propann/L-AZ-2/README.md

<div align="center">

AZ-2 — groovebox, tracker et Game Boy musicale

# AZ-2 · Build a song. Play a world.

**🌐 Documentation : [Français](docs/i18n/README.fr.md) · [English](docs/i18n/README.en.md) · [Español](docs/i18n/README.es.md)**

**Une groovebox DIY à deux cerveaux : tracker 8 pistes, six moteurs audio et Game Boy / Game Boy Color intégrée.**






[Découvrir la machine](#la-machine) · [Manuel d'utilisation](docs/AZ2_MANUEL_UTILISATEUR.md) · [Démarrer](#démarrer) · [Architecture](#deux-firmwares-un-seul-instrument) · [Game Boy & LSDJ](#game-boy--lsdj) · [Feuille de route](#feuille-de-route) · [Documentation](#documentation)

</div>

> **AZ-2 est un projet de construction et de recherche, pas un produit fini.** Les fonctions listées comme intégrées existent dans le code ; leur validation sur le matériel réel dépend des essais documentés. Les captures d'écran et visuels de concept ne sont pas des preuves de fonctionnalité.

## La machine

| 🎛️ Créer | 🎮 Jouer | 🎚️ Transformer |
| :-- | :-- | :-- |
| Tracker 8 pistes, patterns, song, swing, effets par pas, mute/solo | Émulation GB/GBC sur écran tactile avec croix et boutons physiques | Mixage via Teensy et DAC I²S, capture WAV du son du jeu, sampleur one-shot |
| Dexed FM · ePiano · Braids · Karplus · Analog · Sampler | Navigateur de ROM sur carte SD, sauvegarde cartouche | Six moteurs audio au choix par piste |

**Intention produit :** composer au tracker, jouer à la Game Boy et faire dialoguer le son chiptune avec les synthétiseurs de la machine. La capture WAV est présente et le dernier enregistrement Game Boy peut désormais être chargé en PSRAM comme patch dynamique **SAMPLER / GB Capture** ; la gestion d'une vraie bibliothèque multi-captures reste à développer.

## Deux firmwares, un seul instrument

```text
      CROIX / A B C D / ENCODEURS
                    │
                    ▼
   ┌──────────────────────────────┐       UART 921600       ┌──────────────────────────────┐
   │ TEENSY 4.1 · MASTER AUDIO    │◄──────────────────────►│ ESP32-S3 · ÉCRAN / GB       │
   │ Tracker, synthés, mixage     │   commandes + audio GB │ Écran tactile 480×480, SD    │
   │ Sampleur, MIDI, DAC I²S      │                        │ ROM GB/GBC, interface       │
   └───────────────┬──────────────┘                        └──────────────────────────────┘
                   ▼
             PCM5102A → AUDIO OUT
```

**Règle fondamentale : les deux firmwares sont liés par `lib/AZ2_Protocol/AZ2_Protocol.h`.** Modifier une commande, un débit, une longueur de paquet ou un format audio exige de vérifier les deux extrémités dans le même changement. Ne flashez pas un seul firmware après une modification incompatible du protocole.

L'AZ-2 actuelle conserve deux cartes, sans multiplexeur ni rack multi-ESP. Les cartouches de moteurs et modules supplémentaires sont réservés au projet AZ-3.

## Démarrer

**Prérequis :** matériel décrit dans le [guide de câblage](docs/AZ2_CABLAGE_MASTER.md), carte ESP32-S3 écran VIEWE UEDX48480040E-WB, Teensy 4.1, DAC PCM5102A, cartes SD adaptées, [Python](https://www.python.org/) et [PlatformIO](https://platformio.org/install).

```bash
git clone https://github.com/propann/L-AZ-2.git
cd L-AZ-2
python -m pip install platformio==6.1.19

# Compiler impérativement les DEUX firmwares avant de flasher :
pio run -e master_teensy -e screen_esp

# Tests natifs du protocole partagé :
pio test -e native

# Téléverser seulement lorsque le matériel/câblage a été vérifié :
pio run -e master_teensy -t upload
pio run -e screen_esp -t upload
```

Le matériel Teensy et l'écran ESP32 disposent de configurations de compilation distinctes dans `platformio.ini`. `ui_esp` est un environnement de bring-up historique, **pas** le firmware de l'écran final. Les ROM commerciales, les banques de samples et les sauvegardes personnelles ne sont pas incluses dans ce dépôt.

**Avant le premier flash :** lire le [guide d'installation et de sécurité](docs/AZ2_DEMARRAGE.md). Préserver vos fichiers `.sav`, projets et patches SD ; éviter une mise à jour partielle des deux firmwares.

## Game Boy & LSDJ

| Fonction | État |
| :-- | :-- |
| Cœur Walnut-CGB, chargement ROM depuis SD, commandes physiques | Intégré ; compatibilité à qualifier ROM par ROM |
| Rendu sans frame-skip par défaut, dual-fetch, télémétrie FPS/temps/missed | Intégré ; cadence réelle à relever sur la machine |
| Audio V2 séquencé + CRC + L/R PCM8 stéréo | Intégré derrière un pilote désactivé ; sortie Teensy encore downmixée sur le bus mono actuel |
| Sauvegarde SRAM périodique, SAVE NOW sur D, `.sav/.bak` et RTC MBC3 séparé | Intégré ; qualification coupure/RTC sur matériel encore nécessaire |
| Audio GB vers Teensy | Intégré, actuellement **mono 8 bits / 14 kHz** |
| Audio haute fidélité, APU horodatée et sortie DAC réellement stéréo | **Non livré** ; le transport V2 stéréo est présent mais désactivé par défaut |
| Capture GB → patch SAMPLER / GB Capture | **Intégré** (un slot dynamique PSRAM) ; qualification matérielle et bibliothèque multi-captures restantes |
| Synchronisation musicale LSDJ ↔ tracker | **Non livré** |

Pour le chantier en cours : [roadmap Game Boy / LSDJ détaillée](docs/AZ2_GB_ROADMAP_IMPLEMENTATION.md). Pour les limites de compatibilité : [audit émulation](docs/AZ2_AUDIT_EMULATION_LSDJ_TETRIS_MARIO.md). Pour comprendre pourquoi Walnut-CGB a été retenu : [étude des cœurs](docs/AZ2_ETUDE_COEURS_EMULATION_GB.md).

## Feuille de route

1. **Fiabilité :** sauvegardes résistantes aux coupures, erreurs visibles, chargement sûr et tests sur carte réelle.
2. **Cadence :** mesures et certification par ROM (Tetris, Mario, LSDJ) et sans sacrifice des synthés.
3. **Audio LSDJ :** APU précise, stéréo, pont UART V2 et contrôle des underruns.
4. **Studio :** ergonomie Console/LSDJ, capture WAV → sampleur, synchronisation musicale.
5. **Publication :** photos du prototype réel, schéma reproductible, démonstrations et matrice de compatibilité.

Les cases d'implémentation et les tests d'acceptation figurent dans la [roadmap opérationnelle](docs/AZ2_GB_ROADMAP_IMPLEMENTATION.md). Ne pas confondre « présent dans le code », « compile » et « testé sur l'AZ-2 ».

## Documentation

| Commencer par… | Pour… |
| :-- | :-- |
| [Guide en français](docs/i18n/README.fr.md) · [English guide](docs/i18n/README.en.md) · [Guía en español](docs/i18n/README.es.md) | Découvrir le projet, compiler les deux firmwares, comprendre les fonctions livrées et leurs limites |
| [Manuel d'utilisation](docs/AZ2_MANUEL_UTILISATEUR.md) | Jouer avec la machine : pages, contrôles, sauvegarde, premier beat |
| [Premier démarrage](docs/AZ2_DEMARRAGE.md) | Préparer les deux cartes, les SD et les compilations |
| [Architecture double firmware](docs/AZ2_ARCHITECTURE_FIRMWARE_DOUBLE.md) | Comprendre les responsabilités de chaque cerveau |
| [Câblage maître](docs/AZ2_CABLAGE_MASTER.md) | Relier commandes, Teensy, écran et DAC |
| [État des lieux](docs/AZ2_ETAT_DES_LIEUX.md) | Séparer observations matérielles et code théorique |
| [Travail livré / journal trilingue](docs/i18n/README.fr.md#travail-réalisé-et-traçabilité--19-septembre-2026) | RTC MBC3, transport V2 stéréo, capture → sampleur et preuve CI |
| [Audit racks / transition CONSOLE + CAPTURE](docs/AZ2_AUDIT_RACKS_CONSOLE_CAPTURE.md) | Mesurer les gains possibles, prioriser jeu + WAV et transitionner par étapes vérifiées |
| [Roadmap Game Boy](docs/AZ2_GB_ROADMAP_IMPLEMENTATION.md) | Suivre les étapes de stabilisation et LSDJ |
| [Validation GB/LSDJ](docs/AZ2_GB_VALIDATION.md) | Tester cadence, sauvegardes, jeux et capture sur le prototype |
| [Roadmap générale](docs/AZ2_FEUILLE_DE_ROUTE.md) | Tracker, moteurs, interface et produit |
| [Licences et composants tiers](docs/AZ2_LICENCES.md) | Vérifier provenance et obligations avant redistribution |

## Contribuer

Voir [CONTRIBUTING.md](CONTRIBUTING.md). Un bug reproductible, une capture de logs, un test de ROM libre ou une amélioration de documentation sont utiles. Indiquez le SHA Git, l'environnement `master_teensy` / `screen_esp`, le matériel et les étapes de reproduction. Évitez d'ajouter au dépôt des ROM commerciales ou des fichiers de sauvegarde personnels.

Code principal sous **GPL-3.0** ; plusieurs composants intégrés possèdent leurs propres licences. Voir [LICENSE](LICENSE) et [inventaire des licences](docs/AZ2_LICENCES.md).

---

<div align="center"><sub>AZ-2 — Fabriquer un instrument, pas seulement assembler des composants.</sub></div>
