propann/L-AZ-2/docs/AZ2_FEUILLE_DE_ROUTE_MOTEUR.md

# AZ-2 - Feuille de route moteur audio / mixeur / architecture (2026-09-13)

Contexte: pas de carte SD ni de sample reel dans les machines pour
l'instant -- priorite mise sur les VOIX synthetiques (plusieurs moteurs
connus et legers) plutot que sur le sampleur, qui attendra du vrai
stockage. Rappel utile a garder en tete: **les 3 firmwares (ESP32, Teensy,
Pico) forment UNE seule application** repartie sur 3 cartes -- une
decision cote protocole ou architecture engage generalement les 3, meme
quand une carte n'est pas branchee au moment ou on code.

**[Note 2026-09-17]** Le Pico a ete abandonne le 2026-09-14 (matrice/
mux LED jamais fonctionnels) -- l'application est desormais sur 2
cartes, pas 3. Une carte SD DEDIEE existe maintenant sur le Teensy
(sampler, capture phase 1 faite le 2026-09-17) -- le contexte "pas de
SD ni de sample" ci-dessus ne s'applique plus. Les moteurs
synthetiques listes plus bas restent la base actuelle (5 moteurs,
inchanges depuis).

## Moteurs retenus (deja vendored, verifies dans le repo)

Tous dans `src_teensy/microdexed-touch/third-party/` :

| Moteur | Lib | Style | API de declenchement |
| --- | --- | --- | --- |
| Dexed (FM, DX7-like) | `Synth_Dexed` | Note tenue, tres flexible (algorithmes FM) | `keydown(note, vel)` / `keyup(note)` |
| MDA ePiano | `Synth_MDA_EPiano` | Note tenue, timbre electro-piano celebre (heritage VST mda-epiano) | `noteOn(note, vel)` / `noteOff(note)` |
| Braids (Mutable Instruments) | `Synth_Braids` | Oscillateur "macro" continu, pas de note tenue -- on le "frappe" (`Strike()` interne) a chaque nouvelle hauteur, tres celebre en modulaire/eurorack, leger CPU | `set_braids_pitch(pitch)` (frappe a chaque appel) + `set_braids_shape()`/`timbre()`/`color()` pour la forme d'onde |

Ces trois couvrent des styles tres differents (FM riche, piano electrique,
oscillateur synthese complexe/percussif) pour un minimum de code -- bon
rapport diversite sonore / effort.

## Architecture cible

```mermaid
flowchart LR
    T0[Piste 0: Dexed] --> MIX[Mixeur pistes]
    T1[Piste 1: Dexed] --> MIX
    T2[Piste 2: EPiano] --> MIX
    T3[Piste 3: Braids] --> MIX
    LIVE[Voix live: Dexed] --> FINAL[Mixeur final]
    MIX --> FINAL
    FINAL --> DAC[PCM5102A]
```

Decision v0 (simple, pas de switch dynamique de moteur pour l'instant) :
**un moteur fixe par piste**, pas un choix dynamique par l'utilisateur --
ca viendra dans une v1 une fois l'architecture de base solide et testee.

| Piste | Moteur | Role |
| --- | --- | --- |
| 0 | Dexed | FM riche, basses/leads |
| 1 | Dexed | FM riche, deuxieme voix |
| 2 | EPiano | Timbre electro-piano |
| 3 | Braids | Percussif/texture, oscillateur complexe |
| Live (pads/ecran) | Dexed | Jeu au clavier, independant des pistes |

Braids n'a pas de "note off" naturel (oscillateur continu) : on coupe son
canal du mixeur pour simuler un relachement -- character plus percussif/
abrupt, coherent avec son usage typique.

## Ce qui reste a batir (dans l'ordre)

1. **[FAIT]** Multi-moteur fixe par piste (tableau ci-dessus), mixeur a
   2 etages (pistes -> final), toujours pilotable par `PAD:`/`STEP:`/`PLAY`/
   `STOP` existants.
2. **[FAIT]** Grille de sequenceur a l'ecran ESP32 (tactile, 4 pistes x 16
   pas), curseur de lecture synchronise sur `CLOCK:`.
2bis. **[FAIT, 2026-09-14]** "Vrai" sequenceur temps reel, suite a la
   demande explicite ("on est pas assez precis ... il faut les divisions
   le tempo") :
   - Horloge du sequenceur sur `IntervalTimer` materiel (comme
     `PeriodicTimer` dans MicroDexed-touch) au lieu d'un `millis()` scrute
     dans `loop()` -- teste reellement a 180 BPM : 83,33ms attendus, 83,1-
     83,8ms mesures (jitter residuel du cote mesure serie/Python, pas du
     timer). Plus de "temps mort" du a ce que fait `loop()` par ailleurs.
   - Scan clavier du Pico separe en 2 passes (boutons d'abord, LED
     ensuite) -- un appui n'est plus jamais retarde par le rafraichissement
     LED d'une colonne precedente (voir `src_pico/main.cpp`).
   - Division du pas reglable (`DIV:`, table `az2::kDivisionOptions` dans
     AZ2_Protocol.h : 1/4, 1/8, 1/8T, 1/16 par defaut, 1/16T, 1/32) et
     tempo (`BPM:`) exposes sur la page SEQUENCEUR de l'ecran (boutons
     -/+ et bascule de division), plus reglables en aveugle via serie
     seulement.
2ter. **[FAIT, 2026-09-14]** Choix de moteur PAR piste + patchs reels,
   suite a la demande explicite ("les moteurs audio ne sont pas
   selectionnables ni reglables ... sans patch ca va pas, faut faire un
   truc propre") -- avance depuis l'etape 5 initialement prevue plus tard :
   - Chaque piste a ses instances de moteur (a l'origine
     Dexed/EPiano/Braids, **5 moteurs depuis le 2026-09-15**, voir plus
     bas) toujours creees, une seule branchee au mixeur a la fois via
     `AudioConnection::connect()`/`disconnect()` (API officielle de patch
     runtime de la lib Audio) -- un moteur non selectionne ne consomme
     AUCUN CPU (la lib ne fait tourner `update()` que sur les objets
     "actifs", voir commentaire dans `src_teensy/az2_audio/main.cpp`).
   - Patchs reels par moteur (pas juste un `loadInitVoice()` vide) :
     8 voix DX7 nommees extraites de la banque vendored Synth_Dexed
     (FM-Rhodes, Steinway, Korg CX3, Leadharp, FatSynth A, Jupiter 8,
     Mini-Moog, Moog Strings), 5 programmes mda ePiano (Default, Bright,
     Mellow, Autopan, Tremolo), 8 formes Braids (CSAW, Saw/Square, Triple
     Saw, Toy, Vosim, FM, Plucked, Saw Swarm).
   - **[FAIT, 2026-09-15]** 2 moteurs de plus, suite a "on voit si on
     peut ajouter des moteurs audio si oui lesquels" : **KARPLUS**
     (`AudioSynthKarplusStrong`, corde pincee physique, 1 seul patch --
     l'objet n'expose aucun parametre de forme) et **ANALOG**
     (`AudioSynthWaveform` + `AudioEffectEnvelope` chaines en
     permanence, patch = forme d'onde : Sinus/Dent de scie/Carre/
     Triangle). Les deux sont des objets STANDARD de la lib Audio
     Teensy, zero vendoring supplementaire. CPU mesure apres ajout :
     toujours ~8% de pic (voir "performance reelle" plus bas), tres
     large marge pour en ajouter encore si besoin.
   - Protocole `ENGINE:piste:moteur` / `PATCH:piste:patch`, table de noms
     partagee ESP32/Teensy/Pico dans AZ2_Protocol.h (`kEngineNames`,
     `k*PatchNames`, `enginePatchCount()`/`enginePatchName()`) -- l'index
     doit rester aligne avec les tableaux de donnees reelles cote Teensy.
   - Nouvelle page ecran "MOTEURS" (une ligne par piste, toucher la
     moitie gauche = cycle moteur, moitie droite = cycle patch).
   - `announceHello()` renvoie tout l'etat courant (bpm, division, moteur+
     patch par piste) a chaque connexion/reconnexion ESP32/Pico, pour que
     l'ecran ne reaffiche jamais des valeurs par defaut fausses.
3. Intro plus vivante (glitch, pixel-art anime) + esprit "logiciel vivant"
   sur les autres pages.
4. Mixeur "vrai" : niveau + pan par piste, exposes au protocole
   (`MIXER:track=N:vol=X` par exemple) et a une page ecran dediee.
5. Edition de note par pas (chaque pas du sequenceur a sa propre note, pas
   une seule note fixe par piste comme actuellement) -- necessaire pour
   de vraies melodies/basslines, pas juste des accords tenus.
6. Sampleur reel, une fois une carte SD presente sur le Teensy (voir
   AZ2_PORTAGE_MICRODEXED_TOUCH.md) -- PSRAM deja confirmee (16 Mo,
   lecture/ecriture OK, teste le 2026-09-13), donc le stockage temporaire
   de samples est pret techniquement des que des fichiers audio existent.
7. Mode JEUX -- **implemente le 2026-09-15** (voir
   [AZ2_EMULATION_JEUX.md](AZ2_EMULATION_JEUX.md) pour le detail : coeur
   vendore, callbacks/rendu/entrees ecrits, compile et flashe sans
   crash -- pas encore joue en reel faute de ROM legale sur une carte
   SD). Decision revue le 2026-09-14 (voir
   [AZ2_EMULATION_JEUX.md](AZ2_EMULATION_JEUX.md)) : Retro-Go (vendored
   dans `src_esp32/retro-go-master`) etudie et ECARTE pour la v0, car
   ESP-IDF natif + ecrans SPI seulement -- incompatible avec notre
   ecran RGB parallele sans double demarrage OTA + pilote ecran a
   ecrire. Cible precisee dans la foulee ("GB/GBA/GBC, ca suffira") :
   moteur retenu **Walnut-CGB** (GB + GBC, callbacks purs style
   Peanut-GB, licence MIT, deja demontre sur ESP32-S3) comme une PAGE de
   plus dans `az2_screen`, pas un double demarrage -- `lcd_draw_line()`
   branche directement sur notre Arduino_GFX. GBA ecarte du v0 (~20fps
   mesures sur ESP32-S3, pas fluide). ROM testable depuis la flash
   interne au debut (pas besoin de carte SD pour un premier essai), la
   carte SD reste utile ensuite pour une vraie ludotheque (etape
   suivante).
8. SD sur l'ESP32 (ecran) : ROMs de jeux (format a definir), utile pour
   le mode JEUX (etape 7) une fois la carte presente.
9. ~~Pico transforme en joystick/manette~~ -- **obsolete, Pico abandonne
   le 2026-09-15** (voir AZ2_CABLAGE_PICO.md). Remplace : la croix + 4
   boutons cables directement sur le Teensy (etape "control" ci-dessous)
   servent deja a la fois de navigation et de manette de jeu, voir
   [AZ2_TODO_PICO.md](AZ2_TODO_PICO.md) (page de cloture).
10. Croix + 4 boutons + 3 potentiometres cables directement sur le
    Teensy (`NAV:`/`BTN:`/`POT:`, voir AZ2_CABLAGE_MASTER.md) --
    remplace le Pico. Potards 1-3 deja branches sur le bus d'effets
    maitre (volume/reverb/delay), firmware pret, cablage physique en
    cours.

## Impact protocole (a suivre au fur et a mesure)

`DIV:`, `ENGINE:track:moteur` et `PATCH:track:patch` ajoutes le
2026-09-14 (voir etapes 2bis/2ter ci-dessus) -- `BPM:` desormais relaye
(avant : accepte mais jamais confirme a l'UI). Prevoir plus tard :
`MIXER:`, et des messages lies au mode jeux (a definir quand on y
arrivera).
