propann/L-AZ-2/docs/AZ2_ETAT_DES_LIEUX.md

# AZ-2 - Etat des lieux

**[2026-09-19 -- bibliotheque de samples rangee sur la SD du Teensy +
pads jouent l'instrument de la piste + kit de batterie de depart sur
les pads + sauvegarde des pads dans le projet -- teste sur le vrai
materiel]**

Grosse suite de demandes enchainees le meme soir, une fois la carte SD
du Teensy branchee sur l'ordinateur avec la carte SD de l'ESP32 :

- **Bibliotheque de samples rangee** : demande "on met des dossiers
  cool ... on garde les ensembles de percussion snare kick tout ca les
  basses les voix les synths on met de cote les boucles". Collection
  "Azothwave KO II" (2 archives Google Drive, 2,3 Go) deja parfaitement
  organisee EXACTEMENT selon la demande (BASS/CYMBALS/KICKS/LOOPS/PERC/
  SFX/SNARES/SYNTHS/VOIX) -- extraite et fusionnee dans `/samples` sur
  la SD du Teensy (14 819 fichiers, 2,5 Go). Le pack "OP-1" propose en
  parallele s'est revele etre autre chose (plus de la moitie de ses
  2857 fichiers = un environnement Python zippe par erreur, plus un
  dossier FIRMWARE = des firmwares du device OP-1, pas des samples) et
  organise par GENRE musical plutot que par instrument -- laisse de
  cote sur decision utilisateur explicite ("les son op1 on s'en occupe
  pas").
- **"joue l'instrument de la piste"** : les pads (page AUDIO) jouaient
  jusqu'ici TOUJOURS une voix Dexed fixe separee (`liveVoice`), meme
  ouverts depuis le bouton CLAVIER du tracker. Nouveau champ optionnel
  `track=` sur la commande `PAD:` -- quand present, le Teensy route
  vers `trackNoteOn()/trackNoteOff()` (le VRAI moteur/patch de la
  piste, meme chemin que le sequenceur) au lieu de `liveVoice`. Le
  bouton CLAVIER du tracker fixe desormais `padTargetTrack =
  selectedSeqTrack` avant d'ouvrir la page ; AUDIO ouverte depuis le
  menu general repart sur le comportement generique (`padTargetTrack =
  -1`, corrige au passage une petite fuite d'etat preexistante ou
  `padEditsStep` restait colle d'une visite CLAVIER precedente). Poser
  une note en mode "pose sur le pas" (padEditsStep) fait maintenant
  AUSSI entendre le son en direct (avant : totalement silencieux, on
  n'entendait jamais ce qu'on venait de programmer).
- **Kit de batterie configure sur les pads** : nouveau sampleur DEDIE
  aux 16 pads, INDEPENDANT des 6 moteurs normaux -- 16x
  `AudioPlaySampler` + 16 buffers PSRAM plafonnes a 2s/48kHz (~3 Mo,
  verifie sur les 16 Mo de PSRAM reellement detectes, `PSRAM?` sur le
  vrai materiel). Mixage a etages (4 groupes de 4 pads -> 1 bus pads ->
  combine avec liveVoice -> mixFinal canal 2, qui etait deja plein a
  4/4) -- meme principe que les groupes de pistes. Nouvelle commande
  `PADSAMPLE:<pad 0-15>:<chemin>`, priorite absolue sur un pad
  (ignore track=/liveVoice si un echantillon y est charge -- un hit de
  kit ne se transpose pas). 8 sons choisis dans la bibliotheque
  fraichement rangee (kick/snare/hat ferme/hat ouvert/clap/rim/
  cowbell/ride), charges automatiquement au boot du Teensy.
- **2 bugs reels trouves et corriges en testant** :
  1. Parseur WAV a en-tete fixe (44 octets, ecrit pour les captures GB
     "propres") -- la bibliotheque Azothwave, exportee via ffmpeg/
     libav, insere un chunk LIST/INFO entre "fmt " et "data" : tous
     les fichiers etaient rejetes en `WAV_UNSUPPORTED` alors que
     parfaitement valides. Corrige en parcourant les chunks RIFF un
     par un (fmt/data dans n'importe quel ordre, chunks inconnus
     sautes) au lieu de supposer un en-tete fixe -- partage desormais
     entre la capture GB et les samples de pad (`readWavPcm16Mono()`).
  2. `loadDefaultDrumKit()` (le kit de depart) place AVANT
     `setupSampleSd()` dans `setup()` -- la carte SD du Teensy n'etait
     pas encore initialisee, chaque `SD.exists()` echouait
     silencieusement, aucun pad ne chargeait rien au boot. Deplace
     apres `setupSampleSd()`.
  3. (evite avant de flasher, pas un bug materiel) : `setSample()`
     appele sans le sampleRate REEL du fichier (24kHz pour toute la
     bibliotheque Azothwave, pas les 44.1kHz par defaut) -- aurait
     fait jouer chaque hit ~1.84x trop vite/trop aigu.
- **"pouvoir aussi les sauvegarder dans le projet global"** : nouvel
  etat ESP32 `padSamplePath[16]`, tenu a jour par l'echo
  `PADSAMPLE:<pad>:READY:path=...` (capture aussi bien une assignation
  manuelle que le kit de depart charge au boot du Teensy) --
  `saveProject()`/`loadProject()` ecrivent/relisent une ligne
  `PADSAMPLE:<pad>:<chemin>` par pad assigne. Verifie le mecanisme
  bout en bout (Teensy -> echo -> ESP32) via serie direct ; le
  declenchement tactile SAUVER/CHARGER lui-meme (page PROJET, pas de
  chemin croix equivalent) reste a confirmer au doigt.

Compile propre (`screen_esp`, `master_teensy`, `native`), 14 tests
natifs au vert. Valide sur le vrai materiel : kit de depart charge au
boot (8x `PADSAMPLE:...READY`), CPU/memoire stables en jouant les 8
pads d'affilee (5.9%->6.6%, pic 8.6%, blocs memoire inchanges).

**[2026-09-19 -- nouveau manuel d'utilisation (docs/AZ2_MANUEL_UTILISATEUR.md)]**

Demande : "il faut travailler sur la doc plus complete on a pas grand
chose". Etat des lieux avant d'ecrire quoi que ce soit : plus de 30
fichiers dans `docs/`, mais TOUS orientes ingenierie (audits, cablage,
roadmap, licences) ou journal brut de session (`AZ2_ETAT_DES_LIEUX.md`,
100+ Ko) -- AUCUN document explique comment UTILISER la machine une
fois construite. Meme `AZ2_DEMARRAGE.md` ("Premier demarrage") est en
realite une procedure de flash/dev (git clone, pio, checklist de
securite), pas un guide utilisateur.

Nouveau `docs/AZ2_MANUEL_UTILISATEUR.md` -- guide "comment jouer avec
la machine", langage musicien plutot qu'informatique (coherent avec
"c'est plus musicien" plus haut ce soir) : conventions de controle
generales (C=retour, tap=selectionne, A+croix=edite), les 3 encodeurs
(0=volume fixe, 1/2=contextuels avec leur code couleur), chaque page
en detail (SEQUENCEUR/MOTEURS/PATCH/MIXER/SONG/AUDIO/JEUX/annexes),
tableau des 6 moteurs et leurs patchs, sauvegarde patch-vs-projet, et
un parcours pas-a-pas "premier beat". Ajoute au README (lien en tete
de la doc-table ET dans la barre de navigation du haut) -- premiere
chose qu'un utilisateur (pas un contributeur) devrait lire.

**[2026-09-19 -- fusion avec le travail GB (autre session IA) + boutons
MUTE/SOLO tactiles sur MIXER + audit navigation "retour" (rien trouve
de casse)]**

- **Fusion `origin/main`** : une autre session IA travaillait en
  parallele sur l'emulation Game Boy (confirme par l'utilisateur : "il
  y a gpt qui bosse sur la partie emulation") -- 56 commits pousses
  directement sur `main` pendant que ce chantier tournait, touchant
  entre autres `lib/AZ2_Protocol/AZ2_Protocol.h` (+174 lignes, nouveau
  protocole audio GB V2) ET les 2 memes `main.cpp` (Teensy/ESP32) que
  ce chantier modifiait activement. Fusionne sur la branche de
  fonctionnalite (`git merge origin/main`, pas de conflit textuel) puis
  RE-VERIFIE integralement avant de faire confiance au resultat :
  compile propre sur les 3 environnements, 14 tests natifs au vert (9
  d'avant + 5 nouveaux tests GB audio V2), et re-teste sur le vrai
  materiel (MIXER, mute/solo, encodeurs) apres reflashage des 2
  cartes -- rien de casse par la fusion.
- **"il faut que les 2 controles soit[ent] boutons tactil[es]"**
  (mute/solo de la page MIXER, jusqu'ici seulement B/D physiques) :
  2 boutons tactiles ajoutes sous les barres. Logique factorisee dans
  `toggleMixerMuteSolo(bool mute)`, appelee aussi bien par B/D que par
  ces 2 nouveaux boutons -- plus de duplication entre les 2 chemins.
- **"verifie toute les navigations qu'on saute pas des fenetres dans
  les retours"** : audit complet du systeme `navPrevious`/`goTo()`.
  `currentScreen` n'est JAMAIS assigne ailleurs que dans `goTo()` (un
  seul point de mutation, verifie par recherche exhaustive) --
  `navPrevious` est donc toujours mis a jour avant tout changement
  d'ecran, aucun chemin ne peut le contourner. Verifie aussi qu'aucun
  gestionnaire n'appelle `goTo()` deux fois de suite dans le meme
  evenement (ce qui aurait enregistre un ecran "intermediaire" jamais
  vraiment vu comme `navPrevious`, faisant sauter une etape au retour)
  -- tous les appels a `goTo()` vivent dans des branches if/else-if
  mutuellement exclusives. **Rien trouve de casse** : le seul bug de
  cette famille cette soiree etait le mute MIXER sur le bouton A (deja
  trouve+corrige, voir l'entree precedente) -- categorie differente
  (un gestionnaire qui reagit a tort a l'evenement qui vient de faire
  `goTo()` VERS son propre ecran), pas un saut de fenetre au retour.

Compile propre (`screen_esp`, `master_teensy`, `native`), 14 tests
natifs au vert. Valide sur le vrai materiel via SIMNAV:/SIMBTN: apres
la fusion.

**[2026-09-19 -- page MIXER (nouvelle) + encodeurs 1/2 CONTEXTUELS +
pistes affichees 1-8 + bouton SAUVER dans le tracker -- teste sur le
vrai materiel]**

Suite de plusieurs retours enchaines le meme soir :

- **"le mixeur doit gerer le volume de toutes les voix"** : nouvelle
  page MIXER (`Screen::Mixer`, ajoutee au menu categorie Musique) -- 8
  barres verticales façon table de mixage, une par piste, hauteur
  proportionnelle a `trackVolume[]`. GAUCHE/DROITE choisit la piste,
  HAUT/BAS regle DIRECTEMENT son volume (pas besoin de maintenir A --
  metaphore fader). B = mute, D = solo (indicateur M/S sous la barre
  selectionnee). Reutilise entierement l'etat deja partage
  (`trackVolume[]`/`trackMuted[]`/`trackSoloed[]`), aucun nouveau
  protocole cote Teensy.
- **"on va [aux encodeurs 1/2] attribuer une couleur et les inclure a
  chaque fois dans l'application ... on les utilise pas assez"** :
  jusqu'ici l'encodeur 1 pilotait TOUJOURS le reverb wet global et
  l'encodeur 2 le delay wet global, cote Teensy, sans aucune
  conscience de l'ecran affiche. Bascule : l'encodeur 0 (VOLUME) reste
  CABLE DIRECT (role fixe, "le volume il bouge pas"), les encodeurs
  1/2 n'appliquent plus rien eux-memes cote Teensy -- ils envoient
  juste leur `POT:` brut (0-127, position ABSOLUE accumulee, pas un
  delta), et c'est desormais l'ESP32 qui decide quoi en faire selon
  `currentScreen` (et l'etat local de la page, ex. `selectedPatchRow`)
  puis renvoie la commande correspondante (VOL:/FILT:/FX:/...).
  Indicateur visuel ajoute (`drawEncoderHint()`) : 2 couleurs FIXES
  (orange = encodeur 1, cyan = encodeur 2) affichees en haut a droite
  de l'en-tete avec un libelle qui change selon la page/le parametre
  au focus -- "--" grise quand l'encodeur n'a rien a faire sur l'ecran
  courant. Cable pour l'instant sur 2 pages : MIXER (encodeur 1 =
  piste, encodeur 2 = volume) et PATCH (encodeur 1 = valeur GAUCHE de
  la ligne visuelle selectionnee, encodeur 2 = valeur DROITE -- acces
  direct aux 2 reglages d'une meme ligne sans avoir a les
  selectionner un par un a la croix). Pas de "soft takeover" en v1
  (reaffecter un encodeur a un nouveau parametre peut faire "sauter"
  sa valeur au premier mouvement) -- simplicite assumee, comme pour
  les effets par piste plus haut.
- **Bug reel trouve+corrige en testant** : le mute de la page MIXER
  etait d'abord sur le bouton A -- exactement le bouton "confirmer" du
  menu qui vient de faire `goTo(Screen::Mixer)` DANS LE MEME appui
  (`currentScreen` change avant que le bloc mute/solo ne s'execute,
  plus bas dans la meme fonction) : entrer sur la page mettait
  aussitot la piste 0 en mute par accident. Deplace sur B (libre sur
  cette page). A noter pour la suite : cette classe de bug (un
  gestionnaire ecran-specifique qui reagit a tort a l'evenement qui
  vient de faire `goTo()` VERS cet ecran) peut exister ailleurs, pas
  audite systematiquement.
- **"les pistes c'est mieux de les numeroter de 1 a 8 ... plus
  musicien, la c'est trop informatique"** : tous les affichages de
  numero de piste (page PATCH/MOTEURS/SEQUENCEUR/MIXER, indication
  AUDIO "pose sur piste X") montrent desormais piste+1 -- UNIQUEMENT a
  l'affichage, le protocole/les tableaux internes restent 0-7 comme
  avant (aucun risque de casser un fichier projet/patch existant).
- **"dans le tracker il manque le bouton sauvegarder"** : 6e bouton du
  panneau lateral du tracker, "SAUVER" -- sauvegarde tout le morceau
  (`saveProject()`, meme fonction que la page PROJET) dans
  l'emplacement PROJET actuellement choisi, sans quitter le tracker.
  Pas teste (tactile uniquement, pas simulable comme la croix/les
  boutons -- meme fonction eprouvee que le bouton SAVE de la page
  PROJET, donc faible risque).
- **Nouvelle commande de test `SIMPOT:<0-2>:<0-127>`** (Teensy, meme
  esprit que SIMNAV:/SIMBTN:) -- injecte un `POT:` directement sur
  Serial1, seul moyen d'automatiser un test d'encodeur (aucun
  encodeur physique pilotable depuis un script).

Compile propre (`screen_esp`, `master_teensy`, `native`), 9 tests
natifs au vert. Valide sur le vrai materiel via SIMNAV:/SIMBTN:/
SIMPOT: : navigation MIXER, mute/solo (bug A/B trouve et corrige en
testant), encodeur 1 -> `POT:1:100` -> piste choisie, encodeur 2 ->
`POT:2:50` -> `VOL:6:50` envoye correctement pour la piste choisie
par l'encodeur 1 juste avant.

**[2026-09-19 -- effets DEDIES par piste (bitcrusher + delay courte) --
reverb/delay COMPLETEMENT independantes par piste abandonne (teste : ne
rentre pas en RAM), 12/16 pistes abandonne aussi (garde 8) -- teste sur
le vrai materiel, pire cas y compris]**

Demande initiale : "si sampleur actif et qu'on peut avoir une chaine
d'effet independante sur chaque piste" + "si on est bien cote puissance
de calcul on peut monter a 12 ou 16 piste". Verifie AVANT de coder quoi
que ce soit (methode de ce soir : mesurer, pas supposer) :

- **12/16 pistes + reverb/delay COMPLETEMENT dediees par piste : ne
  rentre PAS en memoire.** Teste directement sur le materiel : 12x
  `AudioEffectFreeverb` seul (chacun ~25 Ko de buffers fixes en RAM1/
  DTCM) depasse deja la RAM1 disponible (~81 Ko libres) des le link.
  12x `AudioEffectDelay` seul passe de justesse (81 Ko -> 14 Ko libres,
  bien trop juste pour etre fiable). Utilisateur, une fois ces chiffres
  presentes : "on garde 8 piste mais on blinde d'effet[s] propre[s]
  plus simple[s] ... c'etait juste une idee" -- 12/16 pistes abandonne,
  reste a 8 (`kTrackCount`/`kSeqTrackCount` inchanges).
- **2 effets simples et VRAIMENT dedies par piste a la place** (pas un
  bus partage) : bitcrusher (reduction de bits, cout memoire quasi nul)
  et delay courte a une seule repetition (pas de feedback, "plus
  simple"). Chaine : `trackFilter -> trackCrush -> {sec, trackDelay} ->
  trackFx (mixeur sec/mouille par piste) -> mixeur de groupe` (remplace
  l'ancienne connexion directe filtre -> groupe). Nouvelles commandes
  Teensy `CRUSH:<piste>:<bits 1-16>` et `DELAY:<piste>:<ms 0-500>:
  <mix 0-127>`. Reverb reste UNIQUEMENT sur le bus maitre partage
  (inchangee, trop chere en RAM pour etre dediee).
- **Bug reel trouve et corrige pendant les tests** : `AudioMemory(200)`
  (le pool de blocs partage par TOUS les `AudioEffectDelay`,
  proportionnellement au temps de delay configure) etait bien trop
  juste des l'ajout du delay par piste -- UNE SEULE piste a 300ms
  faisait deja grimper le pool a 197/200. Augmente a
  `AudioMemory(700)` (nouvelle constante nommee `kAudioMemoryBlocks`,
  ~175 Ko en RAM2 sur les ~454 Ko libres, large marge conservee) --
  re-teste au PIRE cas possible (8 pistes, delay 500ms + mix 127 +
  bitcrusher 4 bits SUR TOUTES, toutes en train de jouer en meme
  temps) : 694/700 blocs, CPU 8.9% (pic 10.4%) -- tient, marge fine
  mais reelle. Au passage : le tracer d'onde (SCOPE:) pointait sur
  `trackFilter[]` (avant les nouveaux effets) -- deplace sur `trackFx[]`
  pour montrer ce qui est reellement entendu. Petit bug cosmetique
  corrige aussi : `MEM?` affichait un `/200` fige au lieu de la vraie
  taille du pool (nouvelle constante `kAudioMemoryBlocks` utilisee aux
  deux endroits).
- **Pas encore fait** : aucune interface ecran pour CRUSH:/DELAY: (page
  PATCH) -- pour l'instant reglable seulement en serie direct, comme
  DXR/EXP/BXP l'etaient avant leur propre chantier UI.

Compile propre (`master_teensy`, `native`), 9 tests natifs au vert.

**[2026-09-19 -- page PATCH : A+GAUCHE/DROITE edite la valeur, en plus
de A+HAUT/BAS -- teste sur le vrai materiel]**

Demande immediate suite au chantier de navigation ci-dessous : "on
devrait pouvoir changer les valeurs avec droite gauche ... en
maintenant A et en pressant droite gauche pour changer les valeurs du
patch". La logique d'edition (VOLUME/SLOT/ligne fixe-ou-DXP/ligne
EXTRA) est sortie du gestionnaire de croix vers une fonction dediee
`patchApplyDelta(track, delta)`, appelee desormais aussi bien par A+
HAUT/BAS (HAUT=+1) que par A+GAUCHE/DROITE (DROITE=+1) -- simple choix
de confort, les 2 sens de croix marchent pour editer. La ligne SLOT
garde son cas particulier (A+GAUCHE/DROITE = SAVE/LOAD, verifie avant
le cas general). GAUCHE/DROITE SEUL (sans A) continue de juste
selectionner, inchange.

**Valide sur le vrai materiel** (SIMNAV:/SIMBTN:) : A+DROITE sur
CUTOFF envoie `FILT:0:127:0`, A+GAUCHE juste apres envoie
`FILT:0:126:0` (bien decremente) ; DROITE seul (sans A) juste apres ne
declenche aucune commande (selection seule, comme prevu).

**[2026-09-19 -- page PATCH : 2 reglages par ligne + navigation
repensee (GAUCHE/DROITE choisit le reglage, PISTE sur sa propre
ligne) -- teste sur le vrai materiel]**

Suite immediate du chantier "barre TEENSY retiree + bouton B" plus
haut (meme soiree) -- 2 retours utilisateur enchaines :

- **"mettre 2 reglage par ligne pour gagner de la place"** : tous les
  parametres "simples" de la page (CUTOFF/RESONANCE/ALGO-ou-ATTACK/
  FEEDBACK-ou-DECAY/SUSTAIN/RELEASE, les lignes EXTRA par moteur DXR/
  EXP/BXP, et desormais VOLUME aussi) partagent leur ligne 2 par 2
  (colonne gauche/droite) au lieu d'une ligne pleine largeur chacun.
  Seule la ligne SLOT (3 sous-boutons SLOT/SAVE/LOAD, deja dense)
  reste seule sur sa ligne. Plus de boutons tactiles +/- (pas la place
  en demi-largeur) -- l'edition passe entierement a la croix (A
  maintenu + HAUT/BAS, deja le reflexe utilise partout ailleurs ce
  soir), le tactile ne fait plus que SELECTIONNER une case.
- **Interrompu en cours de route par** : "la droite gauche change les
  piste il faut que ce change les reglage selectionner dans la fenetre
  des patch" -- GAUCHE/DROITE servait encore a changer de piste,
  incompatible avec "choisir entre les 2 reglages d'une ligne". Meme
  refonte que la page MOTEURS plus tot dans la soiree
  (`engOnTrackRow`) : nouvel etat `patchOnTrackRow`, ligne PISTE
  desormais separee (contour blanc quand elle a le focus croix) --
  GAUCHE/DROITE n'y change la piste QUE sur cette ligne, atteinte en
  montant (HAUT) depuis la toute premiere ligne de la grille. Dans la
  grille : GAUCHE/DROITE parcourt l'ordre logique des parametres
  (`patchStepLogical()`, saute les lignes DEXED 4-5 desactivees comme
  avant), HAUT/BAS monte/descend d'une ligne VISUELLE en gardant la
  colonne quand elle existe (`patchStepVisual()`). Ligne SLOT : A
  maintenu + GAUCHE/DROITE reste SAVE/LOAD, seule ligne ou GAUCHE/
  DROITE garde un role hors navigation.
- **Bug latent trouve en reprenant ce chantier (pas encore flashe,
  trouve a la lecture)** : les 3 `hitTest*()` tactiles de la ligne SLOT
  (numero/SAVE/LOAD) utilisaient encore une position Y figee au moment
  de la compilation, calculee pour l'ancienne mise en page (1 ligne =
  1 reglage). Avec l'appariement 2-par-ligne, la ligne SLOT ne tombe
  plus forcement a la meme position ecran (ex. KARPLUS/ANALOG, 0 ligne
  extra : 4 lignes visuelles plus haut qu'avant) -- le tactile visait
  donc a cote sans jamais planter, juste "ca ne fait rien". Corrige en
  recalculant la position via `patchRowVisible()` a chaque appel,
  comme `drawPatchSlotRow()` le fait deja.

**Valide sur le vrai materiel** (SIMNAV:/SIMBTN:, meme methode que
tout le reste de la soiree) : GAUCHE/DROITE dans la grille ne change
plus de piste (aucun `SCOPE:` envoye) ; HAUT depuis la 1ere ligne
bascule sur la ligne PISTE (aucune commande parasite) ; GAUCHE/DROITE
sur la ligne PISTE change bien la piste (`SCOPE:7` observe) et
reinitialise la selection ; A+HAUT/BAS edite bien la bonne ligne
(`FILT:`/`ENV:` observes selon la ligne selectionnee, valeurs
coherentes avec les pas RIGHT/LEFT effectues avant) ; ligne SLOT
atteinte en pur DOWN (jamais depassee), A+DROITE sauvegarde
(`PATCH_SAVED:/patches/0.txt`), A+GAUCHE recharge et reapplique tout
(`ENGINE:`/`PATCH:`/`FILT:`/`ENV:`/`DXP:` + `PATCH_LOADED:`).
Compile propre (`screen_esp`, `master_teensy`, `native`), 9 tests
natifs toujours au vert.

**[2026-09-19 -- page MOTEURS : A ouvre PATCH + surbrillance plus
visible ; page PATCH : barre TEENSY retiree + bouton B pour entendre
les reglages en direct -- teste sur le vrai materiel]**

3 retours utilisateur enchaines :

- **Page MOTEURS, A ouvre la page PATCH** : "si on en selectionne un
  [patch] il faut que quand on presse A ca envoie aux reglages du
  patch". Ajoute (uniquement quand le focus croix est sur la liste
  PATCH, pas MOTEUR ni la ligne PISTE) -- meme action que toucher le
  bandeau mini-reglages.
- **Surbrillance plus visible** : le contour blanc de la ligne au
  focus passe de 1px a 3px (3 rectangles imbriques, GFX Library n'a
  pas de parametre d'epaisseur de trait). Ajoute en plus un cadre
  epais (3px) autour de TOUTE la liste (moteur OU patch) qui a le
  focus croix, dessine par-dessus les lignes -- vue d'ensemble
  immediate de "quel cote" en plus du detail "quelle ligne".
- **Page PATCH** : 3 choses --
  1. Barre TEENSY (vert, en bas) retiree de cette page aussi (meme
     raisonnement que la page SEQUENCEUR plus haut ce soir) : "elle
     nous empeche de voir les dernieres lignes".
  2. Bouton B joue/coupe une note de test (MIDI 60 fixe) DIRECTEMENT
     sur la piste affichee, hors sequenceur : "il faut utiliser le
     bouton B pour jouer une note qu'on entende les modifications" --
     nouvelle commande Teensy `TEST:<piste>:<note>:<0|1>`, appelle
     directement trackNoteOn()/trackNoteOff() (memes fonctions que le
     sequenceur), fonctionne que PLAY tourne ou non. Relachement B
     jamais filtre par ecran (meme garde-fou que FILL: sur D) pour ne
     pas laisser une note bloquee "on" si on change de page en gardant
     B enfonce.
  3. Le rectangle du tracer d'onde etait vide -- pas un bug distinct,
     juste qu'il n'y avait aucun moyen de declencher une note pour le
     voir bouger avant le bouton B ci-dessus (le systeme SCOPE:
     lui-meme, fixe hier soir, n'a pas ete retouche).

**Valide sur le vrai materiel** : `TEST:0:60:1` puis `TEST:0:60:0`
confirmes envoyes correctement au relachement de B (via SIMNAV:/
SIMBTN:), note entendue par l'utilisateur pendant les 2s de maintien
("c'est top"). Retour mineur note : un leger "saut d'ecran" pendant le
test -- pas bloquant, a surveiller mais pas encore diagnostique (peut-
etre le redessin du reste de la page suite au retrait de la barre
TEENSY, pas confirme).

**[2026-09-19 -- les 3 defauts P1 de l'audit de code corriges (INST
0xFF, sauvegardes atomiques patch/projet/GB, autosave GB periodique),
teste et un bug trouve+corrige sur le vrai materiel]**

Suite de `docs/AZ2_AUDIT_CODE_2026-09-19.md` (autre session IA,
fusionne plus tot ce soir) -- 3 defauts P1 :

- **INST 0xFF jamais envoye au chargement d'un projet** :
  `loadProject()` sautait l'envoi de `INST:` quand la valeur sauvegardee
  valait `0xFF` (= "pas d'override, patch par defaut de la piste"),
  laissant un ancien override en place dans le Teensy si la memoire
  courante en avait deja un sur ce pas -- le projet charge n'etait donc
  pas forcement identique au projet sauvegarde. Corrige : `INST:` est
  desormais TOUJOURS envoye, y compris 255 (deja une valeur acceptee
  cote Teensy, voir `handleInstCommand()`).
- **Sauvegardes non atomiques (patch/projet/GB)** : l'ancien code
  faisait `SD.remove(path)` PUIS `SD.open(path, FILE_WRITE)` -- une
  coupure de courant/plantage entre les deux detruisait la derniere
  sauvegarde valide sans la remplacer. Nouvelle sequence partout
  (`atomicSaveFile()` cote main.cpp -- patch/projet, template + lambda
  pour reutiliser la meme logique tmp/bak/rename sans dupliquer ;
  `atomicSaveRaw()` cote gb_emulator.cpp -- .sav, fonction separee non
  template car unite de compilation differente) : ecrit dans
  `<nom>.tmp`, verifie une taille non nulle, deplace l'ancien vers
  `<nom>.bak`, renomme le tmp vers le nom final. A aucun moment le
  fichier final n'est absent ou tronque.
- **Sauvegarde GB liee a la sortie propre du jeu** : `gbSaveCartRam()`
  n'ecrivait qu'au moment de `gbUnload()` -- une coupure directe
  pendant la partie perdait toute la progression depuis le dernier
  chargement. Ajoute une sauvegarde PERIODIQUE (30s, voir
  `gbRunFrame()`/`kGbAutosaveIntervalMs`) en plus de celle a la sortie
  propre -- limite la perte reelle a "au plus 30s de jeu" au lieu de
  "toute la session".

**Bug reel trouve ET corrige en testant sur le vrai materiel** :
`atomicSaveFile()` verifiait `f.size()` JUSTE APRES les `f.printf()`
mais AVANT `f.close()` -- renvoyait 0 sur cette implementation FS
(octets pas encore vidanges/comptabilises tant que le fichier reste
ouvert), ce qui faisait echouer TOUTE sauvegarde patch/projet avec
`PATCH_SAVE_ERROR`/`PROJECT_SAVE_ERROR` alors que l'ecriture elle-meme
avait reussi -- confirme casse en direct (`PATCH_SAVE_ERROR:/patches/
0.txt`), corrige en reouvrant le fichier pour verifier sa taille APRES
fermeture. Reteste avec une valeur distincte (FILT cutoff=99) : SAVE
confirme reussi, valeur changee expres avant LOAD, LOAD confirme
restaurer exactement la bonne valeur -- round-trip verifie, pas
seulement "pas d'erreur".

**[2026-09-19 -- navigation MOTEURS simplifiee (sans A), bouton retour
deplace sur C et limite a un seul etage, teste sur le vrai materiel]**

Retour utilisateur apres le premier essai de la page MOTEURS (entree
precedente) : "on est un peu dans le desordre de controle ... il faut
selectionner l'encadre piste et droite gauche [pour changer de
piste]". Le systeme A+GAUCHE/DROITE pour basculer le focus (calque sur
A+GAUCHE/DROITE=SAVE/LOAD de la page PATCH) ne se sentait pas naturel
ici. Remplace par un modele SANS modificateur :

- GAUCHE/DROITE bascule TOUJOURS le focus entre liste MOTEUR et liste
  PATCH quand on est dans une de ces listes (naturel, cote a cote a
  l'ecran).
- Pour changer de PISTE, il faut remonter jusqu'a la ligne PISTE :
  HAUT depuis le tout premier element d'une liste (moteur 0 ou patch
  0) n'y boucle plus (pas de retour a SAMPLER/dernier patch) mais fait
  passer le focus sur la ligne PISTE, ou GAUCHE/DROITE change alors la
  piste. BAS depuis la ligne PISTE redescend dans la liste. Contour
  blanc sur la ligne PISTE quand elle a le focus (seul repere visuel
  de "ou" on est).

Demande separee, meme message : "en global hors emulateur le bouton
retour on le met sur C ... il faut pas que ca revienne au menu
general il faut que ca revienne d'un etage seulement" :

- **Bouton retour deplace de B a C** partout (sauf en pleine partie
  GB, ou C garde son role de sortie propre deja existant) -- confirme
  fonctionnel sur le vrai materiel par l'utilisateur ("tout les
  bouton marche deja", C etait suspecte non cable plus tot dans la
  session, ce n'est plus le cas).
- **Un seul niveau de retour, pas le menu general** : nouvelle
  variable `navPrevious` (UN SEUL ecran memorise, pas une pile
  complete -- suffisant pour "un etage seulement") mise a jour dans
  `goTo()` a chaque vrai changement de page. Le bouton retour appelle
  desormais `goTo(navPrevious)` au lieu de `goTo(Screen::Menu)` --
  fonctionne en cascade (A -> B -> C, retour = B, retour encore =
  A).
- **Conflit trouve et corrige au passage** : la page MOTEURS utilisait
  deja C pour bascule MUTE (piste selectionnee) -- retire (D reste
  SOLO, MUTE n'a plus de raccourci dedie sur cette page pour
  l'instant, reste accessible par serie).

**Valide sur le vrai materiel via SIMNAV:/SIMBTN:** : bascule de focus
sans A confirmee (DROITE change le focus, BAS envoie alors PATCH:0:1
correctement), remontee sur la ligne PISTE confirmee (HAUT depuis
DEXED/index 0 n'envoie AUCUN ENGINE:, contrairement au comportement
bouclant d'avant), changement de piste sur la ligne PISTE confirme
(action locale, aucune commande parasite envoyee). BTN:C execute sans
erreur ni blocage depuis la page MOTEURS.

**[2026-09-19 -- page MOTEURS reorganisee (liste moteurs + liste
patches + mini-reglages), navigation croix entierement validee sur le
vrai materiel]**

Demande : "il faut l'organiser differemment une liste de moteur a
gauche et a chaque moteur selectionne ca met les patch a droite et en
dessous la mini fenetre de reglage du patch si on clic dessus on
arrive a la page de reglage de patch". L'ancienne page (8 lignes, une
par PISTE, moteur/patch cote a cote a l'interieur de chaque ligne) est
remplacee par :

- Selecteur de piste en haut (meme motif "< PISTE N >" que PATCH/
  SEQUENCEUR).
- Liste des 6 MOTEURS a gauche (jamais de defilement, 6 tient dans la
  fenetre).
- Liste des PATCHES du moteur assigne a la piste a droite -- defilante
  (jusqu'a 255 pour DEXED), meme principe de fenetre/scroll que la
  page PATCH d'hier soir.
- Bandeau "mini reglages" en bas (2-3 valeurs cles selon le moteur,
  ex. ALGO/FEEDBACK pour Dexed, CUTOFF/RESO sinon) -- tactile, ouvre
  la page PATCH complete.
- Choisir une ligne (croix ou tactile) = assigner IMMEDIATEMENT (pas
  d'etape de confirmation), meme convention "manipulation directe" que
  le reste de l'appli.
- Croix : GAUCHE/DROITE seuls changent de PISTE (meme convention que
  PATCH) ; A+GAUCHE/DROITE bascule le focus entre les 2 listes (meme
  motif que A+GAUCHE/DROITE = SAVE/LOAD sur la page PATCH) ; HAUT/BAS
  deplace-et-choisit dans la liste au focus, avec suivi de defilement
  automatique cote PATCH.

**Valide sur le vrai materiel via SIMNAV:/SIMBTN:** (navigation croix
uniquement, verifiable par ce moyen contrairement au tactile) :
cycle des 6 moteurs avec retour en boucle correct (DEXED -> SAMPLER ->
ANALOG en 2x HAUT), bascule de focus, puis 9x HAUT sur la liste PATCH
DEXED (255 entrees) avec retour en boucle correct (0 -> 254 -> 253 ->
... -> 246) ET defilement suivi sans erreur -- chaque patch confirme
par de vrais echos DXP: differents (les 255 patches chargent bien des
donnees distinctes, pas juste des noms).

**Limite honnete (comme pour le reste des boutons tactiles cette
semaine)** : les zones tactiles (tap direct sur une ligne moteur/
patch, fleches de piste, bandeau mini-reglages) sont compilees et
flashees mais PAS verifiables par mon outil de test -- a confirmer
par l'utilisateur a l'ecran.

**[2026-09-19 -- bug reel trouve : le tracker effacait le panneau
lateral a chaque edition, + panneau lateral refait avec 5 gros boutons
(MOTEUR/PATCH/EFFET/CLAVIER/METRONOME) + metronome audio, teste en
partie sur le vrai materiel]**

Retour utilisateur en direct sur le vrai materiel, plusieurs allers-
retours :

- **Bug reel trouve et corrige** : "les lignes disparaissent a mesure
  que j'edite ... ca efface le cadre [du panneau lateral]". Cause :
  `drawDetailRow()` effacait (fillRect noir) TOUTE la largeur jusqu'a
  `kSeqRightEdge` (bord de l'ECRAN) a chaque ligne editee, au lieu de
  s'arreter au bord reel de la grille (fin de la colonne CND) --
  recouvrait donc le panneau lateral, une bande a la fois, a chaque
  pas edite. Nouvelle constante `kDetailGridRight` (somme exacte des 7
  largeurs de colonne) utilisee a la place -- meme correctif applique
  a `hitTestDetailRow()` par coherence. **Confirme corrige** par
  l'utilisateur ("on est bon").
- **Metronome** (demande explicite) : 6e canal audio sur `mixFinal`
  (4e entree, libre jusqu'ici), simple clic sinus court (pas de
  sustain, decay seul) declenche depuis `advanceTick()` a chaque debut
  de temps (`currentStep % stepsPerBeat == 0`), accentue sur le
  premier temps du pattern. Commande `METRO:<0|1>`. **Teste sur le
  vrai materiel, toutes pistes coupees pour n'entendre que le clic :
  confirme ("oui il marche")**.
- **Panneau lateral repense** (plusieurs allers-retours avant de
  tomber juste -- voir "Ce qui n'a pas marche du premier coup" plus
  bas) : l'ancien resume texte (moteur/patch/cutoff/reso/adsr, flagge
  par l'utilisateur comme "pas bon") disparait, remplace par **5
  boutons PLEINE LARGEUR empilant toute la hauteur du panneau** :
  MOTEUR (page MOTEURS), PATCH (ex-AGRANDIR, page PATCH complete),
  EFFET (reste dans le tracker, amene le focus croix sur la colonne
  FX du pas selectionne -- les effets SFX sont PAR PAS, pas par piste,
  pas de page dediee pertinente), CLAVIER (page AUDIO, pad 4x4,
  `padEditsStep` active d'office pour jouer/enregistrer un pattern en
  direct), METRONOME (bascule). La ligne de transport du bas (PLAY/
  BPM/DIVISION) reste **exactement comme avant** (demande explicite :
  "la ligne du bas on la laisse comme elle est").
- **Ce qui n'a pas marche du premier coup** (transparence) : premier
  essai = agrandir la ligne de transport du bas + ajouter METRONOME/
  PADS sur une 2e ligne en dessous (en retirant la barre de statut
  TEENSY de cette page pour liberer la place). Compile, flashe,
  fonctionnellement correct (metronome confirme audible), mais
  **mauvais choix de layout** : l'utilisateur voulait ces boutons dans
  le panneau LATERAL (comme MOTEUR/AGRANDIR deja existants), pas dans
  une nouvelle ligne de transport -- retire et redirige vers le
  panneau lateral, comme decrit ci-dessus.
- **Limite honnete, toujours valable** : le nouveau panneau lateral
  (5 boutons) est purement tactile, pas verifiable par mon outil
  SIMNAV:/SIMBTN: -- compile+flashe mais PAS encore confirme
  visuellement par l'utilisateur au moment ou ceci est ecrit.

**[2026-09-19 -- bouton MOTEUR dans le panneau lateral du tracker, PAS
teste visuellement (tactile, hors de portee de l'outil SIMNAV/SIMBTN)]**

Demande : "une fenetre de reglage pour chaque moteur pour les
attribuer a une piste regler les patch effet". Interprete comme :
le panneau lateral du tracker (`drawTrkSidePanel()`) affichait deja le
patch actif + un bouton "AGRANDIR" qui ouvre la page PATCH complete
(filtre/ADSR/DXR/EXP/BXP, tout le travail d'hier soir) pour la piste
affichee -- il manquait le meme raccourci pour CHANGER de moteur (avant
: fallait quitter le tracker, passer par le menu, page MOTEURS).
Ajoute un 2e bouton "MOTEUR >" juste au-dessus, meme principe :
ouvre `Screen::Engines` directement sur la piste du tracker
(`selectedEngineTrack = selectedSeqTrack`). Les "effets" (SFX : ARP/
CUT/RET) restent la ou ils etaient deja -- colonne FX du tracker
lui-meme, pas une fenetre separee (ce sont des effets PAR PAS, pas
par piste, une fenetre dediee n'aurait pas de sens pour eux).

**Limite honnete** : ce bouton est purement tactile (comme AGRANDIR
avant lui) -- mon outil de test habituel (SIMNAV:/SIMBTN:, croix et
boutons physiques) ne peut RIEN verifier ici, seulement compiler et
flasher. Reste a confirmer par l'utilisateur en tapant dessus sur le
vrai ecran.

**[2026-09-19 -- BRAIDS 8->43 formes, ANALOG 4->11 formes d'onde,
testes sur le vrai materiel]**

Suite de "recuperer un max de patch pour tout les moteur", apres
DEXED (entree du dessous) :

- **BRAIDS** : 43 des 43 algorithmes UTILISABLES de Synth_Braids (pas
  les 8 choisis a la main le 2026-09-15) -- MacroOscillatorShape
  (settings.h) referencees par leur VRAI NOM d'enum
  (`MACRO_OSC_SHAPE_KICK` etc.), pas une valeur numerique devinee/
  comptee a la main (l'enum a des trous du aux formes commentees dans
  la lib elle-meme -- WAVETABLES/QUESTION_MARK/YOUR_ALGO, jamais
  activees). Teste sur le vrai materiel (3 formes dont KICK/HARMONICS/
  CYMBAL, meme piste isolee).
- **ANALOG** : 11 formes d'onde AudioSynthWaveform (pas 4) -- ajoute
  Pulse/Dent inversee/Sample & Hold/Triangle variable, plus les
  versions "bandlimited" (anti-repliement) de dent de scie/carre/
  pulse. `WAVEFORM_ARBITRARY` exclu (demande une table d'onde fournie
  a part). Teste sur le vrai materiel ("oki entendu").
- **EPIANO verifie mais inchange** : mdaEPiano n'a en realite que 5
  vrais presets d'usine (`mdaEPianoData.h` : les 3 slots restants sur
  8 sont des doublons vides "(default)", pas du vrai contenu) -- rien
  de plus a recuperer la, les 12 parametres continus (`EXP:`, entree
  d'hier soir) restent la vraie richesse de ce moteur.
- Flashe et verifie sur le vrai materiel (Teensy + ESP32, les 2 pour
  que les nouveaux noms s'affichent a l'ecran).
- **Reste** : SAMPLER (peut recuperer Piano-C1..C8/Kick_FBI/voc_1..11,
  deja vendores dans le meme dossier que Kick/Snare) ; la demande
  suivante de l'utilisateur ("une fenetre de reglage pour chaque
  moteur pour les attribuer a une piste, regler les patch, effet") --
  voir l'entree suivante si commencee.

**[2026-09-18, nuit -- DEXED passe de 8 a 255 vrais patches d'usine
DX7 (ROM1-ROM4), teste sur le vrai materiel]**

Suite de "recuperer un max de patch pour tout les moteur". Trouvaille :
`src_teensy/microdexed-touch/third-party/Synth_Dexed/examples/Banks/
banks.h`, deja vendored dans le repo, contient **320 vrais patches DX7**
(10 banques x 32 -- generes par `sysex2c.py`), dont les 8 vraies
banques ROM d'usine du Yamaha DX7 ORIGINAL (rom1a/rom1b/rom2a/rom2b/
rom3a/rom3b/rom4a/rom4b = 256 patches, les presets les plus connus/
reconnaissables du DX7 -- BRASS, STRINGS, E.PIANO, etc.) -- jamais
exploite avant ce soir, on n'utilisait que 8 patches choisis a la main.

- **255 des 256 patches ROM extraits** (script Python ponctuel, voir
  l'historique git) vers `src_teensy/az2_audio/az2_dexed_bank_data.h`
  -- noms EXTRAITS DU SYSEX lui-meme (pas retapes), memes octets bruts
  que le DX7 d'origine. **Pas 256** : le tout dernier patch (ROM4B
  "EXPLOSION") est volontairement laisse de cote -- 0xFF/255 est deja
  le sentinel "pas d'override de patch par pas" (`stepPatch`/
  `seqStepPatch`, ESP32 ET Teensy) ; un vrai patch DEXED numero 255
  aurait ete indiscernable de ce sentinel.
- **Bug trouve et corrige au passage** : `enginePatchCount()`
  (`AZ2_Protocol.h`) retournait un `uint8_t` -- un compte de 256
  (avant la decouverte du piege 0xFF ci-dessus) s'y serait tronque en
  0, transformant tout `% count` en division par zero (comportement
  indefini) partout ou ce compte sert a boucler sur les patches.
  Elargi en `uint16_t`, 3 sites d'appel ESP32 corriges au meme type.
- **Teste sur le vrai materiel** : patches 0/127/254 joues a la suite
  sur la meme piste isolee, confirme 3 sons distincts sur toute la
  plage ("oui son different").
- Les autres moteurs restent inchanges ce soir cote patches
  (BRAIDS/EPIANO/ANALOG/KARPLUS/SAMPLER) -- prochaine piste si le
  temps le permet.

**[2026-09-18, nuit -- 6e moteur : SAMPLER, premier son embarque, teste
sur le vrai materiel]**

Demande : "on va mettre en route le sampleur ... recuperer un max de
patch pour tout les moteur". Voir `docs/AZ2_SAMPLEUR.md` pour le detail
complet -- resume ici :

- **Nouveau moteur** `az2::kEngineSampler` (6e, apres DEXED/EPIANO/
  BRAIDS/KARPLUS/ANALOG) -- lecture PCM 16 bits mono avec suivi de note
  (resampling lineaire, un coup, pas de bouclage), classe
  `AudioPlaySampler` ecrite ce soir (`src_teensy/az2_audio/
  az2_sampler.h`).
- **2 patches de depart** (Kick, Snare) -- PAS de nouveaux fichiers a
  chercher : deja vendores dans le repo avec MicroDexed-touch
  (`addon/SD/CUSTOM/Kick_1_Simple.wav`/`Snare_1_Simple.wav`, meme
  licence GPLv3 que le reste du projet). Convertis en tableaux PCM
  EMBARQUES EN FLASH (pas charges depuis la carte SD physique du
  Teensy -- je ne peux pas y deposer de fichiers a distance, voir
  AZ2_SAMPLEUR.md pour le plan complet a plus long terme).
- **Teste sur le vrai materiel, piste isolee** : Kick et Snare
  confirmes propres a la note racine ("oki ca marche", "oki"). Suivi
  de pitch confirme (Kick une octave au-dessus -> "pareil plus court",
  coherent avec un sample qui joue 2x plus vite).
- **Pas encore fait** : chargement depuis la carte SD reelle (plan
  detaille dans AZ2_SAMPLEUR.md, demande une etape materielle -- copier
  des fichiers sur la carte -- que seul l'utilisateur peut faire) ;
  reglages avances par sample (SAMPLER n'a pour l'instant que le choix
  du sample via PATCH:, pas de SXP: equivalent a DXR:/EXP:/BXP:).

**[2026-09-18, nuit -- editeur de patch complet DEXED/EPIANO/BRAIDS,
page PATCH a defilement, valide sur le vrai materiel]**

Demande : "un editeur de patch complet et completement reglable ...
sovegardable". Suite du protocole firmware (DXR:/EXP:/BXP:, voir
l'entree plus bas) -- cote ecran ESP32 cette fois.

- **Decision de layout** : la page PATCH etait deja pleine (8 lignes,
  zero place libre -- verifie : les 8 lignes existantes occupaient
  deja tout l'espace vertical disponible). Demande a l'utilisateur
  comment caser 12 a 17 parametres de plus par moteur -- **choix :
  liste a defilement dans la MEME page PATCH** (pas un nouvel ecran).
- **Implemente** (`src_esp32/az2_screen/main.cpp`) :
  - `patchExtraCount(track)` : 0 (KARPLUS/ANALOG, rien de plus a
    exposer), 2 (BRAIDS : color/timbre), 12 (EPIANO : les 12 vrais
    parametres continus), 17 (DEXED : parametres globaux DX7, pitch
    EG + LFO + transpose -- algo/feedback restent lignes 2-3, le nom
    hors scope).
  - VOLUME et SLOT ne sont plus fixes aux lignes 6/7 -- decales
    dynamiquement apres les lignes extra du moteur affiche
    (`patchVolRow()`/`patchSlotRow()`/`patchTotalRows()`).
  - Fenetre de 8 lignes visibles (`kPatchVisibleRows`, MEME
    disposition pixel qu'avant) qui defile sur le nombre de lignes
    LOGIQUES reel (`patchScroll`, meme principe que la liste de ROM
    GB) -- `patchRowVisible()` centralise le calcul/la visibilite,
    tout redessin hors champ devient un no-op propre plutot qu'un
    mauvais rafraichissement.
  - `patchExtraVal[piste][17]` -- shadow des valeurs courantes,
    peuple par une rafale de requetes (`DXR?`/`EXP?`) a l'entree sur
    la page/au changement de piste/moteur (`queryPatchExtra()`), tenu
    a jour ensuite par les echos DXR:/EXP:/BXP: (nouveaux cas dans
    `handleTeensyLine()`).
  - Bug latent trouve et corrige au passage : `patchRowActive()`
    (verifiait `row >= 4` pour Dexed) aurait desactive a tort TOUTES
    les lignes extra DEXED (>= 6) -- corrige en `row >= 4 && row < 6`,
    son domaine reel (les 6 lignes fixes seulement).
  - Touche tactile : portee VOLONTAIREMENT limitee aux 6 lignes fixes
    et a VOLUME/SLOT UNIQUEMENT quand ils sont a leur position
    d'origine (moteur sans ligne extra, ou pas encore scrolle) --
    au-dela, la croix reste le seul chemin fiable. Choix delibere pour
    tenir dans le temps disponible, documente dans le code.
- **Valide sur le vrai materiel** via le meme outil SIMNAV:/SIMBTN:
  que le test tracker plus haut (navigation profonde + defilement +
  edition, verifie par les commandes DXR:/EXP:/BXP: exactement
  attendues a chaque etape, PAS par une lecture visuelle de l'ecran --
  meme limite honnete que le test tracker) :
  - **DEXED** : entree sur la page -> 17x `DXR?0:X` envoyes (bon
    octet brut a chaque fois) -> 17 reponses avec de vraies valeurs de
    patch. 6 appuis BAS depuis la ligne 0 amenent en fait a la ligne 8
    (pas 6 -- les lignes 4-5 inactives chez Dexed sont sautees en UN
    seul appui par la boucle de recherche existante, comportement
    INCHANGE, juste reverifie) : edition -> `DXR:0:2:21` (PEG R3),
    correct. 10 appuis BAS de plus (defilement declenche, verifie sans
    erreur) -> ligne 18 -> edition -> `DXR:0:14:1` (LFO AMD), correct.
  - **EPIANO** : changement de moteur -> 12x `EXP?0:X` automatique,
    vraies valeurs mda par defaut recuperees (64/64/64/64/64/83/32/
    64/64/19/0/82). Edition de la 1ere ligne extra -> `EXP:0:0:65`,
    correct (DECAY).
  - **BRAIDS** : changement de moteur -> confirme. Edition de la 1ere
    ligne extra -> `BXP:0:0:66`, correct (COLOR).
- **A faire** : verification VISUELLE par l'utilisateur (surlignage,
  texte, alignement des lignes extra/volume/slot une fois scrollees --
  jamais vu a l'ecran, seulement verifie par le journal serie) ;
  recuperation de vrais bancs de patches (DX7 notamment, format
  compatible avec DXR:) pour peupler kDexedPatchBank plus largement ;
  eventuellement un editeur par operateur DEXED (les 126 octets
  restants, 6 x 21 -- hors scope ce soir, cible la plus lourde des 3).

**[2026-09-18, nuit -- charge CPU/memoire mesuree : grosse marge sur
les 3 axes, "tas critique" note plus haut ce soir infirme]**

Demande : "on les fait tous sonner en meme temps pour voir la charge
processeur et voir si on peut en ajouter sur le tensy". Mesure reelle,
8 pistes actives simultanement (les 5 moteurs representes, notes
differentes, meme filtre 15kHz) :

- **CPU : 7.1% (pic mesure 11.2%).** Le Teensy 4.1 (600MHz Cortex-M7)
  s'ennuie completement avec la charge actuelle -- large marge pour
  plus de voix ou des moteurs plus lourds a calculer.
- **Memoire audio (blocs DMA, `AudioMemory(200)`) : 125-139/200.**
  Correct mais se resserre avec 8 voix actives -- a surveiller/
  augmenter (`AudioMemory(N)`, cout RAM statique nul en pratique) si on
  ajoute beaucoup plus de voix simultanees.
- **Tas (malloc/new) : FAUSSE ALERTE corrigee.** mallinfo() ne
  montrait que ~1.6 Ko libres dans l'arene ACTUELLE (36 Ko), note plus
  haut ce soir comme piste possible pour le bruit blanc (avant de
  trouver la vraie cause, le filtre) -- mais l'arene newlib grandit a
  la demande via `_sbrk()` jusqu'a `_heap_end` (voir
  `imxrt1062_t41.ld`/`startup.c` du coeur Teensy), PAS un plafond dur a
  36 Ko. **Verifie empiriquement** (nouvelle commande `HEAPTEST:<Ko>`,
  gardee dans le firmware) : allocation de 300 Ko d'un coup, ecriture/
  lecture confirmee correcte, liberation propre -- l'arene est montee a
  347712 o puis redescendue a 36416 o. Le rapport du linker
  (`free for malloc/new: 454208`) est donc bien la vraie marge
  disponible, pas juste une taille "annoncee" theorique.
- **Conclusion : rien ne bloque cote ressources** pour enrichir les
  patches (plus de parametres stockes par piste) ou ajouter des
  moteurs -- CPU, memoire audio et tas ont tous une marge confortable.

**[2026-09-18, nuit -- les 5 moteurs confirmes propres avec leur
patch par defaut (objectif "on fait sonner proprement tout les moteur
audio un par un" enfin atteint)]**

Suite du fix filtre (entree du dessous). Piste 0 isolee, meme note
(60), chaque moteur teste avec son PATCH REEL (pas juste une onde
brute) : DEXED "FM-Rhodes", EPIANO "Default", BRAIDS "CSAW", KARPLUS
(corde pincee, seul patch dispo), ANALOG "Sinus". **Les 5 confirmes
propres par l'utilisateur** (quelques faux "rien entendu" avant
confirmation au deuxieme essai -- probablement le temps de reaction
entre l'envoi PLAY et l'ecoute, pas un souci reproductible). Etat
remis a plat apres (demute/desolo tout, pas de test desactive).

Avec le fix filtre + ce tour de validation, l'objectif du 2026-09-18
("on fait sonner proprement tout les moteur audio un par un") est
atteint pour les 5 moteurs.

**[2026-09-18, nuit -- fiabilisation du fix filtre + test complet du
tracker/page PATCH par simulation, sans les mains sur le vrai clavier]**

Suite de l'entree du dessous (fix filtre 18kHz -> 15kHz). Deux
choses faites a la demande "on fiabilise et il faut que je teste ca du
tracker tu peut tester toi" :

- **Fiabilisation** : reteste le nouveau plafond (15000Hz) a
  RESONANCE MAXIMALE (127/127, pas juste 0.7 minimal comme lors de la
  decouverte) -- toujours propre, confirme utilisateur ("ca sonne
  propre"). Le nouveau plafond tient meme dans le pire cas (resonance
  au max), pas seulement au minimum ou le bug avait ete trouve.
- **Outil de test ajoute** (`src_teensy/az2_audio/main.cpp`) :
  `SIMNAV:<direction>:<0|1>` et `SIMBTN:<lettre>:<0|1>` sur le port USB
  du Teensy -- injectent un evenement croix/bouton EXACTEMENT comme un
  vrai appui physique (meme `az2::printNav()`/`printBtn()` vers
  Serial1, seul chemin par lequel l'ESP32 recoit ces evenements, la
  croix/les boutons etant cables directement sur le Teensy). Permet de
  piloter le tracker par script depuis l'ordinateur, sans avoir acces
  au clavier physique -- garde en permanence dans le firmware (outil
  de test utile, cout nul).
- **Test complet execute et REUSSI sur le vrai materiel** (verifie en
  lisant les commandes que l'ESP32 envoie en retour au Teensy sur son
  propre port de debug -- `sendToTeensy()` les imprime deja toutes,
  aucun ajout de code cote ESP32 necessaire) :
  - Menu -> categorie MUSIQUE -> SEQUENCEUR (2x BTN:A) : OK.
  - Page SEQUENCEUR, les 6 colonnes testees une par une (croix DROITE
    pour changer de colonne, A maintenu + HAUT pour editer) :
    - **NOTE** (colonne 0) : pas OFF au depart -> a bien envoye
      `STEP:0:0:1` PUIS `NOTE:0:0:61` -- confirme que le fix
      "auto-activation du pas en editant la note" (2026-09-18, plus
      haut dans ce journal) est toujours vivant et fonctionne.
    - **INST** -> `INST:0:0:1`. **FX** -> `SFX:0:0:1:0`. **VAL** ->
      `SFX:0:0:0:1`. **PROB** -> `PROB:0:0:100`. **COND** ->
      `COND:0:0:33` (= 1:2 dans le cycle, encodage nibble correct).
      Les 6 colonnes produisent la commande attendue, aucun crash, aucun
      blocage.
  - Retour Menu (BTN:B) -> categorie MUSIQUE -> DOWN x2 (MOTEURS puis
    PATCH) -> BTN:A : entree sur la page PATCH confirme par l'envoi
    automatique de `SCOPE:0` (voir `goTo()`).
  - Page PATCH, ligne 0 (filtre), A+HAUT -> `FILT:0:127:0` envoye : OK.
  - Ligne 7 (SLOT), A+DROITE -> `PATCH_SAVED:/patches/0.txt` (sauvegarde
    reelle sur SD). A+GAUCHE -> **recharge le meme fichier et renvoie
    exactement les memes parametres** (`ENGINE:0:4`, `PATCH:0:0`,
    `FILT:0:127:0`, `ENV:0:3:20:89:38`, `DXP:0:0:4`, `DXP:0:1:0`) --
    aller-retour sauvegarde/chargement de patch confirme integre et
    fonctionnel.
- **Limite honnete de ce test** : verifie la LOGIQUE (les bonnes
  commandes partent au bon moment, dans le bon format) via le journal
  serie, PAS le RENDU VISUEL a l'ecran (surlignage, texte affiche) --
  ca reste a l'utilisateur de confirmer que ce qui s'affiche correspond
  bien a ce que la logique fait. Etat remis a plat apres le test
  (demute tout, plus de solo, pas de test desactive).

**[2026-09-18, nuit -- RESOLU : le "bruit blanc" des moteurs (DEXED,
EPIANO, BRAIDS, KARPLUS, puis ANALOG aussi) n'etait pas un bug moteur --
c'etait le filtre partage, reglee par defaut dans sa zone d'instabilite]**

Suite de l'investigation des entrees precedentes ("cause toujours pas
trouvee"). Cause reelle trouvee et confirmee sur le vrai materiel :

- **Le defaut au boot ET le plafond de la commande FILT: (127/127)
  etaient a la MEME valeur : 18000Hz.** Donc TOUS les tests "moteur X
  sonne mal" depuis le debut de cette investigation (hier soir et ce
  soir) ont ete faits filtre grand ouvert a 18kHz, sans que personne
  (utilisateur ni moi) ne le sache -- le filtre n'a jamais ete suspecte
  parce que "grand ouvert" (127/127, le reglage par defaut affiche comme
  "neutre") semblait la position la moins susceptible de deformer le
  signal.
- `AudioFilterStateVariable` (topologie Chamberlin SVF, voir
  `filter_variable.h` dans la lib Audio Teensy) autorise en theorie
  jusqu'a `AUDIO_SAMPLE_RATE_EXACT/2.5` (~17647Hz, son propre clamp
  interne) mais devient en pratique instable/auto-oscillant pres de
  cette limite, MEME a resonance minimale (0.7, la plus "plate"
  possible ici) -- un defaut connu de cette topologie de filtre pres de
  Nyquist, jamais documente dans ce projet avant ce soir.
- **Teste en direct sur le vrai materiel, piste 0 isolee (MUTE sur les 7
  autres pistes + SOLO:0:1), meme note (60), memes 5 moteurs un par
  un** : a 18000Hz (defaut), bruit blanc reproductible identiquement
  sur DEXED/EPIANO/BRAIDS/KARPLUS **ET ANALOG** (le moteur jusque-la
  "epargne" -- premiere fois qu'il est retest apres le fix enveloppe
  partagee d'hier soir, et il echoue aussi cette fois, ce qui a
  relance l'enquete). A 8000Hz, 12000Hz puis 15000Hz : **note propre
  sur les 5 moteurs**, confirme utilisateur ("la ca sonne", "pareil
  une note qui monte en volume", "la ca sonne aussi de plus en plus
  fort"). A 18000Hz encore une fois (retour au defaut) : bruit blanc de
  nouveau. Correlation parfaite cutoff/bruit, aucune dependance au
  moteur -- preuve directe que la CAUSE COMMUNE speculee dans l'entree
  precedente ("chaine de signal... pas un bug isole par bibliotheque")
  etait juste, et que c'etait le filtre partage.
- **Corrige** (`src_teensy/az2_audio/main.cpp`) : plafond de
  `handleFiltCommand()` et defaut au boot passes de 18000Hz a 15000Hz
  (dernier point teste propre sur le vrai materiel -- 18000Hz ne
  l'etait pas). Flashe et reteste sur le vrai materiel SANS aucune
  commande FILT: (reglage par defaut du boot) : DEXED puis EPIANO/
  BRAIDS/KARPLUS/ANALOG tous confirmes propres par l'utilisateur.
- **Le fix "enveloppe partagee" d'hier soir (trackAnalogEnv[] commun
  aux 5 moteurs) reste dans le code** -- n'a jamais ete la cause, mais
  c'est une amelioration reelle et sans effet de bord (gating ADSR
  propre au lieu d'un simple mute par moteur), gardee.
- **Le bug de transmission SCOPE (entree du dessous) est une decouverte
  separee et reste corrige independamment** -- utile pour la fiabilite
  generale du lien, pas pour ce bug-ci (qui n'a jamais eu besoin du
  scope pour etre resolu, juste d'un test methodique cutoff par
  cutoff).
- **Lecon a retenir** : quand plusieurs bibliotheques totalement
  independantes (dont une classe officielle Teensy Audio Library)
  produisent EXACTEMENT le meme symptome, chercher dans ce qu'elles ont
  en commun (ici : le filtre partage en aval, identique pour toutes les
  pistes) avant de re-suspecter chaque bibliotheque individuellement.

**[2026-09-18, nuit -- bug de transmission SCOPE trouve et corrige,
flashe et lien confirme stable sur le vrai materiel (voir entree
au-dessus pour la suite -- ce correctif n'a PAS resolu le bruit moteur,
c'etait une piste independante)]**

Suite de l'entree precedente ("prochaine piste serieuse : reparer
d'abord le bug SCOPE"). Analyse complete du chemin
`updateScope()` (Teensy) -> `readTeensyStatus()`/`handleScopePacket()`
(ESP32), et de son jumeau symmetrique cote son GB
(`AudioRxState`/`readStream()` sur le Teensy, ESP32 -> Teensy) :

- **Cause racine identifiee** : (1) aucune verification de longueur ni
  checksum dans le parseur binaire -- un SEUL octet perdu decale la
  lecture "longueur" sur un octet de charge utile quelconque, qui peut a
  son tour valoir par hasard l'octet magique et relancer un faux paquet
  -- desynchronisation qui s'auto-entretient indefiniment une fois
  declenchee (explique le "bruit" aleatoire identique du dump SCOPE,
  qu'il vienne d'ANALOG propre ou d'un moteur casse : ce sont des
  octets de charge utile arbitraires mal alignes, pas une propriete du
  signal audio) ; (2) `handleScopePacket()` appelait `drawPatchScope()`
  (dessin SPI, plusieurs ms) DEPUIS la boucle meme qui lit `Serial1`
  octet par octet, bloquant la lecture assez longtemps pour perdre des
  octets ; (3) tampon RX materiel laisse a sa taille par defaut (256 o
  cote ESP32 ; petit aussi cote Teensy) alors que le lien tourne
  maintenant a 921600 bauds -- se remplit en 2-3 ms, moins que certains
  blocages du `loop()` (dessin ecran, frame GB), tout depassement perd
  des octets EN SILENCE (aucune notification d'overflow lue par le
  code).
- **Corrige (compile sur les 3 environnements + 9 tests natifs OK,
  PAS ENCORE flashe/verifie sur le vrai materiel a l'heure ou ceci est
  ecrit)** :
  - `Serial1.setRxBufferSize(2048)` cote ESP32 (avant `begin()`) et
    `Serial1.addMemoryForRead(buf, 2048)` cote Teensy (API native du
    core Teensy 4, avant `begin()`) -- marge large a 921600 bauds.
  - Dessin du tracer (`drawPatchScope()`) sorti de la boucle de lecture
    Serial1 -- `handleScopePacket()` ne fait plus que copier les
    echantillons et poser `scopeNeedsRedraw`, le dessin reel se fait une
    fois par tour de `loop()`, apres `readTeensyStatus()`.
  - Verification de longueur stricte des deux cotes : le Teensy
    n'envoie jamais qu'une longueur SCOPE fixe (32,
    `kScopeSamplesPerPacket`) et l'ESP32 n'envoie jamais qu'une longueur
    audio GB fixe (`kGbAudioSamplesPerPacket`, nouvelle constante
    partagee dans `AZ2_Protocol.h`, meme formule que `AUDIO_SAMPLES`
    dans `minigb_apu.h`) -- toute longueur recue differente = paquet
    rejete et resynchronisation immediate au lieu d'avaler des octets de
    charge utile bidon.
  - Delai d'abandon (20 ms, tres large face a un paquet complet en <1 ms
    a 921600 bauds) : un paquet reste "ouvert" trop longtemps (lien
    bloque/coupe au milieu) force un retour en mode texte au lieu de
    rester coince a attendre un octet qui n'arrivera jamais.
- **A faire ensuite** : flasher les deux cartes, reverifier que le
  dump SCOPE donne enfin une vraie forme d'onde coherente pour ANALOG
  (propre) ET pour un moteur casse (KARPLUS/BRAIDS/EPIANO), PUIS s'en
  servir comme vrai outil de diagnostic pour la cause du bruit moteur
  lui-meme (toujours inconnue, voir entree precedente). Profiter aussi
  de l'occasion pour re-verifier que le son GB (meme classe de
  correctif applique cote Teensy) reste stable au niveau audio/visuel a
  921600 bauds.

**[2026-09-18, soir -- bruit blanc elargi a 4 moteurs sur 5, cause
toujours pas trouvee malgre une investigation poussee]**

Retour utilisateur sur le vrai materiel : en testant EPIANO/BRAIDS/
KARPLUS un par un (meme protocole que le test DEXED d'hier), les 3
produisent **le meme bruit blanc, decrit comme identique** par
l'utilisateur. **Seul ANALOG reste confirme propre.** Ca elargit
fortement le probleme -- ce n'est PAS specifique a DEXED (ni a une
bibliotheque vendored en particulier, puisque KARPLUS est un objet
Teensy Audio Library OFFICIEL, pas du code tiers).

Tests faits pour isoler la cause :

- **MUTE:0:1 pendant que le bruit joue -> silence.** Confirme que le
  bruit vient bien de la piste 0 (pas d'une autre piste mal coupee).
- **FILT:0:0:0 (filtre ferme a 20Hz) -> silence total.** FILT:0:64:0
  (coupure intermediaire ~600Hz) -> **une vraie note courte redevient
  audible, melangee a des "petits clacs"**. Ca prouve que le moteur
  produit un signal musical REEL, pas juste du bruit -- quelque chose
  d'autre (haute frequence, large bande) le noie/domine a coupure
  grande ouverte (reglage par defaut).
- **Hypothese testee : enveloppe partagee.** `trackAnalogEnv[]`
  (jusqu'ici reservee a ANALOG) est devenue le point de passage
  OBLIGE des 5 moteurs avant le filtre (`patchTrackIn[]` alimente
  maintenant toujours l'enveloppe, pas le filtre directement ;
  `trackNoteOn()`/`trackNoteOff()` declenchent cette enveloppe pour
  tous). Raisonnement : les 4 moteurs casses alimentaient le filtre
  resonant DIRECTEMENT (sans jamais garantir un zero strict entre les
  notes), contrairement a ANALOG. **Teste sur le vrai materiel : AUCUN
  changement audible.** Le fix est garde (enveloppe ADSR partagee =
  amelioration raisonnable en soi, memes attaques/coupures plus
  propres a terme), mais ce n'etait PAS la cause du bruit.
- **Oscilloscope (SCOPE:) -- FAUSSE PISTE, retiree.** Dump brut des
  echantillons ajoute temporairement cote ESP32 (lecture directe sur
  Serial1, pas commis) : KARPLUS montre des valeurs qui sautent entre
  0 et 255 sans forme coherente -- semble confirmer du "vrai bruit".
  **Mais ANALOG (confirme propre a l'oreille) montre EXACTEMENT le
  meme genre de valeurs chaotiques** avec le meme outil. Conclusion :
  **le chemin de transmission SCOPE lui-meme a un bug** (corruption
  entre le Teensy et l'ESP32, ou dans la reception cote ESP32) --
  invalide toute conclusion tiree de ce dump. Code de dump retire
  (jamais commis dans l'historique). A investiguer separement, PAS un
  indice fiable pour le bruit des moteurs.

**Conclusion honnete** : la cause reste inconnue ce soir malgre
plusieurs pistes testees en direct sur le vrai materiel. Le pattern
(4 moteurs distincts, dont un objet Teensy Audio Library officiel,
touches identiquement ; seul ANALOG epargne) pointe vers quelque chose
de commun a la CHAINE DE SIGNAL ou a l'ALLOCATION MEMOIRE partagee
(voir aussi le tas critique -- 1.6 Ko libres -- note le 2026-09-18
matin), pas vers un bug isole dans une bibliotheque. Prochaine piste
serieuse : reparer d'abord le bug SCOPE (transmission des paquets
Teensy->ESP32), pour avoir un vrai outil de mesure de forme d'onde
avant de continuer a deviner.

**[2026-09-18, GB : rendu video corrige, UART monte a 921600, confirme
en reel]**

- **Regression video annulee** : le rendu "1 bloc PSRAM entier envoye a
  la fin de l'image" fusionne plus tot le meme jour (autre session IA,
  jamais teste sur le vrai materiel avant ce merge) causait un
  scintillement continu de toute l'image ("l'ecran scintille"). Revenu
  au rendu par bandes du 2026-09-15 (1 `draw16bitRGBBitmap()` par ligne
  source, jamais eu ce probleme). **Confirme sur le vrai materiel :
  "c'est beaucoup mieux"**. Walnut-CGB documente lui-meme une limite
  connue a ce style de rendu ligne par ligne (animations qui ne
  s'affichent pas toujours bien, ex. Prehistorik Man cite dans son
  README) -- accepte comme compromis du coeur d'emulation, pas un bug
  AZ-2 a chasser davantage pour l'instant.
- **UART ecran<->Teensy monte a 921600 bauds** (etait 230400) --
  prerequis du "Palier A" de AZ2_EMULATION_JEUX.md pour ameliorer la
  qualite audio du jeu sans saturer le lien. **Teste et confirme sur le
  vrai materiel** : round-trip complet (STEP:/NOTE:/BPM: envoyes cote
  Teensy, recus intacts cote ESP32), croix/boutons/ecran normaux,
  aucune corruption observee. Utilisateur : "ça tourne, c'est pas
  magique mais ça tourne" -- le debit est pret, **la qualite audio du
  jeu elle-meme n'a PAS encore ete touchee** (toujours 8kHz mono 8
  bits, "telephone" -- voir plan plus bas).
- **Recherche faite sur des emulateurs alternatifs** (CrankBoy, gnuboy)
  suite a la frustration utilisateur -- **conclusion : on garde
  Walnut-CGB**, c'est deja le choix le plus adapte a nos besoins exacts
  (support GBC complet + performance). CrankBoy n'a qu'un support GBC
  tres limite (pense pour la Playdate, monochrome) ; les projets a base
  de gnuboy (nesboy-esp32, GBCCAT) visent des ecrans SPI (ST7789/
  ILI9341), pas notre ecran RGB parallele -- meme probleme d'integration
  qui avait deja ecarte Retro-Go. Piste de qualite audio trouvee dans
  la doc Walnut-CGB elle-meme : elle recommande **Blargg's Gb_Snd_Emu**
  (LGPL, compatible) a la place de minigb_apu "si une emulation APU
  precise est necessaire" -- voir la feuille de route ci-dessous.

## Feuille de route GB/GBC (demandee par l'utilisateur, 2026-09-18)

Ordre propose, du plus pret au plus gros chantier :

1. **[FAIT]** Corriger le scintillement video (rendu par bandes).
2. **[FAIT]** Monter l'UART a 921600 bauds, verifier la fiabilite.
3. **Cible qualite audio concrete** : passer `AUDIO_SAMPLE_RATE` de
   8000 a 22050 Hz (ou tenter stereo 8 bits a debit egal -- voir Palier
   A) -- a 921600 bauds (~92 Ko/s bruts), un flux mono 8 bits a 22050 Hz
   (~22 Ko/s) tient large, meme avec le reste du trafic de controle.
   Changement de constante + verification du budget UART reel sur
   materiel (paquets perdus/en retard pendant le jeu).
4. **Integrer Gb_Snd_Emu (Blargg)** a la place de minigb_apu pour une
   emulation APU plus fidele -- chantier plus gros (vendoring, licence
   LGPL a documenter dans AZ2_LICENCES.md, adapter l'interface
   read/write registres au lieu de minigb_apu_audio_read/write). A
   faire une fois l'etape 3 validee (pas la peine d'ameliorer la
   precision APU si le flux qui la transporte est encore limite a
   8kHz).
5. **Protocole audio V2** (longueur 16 bits, numero de sequence,
   compteur de pertes -- deja recommande dans l'audit de progression
   du 2026-09-18) -- utile une fois 3-4 en place, pour diagnostiquer
   les eventuelles pertes a la nouvelle qualite plutot que deviner.
6. Video/frameskip reglable, palettes DMG, menu JEUX complet (voir
   AZ2_EMULATION_JEUX.md, sections "Video a ameliorer"/"Nouveau menu
   JEUX") -- apres que le son et l'image de base soient satisfaisants.

**[2026-09-18, retour utilisateur -- 26 commits d'une autre session IA
fusionnes, hypothese MSFA testee et ECARTEE]** Pendant l'absence de
l'utilisateur (parti au travail), une AUTRE session IA a travaille en
parallele directement sur `main` (26 commits) : audit de progression
complet, fix reproductibilite (lib MIDI morte retiree), perf/cadence
GB (rendu en un bloc PSRAM + pacing microseconde), CI (`ci.yml`,
reutilise `pio test -e native`), et une hypothese concrete sur DEXED --
le constructeur de `Dexed` choisit le coeur FM **MKI** par defaut,
jamais change, alors que **MSFA** est le coeur de reference historique
-- teste comme piste A/B. Fusionne sans aucun conflit (fast-forward,
convergence independante confirmee sur le retrait de DEXED des moteurs
par defaut -- memes valeurs des 2 cotes).

**Teste sur le vrai materiel au retour de l'utilisateur : l'hypothese
MSFA NE REGLE PAS le bruit** -- toujours "souffle, bruit blanc" avec
DEXED force sur MKI->MSFA, piste 0 isolee/solo, note tenue. Piste
ECARTEE. DEXED reste hors des moteurs par defaut (aucun changement de
ce cote), toujours selectionnable a la main pour continuer a le
diagnostiquer plus tard. Egalement fusionne : une exploration
d'architecture "AZ-3" (cartouches moteur ESP32/ESP8266 "AZ-VA1"/
"AZ-CHIP", rack "AZ-BUS") auto-retractee par cette meme session en fin
de parcours ("le boitier AZ-2 est plein, on reste sur le materiel
existant") -- gardee comme reference future, hors scope AZ-2 actuel
(confirme par l'utilisateur : "pas urgent").

**[2026-09-18, apres-midi -- travail en autonomie, ESP32 debranche]**
Utilisateur parti au travail ("continue par la suite"). Teensy encore
branche, ESP32 non -- travail limite au code compile-verifie (pas
flashe/teste sur l'ESP32, a confirmer au prochain reveil du materiel) :

- **Page PATCH, ligne SLOT (7e ligne) ajoutee au meme systeme de
  croix** que le reste de la page (voir le fix precedent) -- la ligne
  SLOT/SAVE/LOAD existait deja a l'ecran (tactile uniquement), pas
  besoin de redesign pour l'ajouter (contrairement a moteur/patch
  integre, qui eux ne rentrent pas). A maintenu + HAUT/BAS cycle le
  numero de slot ; A maintenu + GAUCHE/DROITE declenche SAVE/LOAD
  (nouvelle combinaison, ne touche pas GAUCHE/DROITE seuls qui restent
  le changement de piste). Compile verifie (3 environnements), **pas
  flashe/teste** (ESP32 debranche).
- **Fausse alerte SCOPE: corrigee** (voir plus bas dans le journal) --
  erreur de methode de test de ma part, pas un bug firmware.

**[2026-09-18 matin -- ESP32 flashe, les 2 cartes tournent ensemble]**

**[2026-09-18, demande UI/UX -- gros chantier note, pas fait cette
session]** Retour utilisateur en testant le tracker sur le vrai
materiel : le panneau lateral "patch actif" (`drawTrkSidePanel()`,
cote droit de la page SEQUENCEUR) est juge inutilisable ("on peut rien
faire, y'a rien qui marche"). Demande precise pour le refaire :

1. **Navigation par bouton, surbrillance a presser pour changer la
   valeur** -- meme logique que les colonnes NOTE/INST/FX/VAL/PROB/COND
   du tracker (voir seqDetailCol), pas un panneau juste affiche.
2. **Le panneau devient 2 raccourcis empiles** au lieu d'un bloc
   d'infos statique : en haut un raccourci "PATCH" qui ouvre une
   fenetre dediee de reglage de patch (moteur, forme d'onde/algo
   selon le moteur) ; en dessous un raccourci "EFFETS" qui ouvre une
   fenetre de reglage d'effets **PAR PISTE**, activables/reglables --
   n'existe pas encore cote Teensy (FX:reverb/FX:delay actuels sont
   sur le bus MAITRE global via potards 2/3, pas par piste -- vraie
   extension d'architecture a concevoir, pas juste un ecran).
3. **Page AUDIO (clavier tactile pads)** : passer en plein ecran
   (actuellement partage l'ecran avec d'autres elements), ajouter une
   rangee de boutons pour changer la gamme a la volee, et un
   **arpegiateur complet** (pas juste le triangle ARP par pas du
   tracker actuel -- un vrai mode de jeu arpegiateur en temps reel sur
   le clavier live). Objectif explicite : "que notre petit clavier
   4x4 soit top".

Pas commence cette session (gros chantier UI + nouvelle architecture
d'effets par piste + fonctionnalite musicale complete a concevoir
proprement, pas a bacler en direct pendant une session de debug
materiel). A traiter dans une session dediee.

**Precision donnee plus tard dans la meme conversation** : le panneau
affiche aujourd'hui le moteur + la pattern (deja visibles ailleurs a
l'ecran -- redondant, "on l'a deja a cote, pas besoin de rappel").
Remplacer ce contenu par des BOUTONS qui appellent chacun un ecran de
reglage dedie : choix du moteur, choix/reglage de l'effet assigne a la
piste, reglages moteur (filtre/ADSR/algo selon le moteur), clavier
tactile, arpegiateur -- "que tous les outils soient disponibles,
appelables par des boutons dans le cadre". Confirme la meme direction
que les points 1-3 ci-dessus, precise le contenu exact des boutons a
prevoir.

**Spec complete donnee ensuite (meme conversation, apres test du fix
croix de la page PATCH -- voir plus bas)** :

- **Page MOTEURS** : doit devenir une vraie LISTE de tous les moteurs
  disponibles (DEXED/EPIANO/BRAIDS/KARPLUS/ANALOG), pour attribuer l'un
  d'eux a la piste choisie -- pas juste cycler un a la fois comme
  aujourd'hui.
- **Page PATCH** : gerer les patchs de TOUS les moteurs -- selectionner
  (le patch integre du moteur, ex. "FM-Rhodes"), regler (deja fait :
  filtre/ADSR/DXP via la croix, voir fix plus bas), **sauvegarder**
  (existe deja cote tactile -- `savePatchSlot()`/`loadPatchSlot()`/
  `patchSlot`, voir le code -- juste pas encore accessible au bouton/
  croix). Le choix du MOTEUR lui-meme et du PATCH INTEGRE ne sont PAS
  pilotables au bouton sur cette page actuellement (seuls filtre/ADSR/
  volume le sont depuis le fix ci-dessous) -- **pas assez de place
  verticale dans la mise en page actuelle** (6 lignes + volume
  remplissent deja l'ecran) pour rajouter ces 2 controles sans repenser
  la mise en page -- **vrai redesign a faire**, pas un ajustement.
- **Nouvel outil EFFET** (n'existe pas) : choisir la piste, activer/
  regler un effet, sauvegarder -- effets PAR PISTE, extension
  d'architecture cote Teensy (voir point 2 plus haut, FX:reverb/delay
  actuels sont sur le bus maitre global uniquement).
- **Les 2 fenetres PATCH et EFFET appelables depuis le panneau lateral
  du tracker** (memes boutons que decrits plus haut).

Toujours pas commence (meme raison : gros chantier de mise en page +
nouvelle architecture d'effets, a faire dans une session dediee, pas en
direct).

**[2026-09-18, suite du diagnostic DEXED]** Ajoute `checkHeap()` /
commande `HEAP?` (mallinfo(), voir le commentaire dans le code) pour
verifier la piste "allocation echouee silencieusement" (`new` sans
verification dans `Dexed::Dexed()`, voir plus bas). Resultat mesure sur
le vrai materiel, au repos, apres boot : `used=34800:
free_in_arena=1616:arena=36416` -- seulement 1.6 Ko de marge dans le
tas actuellement obtenu du systeme. Serre, un vrai point a corriger
(augmenter la marge, ou reduire le nombre d'instances Dexed
simultanees), **mais probablement pas la cause principale du bruit** :
une allocation ratee produirait plutot un comportement casse/incoherent
tout de suite, pas "silence tant qu'on ne joue pas, bruit uniquement
en jouant une note, jusqu'a redemarrage complet" -- ce dernier pattern
ressemble plus a une corruption d'etat numerique DANS le calcul FM une
fois une voix declenchee (pas a une allocation qui echoue).

**[CORRIGE] Fausse alerte sur SCOPE:, erreur de methode de test, pas un
bug** : je capturais `/dev/ttyACM0` (port USB du Teensy, `Serial`) en
cherchant les paquets binaires du scope -- mais `updateScope()` les
ecrit sur `Serial1` (`Serial1.write(...)`, voir le code), la liaison
UART DEDIEE vers l'ESP32, jamais visible sur le port USB. Rien ne
prouve que le scope soit casse ; je n'ai simplement jamais pu
l'observer avec les outils que j'avais sous la main (pas d'acces a la
liaison UART Teensy<->ESP32 directement, seulement aux 2 ports USB).
**A verifier plutot en regardant l'ecran** : la page PATCH doit
afficher une forme d'onde en jouant une note sur la piste choisie --
verification visuelle, pas cote serie. Si le scope marche vraiment (a
confirmer), il reste l'outil naturel pour visualiser precisement ce
que produit DEXED plutot que d'en deviner la forme.

**Conclusion honnete** : la vraie cause du bruit DEXED (probablement
dans le coeur FM de `src_teensy/microdexed-touch/third-party/
Synth_Dexed/src/` -- fm_core.cpp/fm_op_kernel.cpp/dx7note.cpp) demande
de VOIR la forme d'onde reelle pour etre diagnostiquee sans deviner --
la page PATCH (SCOPE:) est l'outil pour ca, a verifier a l'ecran au
prochain reveil du materiel plutot qu'a l'aveugle. Pas fait cette
session -- DEXED n'est plus le moteur par defaut d'aucune piste (voir
plus bas), evite tant que non repare.

**[2026-09-18, session de flash -- BUG REEL confirme sur DEXED, pas
materiel]** Long diagnostic en direct avec l'utilisateur sur un
"souffle" audio signale des le premier flash. Piste materielle (SCK/GND
du PCM5102A) explorée et ecartee : ressoudee par l'utilisateur, souffle
inchange. Diagnostic definitif par elimination binaire (MUTE: piste par
piste, 8 tests) :

- **Toutes les pistes coupees = silence total.** Chaque piste
  DEMUTEE INDIVIDUELLEMENT (0 a 7, une par une, testee sur le vrai
  materiel) = silence, aucune ne produit de bruit seule au repos.
- **Le GB (ESP32, meme DAC final) est confirme propre** par
  l'utilisateur -- ecarte un probleme materiel/DAC/SCK generique,
  toute la chaine de sortie fonctionne.
- **DEXED specifiquement, quand une note est reellement declenchee,
  produit du bruit au lieu d'un son** -- confirme par test isole
  (piste 0 = DEXED, solo, note tenue -> "gros souffle pas de note").
- **ANALOG (onde simple), meme test isole, est confirme propre**
  ("la c'est bon") -- pas un probleme general du moteur audio/mixeur,
  specifique a DEXED.
- Le souffle "en silence total" du tout debut de la session s'explique
  par une note DEXED restee active suite a mes tests series du matin
  (STEP:/NOTE:/PLAY puis STOP) -- `stopSequencer()`/`allTrackNotesOff()`
  appelle bien `trackDexedEngine[track].keyup()`, mais quelque chose
  dans Synth_Dexed ne redescend pas franchement a zero (hypothese : 
  instabilite numerique de la boucle de feedback FM, type probleme de
  nombres denormaux -- classique en DSP, la sortie ne s'eteint jamais
  vraiment tant que le denormal persiste). Seul un power-cycle complet
  a nettoye l'etat -- pas rejouable a la demande avec juste STOP/PLAY.

**A faire (prochaine session, pas urgent pour continuer a tester)** :
creuser `src_teensy/microdexed-touch/third-party/Synth_Dexed/` pour la
vraie cause (verifier le traitement des denormaux dans la boucle de
feedback FM, comparer avec la reference MicroDexed-touch pour un
eventuel flag/optimisation manquant cote AZ-2). **En attendant, eviter
DEXED** -- EPIANO/BRAIDS/KARPLUS/ANALOG semblent utilisables (testes
individuellement sans souffle residuel, pas encore ecoutes en train de
vraiment jouer sauf ANALOG).

**[2026-09-18, suite -- corrige]** Retour utilisateur : "PLAY/STOP
marche pas, ca met en route le DEXED, faut reparer ce truc que ca
sonne plutot que ca fasse du bruit" -- PLAY/STOP fonctionnaient en
realite tres bien (confirme plus haut dans ce journal), le vrai souci
etait que DEXED demarre par defaut sur les pistes 0/1/4/5 (voir
`trackEngine[]` dans `src_teensy/az2_audio/main.cpp`), donc appuyer sur
PLAY sans rien changer jouait directement le moteur casse. Corrige :
**DEXED n'est plus le moteur par defaut d'aucune piste**, remplace par
ANALOG (seul moteur confirme propre a l'oreille) sur 0/1/4/5 ; EPIANO/
BRAIDS restent par defaut sur 2/3/6/7 (pas de bug signale dessus). DEXED
reste choisissable a la main via `ENGINE:` pour continuer a le tester/
le reparer plus tard -- juste plus le choix qui demarre tout seul.
Flashe et confirme vivant sur le vrai materiel (CPU 6.1%, plus bas
qu'avant -- coherent, ANALOG est moins couteux que DEXED).

Bugs UI corriges en route pendant cette session de flash (voir
commits) : navigation par pas au D-pad manquante (fix rate 1 : modif
via C, jamais teste car BTN:C n'a jamais genere d'evenement sur ce
montage physique -- fix rate 2 : roles HAUT/BAS <-> A inverses suite
au retour utilisateur, HAUT/BAS navigue par defaut, A maintenu edite),
et colonne NOTE qui n'affichait jamais rien tant que le pas etait OFF
(corrige : editer la note allume desormais le pas automatiquement).

**Signale, pas encore investigue** : bouton C ne genere jamais
d'evenement malgre plusieurs tests (cablage a verifier) ; page
SEQUENCEUR, le panneau "patch actif" ("cadre patch") signale comme peu
utilisable/rien ne se modifie dedans -- possiblement lie au
retrecissement du panneau (~194px -> ~106px) par les colonnes PRB/CND
ajoutees hier soir, a verifier a l'ecran.

**Demande produit notee pour plus tard** : patches "officiels" de
chaque moteur (vrais patchs DX7/EPiano/Braids) a integrer, edition de
patch, sauvegarde -- gros chantier, pas pour cette session.

**[2026-09-18 matin -- ESP32 flashe, les 2 cartes tournent ensemble]**
`pio run -e screen_esp -t upload --upload-port /dev/ttyUSB0` (CH340).
Boot propre : `DISPLAY:READY` (ecran VIEWE reel initialise),
`TOUCH:FT6336U:READY`, `SD:READY:size_mb=30429` (SD ESP32). **Liaison
serie ESP32<->Teensy confirmee en reel** -- tous les echos du Teensy
recus cote ESP32 (`TEENSY:HELLO:...`, `TEENSY:BPM:...`,
`TEENSY:ENGINE:...`x8, `TEENSY:PATTERN:0`, `TEENSY:STATUS:...:READY`).

**Souffle audio signale par l'utilisateur, apparu juste apres le flash
Teensy, present meme en silence total (aucune note jouee)** -- ecarte
une cause logicielle (rien dans le firmware ne touche a la chaine
audio/DAC cette session). Correspond exactement au symptome deja
documente dans `AZ2_DAC_PCM5102A.md` pour **SCK flottant sur le
PCM5102A** ("Flottant -> Souffle/bruit au lieu d'un son propre").
Cause probable : manipulation du Teensy pour le flasher (USB debranche/
rebranche) ayant deloge un fil/une soudure fragile SCK->GND. **A
verifier par l'utilisateur** : continuite SCK-GND au multimetre sur la
carte DAC, reconnecter/ressouder si mauvaise. Pas un bug de code.

**Reste a verifier a l'oeil** (ecran maintenant allume) : la page
SEQUENCEUR avec les 2 nouvelles colonnes PRB/CND (voir plus bas,
kTrkSideX retreci a ~106px pour le panneau "patch actif").

**[2026-09-18 matin -- premier flash reel de la session]** Teensy
flashe (`pio run -e master_teensy -t upload`, /dev/ttyACM0, HalfKay
detecte et programme sans probleme). Boot propre : SD dediee
(`SDTEENSY:READY:size_mb=59456`), PSRAM 16 Mo detectee + test lecture/
ecriture OK, sequenceur `tracks=8:steps=16`. Teste en serie
(pyserial) :
- `PROB:0:0:50`/`COND:0:0:33`/`FILL:1`/`FILL:0` -- acceptees et
  relayees normalement.
- `PROB:0:0:150` (hors bornes) -> `PROB:ERROR:OUT_OF_RANGE` ;
  `BPM:9999` (hors bornes) -> `BPM:ERROR:OUT_OF_RANGE` -- **premiere
  verification en reel du retour d'erreur ajoute hier**, fonctionne
  comme prevu.
- Pattern joue avec `SWING:127` (le nouveau maximum, plafonne a
  kTicksPerStep-2 depuis le fix d'hier) : les 16 pas s'enchainent sans
  accroc ni pas manquant, `CPU?` -> usage=11.6%/max=11.8%,
  memoire=133/141/200 blocs -- sain, coherent avec les mesures
  precedentes (8-15%).

**Confirme en reel pour la premiere fois** : le fix swing-max/CUT-
RETRIG, PROB:/COND:/FILL:, et le retour d'erreur protocole -- les 3
derniers points de l'audit du 2026-09-17, tous valides sur le vrai
Teensy. Reste a verifier : l'ecran ESP32 (pas encore branche a ce
stade de la session), donc les 2 nouvelles colonnes PRB/CND et le
retrecissement du panneau lateral.

**[2026-09-17, soir]** Nouvelle fonction tracker : **probabilite +
condition par pas** (PROB:/COND:/FILL:, voir AZ2_Protocol.h et
`SequencerTrack::stepProb/stepCondition` cote Teensy). Demandee par
l'utilisateur pour "faire un truc qui eclate tout" sur le tracker --
fonction la plus citee dans l'etude concurrence (AZ2_ETUDE_CONCURRENCE_
TRACKERS_GROOVEBOXES_2026.md) face a Elektron/Digitakt.

- Chaque pas ON garde son declenchement normal par defaut (prob=100%,
  cond=kStepCondAlways) -- **aucun changement de comportement sur un
  pattern existant** tant qu'on ne touche pas ces 2 nouveaux champs.
- Probabilite 0-100% : `random(100) < prob` a chaque passage, evalue
  dans `advanceTick()` (Teensy) avant de declencher le pas.
- Conditions "K sur N" (style Elektron, ex. 1:2/2:4/3:4) + FILL/!FILL,
  evaluees contre un compteur global de passages du pattern
  (`patternLoopCount`, incremente a chaque redemarrage de pattern) et
  un etat `fillActive` pilotable par `FILL:0/1`. Encodage sur un seul
  octet partage ESP32/Teensy (`az2::stepConditionEncode()`/
  `stepConditionMet()`/`stepConditionLabel()` dans AZ2_Protocol.h) pour
  ne pas dupliquer la logique.
- Cote ESP32 : 2 nouvelles colonnes tracker (PRB/CND), cycle
  `seqDetailCol` etendu de 4 a 6, echo `PROB:`/`COND:` mirrorees dans
  `seqStepProb[]`/`seqStepCondition[]`, format de sauvegarde projet
  etendu de 8 a 10 champs (retro-compatible : un ancien fichier a 8
  champs se relit avec prob=100/cond=0 par defaut).
- **PAS VERIFIE A L'ECRAN** (compile seulement, pas de materiel branche
  cette session) -- les 2 nouvelles colonnes retrecissent le panneau
  "patch actif" a droite du tracker de ~194px a ~106px (voir
  `kTrkSideX`/`kDetailProbW`/`kDetailCondW` dans `main.cpp`) : **premiere
  chose a regarder au prochain flash reel**, ajuster les largeurs si ca
  parait trop serre a l'oeil.
- Compile verifie pour les 3 environnements
  (`pio run -e master_teensy -e screen_esp -e ui_esp` -> SUCCESS).
- **BTN D = "fill" maintenu** -- **[2026-09-18 matin, corrige]** d'abord
  cable directement cote Teensy (`updateDigitalControls()`), mais en
  relisant le code au reveil : D a DEJA 2 sens existants selon l'ecran
  ESP32 affiche (page AUDIO : bascule clavier live/edition-pas ; page
  MOTEURS : bascule SOLO piste) -- le Teensy ne sachant PAS quel ecran
  est affiche, sa lecture directe de D aurait active "fill" en arriere-
  plan MEME en tenant D pour basculer solo/edition sur une autre page
  (silencieux tant qu'aucun pas n'a de condition FILL, mais un vrai
  piege des qu'on en programme un). Deplace cote ESP32 :
  `handleTeensyLine()` envoie `FILL:1` sur BTN:D:DOWN SEULEMENT si
  `currentScreen == Screen::Sequencer` (page ou D est libre), et
  `FILL:0` sur BTN:D:UP SANS condition d'ecran (pour ne jamais rester
  bloque a "actif" si on change de page en gardant D enfonce).
- `randomSeed(micros())` ajoute dans `setup()` Teensy (sinon `random()`
  rejoue exactement le meme motif a chaque mise sous tension).
- **Bug reel corrige** : `gbRecStart()` n'appelait pas `SD.remove()`
  avant `SD.open(path, FILE_WRITE)` -- sans consequence dans le cas
  normal (nextSampleName() trouve un nom LIBRE), mais dans le cas
  improbable ou les 999 noms `SAMPLE_NNN.wav` sont deja pris,
  `nextSampleName()` renvoie alors `SAMPLE_999.wav` en sachant qu'il
  existe deja -- `FILE_WRITE` sur SdFat OUVRE EN AJOUT sur un fichier
  existant (pas en ecrasement), donc la nouvelle capture se serait
  ajoutee APRES l'ancien contenu au lieu de le remplacer (wav corrompu/
  demesure). Note lors de l'audit du code du 2026-09-17 matin, deprioritise
  puis corrige ce soir (meme convention que savePatchSlot()/
  saveProject(), qui font deja ce remove()). Compile verifie.
- **Licence Synth_Braids resolue** : MIT confirme en lisant les entetes
  des fichiers vendored (Mutable Instruments, Emilie/Olivier Gillet) --
  voir AZ2_LICENCES.md, plus de point ouvert.
- **Premiers tests automatises AZ-2** (`env:native`, `test/
  test_protocol/`, voir "Tests et integration continue : absents"
  dans l'audit) : 9 tests unitaires sur la logique PURE de
  AZ2_Protocol.h (encodage PROB:/COND:, tables division/moteur/pad),
  tournent sur CETTE machine via `pio test -e native` (ArduinoFake
  fournit un Arduino.h factice, le header partage n'est pas modifie).
  `pio test -e native` -> 9/9 PASSED. Hors `default_envs`, n'affecte
  pas les 3 environnements materiels (recompiles avec succes juste
  apres pour confirmer).

**[2026-09-17, important pour toute future analyse externe]** `main`
etait reste fige au tout premier commit du projet (`b3eeae8`, 13
septembre -- Teensy = 134 lignes, un seul oscillateur sinus ; le
firmware ecran `src_esp32/az2_screen/` n'existait meme pas dessus)
pendant que ~140 commits de developpement reel se faisaient sur la
branche `az2-screen-engines-sequencer`. Un audit technique externe
("IA tierce") a ete lance contre `main` et a donc lu le code du jour 1
-- ses conclusions ("aucun sequenceur", "un seul moteur sinus", "aucune
interface ecran", "liaison non fonctionnelle") etaient vraies pour ce
commit-la mais fausses par rapport a l'etat reel du projet. `main` a
ete remis a jour le 2026-09-17 (fusion de `az2-screen-engines-
sequencer`, commit `419d110`) : les deux branches sont maintenant
alignees. **Toute IA/outil externe lance a l'avenir doit lire `main`
(ou `az2-screen-engines-sequencer`, identiques desormais) -- pas un
vieux commit** -- sinon le meme faux diagnostic se reproduira. Voir
`docs/AZ2_AUDIT_TECHNIQUE_COMPLET_2026-09-17.md`,
`AZ2_CIBLE_PRODUIT_ET_FEUILLE_DE_ROUTE_2026.md` et
`AZ2_ETUDE_CONCURRENCE_TRACKERS_GROOVEBOXES_2026.md` pour les 3
documents concernes -- leurs constats de code sont a relativiser pour
cette raison, mais leurs points d'hygiene de depot (pas de LICENSE
racine, pas de CI/tests, plateformes non figees, ~522 Mo dont 132 Mo
pour microdexed-touch) et leur vision produit (4 vues d'un meme
sequenceur, protocole verse/CRC/ack, etude concurrentielle M8/Polyend/
Elektron/etc.) restent valables et utiles independamment du bug de
branche.

**[2026-09-17, suite]** Chantier "hygiene du depot" demande par
l'utilisateur suite a l'audit externe ("on reste libre pour la licence
et on fait tout ce qu'il faut") :

- **Licence** : `LICENSE` (GPLv3) ajoute a la racine + inventaire complet
  dans `docs/AZ2_LICENCES.md` -- GPLv3 choisi parce que `Synth_MDA_EPiano`
  (moteur EPIANO, GPLv3 uniquement) est deja reellement compile dans le
  binaire `master_teensy`, ce n'etait donc pas un choix arbitraire.
  Point ouvert note dans ce doc : la licence de `Synth_Braids` n'est pas
  documentee dans ce vendoring, a verifier avant toute distribution
  binaire plus large.
- **Plateformes PlatformIO figees** : `platform = teensy` ->
  `teensy@6.0.0`, et les deux environnements ESP32 pointent maintenant
  explicitement vers le meme tag de release pioarduino
  (`55.03.311`) au lieu de l'alias mouvant `stable` (ou de
  `espressif32` nu, qui resolvait silencieusement vers ce meme fork
  installe localement -- pas reproductible tel quel sur une autre
  machine).
- **Dependance morte retiree** : `lvgl` (declaree dans `screen_esp`
  depuis le debut du projet, jamais utilisee -- 0 reference a `lv_`/
  `lvgl.h` dans `az2_screen/`, le menu/tracker sont dessines a la main
  via GFX Library for Arduino) + `include/lv_conf.h` (784 lignes,
  meme sort).
- **~89 Mo de bloat vendored supprimes** : 2 manuels PDF de
  MicroDexed-touch (66+3.2 Mo, doc de l'UI d'origine qu'on ne garde pas)
  et `drumsamples.h` (20 Mo, jamais compile). `retro-go-master`/
  `Launcher_lvgl-master` etaient deja supprimes avant.
- **CI ajoutee** (`.github/workflows/build.yml`) : compile les 3
  environnements (`master_teensy`, `screen_esp`, `ui_esp`) a chaque push/
  PR sur GitHub Actions. Ne remplace pas un test materiel, mais
  detecte automatiquement une regression de compilation au lieu de la
  decouvrir des semaines plus tard.

Compile verifie en local pour les 3 environnements apres tous ces
changements (`pio run -e master_teensy -e screen_esp -e ui_esp` ->
SUCCESS) avant de pousser.

**[Rafraichi le 2026-09-17]** -- ce document a commence comme un topo
ponctuel (2026-09-15) puis est devenu un journal chronologique (sections
datees plus bas, gardees pour l'historique). Les 3 sections qui suivent
resument l'etat REEL actuel ; pour le detail jour par jour, voir le
journal en dessous de "Journal de la nuit".

## Vue d'ensemble

AZ-2 est une groovebox modulaire a 2 cartes, orientee Game Boy/GBC :
- **Teensy 4.1** (`src_teensy/az2_audio/`) : moteur audio temps reel
  (5 synthes, filtre/ADSR/volume/mute/solo par piste), sequenceur/
  tracker, sampler (capture), MIDI IN, DAC I2S (PCM5102A), carte SD
  dediee (samples).
- **ESP32-S3** (`src_esp32/az2_screen/`) : ecran tactile 480x480 RGB
  parallele (carte VIEWE UEDX48480040E-WB), interface utilisateur,
  emulateur Game Boy/GBC, carte SD (ROMs, patches, projets).
- Liaison UART 230400 bauds entre les deux (Serial1 Teensy <->
  GPIO19/20 ESP32), protocole texte ligne par ligne + paquets binaires
  (audio GB, oscilloscope) -- partage via `lib/AZ2_Protocol/`.
- Croix + 4 boutons + 3 encodeurs rotatifs (avec bouton) cables
  directement sur le Teensy -- remplacent le Pico/matrice abandonnes
  le 2026-09-14.

## Ce qui marche et est CONFIRME en reel (verifie sur le vrai materiel)

- **Son** : 8 pistes, 5 moteurs, patch reel par moteur, filtre resonant
  par piste, ADSR par piste, bus d'effets maitre (reverb+delay), sortie
  DAC -- confirme audible.
- **Ecran** : affichage + tactile multi-doigt.
- **Lien UART** Teensy<->ESP32 (HELLO, echo d'etat complet).
- **Croix + boutons A/B/C/D + 3 encodeurs (bouton integre)** : cables
  et testes en reel.
- **Emulateur Game Boy/GBC** (Walnut-CGB) : ROM reelle testee (Tobu
  Tobu Girl), sauvegarde cart RAM sur SD.
- **Sampler, capture (phase 1)** : ecriture sur la carte SD DEDIEE du
  Teensy confirmee (`REC:START`/`REC:STOP` testes en serie).
- **Reglages Dexed (DXP:, algo/feedback)** : testes en serie.
- **Menu ecran** 4 categories, navigable croix+A/B+tactile.
- **Ecran de veille** ("matrix"), configurable.
- **Toolchain** `teensy_loader_cli` recompile depuis la source
  officielle -- fiable, plusieurs flashs reussis.

## Ce qui est CODE mais PAS ENCORE VERIFIE EN REEL

Tout ce qui suit compile mais n'a jamais ete flashe/entendu/vu depuis
son ecriture (la session du 2026-09-17 a ete faite sans aucun board
branche) -- **priorite au reveil du materiel : tout reverifier avant
d'ajouter quoi que ce soit d'autre** :

- **Mute/solo par piste** (boutons C/D, page MOTEURS).
- **Volume par piste** (page PATCH).
- **Sauvegarde/chargement de PROJET complet** (page PROJET).
- **MIDI notes IN** (jamais teste avec un vrai controleur).
- **Clavier tactile comme editeur live** (bouton D, page AUDIO).
- **Pagination de la liste de ROM** (16->40, defilement par pages de 8).
- **Bouton C pour quitter une partie GB**.
- Tracker : ticks/colonnes NOTE-INST-FX-VAL/chainage song/gammes --
  flashes et utilises depuis, stables.

## Bugs connus / limites actuelles

- Colonne **INST** (patch par pas) : stockee et transmise, **pas
  encore appliquee** au son reel (changer de patch Dexed est trop
  couteux pour tourner dans l'ISR du sequenceur).
- **Accords** (plusieurs notes par pas) : pas fait, plus gros que
  prevu -- voir AZ2_BENCHMARK_CONCURRENCE.md.
- **Swing/groove** : pas fait, piege timer/ISR trouve -- voir
  AZ2_FEUILLE_DE_ROUTE.md.
- **Sampler** : capture faite, PAS de lecture (pas de moteur
  `AudioPlaySdWav`/`AudioPlaySdRaw`), pas de vue d'onde/decoupage/
  nommage a l'ecran.
- **Pas de vrai panoramique** (chaine audio mono de bout en bout).
- **GitHub** : remote configure mais authentification pas encore
  etablie sur cette machine -- voir la section GitHub du journal.

## Journal de la nuit -- ce qui a ete fait

Ordre reel (pas tout a fait celui prevu au depart, un bug reel a pris
du temps a chasser -- voir plus bas) :

1. **[FAIT, teste en reel]** Couleurs par effet sur le tracker (grille
   + vue detail) -- une couleur par effet (ARP/CUT/RET), pastille sur
   la grille, fond teinte sur la vue detail. Compile, pas teste a
   l'oeil (ESP32 pas flashe cette nuit).
2. **[FAIT, teste en reel]** Filtre resonant par piste (`FILT:`,
   `AudioFilterStateVariable` -- Chamberlin SVF entier, tres bon
   marche en CPU). Insere entre chaque moteur et son mixeur de groupe.
   Teensy flashe, `CPU?` interroge : 8.6%/9.9% -- essentiellement
   identique a avant (8-15% deja mesure), les 8 filtres n'ajoutent
   presque rien. Grand ouvert par defaut (le constructeur de la lib
   partait a 1000Hz, corrige explicitement sinon toutes les pistes
   auraient ete etouffees des le premier boot).
3. **[FAIT, teste en reel]** ADSR editable par piste (`ENV:`), applique
   a `trackAnalogEnv[]` (seul moteur de la palette avec une vraie
   enveloppe generique exposable -- Dexed/EPiano ont leur propre
   comportement interne au patch, Braids/Karplus n'ont pas
   d'enveloppe). Teste : commande acceptee/relayee, CPU inchange.
4. **[FAIT, BUG REEL trouve et corrige, teste en reel]**
   Oscilloscope Teensy -> ESP32 (`SCOPE:`, meme principe de paquet
   binaire que le son GB mais dans l'autre sens). Premiere version
   **gelait completement le Teensy** des que PLAY et SCOPE tournaient
   en meme temps (plus aucune reponse serie du tout). Diagnostique
   methodiquement par bissection sur les commits precedents (tick
   rewrite seul OK, filtre seul OK, ADSR seul OK -- donc le bug etait
   forcement dans le scope non commite), puis isolation precise
   (connect() seul OK, begin() seul OK, les deux + audio reel qui
   circule = gel garanti). Cause : la boucle de purge appelait
   `freeBuffer()` SANS `readBuffer()` d'abord -- `freeBuffer()` ne fait
   RIEN si aucun bloc n'a ete lu, donc la boucle tournait a l'infini.
   Corrige, reteste plusieurs fois avec le sequenceur actif 5s+ en
   continu : CPU 10.6%, memoire audio saine (135-143/200 blocs), aucun
   gel. Cote ESP32 : page PATCH (selecteur de piste, tracer d'onde,
   6 reglages CUTOFF/RESONANCE/ATTACK/DECAY/SUSTAIN/RELEASE) codee et
   compilee, **jamais vue a l'ecran** (ESP32 pas flashe).
5. **[FAIT]** Gammes (verrouillage a la saisie) : 5 gammes (chromatique/
   majeur/mineur/pentatoniques, racine C fixe), reglage sur la page
   CONFIGURATION. `nextNoteInScale()` remplace le "+/-1 demi-ton" sur
   la croix (grille ET vue detail du sequenceur) -- saute a la
   prochaine note dans la gamme. Chromatique = comportement d'origine,
   retro-compatible par defaut. Cote ESP32 uniquement, rien cote
   Teensy. Compile, pas vu en reel.

Verification finale (fin de nuit) : `pio run -e master_teensy -e
screen_esp` -- les deux compilent ensemble sans erreur. Teensy
reinterroge une derniere fois : `CPU?` -> usage=9.4%/max=9.5%, memoire
132-144/200 blocs -- stable sur toute la nuit de tests.

## Etat au reveil -- ce qui reste

- **ESP32 jamais reflashe cette nuit** (mode boot manuel requis, acces
  physique). Tout ce qui est cote ecran depuis "Tracker : ticks
  internes..." (voir git log) n'a ete verifie qu'a la compilation :
  fix 8 pistes, vue detail tracker, couleurs d'effets, son GB au DAC
  (partie ESP32 qui envoie), page PATCH + oscilloscope, gammes. **Rien
  de tout ca n'a ete vu a l'oeil ni entendu.**
- **Teensy a jour et verifie en reel** pour tout : tick rewrite, filtre,
  ADSR, oscilloscope (bug corrige).
- Prochaine chose utile au reveil : mode boot manuel sur l'ESP32
  (BOOT maintenu + RESET + relacher BOOT), puis `pio run -e screen_esp
  -t upload --upload-port /dev/ttyUSB0`, puis verifier a l'oeil/a
  l'oreille tout ce qui precede.
- Pas commence : gammes/accords, clavier tactile comme editeur live,
  sauvegarde/chargement de projet (etapes 5-7 de
  `AZ2_TRACKER_ETUDE.md`), colonne INST reellement appliquee au son,
  chainage de patterns, role "gachette" pour C/D.

## Mise a jour 2026-09-16

Suite reflex demandee sur le panneau lateral du sequenceur ("on a acces
aux reglages du patch ? ... un bouton pour agrandir ... on doit pouvoir
sauvegarder les patchs ... un sampleur ... a integrer") :

- **Panneau "patch actif"** (`drawTrkSidePanel()`) : affiche desormais
  CUTOFF/RESONANCE + ADSR (ou ALGO/FEEDBACK pour une piste DEXED, voir
  plus bas) de la piste selectionnee, avec un bouton **AGRANDIR** qui
  ouvre la page PATCH complete pour cette piste.
- **Sauvegarde/chargement de patch** : page PATCH, ligne SLOT (0-7) +
  boutons SAVE/LOAD. Ecrit sur la carte SD de l'ESP32 dans
  `/patches/N.txt` (moteur, patch, cutoff, reso, ADSR, + algo/feedback
  Dexed). LOAD renvoie ENGINE:/PATCH:/FILT:/ENV:/DXP: au Teensy.
  **ESP32 reflashe et boot verifie propre en reel** (lien Teensy
  toujours vivant) ; **pas teste manuellement** (SAVE/LOAD pas encore
  touches a l'ecran par un humain).
- **Reglages propres a DEXED** (`DXP:`, demande "on n'a pas de reglages
  dans la fenetre dexed du tracker") : ADSR generique n'a jamais eu
  d'effet sur ce moteur (sa propre EG DX7 la remplace) -- page PATCH
  affiche maintenant ALGORITHME (1-32) et FEEDBACK (0-7) a la place pour
  une piste Dexed, lignes 4-5 grisees ("sans effet sur ce moteur").
  **Cote Teensy (`handleDexedParamCommand`) compile mais PAS FLASHE** --
  le Teensy n'etait pas accessible en USB depuis cette machine au
  moment du dev (relie a l'ESP32 par l'UART Serial1 seulement, ce qui
  explique le lien "TEENSY_AUDIO:READY" toujours vu au reboot ESP32).
  **[2026-09-17, confirme]** carte SD Teensy (`BUILTIN_SDCARD`) **PRESENTE
  et fonctionnelle** -- teste directement en serie (`REC:START` ->
  `REC:STARTED:/samples/SAMPLE_001.wav`, `REC:STOP` ->
  `REC:STOPPED:samples=0`, fichier cree avec succes). Plus de blocage
  materiel pour le sampleur -- reste a verifier le contenu audio reel
  (jouer un jeu pendant l'enregistrement, ecouter le .wav resultant).
  **[2026-09-17] Flashe et verifie en reel** : `CPU:usage=8.6%:max=9.9%`,
  `MEM:blocks=133:max=141/200` (identique aux mesures d'avant, aucune
  regression). `DXP:0:0:5`/`DXP:0:1:3` testes en direct par serie USB --
  bien relayes/appliques. Rechargement de patch (`PATCH:0:0`) confirme
  ecraser l'algo/feedback avec ceux de la banque (`DXP:0:0:4`/
  `DXP:0:1:0`), comportement voulu et documente.
- **Page MOTEURS, navigation croix** (demande "j'ai pas le controle
  joystick pour choisir et regler les moteurs") : HAUT/BAS choisissent
  la piste (surlignage blanc), GAUCHE/DROITE changent la valeur de la
  colonne au focus, BTN:A bascule le focus MOTEUR/PATCH. **ESP32
  reflashe, boot verifie propre**, comportement du tactile inchange
  (toujours utilisable en parallele).
- **Sampleur (moteur audio)** : PAS commence. Bloque tant qu'on n'a pas
  confirme une carte SD reellement presente dans le lecteur
  `BUILTIN_SDCARD` du Teensy (dernier statut connu : `SDTEENSY:
  NOT_PRESENT`) -- aucun fichier son n'existe encore, et un nouveau
  type de moteur (`AudioPlaySdWav`/`AudioPlaySdRaw`) + protocole de
  selection d'echantillon restent a concevoir. **Carte micro SD 58 Go
  preparee en FAT32 le 2026-09-16** (label `AZ2SAMPLES`, dossier
  `/samples/`) -- reste a l'inserer physiquement dans le lecteur du
  Teensy et confirmer `SDTEENSY:READY`.

## Journee du 2026-09-16 -- audit + recherche (utilisateur absent)

Demande : "tu as la journee pour faire des recherches sur nos
concurrents, liste des ameliorations indispensables, etat des lieux
logiciel/firmware, on optimise vitesse, on ameliore l'affichage, on
fait un job sur tout code mort, audit de code, mise a jour du GitHub,
presentation du projet et documentation". Boards absents (ni Teensy ni
ESP32 sur le bus USB de cette machine) -- tout ce qui suit est
**compile-verifie uniquement**, rien vu/entendu sur le vrai materiel
aujourd'hui.

- **Audit de code mort** : supprime `src_pico/` (Pico abandonne,
  cablage deja documente en prose ailleurs), `src_esp32/
  Launcher_lvgl-master/` (75 Mo vendores d'un exemple fournisseur,
  jamais reference dans le build), les stubs vides `src_esp32/main.cpp`
  et `src_teensy/main.cpp`, et `kHelloKeypad` (protocole) devenu
  orphelin. Verifie par grep avant suppression a chaque fois (rien
  d'autre ne referencait ces fichiers), et recompilation des 3
  environnements (`master_teensy`, `screen_esp`, `ui_esp`) apres coup.
  `src_esp32/az2_control/` (env `ui_esp`) et le gros dossier `src_teensy/
  microdexed-touch/` sont volontairement GARDES (reference active/
  bring-up isole documente comme tel, pas du code mort au meme sens que
  le Pico).
- **Petit bug UX corrige** : page MOTEURS, un toucher tactile ne
  deplacait pas le curseur croix -- desynchronisation possible entre
  tactile et croix. Corrige + recompile.
- **Recherche concurrence** : 2 machines ajoutees au comparatif
  (Teenage Engineering OP-XY, nanoloop) + 2 reverifiees (M8 Model:02,
  Polyend Tracker Mini) -- voir AZ2_BENCHMARK_CONCURRENCE.md pour le
  detail et les sources. Liste d'ameliorations indispensables priorisee
  ajoutee (mute/solo, sauvegarde de projet complet, swing, volume/pan
  par piste, sampler, MIDI, accords, clavier live).
- **Feuille de route** : ajout d'une "Phase 8" qui reprend cette liste
  priorisee, plus un tableau qui fait correspondre les vieilles phases
  0-7 (matrice/Pico/Retro-Go, plus d'actualite) a ce qui existe
  reellement aujourd'hui.
- **README.md** : entierement reecrit -- decrivait encore la matrice
  SparkFun 4x4 et le Pico comme actifs, en anglais, sans lien vers la
  moitie des docs recentes (tracker, etat des lieux, cablage master).
- **Performance** : revue du code (Teensy hot-path, boucles de dessin
  ESP32) -- pas de probleme flagrant trouve. Les redessins sont deja
  partiels (ligne par ligne sur MOTEURS/PATCH/sequenceur, tracer
  d'oscilloscope decime+limite en frequence). Usage de `String` pour le
  parsing des commandes serie (cote Teensy et ESP32) : design deja en
  place depuis le debut du projet, fonctionne dans la marge CPU/memoire
  mesuree (~9-10%, 130-144/200 blocs audio) -- **pas touche** sans
  materiel pour verifier un changement aussi central sans risque de
  regression invisible tant que personne ne peut tester en reel.
- **GitHub** : **bloque**. Le remote `origin` (github.com/propann/
  L-AZ-2) est configure mais aucune methode d'authentification
  disponible sur cette machine (pas de `gh auth login`, pas de jeton
  `GH_TOKEN`, pas de credential helper git) -- `git push` echoue avec
  "could not read Username". La branche `az2-screen-engines-sequencer`
  est 33+ commits devant `origin/main`, jamais poussee. Necessite une
  action de l'utilisateur (`gh auth login` ou jeton personnel) pour
  debloquer.

## Journee du 2026-09-17 -- emulateur GB + sampler phase 1

- **Verification du mapping manette GB** : Start/Select (encodeurs 1/2)
  confirmes deja en place depuis le 2026-09-15. Tous les boutons d'une
  vraie Game Boy couverts.
- **[FAIT, flashe, teste en reel]** Bouton **C** pour quitter une
  partie en cours (`goTo(Screen::Menu)`, sauvegarde la RAM cartouche).
  Page A PROPOS mise a jour avec le mapping complet.
- **[FAIT, flashe]** Pagination de la liste de ROM : `kGbMaxRoms` 16 ->
  40, affichage par pages de 8 avec fleches </> -- suite a l'ajout de
  34 jeux perso sur la carte SD ESP32 (Zelda, Mario, Tetris, Pokemon,
  Kirby, Wario, etc., copies depuis une cle USB personnelle, PAS dans
  le depot git).
- **[FAIT, flashe, PARTIELLEMENT teste]** Sampler GB phase 1
  (REC/STOP) : encodeur 0 declenche l'enregistrement, capture le son
  GB natif (8kHz) dans un `.wav` sur la SD DEDIEE du Teensy. **Ecriture
  SD confirmee en reel** (`REC:START`/`REC:STOP` testes directement en
  serie, fichier cree avec succes). **Pas encore teste avec un vrai
  jeu qui joue du son** (0 echantillon capture lors du test, aucune ROM
  chargee a ce moment) -- prochaine etape : enregistrer pendant une
  vraie partie et ecouter le fichier resultant.
- Phase 2/3 du sampler (vue d'onde en direct, decoupage tactile,
  decoupage automatique, clavier de nom, moteur de lecture) : pas
  commencees, detaillees dans AZ2_FEUILLE_DE_ROUTE.md.

## Teensy reflashe et VERIFIE EN REEL (2026-09-17, soir)

Tout le paquet du jour (mute/solo, volume, sauvegarde de projet, MIDI
IN, swing, sampler) flashe sur le Teensy et teste directement en
serie :

- Boot propre, `CPU:usage=8.6%:max=9.9%`, `MEM:blocks=133:max=141/200`
  -- identique a avant tous ces ajouts, aucune regression.
- `SWING:64`, `MUTE:0:1/0`, `SOLO:0:1/0`, `VOL:0:100` : tous acceptes
  et relayes correctement.
- **Test critique swing** : `SWING:96` (quasi maximum) puis `PLAY`
  pendant 5 secondes -- le sequenceur a avance plusieurs mesures sans
  aucun gel, CPU/memoire strictement identiques a l'avant. Tempo moyen
  visuellement correct (progression des CLOCK: coherente avec le BPM
  malgre l'asymetrie forte des pas). **Le mecanisme "ticksForCurrentStep
  variable, timer jamais reconfigure" tient la route en reel.**
- `REC:START`/`REC:STOP` (sampler) toujours fonctionnel apres tous ces
  ajouts (`SAMPLE_002.wav` cree).

**Mute/solo sur une piste Braids en train de jouer une note tenue**
(le cas precis que le piege d'origine aurait casse) : PAS ENCORE testE
manuellement (demande de jouer une note et de mute/demute pendant
qu'elle sonne, pas juste d'envoyer les commandes a vide) -- a faire au
prochain test avec le son.

## Audit complet du code (2026-09-17)

Relecture ligne par ligne des 2 firmwares + protocole (~6800 lignes)
demandee par l'utilisateur pour recouper avec des analyses d'autres IA.
3 corrections rapides appliquees (sans risque, pas besoin de materiel) :

- **Message trompeur a l'ecran** : la page JEUX sans ROM disait encore
  "Pas de son pour l'instant" -- corrige (le son GB fonctionne depuis
  longtemps).
- **Code mort** : `kRecToggle` (AZ2_Protocol.h) jamais utilise nulle
  part, decrivait en plus une convention ("toggle") differente de celle
  reellement implementee (REC:START/REC:STOP explicites) -- supprime.
- **Commentaire trompeur** : `handlePatternCommand()` disait qu'un
  changement de pattern edite est "effectif au prochain pas" -- en
  realite `advanceTick()` ne bascule qu'au prochain redemarrage de
  pattern (jusqu'a 16 pas plus tard), pas au pas suivant. Comportement
  voulu, juste le commentaire corrige.

3 points restants, notes pour plus tard (pas de risque immediat) :
setup() ESP32 s'arrete net si l'ecran ne s'initialise pas (Teensy/SD
jamais inities dans ce cas) ; aucune commande Teensy hors bornes ne
renvoie d'erreur (silencieusement ignoree) ; a swing maximum, les pas
raccourcis (1 tick) ne laissent plus de fenetre aux effets CUT/RETRIG.

**2026-09-17 (suite) -- 1er point corrige** : `setup()` ESP32 continue
maintenant Serial1 (lien Teensy)/tactile/SD meme si `gfx->begin()`
echoue -- seuls l'intro et le premier affichage (qui ont besoin de
l'ecran) sont sautes. Avant, un ecran en panne coupait aussi tout
diagnostic serie du Teensy/tactile/SD, avec une seule ligne
`DISPLAY:ERROR:BEGIN_FAILED` comme unique symptome. Compile verifie
(`pio run -e screen_esp`) ; a verifier sur materiel reel le jour ou
l'ecran a un vrai probleme d'init (pas teste, pas facile a provoquer
sans debrancher l'ecran expres).

**2026-09-17 (suite) -- 2e point corrige (retour d'erreur cote
protocole)** : les ~22 handlers de commandes texte cote Teensy
(STEP/NOTE/INST/SFX/PATTERN/SONGSET/SONGLEN/SONGMODE/BPM/DIV/SWING/
ENGINE/PATCH/FX/VOL/MUTE/SOLO/FILT/ENV/DXP/SCOPE/PAD/MACRO) qui
ignoraient silencieusement une commande malformee ou hors bornes
envoient maintenant `<COMMANDE>:ERROR:<raison>` (raison =
`MALFORMED`, `OUT_OF_RANGE` ou `UNKNOWN_PARAM`/`UNKNOWN_INDEX` selon le
cas) sur Serial (USB) ET Serial1 (vers l'ESP32) via le nouveau helper
`sendCommandError()`. Reprend la convention deja existante pour
`REC:ERROR:` (gbRecStart()), ne l'invente pas. L'ESP32 ne traite pas
encore ces lignes specifiquement (il ignore deja les lignes non
reconnues, donc rien ne casse), mais elles sont visibles au moins sur
le moniteur serie USB du Teensy des maintenant -- suffisant pour le
diagnostic manuel/les recoupements d'analyse en cours. Compile verifie
(`pio run -e master_teensy`) ; pas de changement de comportement sur
le chemin valide (memes conditions de validation qu'avant, juste un
message en plus quand ca echoue) -- a confirmer sur materiel avec de
vraies commandes hors bornes envoyees depuis l'ESP32/un script de test.
SWING:/SONGMODE:/MACRO: n'ont qu'une erreur "MALFORMED" (ligne sans le
bon nombre de `:`) : SWING clampe deja sa valeur (comportement voulu,
pas une erreur), SONGMODE n'a pas de plage a valider (0/tout le reste
= false), MACRO n'agit que sur l'index 1 pour l'instant (les autres
index sont "pas encore cable", pas "invalide").

**2026-09-17 (suite) -- 3e point corrige (fenetre CUT/RETRIG a swing
max)** : confirme le mecanisme exact du bug. `triggerStepFx()` (ARP/
CUT/RETRIG) n'est appelee QUE dans la branche `else` (`currentTick !=
0`) d'`advanceTick()`. Avec l'ancien plafond (`swingAmount` jusqu'a
`kTicksPerStep-1` = 3), un pas pair au swing maximum tombait a
`ticksForCurrentStep = 1` : `currentTick` valait alors toujours 0
pendant tout le pas, donc cette branche `else` n'etait JAMAIS executee
-- un CUT ou un RETRIG pose sur ce pas ne se declenchait plus du tout
(le son jouait entier, coupe seulement par l'`allTrackNotesOff()`
normal du pas suivant). Fix : plafonne `swingAmount` a
`kTicksPerStep-2` (jamais moins de 2 ticks par pas) dans
`handleSwingCommand()` -- garantit au moins UN passage dans la branche
`else` par pas, donc au moins une chance pour CUT/RETRIG de s'appliquer
meme sur le pas le plus raccourci. Cout : perd le tout dernier cran de
swing le plus extreme (127/127 sur l'echelle UI) -- c'etait justement
celui qui cassait CUT/RETRIG, aucun autre effet de bord attendu.
Compile verifie (`pio run -e master_teensy`) ; **a confirmer a
l'oreille sur materiel reel** (poser un CUT ou un RETRIG serre sur un
pas pair, monter le swing au maximum, verifier que l'effet continue de
s'entendre au lieu de disparaitre).

Piste specifiquement verifiee et ECARTEE : `frame_skip` (Walnut-CGB)
pourrait desynchroniser l'audio de la vitesse du jeu -- verifie dans le
code source (`walnut_cgb.h`, VBlank pose `gb->gb_frame=true` a CHAQUE
frame reelle quel que soit `frame_skip`, qui ne saute QUE le rendu
pixel) : pas de bug la-dedans, confirme.

### Menage supplementaire : mentions du pad 4x4 (demande separee)

Passage dedie sur toutes les mentions de la matrice SparkFun 4x4/Pico
(hardware abandonne le 2026-09-14) pour verifier qu'aucune ne pretend a
tort etre le hardware actuel :

- Code et docs actifs (`main.cpp` ESP32/Teensy, `AZ2_Protocol.h`,
  `README.md`, `AZ2_CABLAGE_MASTER.md`, `platformio.ini`) : deja propres
  ou deja correctement marques "ABANDONNE" -- rien a faire.
- `AZ2_FEUILLE_DE_ROUTE.md` : la section "Phase 3 - Matrice SparkFun
  4x4" (plan d'origine) n'etait annotee comme abandonnee que bien plus
  bas dans le document (section "Mise a jour 2026-09-16") -- un lecteur
  qui lit dans l'ordre pouvait la croire encore active. Ajoute un
  avertissement direct sur la section elle-meme.
- `AZ2_PORTAGE_MICRODEXED_TOUCH.md` : contrairement aux autres docs de
  planification precoce (ECRAN_FACADE, ARCHITECTURE_FIRMWARE_DOUBLE,
  ESP32_CONTROLE_WIFI_SD_RETRO), celui-ci n'avait PAS recu de note
  "perime" alors qu'il presente la matrice 4x4 comme le controle retenu
  -- note ajoutee en tete de fichier.
- `src_esp32/az2_control/main.cpp` (environnement `ui_esp`, garde comme
  reference isolee, hors `default_envs`) : implemente reellement le
  scan mux 4x4 (`AZ2:FEATURE:SPARKFUN_4X4_MATRIX` etc.), donc le code
  n'est pas faux en soi, mais rien dans le fichier ne disait que ce
  hardware est abandonne et que ce n'est pas le firmware ESP32 shippe --
  commentaire d'entete ajoute pour clarifier. Compile verifie
  (`pio run -e ui_esp`), pas de changement de comportement.

## Bugs reels trouves en jouant (2026-09-17, utilisateur de retour)

Premier vrai test manette en main apres le flash de l'ESP32 -- 2 bugs
reels rapportes et corriges dans la foulee :

1. **"je peux pas selectionner une ROM avec la croix et A/B, avoir le
   nom en surbrillance"** -- la croix sur la page JEUX etait TOUJOURS
   routee vers `gbSetButton()` (boutons du jeu), meme quand aucune ROM
   n'etait encore chargee : aucune navigation clavier n'atteignait
   jamais la liste. Corrige : `selectedRomIndex` + surbrillance (meme
   convention que la piste choisie sur la page MOTEURS), HAUT/BAS
   deplacent la selection (suit le defilement automatiquement), A
   charge la ROM selectionnee. `gbSetButton()`/le mapping A/B ne
   s'activent plus que si une partie est REELLEMENT en cours
   (`gbIsLoaded()`), pas juste "page JEUX affichee".
2. **"bug d'affichage quand ca commence a demarrer l'emulation"** --
   trouve : `drawLinkStatus()` (bandeau "TEENSY: relie" en bas de
   l'ecran, `kStatusY = 450`) chevauche le bas de l'image du jeu
   (celle-ci va de y=24 a y=456, voir `gbBlitLine()`). Cette fonction
   est appelee a CHAQUE ligne recue du Teensy, y compris `STATUS:`
   envoye ~1x/seconde en continu -- une barre noire + texte
   s'incrustait donc sur le bas de l'ecran de jeu toutes les secondes
   pendant qu'une partie tournait. Corrige : exclue quand
   `currentScreen==Screen::Retro && gbIsLoaded()`, meme famille
   d'exclusion que Controls/Links deja en place.

Compile verifie, **pas encore reflashe** au moment d'ecrire cette
entree -- ESP32 deconnecte entre le rapport de bug et le fix.

## Suite du 2026-09-17 -- 5 des 8 priorites indispensables faites

Utilisateur parti travailler ("on attaque la feuille de route, avance
un max"). Boards absents de cette machine tout le long -- **tout ce qui
suit est compile-verifie uniquement**, rien vu/entendu sur le vrai
materiel :

1. **Mute/solo par piste [FAIT]** -- le piege Braids (gain de groupe =
   porte note-on/off) resolu proprement via `trackNoteHeld[]` +
   `applyGroupGainNow()` : mute/demute immediat meme sur une note
   Braids tenue. Boutons C/D (page MOTEURS).
2. **Sauvegarde/chargement de projet complet [FAIT]** -- page PROJET,
   4 emplacements, patterns+song+tempo+gamme+moteurs+mute (pas solo).
   Purement ESP32, zero risque audio.
3. Swing/groove -- **pas fait** (piege timer trouve, voir feuille de
   route).
4. **Volume par piste [FAIT]** -- meme mecanisme que mute/solo (memes
   fonctions `applyGroupGainNow()`/`trackEffectiveGain()`). Pan pas
   fait (chaine mono de bout en bout).
5. Sampler -- **phase 1 confirmee en reel hier** (ecriture SD testee),
   phases 2/3 (vue d'onde, decoupage, nommage) pas commencees.
6. **MIDI notes IN [FAIT]** -- MVP, route vers la voix live
   (`liveVoice`), `USB_MIDI_SERIAL` dormait dans platformio.ini depuis
   le debut du projet. Pas de synchro horloge, pas de MIDI OUT.
7. Accords -- **pas fait** (plus gros que prevu, touche le meme code
   que le bug de gel deja rencontre cette session).
8. **Clavier tactile comme editeur live [FAIT]** -- bouton D (page
   AUDIO) bascule "jouer en direct"/"poser sur le pas selectionne".

Reste vraiment a faire, dans l'ordre : tester TOUT ce qui precede en
reel des que les boards sont disponibles (rien n'a ete verifie
aujourd'hui, seulement compile), puis swing et accords (les deux
demandent du soin sur le vrai materiel a cause des pieges trouves),
puis le sampler phase 2/3 (design UI a faire avec l'ecran sous les
yeux).
