propann/L-AZ-2/src_teensy/microdexed-touch/stl/microdexed-BOTTOM-FDM.png

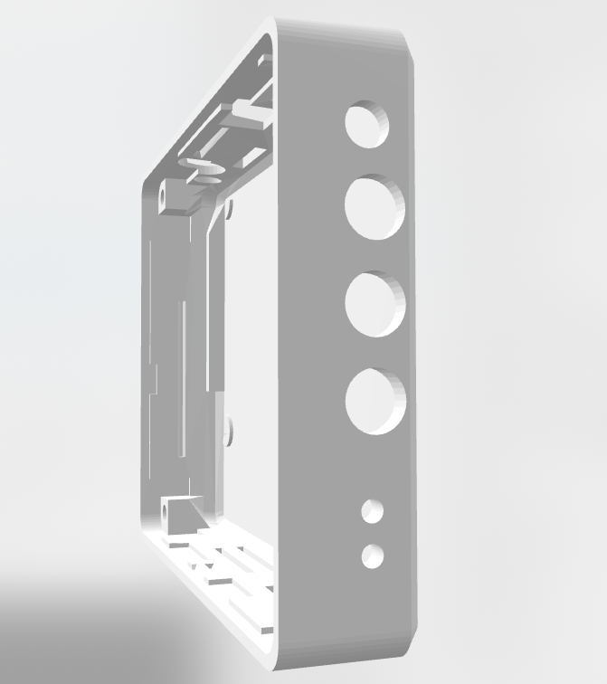
src_teensy/microdexed-touch/stl/microdexed-BOTTOM-FDM.png
