propann/L-AZ-2/src_teensy/microdexed-touch/stl/microdexed-FDM-encoder_cap.stl

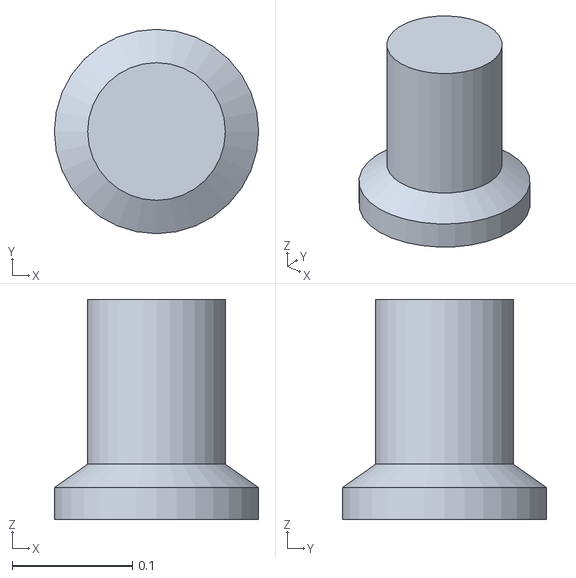
[picture p5: CAD file, 2026-01-12]
src_teensy/microdexed-touch/stl/microdexed-FDM-encoder_cap.stl
0.17 x 0.17 x 0.183
