propann/L-AZ-2/src_teensy/microdexed-touch/stl/UserModifications/LID_MOD.stl

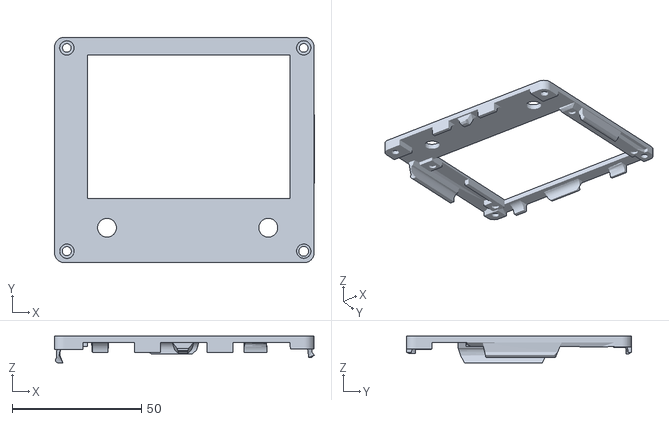
[picture p6: CAD file, 2026-01-12]
src_teensy/microdexed-touch/stl/UserModifications/LID_MOD.stl
100.7 x 87.3 x 10.4
