propann/L-AZ-2/src_teensy/microdexed-touch/stl/microdexed-short-encoder_cap.stl

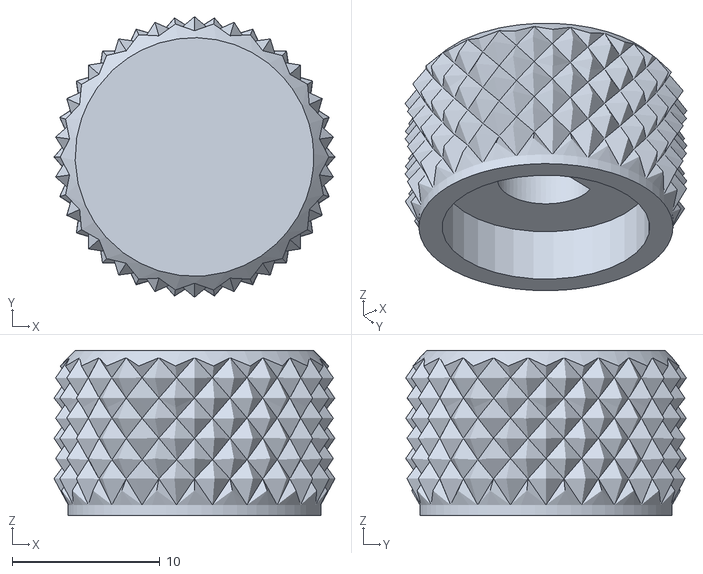
[picture p7: CAD file, 2026-01-12]
src_teensy/microdexed-touch/stl/microdexed-short-encoder_cap.stl
19.0 x 19.0 x 11.2
