propann/L-AZ-2/src_teensy/microdexed-touch/stl/UserModifications/push_switch_cap.stl

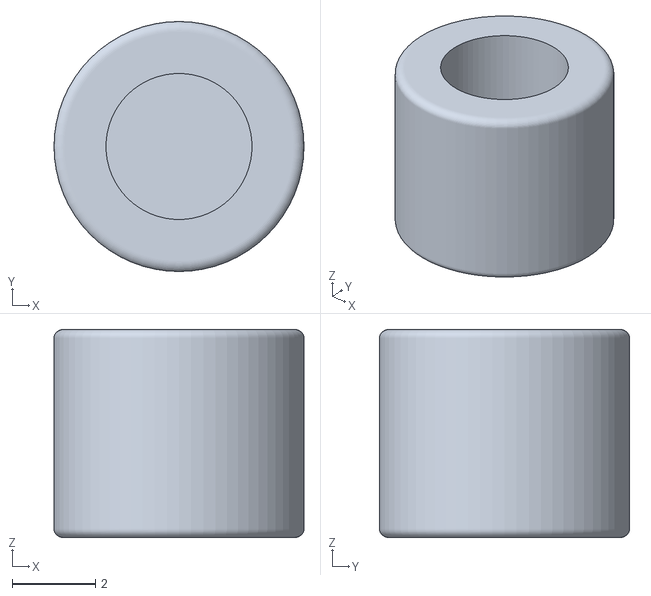
[picture p8: CAD file, 2026-01-12]
src_teensy/microdexed-touch/stl/UserModifications/push_switch_cap.stl
6.00 x 6.00 x 5.00
