propann/L-AZ-2/src_teensy/microdexed-touch/stl/microdexed-LID-28-FDM-NoLogo.stl

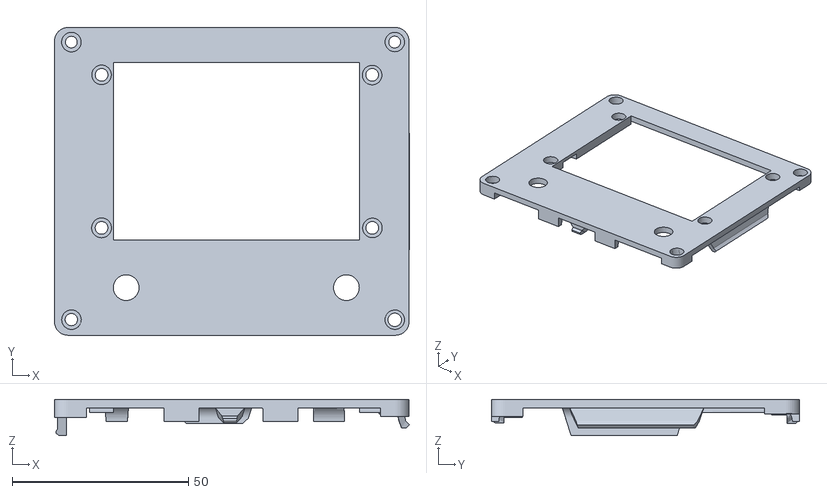
[picture p9: CAD file, 2026-01-12]
src_teensy/microdexed-touch/stl/microdexed-LID-28-FDM-NoLogo.stl
100.7 x 87.3 x 10.4
