propann/L-AZ-2/src_teensy/microdexed-touch/stl/sla-bottom.stl

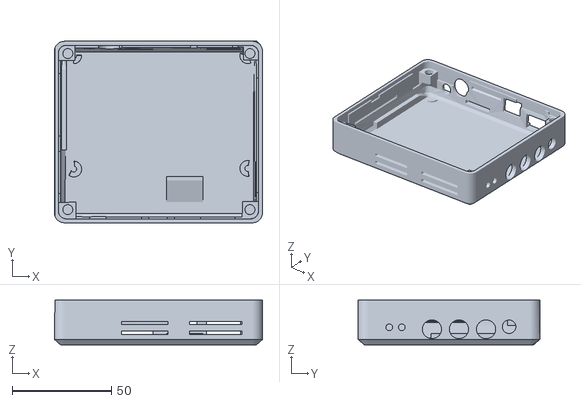
[picture p10: CAD file, 2026-01-12]
src_teensy/microdexed-touch/stl/sla-bottom.stl
104.9 x 91.6 x 22.5
