propann/L-AZ-2/src_teensy/microdexed-touch/stl/microdexed-short-encoder_cap-plain.stl

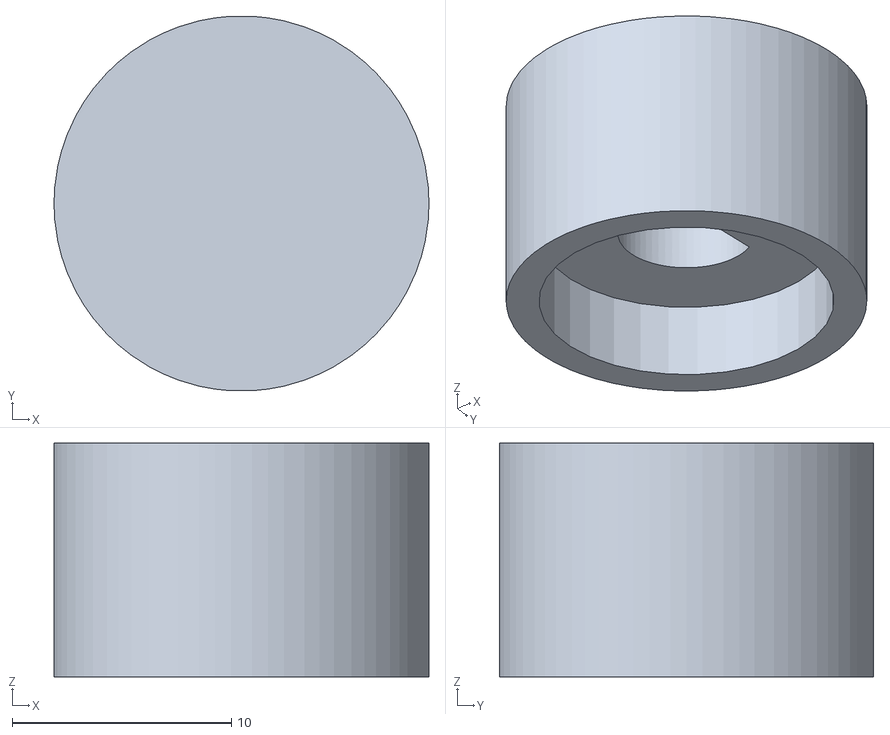
[picture p11: CAD file, 2026-01-12]
src_teensy/microdexed-touch/stl/microdexed-short-encoder_cap-plain.stl
17.1 x 17.1 x 10.7
