propann/L-AZ-2/(list of files, cad)

Other CAD files:
src_teensy/microdexed-touch/stl/microdexed-LID-32-FDM-WithLogo.stl
src_teensy/microdexed-touch/stl/microdexed-LID-28-FDM-WithLogo.stl
src_teensy/microdexed-touch/stl/microdexed-BOTTOM-FDM.stl
src_teensy/microdexed-touch/stl/microdexed-LID-32-FDM-NoLogo.stl
