propann/L-AZ-2/src_teensy/microdexed-touch/MicroDexed-touch/config.h

#pragma once
#include <Arduino.h>
#include "midinotes.h"
#include "teensy_board_detection.h"
#include <vector>
#define DBG_LOG(s)
#include "version.h"
#if defined APC
#define APC_NUM_PADS 64
#endif
#define MIDI_DEVICE_DIN Serial1
#define MIDI_DEVICE_USB 1
#define MIDI_DEVICE_USB_HOST
#define I2S_AUDIO_ONLY // for PCM5102 or other I2S DACs
#define DEFAULT_MIDI_CHANNEL MIDI_CHANNEL_OMNI
#define SYSEXBANK_DEFAULT 0
#define SYSEXSOUND_DEFAULT 0
#define SERIAL_SPEED 230400
#define SHOW_CPU_LOAD_MSEC 5000
#if !defined(COMPILE_FOR_PROGMEM) && !defined(COMPILE_FOR_SDCARD) && !defined(COMPILE_FOR_PSRAM)
#define COMPILE_FOR_PROGMEM // legacy (outdated)
#endif
#ifndef CAPACITIVE_TOUCH_DISPLAY // TFT with Capacitive Touchscreen (default)
#define GENERIC_DISPLAY // generic/noname ILI941 TFT + XPT2046 Touchscreen (outdated)
#endif
#define NUM_DEXED 2
#define DEFAULT_DEXED_MIDI_CHANNEL_INST0 1
#define DEFAULT_DEXED_MIDI_CHANNEL_INST1 2
#define DEFAULT_DEXED_MIDI_CHANNEL_INST2 3
#define DEFAULT_DEXED_MIDI_CHANNEL_INST3 4
#ifdef GRANULAR
#define DEFAULT_GRANULAR_MIDI_CHANNEL 11
#endif
#define NUM_DRUMS 8 // set 0 to disable Drums
#define DEFAULT_DRUM_MIDI_CHANNEL 10
#define NUM_CUSTOM_MIDI_MAPPINGS 18 // Number of Custom Key, CC and Button Mappings
#define NUM_CUSTOM_SAMPLES 20
#define NUM_STATIC_PITCHED_SAMPLES 6
#define NUM_DRUMSET_CONFIG 71 + NUM_CUSTOM_SAMPLES
#define NUM_SEQ_PATTERN 32
#define NUM_SEQ_TRACKS 8
#define SONG_LENGTH 64
#define NUM_CHAINS 32
#define NUM_EPIANO_VOICES 16
#define DEFAULT_EP_MIDI_CHANNEL 5
#define NUM_MICROSYNTH 2
#define DEFAULT_MICROSYNTH_MIDI_CHANNEL_INST0 6
#define DEFAULT_MICROSYNTH_MIDI_CHANNEL_INST1 7
#define NUM_BRAIDS 8
#define DEFAULT_BRAIDS_MIDI_CHANNEL 8
#define NUM_MULTISAMPLES 2
#define NUM_MULTISAMPLE_ZONES 8
#define DEFAULT_MSP_MIDI_CHANNEL_INST0 11
#define DEFAULT_MSP_MIDI_CHANNEL_INST1 12
#define VIRT_KEYB_YPOS 166
#define MOD_DELAY_SAMPLE_BUFFER int32_t(TIME_MS2SAMPLES(15.0)) // 15.0 ms delay buffer.
#define MOD_WAVEFORM WAVEFORM_TRIANGLE                         // WAVEFORM_SINE WAVEFORM_TRIANGLE WAVEFORM_SAWTOOTH WAVEFORM_SAWTOOTH_REVERSE
#define MOD_FILTER_OUTPUT MOD_BUTTERWORTH_FILTER_OUTPUT        // MOD_LINKWITZ_RILEY_FILTER_OUTPUT MOD_BUTTERWORTH_FILTER_OUTPUT MOD_NO_FILTER_OUTPUT
#define MOD_FILTER_CUTOFF_HZ 2000
#define byte __uint8_t // workarounds "error: reference to 'byte' is ambiguous"
#define DELAY_MAX_TIME 500  // 0.5s
#define SAMPLE_RATE 44100
#define AUDIO_MEM SAMPLE_RATE *NUM_DEXED *DELAY_MAX_TIME / 128000 + 36 + 14
#define COLOR_BACKGROUND 0x0000
#define COLOR_SYSTEXT 0xFFFF
#define DX_DARKCYAN 0x030D
#define COLOR_INSTR 0x7BBD
#define COLOR_CHORDS 0xE2FA
#define COLOR_ARP 0xFC80
#define COLOR_DRUMS 0xFE4F
#define COLOR_PITCHSMP 0x159A
#define RED 0xD000
#define PINK 0xF81F
#define YELLOW 0xFFEB
#define GREEN 0x07E0
#define MIDDLEGREEN 0x1500
#define DARKGREEN 0x0AE0
#define GREY1 0xC638
#define GREY2 0x52AA
#define GREY3 0x2104
#define GREY4 0x10A2
const char back_text[5] = { 'B', 'A', 'C', 'K' };
const char back_clear[5] = { ' ', ' ', ' ', ' ' };
#define TFT_WIDTH 240
#define TFT_HEIGHT 320
#define DISPLAY_WIDTH 320
#define DISPLAY_HEIGHT 240
#define display_cols 20
#ifdef TOUCH_UI
#define display_rows 16
#else
#define display_rows 6
#endif
#define CHAR_width 12
#define CHAR_height 17
#define CHAR_width_small 6
#define CHAR_height_small 8
#define button_size_x 7
#define button_size_y 4
#define TFT_DC 37
#define TFT_CS 41
#define TFT_RST 24
#define TFT_SCK 27
#if defined GENERIC_DISPLAY
#define TFT_MISO 39
#endif
#define TFT_MOSI 26
#define TFT_TOUCH_IRQ 33
#if defined GENERIC_DISPLAY
#define TFT_TOUCH_CS 38
#endif
#define VOICE_SELECTION_MS 60000
#define BACK_FROM_VOLUME_MS 2000
#define MESSAGE_WAIT_TIME 1000
#define MIDI_DECAY_TIMER 50
#if (defined RGB_ENCODERS && defined MCP_23008) || (defined RGB_ENCODERS && defined MCP_23017)
#define RGB_LED_L_RED 0                            // MCP GPA0  = LED_ENC_L RED
#define RGB_LED_L_GREEN 1                          // MCP GPA1  = LED_ENC_L GREEN
#define RGB_LED_L_BLUE 2                           // MCP GPA2  = LED_ENC_L BLUE
#define RGB_LED_R_RED 3                            // MCP GPA3  = LED_ENC_R RED
#define RGB_LED_R_GREEN 4                          // MCP GPA4  = LED_ENC_R GREEN
#define RGB_LED_R_BLUE 5                           // MCP GPA5  = LED_ENC_R BLUE
#endif
#if (defined BUTTON_LEDS && defined MCP_23008) || (defined BUTTON_LEDS && defined MCP_23017)
#define LED_UP 8                                   // MCP GPB0  = LED Button UP
#define LED_DOWN 9                                 // MCP GPB1  = LED Button DOWN
#define LED_LEFT 10                                // MCP GPB2  = LED Button LEFT
#define LED_RIGHT 11                                // MCP GPB3  = LED Button RIGHT
#define LED_SEL 12                                  // MCP GPB4   = LED Button SEL
#define LED_START 13                                // MCP GPB5  = LED Button START
#define LED_BUT_A 14                                // MCP GPB6  = LED Button A
#define LED_BUT_B 15                                // MCP GPB7  = LED Button B
#endif
#define NUM_ENCODER 2
#define ENC_L_PIN_A 32
#define ENC_L_PIN_B 31
#define BUT_L_PIN 30
#define ENC_R_PIN_A 28
#define ENC_R_PIN_B 29
#define BUT_R_PIN 25
#define BUT_DEBOUNCE_MS 20
#define LONG_BUTTON_PRESS 500
#define AUTOSTORE_MS 5000
#define DEXED_POOLS 100
#define DEXED_CONFIG_PATH "DEXED"
#define FAV_CONFIG_PATH "FAVCFG"
#define MAX_BANKS 100
#define MAX_VOICES 32     // voices per bank
#define BANK_NAME_LEN 12  // 10 (plus '\0')  //changed to 12 for save single voice to .syx bank filename issue
#define VOICE_NAME_LEN 12 // 11 (plus '\0')
#define FILENAME_LEN BANK_NAME_LEN + VOICE_NAME_LEN
#define CONFIG_FILENAME_LEN 50
#define FILENAME_MAX_LEN 17
#define FULLPATH_MAX_LEN 64
#define PERFORMANCE_CONFIG_PATH "PERFORMANCE"
#define SEQUENCER_CONFIG_NAME "sequencer"
#define DRUMS_CONFIG_NAME "drums"
#define DRUMS_MAPPING_NAME "drmmap"
#define PATTERN_CONFIG_NAME "patterns"
#define VELOCITY_CONFIG_NAME "velocity"
#define CHAIN_CONFIG_NAME "chain"
#define TRANSPOSE_CONFIG_NAME "transp"
#define SONG_CONFIG_NAME "song"
#define FX_CONFIG_NAME "fx"
#define VOICE_CONFIG_NAME "voice"
#define SYS_CONFIG_NAME "sys"
#define CONFIG_NOISEMAKER "nm_config"
#define EPIANO_CONFIG_NAME "epiano"
#define MICROSYNTH_CONFIG_NAME "msynth"
#define MULTISAMPLE_PRESETS_CONFIG_NAME "msp_presets"
#define BRAIDS_CONFIG_NAME "braids"
#define MULTIBAND_CONFIG_NAME "mb_comp"
#define SIDECHAIN_CONFIG_NAME "sc"
#define LIVESEQUENCER_CONFIG_NAME "liveseq"
#define SAMPLES_CONFIG_NAME "samples"
#define SLICES_CONFIG_NAME "slices"
#define ENVELOPES_CONFIG_NAME "envelope"
#define MAX_PERF_MOD 50
#define MAX_FILES 150
#define PCM5102_MUTE_PIN 34 // hardware pin for PCM5102 XSMT soft mute function
#define AUDIO_DEVICE_USB
#ifdef MUSIKANDMORE
#define MCP_INTA 8
#define ANALOG_VOLUME_IN 15
#define CV_CLOCK_IN 22
#define CV_CLOCK_OUT 39
#define TRS_PEDAL_IN 23
#define GATE_OUT 14
#endif
#if defined(MUSIKANDMORE) || defined(SECOND_SD)
#define GEN3_CS_SDCARD_EXTERNAL 35
#endif
#define CONTROL_RATE_MS 50
#define MICROSYNTH_CONTROL_RATE_MS 30
#define BRAIDS_CONTROL_RATE_MS 30
#define SAVE_SYS_MS 5000
#define VOL_MAX_FLOAT 0.98
#define MAX_NOTES 64
#define MIDI_DECAY_LEVEL_TIME 500
#define TIME_MS2SAMPLES(x) floor(uint32_t(x) * AUDIO_SAMPLE_RATE / 1000) * sizeof(int16_t)
#define XSTR(x) STR(x)
#define STR(x) #x
#define MOD_NO_FILTER_OUTPUT 0
#define MOD_BUTTERWORTH_FILTER_OUTPUT 1
#define MOD_LINKWITZ_RILEY_FILTER_OUTPUT 2
#if defined(TEENSY_DAC_SYMMETRIC)
#define MONO_MIN 1
#define MONO_MAX 1
#define MONO_DEFAULT 1
#else
#define MONO_MIN 0
#define MONO_MAX 3
#define MONO_DEFAULT 0
#endif
#define MIDI_CONTROLLER_MODE_MAX 2
#define VOLUME_MIN 0
#define VOLUME_MAX 100
#define VOLUME_DEFAULT 80
#define PANORAMA_MIN 0
#define PANORAMA_MAX 40
#define PANORAMA_DEFAULT 20
#define MIDI_CHANNEL_MIN MIDI_CHANNEL_OMNI
#define MIDI_CHANNEL_MAX 16
#define MIDI_CHANNEL_DEFAULT MIDI_CHANNEL_OMNI
#define INSTANCE_LOWEST_NOTE_MIN 21
#define INSTANCE_LOWEST_NOTE_MAX 108
#define INSTANCE_LOWEST_NOTE_DEFAULT 21
#define INSTANCE_HIGHEST_NOTE_MIN 21
#define INSTANCE_HIGHEST_NOTE_MAX 108
#define INSTANCE_HIGHEST_NOTE_DEFAULT 108
#define CHORUS_FREQUENCY_MIN 0
#define CHORUS_FREQUENCY_MAX 100
#define CHORUS_FREQUENCY_DEFAULT 0
#define CHORUS_WAVEFORM_MIN 0
#define CHORUS_WAVEFORM_MAX 1
#define CHORUS_WAVEFORM_DEFAULT 0
#define CHORUS_DEPTH_MIN 0
#define CHORUS_DEPTH_MAX 100
#define CHORUS_DEPTH_DEFAULT 0
#define CHORUS_LEVEL_MIN 0
#define CHORUS_LEVEL_MAX 100
#define CHORUS_LEVEL_DEFAULT 0
#define DELAY_TIME_MIN 0
#define DELAY_TIME_MAX DELAY_MAX_TIME / 10
#define DELAY_TIME_DEFAULT 0
#define DELAY_FEEDBACK_MIN 0
#define DELAY_FEEDBACK_MAX 100
#define DELAY_FEEDBACK_DEFAULT 0
#define DELAY_LEVEL_MIN 0
#define DELAY_LEVEL_MAX 100
#define DELAY_LEVEL_DEFAULT 0
#define DELAY_LEVEL_GLOBAL_DEFAULT 100
#define DELAY_SYNC_MIN 0
#define DELAY_SYNC_MAX 9
#define DELAY_SYNC_DEFAULT 0
#define REVERB_ROOMSIZE_MIN 0
#define REVERB_ROOMSIZE_MAX 100
#define REVERB_ROOMSIZE_DEFAULT 0
#define REVERB_DAMPING_MIN 0
#define REVERB_DAMPING_MAX 100
#define REVERB_DAMPING_DEFAULT 0
#define REVERB_LOWPASS_MIN 0
#define REVERB_LOWPASS_MAX 100
#define REVERB_LOWPASS_DEFAULT 0
#define REVERB_LODAMP_MIN 0
#define REVERB_LODAMP_MAX 100
#define REVERB_LODAMP_DEFAULT 0
#define REVERB_HIDAMP_MIN 0
#define REVERB_HIDAMP_MAX 100
#define REVERB_HIDAMP_DEFAULT 0
#define REVERB_DIFFUSION_MIN 0
#define REVERB_DIFFUSION_MAX 100
#define REVERB_DIFFUSION_DEFAULT 0
#define REVERB_LEVEL_MIN 0
#define REVERB_LEVEL_MAX 100
#define REVERB_LEVEL_DEFAULT 0
#define REVERB_SEND_MIN 0
#define REVERB_SEND_MAX 100
#define REVERB_SEND_DEFAULT 0
#define FILTER_CUTOFF_MIN 0
#define FILTER_CUTOFF_MAX 100
#define FILTER_CUTOFF_DEFAULT 0
#define FILTER_RESONANCE_MIN 0
#define FILTER_RESONANCE_MAX 100
#define FILTER_RESONANCE_DEFAULT 0
#define TRANSPOSE_MIN 0
#define TRANSPOSE_MAX 48
#define TRANSPOSE_DEFAULT 12
#define TUNE_MIN 1
#define TUNE_MAX 199
#define TUNE_DEFAULT 100
#define SOUND_INTENSITY_MIN 0
#define SOUND_INTENSITY_MAX 100
#define SOUND_INTENSITY_DEFAULT 100
#define POLYPHONY_MIN 0
#define POLYPHONY_MAX MAX_NOTES / NUM_DEXED
#define POLYPHONY_DEFAULT MAX_NOTES / NUM_DEXED
#define MONOPOLY_MIN 0
#define MONOPOLY_MAX 1
#define MONOPOLY_DEFAULT 0
#define NOTE_REFRESH_MIN 0
#define NOTE_REFRESH_MAX 1
#define NOTE_REFRESH_DEFAULT 0
#define PB_RANGE_MIN 0
#define PB_RANGE_MAX 12
#define PB_RANGE_DEFAULT 1
#define PB_STEP_MIN 0
#define PB_STEP_MAX 12
#define PB_STEP_DEFAULT 0
#define MW_RANGE_MIN 0
#define MW_RANGE_MAX 99
#define MW_RANGE_DEFAULT 50
#define MW_ASSIGN_MIN 0
#define MW_ASSIGN_MAX 7
#define MW_ASSIGN_DEFAULT 0 // Bitmapped: 0: Pitch, 1: Amp, 2: Bias
#define MW_MODE_MIN 0
#define MW_MODE_MAX MIDI_CONTROLLER_MODE_MAX
#define MW_MODE_DEFAULT 0
#define FC_RANGE_MIN 0
#define FC_RANGE_MAX 99
#define FC_RANGE_DEFAULT 50
#define FC_ASSIGN_MIN 0
#define FC_ASSIGN_MAX 7
#define FC_ASSIGN_DEFAULT 0 // Bitmapped: 0: Pitch, 1: Amp, 2: Bias
#define FC_MODE_MIN 0
#define FC_MODE_MAX MIDI_CONTROLLER_MODE_MAX
#define FC_MODE_DEFAULT 0
#define BC_RANGE_MIN 0
#define BC_RANGE_MAX 99
#define BC_RANGE_DEFAULT 50
#define BC_ASSIGN_MIN 0
#define BC_ASSIGN_MAX 7
#define BC_ASSIGN_DEFAULT 0 // Bitmapped: 0: Pitch, 1: Amp, 2: Bias
#define BC_MODE_MIN 0
#define BC_MODE_MAX MIDI_CONTROLLER_MODE_MAX
#define BC_MODE_DEFAULT 0
#define AT_RANGE_MIN 0
#define AT_RANGE_MAX 99
#define AT_RANGE_DEFAULT 50
#define AT_ASSIGN_MIN 0
#define AT_ASSIGN_MAX 7
#define AT_ASSIGN_DEFAULT 0 // Bitmapped: 0: Pitch, 1: Amp, 2: Bias
#define AT_MODE_MIN 0
#define AT_MODE_MAX MIDI_CONTROLLER_MODE_MAX
#define AT_MODE_DEFAULT 0
#define OP_ENABLED_MIN 0
#define OP_ENABLED_MAX 0x3f
#define OP_ENABLED_DEFAULT OP_ENABLED_MAX
#define PORTAMENTO_MODE_MIN 0
#define PORTAMENTO_MODE_MAX 1
#define PORTAMENTO_MODE_DEFAULT 0 // 0: Retain, 1: Follow
#define PORTAMENTO_GLISSANDO_MIN 0
#define PORTAMENTO_GLISSANDO_MAX 1
#define PORTAMENTO_GLISSANDO_DEFAULT 0
#define PORTAMENTO_TIME_MIN 0
#define PORTAMENTO_TIME_MAX 99
#define PORTAMENTO_TIME_DEFAULT 0
#define INSTANCES_MIN 1
#define INSTANCES_MAX NUM_DEXED
#define INSTANCES_DEFAULT 1
#define INSTANCE_NOTE_START_MIN MIDI_AIS0
#define INSTANCE_NOTE_START_MAX MIDI_B7
#define INSTANCE_NOTE_START_DEFAULT INSTANCE_NOTE_START_MIN
#define INSTANCE_NOTE_END_MIN MIDI_AIS0
#define INSTANCE_NOTE_END_MAX MIDI_B7
#define INSTANCE_NOTE_END_DEFAULT INSTANCE_NOTE_END_MAX
#define SOFT_MIDI_THRU_MIN 0
#define SOFT_MIDI_THRU_MAX 1
#define SOFT_MIDI_THRU_DEFAULT 1
#define VELOCITY_LEVEL_MIN 50
#define VELOCITY_LEVEL_MAX 127
#define VELOCITY_LEVEL_DEFAULT 100
#define PERFORMANCE_NUM_MIN 0
#define PERFORMANCE_NUM_MAX 99
#define PERFORMANCE_NUM_DEFAULT 0
#define DISPLAY_ROTATION_MIN 0
#define DISPLAY_ROTATION_MAX 3
#define DISPLAY_ROTATION_DEFAULT 3
#define DISPLAY_ROTATION_INVERTED 1
#define TOUCH_ROTATION_MIN 0
#define TOUCH_ROTATION_MAX 3
#define TOUCH_ROTATION_DEFAULT 2
#define TOUCH_ROTATION_INVERTED 3
#define SCREEN_SAVER_START_MIN 1
#define SCREEN_SAVER_START_MAX 59
#define SCREEN_SAVER_START_DEFAULT 4
#define SCREEN_SAVER_MODE_DEFAULT 0 //random mode
#define SCREEN_SAVER_MODE_MIN 0
#define SCREEN_SAVER_MODE_MAX 9
#define GAMEPAD_SPEED_MIN 60
#define GAMEPAD_SPEED_MAX 300
#define GAMEPAD_SPEED_DEFAULT 180
#define EP_CHORUS_FREQUENCY_MIN 0
#define EP_CHORUS_FREQUENCY_MAX 100
#define EP_CHORUS_FREQUENCY_DEFAULT 40
#define EP_CHORUS_WAVEFORM_MIN 0
#define EP_CHORUS_WAVEFORM_MAX 1
#define EP_CHORUS_WAVEFORM_DEFAULT 0
#define EP_CHORUS_DEPTH_MIN 0
#define EP_CHORUS_DEPTH_MAX 100
#define EP_CHORUS_DEPTH_DEFAULT 30
#define EP_CHORUS_LEVEL_MIN 0
#define EP_CHORUS_LEVEL_MAX 100
#define EP_CHORUS_LEVEL_DEFAULT 0
#define EP_DECAY_MIN 0
#define EP_DECAY_MAX 100
#define EP_DECAY_DEFAULT 50
#define EP_RELEASE_MIN 0
#define EP_RELEASE_MAX 100
#define EP_RELEASE_DEFAULT 50
#define EP_HARDNESS_MIN 0
#define EP_HARDNESS_MAX 100
#define EP_HARDNESS_DEFAULT 50
#define EP_TREBLE_MIN 0
#define EP_TREBLE_MAX 100
#define EP_TREBLE_DEFAULT 50
#define EP_PAN_TREMOLO_MIN 0
#define EP_PAN_TREMOLO_MAX 100
#define EP_PAN_TREMOLO_DEFAULT 20
#define EP_PAN_LFO_MIN 0
#define EP_PAN_LFO_MAX 100
#define EP_PAN_LFO_DEFAULT 65
#define EP_VELOCITY_SENSE_MIN 0
#define EP_VELOCITY_SENSE_MAX 100
#define EP_VELOCITY_SENSE_DEFAULT 25
#define EP_STEREO_MIN 0
#define EP_STEREO_MAX 100
#define EP_STEREO_DEFAULT 50
#define EP_POLYPHONY_MIN 0
#define EP_POLYPHONY_MAX NUM_EPIANO_VOICES
#define EP_POLYPHONY_DEFAULT NUM_EPIANO_VOICES
#define EP_TUNE_MIN 1
#define EP_TUNE_MAX 199
#define EP_TUNE_DEFAULT 100
#define EP_DETUNE_MIN 0
#define EP_DETUNE_MAX 100
#define EP_DETUNE_DEFAULT 15
#define EP_OVERDRIVE_MIN 0
#define EP_OVERDRIVE_MAX 100
#define EP_OVERDRIVE_DEFAULT 0
#define EP_LOWEST_NOTE_MIN 21
#define EP_LOWEST_NOTE_MAX 108
#define EP_LOWEST_NOTE_DEFAULT EP_LOWEST_NOTE_MIN
#define EP_HIGHEST_NOTE_MIN 21
#define EP_HIGHEST_NOTE_MAX 108
#define EP_HIGHEST_NOTE_DEFAULT EP_HIGHEST_NOTE_MAX
#define EP_TRANSPOSE_MIN 0
#define EP_TRANSPOSE_MAX 48
#define EP_TRANSPOSE_DEFAULT 24
#define EP_MONOPOLY_MIN 0
#define EP_MONOPOLY_MAX 1
#define EP_MONOPOLY_DEFAULT 0
#define EP_MIDI_CHANNEL_MIN MIDI_CHANNEL_OMNI
#define EP_MIDI_CHANNEL_MAX 16
#define EP_MIDI_CHANNEL_DEFAULT DEFAULT_EP_MIDI_CHANNEL
#define MIDI_CHANNEL_OFF 17
#define BRAIDS_FLANGE_DELAY_LENGTH (6 * AUDIO_BLOCK_SAMPLES)
#define FAVORITES_NUM_MIN 0
#define FAVORITES_NUM_MAX 100
#define FAVORITES_NUM_DEFAULT 0
#define STARTUP_NUM_MIN 0
#define STARTUP_NUM_MAX 255
#define STARTUP_NUM_DEFAULT 0
#define JSON_BUFFER_SIZE 19000
#ifdef MIDI_ACTIVITY_LIGHTS
extern uint8_t LED_MIDI_IN;
extern uint8_t LED_MIDI_OUT;
#endif
typedef struct dexed_s
{
  uint8_t pool;
  uint8_t bank;
  uint8_t voice;
  uint8_t lowest_note;
  uint8_t highest_note;
  uint8_t transpose;
  uint8_t tune;
  uint8_t sound_intensity;
  uint8_t pan;
  uint8_t polyphony;
  uint8_t velocity_level;
  uint8_t monopoly;
  uint8_t note_refresh;
  uint8_t pb_range;
  uint8_t pb_step;
  uint8_t mw_range;
  uint8_t mw_assign;
  uint8_t mw_mode;
  uint8_t fc_range;
  uint8_t fc_assign;
  uint8_t fc_mode;
  uint8_t bc_range;
  uint8_t bc_assign;
  uint8_t bc_mode;
  uint8_t at_range;
  uint8_t at_assign;
  uint8_t at_mode;
  uint8_t portamento_mode;
  uint8_t portamento_glissando;
  uint8_t portamento_time;
  uint8_t op_enabled;
  uint8_t midi_channel;
  uint8_t sidechain_send;
} dexed_t;
typedef struct fx_s
{
  uint8_t filter_cutoff[NUM_DEXED];
  uint8_t filter_resonance[NUM_DEXED];
  uint8_t chorus_frequency[NUM_DEXED];
  uint8_t chorus_waveform[NUM_DEXED];
  uint8_t chorus_depth[NUM_DEXED];
  uint8_t chorus_level[NUM_DEXED];
  uint8_t delay_multiplier[NUM_DEXED];
  uint16_t delay_time[NUM_DEXED];
  uint8_t delay_feedback[NUM_DEXED];
  uint8_t delay_level1[NUM_DEXED];
  uint8_t delay_level2[NUM_DEXED];
  uint8_t delay_level_global[NUM_DEXED];
  uint8_t delay_sync[NUM_DEXED];
  uint8_t delay_pan[NUM_DEXED];
  uint8_t reverb_send[NUM_DEXED];
  uint8_t delay_to_reverb[NUM_DEXED];
  uint8_t delay_filter_mode[NUM_DEXED];
  uint16_t delay_filter_freq[NUM_DEXED];
  uint8_t delay1_to_delay2;
  uint8_t delay2_to_delay1;
  uint8_t reverb_roomsize;
  uint8_t reverb_damping;
  uint8_t reverb_lowpass;
  uint8_t reverb_lodamp;
  uint8_t reverb_hidamp;
  uint8_t reverb_diffusion;
  uint8_t reverb_level;
  uint8_t ep_chorus_frequency;
  uint8_t ep_chorus_waveform;
  uint8_t ep_chorus_depth;
  uint8_t ep_chorus_level;
  uint8_t ep_reverb_send;
  uint8_t ep_delay_send_1;
  uint8_t ep_delay_send_2;
  uint8_t reverb_sidechain_send;
  uint8_t delay1_sidechain_send;
  uint8_t delay2_sidechain_send;
  #if defined BITCRUSH
  uint8_t bitcrush_drive;            // 0-255 maps to 0.0-1.0
  uint8_t bitcrush_output_gain;      // 0-255 maps to 0.0-2.0
  uint8_t bitcrush_dexed1_input;     // 0-255 maps to 0.0-1.0 - DEXED 1 input level
  uint8_t bitcrush_dexed2_input;     // 0-255 maps to 0.0-1.0 - DEXED 2 input level
  uint8_t bitcrush_dexed3_input;     // 0-255 maps to 0.0-1.0 - DEXED 3 input level
  uint8_t bitcrush_dexed4_input;     // 0-255 maps to 0.0-1.0 - DEXED 4 input level
  uint8_t bitcrush_samples_input_r;
  uint8_t bitcrush_samples_input_l;
  uint8_t bitcrush_delay1_send;      // 0-255 maps to 0.0-1.0 - Send to delay 1
  uint8_t bitcrush_delay2_send;      // 0-255 maps to 0.0-1.0 - Send to delay 2
  uint8_t bitcrush_reverb_send;      // 0-255 maps to 0.0-1.0 - Send to reverb
#endif
} fx_t;
typedef struct epiano_s
{
  uint8_t decay;
  uint8_t release;
  uint8_t hardness;
  uint8_t treble;
  uint8_t pan_tremolo;
  uint8_t pan_lfo;
  uint8_t velocity_sense;
  uint8_t stereo;
  uint8_t polyphony;
  uint8_t tune;
  uint8_t detune;
  uint8_t overdrive;
  uint8_t lowest_note;
  uint8_t highest_note;
  uint8_t transpose;
  uint8_t sound_intensity;
  uint8_t pan;
  uint8_t midi_channel;
  uint8_t sidechain_send;
} epiano_t;
typedef struct microsynth_s
{
  int coarse;
  int detune;
  int lfo_intensity;
  int lfo_delay;
  uint8_t lfo_mode;
  uint8_t lfo_speed;
  boolean lfo_direction;
  int lfo_value;
  int lfo_fade;
  bool trigger_noise_with_osc;
  uint8_t pan;
  uint8_t wave;
  uint8_t midi_channel;
  uint8_t sound_intensity;
  uint8_t env_attack;
  uint8_t env_decay;
  uint8_t env_sustain;
  uint8_t env_release;
  uint8_t filter_osc_mode;
  uint16_t osc_freq_current;
  uint16_t filter_osc_freq_from;
  uint16_t filter_osc_freq_to;
  uint16_t filter_osc_freq_current;
  uint16_t filter_osc_freq_last_displayed = 99;
  uint16_t filter_osc_speed;
  uint8_t filter_osc_resonance;
  uint8_t noise_vol;
  uint8_t noise_decay;
  uint8_t filter_noise_mode;
  uint16_t filter_noise_freq_from;
  uint16_t filter_noise_freq_to;
  uint16_t filter_noise_freq_current;
  uint16_t filter_noise_speed;
  uint8_t filter_noise_resonance;
  uint16_t pwm_from;
  uint16_t pwm_to;
  uint8_t pwm_speed;
  uint16_t pwm_current;
  uint16_t pwm_last_displayed;
  uint8_t rev_send;
  uint8_t chorus_send;
  uint8_t delay_send[NUM_MICROSYNTH];
  uint8_t vel_mod_filter_osc = 0;
  uint8_t vel_mod_filter_noise = 0;
  uint8_t sidechain_send;
} microsynth_t;
typedef struct braids_s
{
  uint8_t sound_intensity;
  uint8_t algo;
  uint8_t color;
  uint8_t timbre;
  int coarse;
  uint8_t env_attack;
  uint8_t env_decay;
  uint8_t env_sustain;
  uint8_t env_release;
  uint8_t filter_mode;
  uint16_t filter_freq_from;
  uint16_t filter_freq_to;
  uint8_t filter_resonance;
  uint16_t filter_speed;
  uint16_t filter_lfo_intensity;
  uint8_t filter_lfo_speed;
  uint8_t rev_send;
  uint8_t flanger;
  uint8_t flanger_spread;
  uint8_t delay_send_1;
  uint8_t delay_send_2;
  uint8_t midi_channel;
  uint8_t pan;
  uint8_t note_buffer[NUM_BRAIDS];
  uint8_t sidechain_send;
  char name[FILENAME_MAX_LEN];
  char temp_name[FILENAME_MAX_LEN];
} braids_t;
#define BRAIDS_NAME_LEN 15 //For the preset system
typedef struct multisample_s
{
  char name[FILENAME_MAX_LEN];
  uint8_t sound_intensity;
  uint8_t midi_channel;
} multisample_t;
typedef struct multisample_zone_s
{
  char filename[FULLPATH_MAX_LEN];
  uint8_t entry_number;
  uint8_t rootnote; // sample root note
  uint8_t low;      // lowest note in range
  uint8_t high;     // highest note in range
  uint8_t playmode;    // Trigger/Hold Mode, seq play length (4 steps)
  uint8_t vol;      // volume
  uint8_t pan;      // panorama
  uint8_t rev;      // reverb send
  uint8_t tune;     // tune/pitch offset
  uint8_t loop_type;
  uint32_t loop_start;
  uint32_t loop_end;
  uint8_t psram_entry_number;
} multisample_zone_t;
typedef struct sys_s
{
  uint8_t vol;
  uint8_t mono;
  uint8_t dexed_engine_type;
  uint8_t soft_midi_thru;
  uint8_t performance_number;
  uint8_t favorites;
  uint8_t load_at_startup_performance;
  uint8_t load_at_startup_page;
  uint8_t display_rotation;
  uint8_t touch_rotation;
  uint8_t screen_saver_start; // minutes
  uint8_t screen_saver_mode; // 0 = random, modes 1...4 , 99 = off
  uint16_t gamepad_speed;     // milliseconds
  bool reverse_encoder_pins;
  bool boot_anim_skip;
  bool invert_colors;
  uint8_t brightness;
  bool skip_midi_channel_warning;
  bool send_sysex_on_voice_change;
  bool send_midi_cc;
  bool swap_midi_leds;
  uint8_t rgb_enc_color_def = 4;
  uint8_t rgb_enc_color_sel = 1;
  bool vol_control;
  bool sus_pedal;
  bool ext_clock;
  uint8_t cv_midi_channel;
  uint8_t dac_cv_2;
  uint8_t dac_cv_4;
  uint8_t dac_cv_transpose;
} sys_t;
typedef struct storage_file_s
{
  String name;
  uint32_t size;
  bool isDirectory;
} storage_file_t;
typedef struct sdcard_s
{
  char type[5];
  std::vector<storage_file_t> files;
  uint32_t used;
  uint32_t capacity;
} sdcard_t;
typedef struct configuration_s
{
  sys_t sys;
  dexed_t dexed[NUM_DEXED];
  epiano_t epiano;
  fx_t fx;
} config_t;
typedef struct custom_midi_map_s
{
  uint8_t type;    // 0 = empty, 1 = Key/Pad, 2 = CC / Values, 3 = Button push on/off
  uint8_t channel; // Midi Channel
  uint8_t in;      // Midi Input Key/Pad / Value
  uint8_t out;     // Destination Key / Value
} custom_midi_map_t;
enum virtual_keyboard_instruments
{
  VK_LIVESEQUENCER = 0,
  VK_DEXED0,
  VK_DEXED1,
  VK_DEXED2,
  VK_DEXED3,
  VK_MICROSYNTH0,
  VK_MICROSYNTH1,
  VK_EPIANO,
  VK_DRUMS,
  VK_BRAIDS,
  VK_GRANULAR,
  VK_PS_1,
  VK_PS_2,
  VK_PS_3,
  VK_CV1,
};
enum master_mixer_ports
{
  MASTER_MIX_CH_DEXED1,
  MASTER_MIX_CH_DEXED2,
  MASTER_MIX_CH_DEXED3,
  MASTER_MIX_CH_DEXED4,
  MASTER_MIX_CH_REVERB,
  MASTER_MIX_CH_DRUMS,
  MASTER_MIX_CH_EPIANO,
  MASTER_MIX_CH_MICROSYNTH,
  MASTER_MIX_CH_BRAIDS,
  MASTER_MIX_CH_WAV_PREVIEW_PSRAM,
  MASTER_MIX_CH_DELAY1,
  MASTER_MIX_CH_DELAY2,
  MASTER_MIX_CH_SIDECHAIN,
#ifdef GRANULAR
  MASTER_MIX_CH_GRANULAR,
#endif
#ifdef BITCRUSH
  MASTER_MIX_CH_BITCRUSH,
#endif
  MASTER_MIX_CH_MAX,
};
enum reverb_mixer_ports
{
  REVERB_MIX_CH_DEXED1,
  REVERB_MIX_CH_DEXED2,
  REVERB_MIX_CH_DEXED3,
  REVERB_MIX_CH_DEXED4,
  REVERB_MIX_CH_DRUMS,
  REVERB_MIX_CH_EPIANO,
  REVERB_MIX_CH_MICROSYNTH,
  REVERB_MIX_CH_BRAIDS,
  REVERB_MIX_CH_AUX_DELAY1,
  REVERB_MIX_CH_AUX_DELAY2,
#ifdef GRANULAR
  REVERB_MIX_CH_GRANULAR,
#endif
#ifdef BITCRUSH
  REVERB_MIX_CH_BITCRUSH,
#endif
  REVERB_MIX_CH_MAX,
};
enum fm_modes
{
  FM_BROWSE_FILES,
  FM_DELETE_FILE_OR_FOLDER,
  FM_COPY_PRESETS,
  FM_PLAY_SAMPLE,
  FM_COPY_TO_PSRAM,
  FM_DELETE_FROM_PSRAM,
  FM_COPY_TO_INTERNAL,
  FM_COPY_TO_EXTERNAL
};
enum fav_search_direction
{
  LEFT,
  RIGHT
};
#define _MAPFLOAT
inline float mapfloat(float val, float in_min, float in_max, float out_min, float out_max)
{
  return (val - in_min) * (out_max - out_min) / (in_max - in_min) + out_min;
}
enum APC_MODE
{
  APC_OFF,
  APC_PATTERN_EDITOR,
  APC_SONG,
  APC_MUTE_MATRIX,
  APC_MIXER
};
#if defined DEBUG && DEBUG == 2
#define LOG SerialUSB1 // dual serial : SerialUSB1 to separate logs
#else
#define LOG Serial
#endif
enum TurnDir {
  TURN_UP = -1,
  TURN_DN = 1
};
struct EncoderEvents {
  bool down;
  bool up;
  bool turned;
  TurnDir dir;
  uint16_t speed;
  bool pressed;
  bool longPressed;
};
enum perf_load_opt
{
  perf_dexed,
  perf_msynth,
  perf_epiano,
  perf_braids,
  perf_samples,
  perf_effects,
  perf_seq,
  perf_liveseq
};
typedef struct {
  bool active;
  const char* type;
  uint8_t root;      // 0–11
  uint8_t third;
  uint8_t fifth;
  uint8_t seventh;   // pitch class
  bool hasSeventh;
  uint8_t inversion; // 0=root, 1=first, etc.
} ChordInfo;
#define MAX_CHORD_NOTES 4
#define CHORD_CAPTURE_WINDOW 290  // milliseconds to wait for chord notes
typedef struct {
  char name[8];         // Chord name (e.g. "Cm7")
  char notenames[12];         // Chord name (e.g. "Cm7")
  uint8_t notes[4];      // MIDI note numbers (0 means unused)
} SuggestedChord;
