propann/L-AZ-2/src_esp32/az2_screen/main.cpp

// AZ-2 - Ecran + intro + menu de test NAVIGABLE. Carte reelle identifiee
// via l'etiquette sur le flex de l'ecran (2026-09-13): VIEWE
// UEDX48480040E-WB-V1.3, driver GC9503V (pas le generique
// "ESP32-4848S040C_I/ST7701" suppose au depart). Voir le depot officiel :
// https://github.com/VIEWESMART/UEDX48480040ESP32-4inch-Touch-Display
//
// Ce firmware:
// 1. Intro animee "pixel art" (nom de la machine, palette synthwave).
// 2. Menu de test avec de vraies pages (tap = on rentre dedans, "< " en
//    haut a gauche = retour) :
//    - CONTROLES : visualise en direct la croix + 4 boutons + 3 potards
//      cables directement sur le Teensy (NAV:/BTN:/POT:, remplace le
//      Pico/mux LED abandonnes le 2026-09-15, voir AZ2_CABLAGE_MASTER.md).
//      Pas de tap ici, page de VERIFICATION seulement.
//    - AUDIO : grille de 16 pads tactiles qui envoient PAD:NN:DOWN/UP
//      directement au Teensy depuis l'ecran -- pour faire jouer le Teensy
//      sans attendre que le Pico soit cable.
//    - LIENS SERIE : dernieres lignes recues du Teensy (journal).
//    - A PROPOS : infos statiques (roles, liens).
//
// 3. Lien UART vers le Teensy (GPIO19/20, les 2 seules broches vraiment
//    libres sur cette carte -- voir AZ2_CABLAGE_MASTER.md section 2).
//
// 4. Tactile : FT6336U (compatible FT5x06), PAS un GT911 -- verifie sur le
//    depot officiel VIEWE. Registre standard (I2C 0x38, TD_STATUS a 0x02).
//    SDA=40, SCL=41. Rotation ecran = 180 donc (x,y) brut -> (479-x,479-y).

#include <Arduino.h>
#include <Arduino_GFX_Library.h>
#include <AZ2_Protocol.h>
#include <Wire.h>
#include <math.h>
#include <SPI.h>
#include <SD.h>
#include <Preferences.h>
#include "gb_emulator.h"

namespace {

constexpr int kPinBacklight = 38;
constexpr int16_t kScreenSize = 480;

constexpr int kTeensyTxPin = 19;
constexpr int kTeensyRxPin = 20;

constexpr int kTouchSdaPin = 40;
constexpr int kTouchSclPin = 41;
constexpr uint8_t kTouchI2cAddr = 0x38;

// Carte SD (ROMs de jeux, voir AZ2_EMULATION_JEUX.md) -- broches
// verifiees sur le depot officiel VIEWE (meme source que l'ecran).
// ATTENTION : SD-CS (IO47) est le MEME GPIO que le bus SPI 3 fils de
// commande de l'ecran (SPI-SDA) -- pas un vrai conflit dans la pratique
// car l'ecran n'utilise ce bus QUE pendant gfx->begin() (init du
// GC9503V), jamais apres (le rendu passe ensuite par le panneau RGB
// parallele). Init SD faite APRES gfx->begin() dans setup(), jamais en
// meme temps qu'une commande ecran.
constexpr int kSdCsPin = 47;
constexpr int kSdClkPin = 45;
constexpr int kSdMisoPin = 46;
constexpr int kSdMosiPin = 42;

Arduino_DataBus *bus = new Arduino_SWSPI(
    GFX_NOT_DEFINED /* DC (inutilise, 3-wire) */, 39 /* CS */, 48 /* SCK */,
    47 /* SDA */, GFX_NOT_DEFINED /* MISO */);

Arduino_ESP32RGBPanel *rgbPanel = new Arduino_ESP32RGBPanel(
    18 /* DE */, 17 /* VSYNC */, 16 /* HSYNC */, 21 /* PCLK */,
    4 /* R0 */, 3 /* R1 */, 2 /* R2 */, 1 /* R3 */, 0 /* R4 */,
    10 /* G0 */, 9 /* G1 */, 8 /* G2 */, 7 /* G3 */, 6 /* G4 */, 5 /* G5 */,
    15 /* B0 */, 14 /* B1 */, 13 /* B2 */, 12 /* B3 */, 11 /* B4 */,
    1 /* hsync_polarity */, 10 /* hsync_front_porch */, 8 /* hsync_pulse_width */, 50 /* hsync_back_porch */,
    1 /* vsync_polarity */, 10 /* vsync_front_porch */, 8 /* vsync_pulse_width */, 20 /* vsync_back_porch */,
    0 /* pclk_active_neg */, 12000000 /* prefer_speed */, false /* useBigEndian */,
    0 /* de_idle_high */, 0 /* pclk_idle_high */, 0 /* bounce_buffer_size_px */);

Arduino_RGB_Display *gfx = new Arduino_RGB_Display(
    kScreenSize, kScreenSize, rgbPanel, 2 /* rotation: ecran tete-en-bas */,
    true, bus, GFX_NOT_DEFINED, gc9503v_type1_init_operations, sizeof(gc9503v_type1_init_operations));

const uint16_t kPalette[] = {
    RGB565(255, 60, 172), RGB565(70, 220, 255), RGB565(255, 170, 50),
    RGB565(170, 90, 255), RGB565(255, 225, 80),
};
constexpr uint8_t kPaletteCount = sizeof(kPalette) / sizeof(kPalette[0]);
constexpr uint16_t kDim = RGB565(140, 140, 150);

// Assombrit une couleur RGB565 (garde la teinte, baisse la luminosite) --
// sert aux bandes verticales de mesure du sequenceur, voir seqBandColor().
uint16_t dimColor(uint16_t c, uint8_t shift) {
  const uint16_t r = static_cast<uint16_t>(((c >> 11) & 0x1F) >> shift);
  const uint16_t g = static_cast<uint16_t>(((c >> 5) & 0x3F) >> shift);
  const uint16_t b = static_cast<uint16_t>((c & 0x1F) >> shift);
  return static_cast<uint16_t>((r << 11) | (g << 5) | b);
}
constexpr uint16_t kFaint = RGB565(90, 90, 110);

// ---------------------------------------------------------------------
// Tactile FT6336U
// ---------------------------------------------------------------------
// Diagnostic limite a 1 message/seconde pour ne pas noyer le port serie.
void reportTouchI2cError(const char *what) {
  static uint32_t lastReportMs = 0;
  const uint32_t now = millis();
  if (now - lastReportMs < 1000) {
    return;
  }
  lastReportMs = now;
  Serial.print("TOUCH:I2C_ERROR:");
  Serial.println(what);
}

struct TouchPoint {
  bool active = false;
  int16_t x = 0;
  int16_t y = 0;
};

// Lit jusqu'a 2 points de contact simultanes (registres FT5x06 standard,
// famille FT6336U incluse) : 0x02 = nombre de points, point 1 a partir de
// 0x03, point 2 a partir de 0x09 (meme mise en page, 6 octets d'ecart).
// Une seule transaction I2C pour les deux, plus rapide qu'un point a la
// fois. Coordonnees deja converties dans le repere ecran (rotation 180).
uint8_t readTouches(TouchPoint points[2]) {
  points[0].active = false;
  points[1].active = false;

  Wire.beginTransmission(kTouchI2cAddr);
  Wire.write(0x02);
  const uint8_t txResult = Wire.endTransmission(false);
  if (txResult != 0) {
    reportTouchI2cError(txResult == 2 ? "NAK_ADDR" : txResult == 3 ? "NAK_DATA" : "OTHER");
    return 0;
  }

  constexpr uint8_t kReadLen = 11;  // registres 0x02 a 0x0C inclus
  if (Wire.requestFrom(kTouchI2cAddr, kReadLen) != kReadLen) {
    reportTouchI2cError("SHORT_READ");
    return 0;
  }

  uint8_t buf[kReadLen];
  for (uint8_t i = 0; i < kReadLen; ++i) {
    buf[i] = Wire.read();
  }

  const uint8_t touchCount = buf[0] & 0x0F;

  // Le FT6336U ne rapporte jamais plus de 2 points (registre TD_STATUS,
  // 0-2 valides) -- un bus I2C bruite peut renvoyer des octets a 0xFF
  // (flottant/erreur silencieuse, pas forcement signalee par endTransmission
  // ni requestFrom) qui, une fois masques par & 0x0F, ressemblent a un
  // touchCount valide (ex: 0xFF -> 15). Observe reellement le 2026-09-14 :
  // rafale de faux "TOUCH:DOWN" avec x/y a -3616 (= (kScreenSize-1) - 4095,
  // 4095 = 0x0FFF = les 2 registres de coordonnee a 0xFF). On rejette donc
  // tout touchCount hors 0-2 ET toute coordonnee hors ecran.
  if (touchCount > 2) {
    reportTouchI2cError("BAD_COUNT");
    return 0;
  }

  if (touchCount >= 1) {
    const int16_t rawX = static_cast<int16_t>(((buf[1] & 0x0F) << 8) | buf[2]);
    const int16_t rawY = static_cast<int16_t>(((buf[3] & 0x0F) << 8) | buf[4]);
    const int16_t x = static_cast<int16_t>((kScreenSize - 1) - rawX);
    const int16_t y = static_cast<int16_t>((kScreenSize - 1) - rawY);
    if (x >= 0 && x < kScreenSize && y >= 0 && y < kScreenSize) {
      points[0].active = true;
      points[0].x = x;
      points[0].y = y;
    } else {
      reportTouchI2cError("BAD_COORD");
    }
  }

  if (touchCount >= 2) {
    const int16_t rawX = static_cast<int16_t>(((buf[7] & 0x0F) << 8) | buf[8]);
    const int16_t rawY = static_cast<int16_t>(((buf[9] & 0x0F) << 8) | buf[10]);
    const int16_t x = static_cast<int16_t>((kScreenSize - 1) - rawX);
    const int16_t y = static_cast<int16_t>((kScreenSize - 1) - rawY);
    if (x >= 0 && x < kScreenSize && y >= 0 && y < kScreenSize) {
      points[1].active = true;
      points[1].x = x;
      points[1].y = y;
    } else {
      reportTouchI2cError("BAD_COORD");
    }
  }

  return touchCount;
}

bool inBox(int16_t x, int16_t y, int16_t bx, int16_t by, int16_t bw, int16_t bh) {
  return x >= bx && x < bx + bw && y >= by && y < by + bh;
}

// ---------------------------------------------------------------------
// Etat partage entre les pages / le lien Teensy
// ---------------------------------------------------------------------
enum class Screen : uint8_t { Menu, Controls, Audio, Sequencer, Engines, Retro, Config, Links, About, Patch, Song, Project, Mixer };
Screen currentScreen = Screen::Menu;
// "Retour" (2026-09-19, "il faut pas que ca revienne aux menu general
// il faut que ca revienne d'un etage seulement") -- UN SEUL niveau
// memorise (pas une pile complete), mis a jour a chaque goTo() reel
// (voir plus bas) : suffit pour "revenir d'ou on vient" partout, sans
// la complexite d'une vraie pile d'historique.
Screen navPrevious = Screen::Menu;

bool teensyLinked = false;

constexpr uint8_t kLogLines = 8;
String logBuf[kLogLines];
uint8_t logCount = 0;

void pushLog(const String &line) {
  for (uint8_t i = kLogLines - 1; i > 0; --i) {
    logBuf[i] = logBuf[i - 1];
  }
  logBuf[0] = line;
  if (logCount < kLogLines) {
    ++logCount;
  }
}

void sendToTeensy(const String &message) {
  Serial.println(message);
  Serial1.println(message);
}

// ---------------------------------------------------------------------
// Chrome commun : en-tete avec fleche retour + titre, bas d'ecran = etat
// du lien Teensy.
// ---------------------------------------------------------------------
constexpr int16_t kMargin = 24;
constexpr int16_t kStatusY = kScreenSize - 30;

// Exclue de la page SEQUENCEUR depuis le 2026-09-19 ("on peut enlever
// la ligne du bas tensy en vert gagner de la place pour des bouton de
// transport plus gros") -- cette page a deja tres peu de marge
// verticale (grille 16 pas + panneau lateral + barre transport, voir
// kTrkControlsY), et cette ligne n'apporte rien d'utile pendant
// l'edition d'un morceau (le lien Teensy est deja implicitement
// confirme par le simple fait que jouer/editer fonctionne). Exclue
// aussi de la page PATCH le meme jour ("on a le tensy en vert en bas
// qui nous empeche de voir les dernieres lignes") -- meme raisonnement,
// la page defile deja (voir patchScroll) et a besoin de tout l'espace
// vertical disponible.
bool drawLinkStatusExcluded() {
  return currentScreen == Screen::Sequencer || currentScreen == Screen::Patch;
}

void drawLinkStatus() {
  if (drawLinkStatusExcluded()) {
    return;
  }
  gfx->fillRect(kMargin, kStatusY, kScreenSize - 2 * kMargin, 22, RGB565_BLACK);
  gfx->setTextSize(1);
  gfx->setTextColor(teensyLinked ? RGB565(90, 220, 120) : kDim);
  gfx->setCursor(kMargin, kStatusY + 4);
  gfx->print(teensyLinked ? "TEENSY: relie" : "TEENSY: en attente...");
}

void drawSubHeader(const char *title, uint16_t accent) {
  gfx->fillScreen(RGB565_BLACK);
  gfx->setTextColor(accent);
  gfx->setTextSize(2);
  gfx->setCursor(kMargin, 28);
  gfx->print("< ");
  gfx->print(title);
  gfx->drawFastHLine(kMargin, 60, kScreenSize - 2 * kMargin, kFaint);
  drawLinkStatus();
}

bool hitBack(int16_t x, int16_t y) {
  return inBox(x, y, 0, 0, 90, 50);
}

// Indication visuelle de ce que controlent les 2 encodeurs
// "reglables" (index 1 et 2 -- l'encodeur 0/VOLUME garde un role FIXE,
// voir le commentaire d'updateEncoders() cote Teensy) sur l'ecran
// actuellement affiche -- demande 2026-09-19 ("on va leur attribuer
// une couleur et les inclure a chaque fois dans l'application ... on
// les utilise pas assez"). Couleur FIXE par encodeur (les 2 memes
// couleurs partout ou ce petit indicateur apparait) : l'utilisateur
// apprend "orange = encodeur 1, cyan = encodeur 2" une seule fois,
// seul le LIBELLE change selon la page/le parametre au focus.
// `label == nullptr` -> "--" en gris : cet encodeur n'a pas de role
// sur cet ecran (position stable, pas d'element qui disparait).
constexpr uint16_t kEnc1Color = RGB565(255, 140, 20);  // orange
constexpr uint16_t kEnc2Color = RGB565(60, 220, 255);  // cyan
void drawEncoderHint(uint8_t slot, const char *label) {
  const uint16_t color = (slot == 0) ? kEnc1Color : kEnc2Color;
  constexpr int16_t sw = 9;
  constexpr int16_t y = 14;
  const int16_t x = static_cast<int16_t>(kScreenSize - kMargin - (slot == 0 ? 168 : 78));
  gfx->fillRect(x, y, sw, sw, RGB565_BLACK);  // efface le libelle precedent (largeur variable)
  gfx->fillRect(static_cast<int16_t>(x - 2), static_cast<int16_t>(y - 2),
                static_cast<int16_t>((slot == 0 ? 168 : 78) - 4), static_cast<int16_t>(sw + 4), RGB565_BLACK);
  gfx->fillRect(x, y, sw, sw, color);
  gfx->setTextSize(1);
  gfx->setTextColor(label ? RGB565_WHITE : kFaint);
  gfx->setCursor(static_cast<int16_t>(x + sw + 4), static_cast<int16_t>(y + 1));
  gfx->print(label ? label : "--");
}
void drawEncoderHints(const char *label1, const char *label2) {
  drawEncoderHint(0, label1);
  drawEncoderHint(1, label2);
}

// ---------------------------------------------------------------------
// Page Menu -- reorganisee en 4 cadres (MUSIQUE/JEUX/CONFIG/DOC) le
// 2026-09-15 ("on est trop charge, on fait 4 cadre reglage avec tout ce
// qui est config musique jeux doc") : la liste plate de 8 entrees
// devenait dense a l'ecran et a la croix. Deux niveaux : une grille de
// 4 cartes (categories), puis la sous-liste habituelle (meme style que
// l'ancien menu plat) une fois une categorie choisie.
// ---------------------------------------------------------------------
enum class MenuCat : uint8_t { Musique, Jeux, Config, Doc };
constexpr uint8_t kMenuCatCount = 4;

struct CategoryInfo {
  const char *label;
  const char *hint;
};

constexpr CategoryInfo kCategories[kMenuCatCount] = {
    {"MUSIQUE", "sequenceur, moteurs, audio"},
    {"JEUX", "emulateur Game Boy / GBC"},
    {"CONFIG", "reglages, croix/boutons"},
    {"DOC", "journal serie, a propos"},
};

struct MenuItem {
  const char *label;
  const char *hint;
  Screen target;
  MenuCat category;
};

constexpr MenuItem kMenuItems[] = {
    {"SEQUENCEUR", "programmer les 16 pas", Screen::Sequencer, MenuCat::Musique},
    {"MOTEURS", "moteur + patch par piste", Screen::Engines, MenuCat::Musique},
    {"PATCH", "filtre + ADSR + forme d'onde", Screen::Patch, MenuCat::Musique},
    {"MIXER", "volume de toutes les pistes", Screen::Mixer, MenuCat::Musique},
    {"SONG", "chainer les patterns", Screen::Song, MenuCat::Musique},
    {"PROJET", "sauvegarder / charger tout le morceau", Screen::Project, MenuCat::Musique},
    {"AUDIO", "jouer le Teensy depuis l'ecran", Screen::Audio, MenuCat::Musique},
    {"JEUX", "Game Boy / GBC (ROM sur carte SD)", Screen::Retro, MenuCat::Jeux},
    {"CONFIGURATION", "ecran de veille, reglages", Screen::Config, MenuCat::Config},
    {"CONTROLES", "croix + boutons + potards (Teensy)", Screen::Controls, MenuCat::Config},
    {"LIENS SERIE", "journal ESP32 / Teensy", Screen::Links, MenuCat::Doc},
    {"A PROPOS", "version, roles, build", Screen::About, MenuCat::Doc},
};
constexpr uint8_t kMenuItemCount = sizeof(kMenuItems) / sizeof(kMenuItems[0]);

// Remplit out[] (capacite >= kMenuItemCount) avec les index (dans
// kMenuItems) des entrees de la categorie cat, renvoie le compte.
uint8_t categoryItems(MenuCat cat, uint8_t *out) {
  uint8_t count = 0;
  for (uint8_t i = 0; i < kMenuItemCount; ++i) {
    if (kMenuItems[i].category == cat) {
      out[count++] = i;
    }
  }
  return count;
}

// -1 = grille des 4 categories (accueil du menu), 0-3 = sous-liste de
// la categorie choisie. Remis a -1 a chaque entree sur Screen::Menu
// depuis un autre ecran (voir goTo()) -- toujours revenir a l'accueil.
int8_t menuCategory = -1;
// Ligne/carte survolee par la croix (voir NAV: dans handleTeensyLine())
// -- demande 2026-09-15 ("il faut que ca serve dans les menus") : la
// croix + le bouton A pilotent le menu, pas seulement le tactile.
int8_t menuSelected = 0;

constexpr int16_t kMenuLeft = 48;
constexpr int16_t kMenuTop = 130;
// 34 (au lieu de 39) depuis l'ajout de CONFIGURATION -- une sous-liste
// (3 entrees max par categorie) doit tenir avant la barre d'etat.
constexpr int16_t kMenuRowH = 34;
constexpr int16_t kMenuWidth = kScreenSize - 2 * kMenuLeft;

// Grille 2x2 des 4 cartes de categorie.
constexpr int16_t kCatTop = 110;
constexpr int16_t kCatGap = 16;
constexpr int16_t kCatW = (kScreenSize - 2 * kMargin - kCatGap) / 2;
constexpr int16_t kCatH = (kStatusY - kCatTop - kCatGap - 24) / 2;

void catRect(uint8_t index, int16_t &x, int16_t &y) {
  x = static_cast<int16_t>(kMargin + (index % 2) * (kCatW + kCatGap));
  y = static_cast<int16_t>(kCatTop + (index / 2) * (kCatH + kCatGap));
}

void drawCategoryCard(uint8_t index) {
  int16_t x, y;
  catRect(index, x, y);
  const uint16_t accent = kPalette[index % kPaletteCount];
  const bool selected = (index == menuSelected);
  gfx->fillRect(x, y, kCatW, kCatH, selected ? accent : RGB565_BLACK);
  gfx->drawRect(x, y, kCatW, kCatH, accent);
  gfx->setTextSize(3);
  gfx->setTextColor(selected ? RGB565_BLACK : RGB565_WHITE);
  gfx->setCursor(static_cast<int16_t>(x + 14), static_cast<int16_t>(y + kCatH / 2 - 24));
  gfx->print(kCategories[index].label);
  gfx->setTextSize(1);
  gfx->setTextColor(selected ? RGB565_BLACK : kDim);
  gfx->setCursor(static_cast<int16_t>(x + 14), static_cast<int16_t>(y + kCatH / 2 + 6));
  gfx->print(kCategories[index].hint);
}

void drawMenuSubRow(uint8_t rowIndex, uint8_t itemIndex) {
  const int16_t y = static_cast<int16_t>(kMenuTop + rowIndex * kMenuRowH);
  const uint16_t accent = kPalette[itemIndex % kPaletteCount];
  const bool selected = (rowIndex == menuSelected);
  gfx->fillRect(kMenuLeft, y, kMenuWidth, kMenuRowH - 6, selected ? accent : RGB565_BLACK);
  gfx->drawRect(kMenuLeft, y, kMenuWidth, kMenuRowH - 6, accent);
  gfx->setTextColor(selected ? RGB565_BLACK : RGB565_WHITE);
  gfx->setTextSize(2);
  gfx->setCursor(static_cast<int16_t>(kMenuLeft + 14), static_cast<int16_t>(y + 2));
  gfx->print(kMenuItems[itemIndex].label);
  gfx->setTextSize(1);
  gfx->setTextColor(selected ? RGB565_BLACK : kDim);
  gfx->setCursor(static_cast<int16_t>(kMenuLeft + 14), static_cast<int16_t>(y + 20));
  gfx->print(kMenuItems[itemIndex].hint);
}

void drawMenu() {
  if (menuCategory < 0) {
    gfx->fillScreen(RGB565_BLACK);
    gfx->setTextColor(RGB565_WHITE);
    gfx->setTextSize(3);
    gfx->setCursor(kMargin, 48);
    gfx->print("AZ-2");
    gfx->setTextSize(1);
    gfx->setTextColor(kDim);
    gfx->setCursor(static_cast<int16_t>(kMargin + 90), 60);
    gfx->print("CHOISIS UNE SECTION");
    gfx->drawFastHLine(kMargin, 96, kScreenSize - 2 * kMargin, kFaint);
    for (uint8_t i = 0; i < kMenuCatCount; ++i) {
      drawCategoryCard(i);
    }
    drawLinkStatus();
  } else {
    drawSubHeader(kCategories[menuCategory].label, kPalette[menuCategory % kPaletteCount]);
    uint8_t items[kMenuItemCount];
    const uint8_t count = categoryItems(static_cast<MenuCat>(menuCategory), items);
    for (uint8_t i = 0; i < count; ++i) {
      drawMenuSubRow(i, items[i]);
    }
  }
}

int8_t hitTestCategoryCard(int16_t x, int16_t y) {
  for (uint8_t i = 0; i < kMenuCatCount; ++i) {
    int16_t cx, cy;
    catRect(i, cx, cy);
    if (x >= cx && x < cx + kCatW && y >= cy && y < cy + kCatH) {
      return static_cast<int8_t>(i);
    }
  }
  return -1;
}

int8_t hitTestMenuSubRow(int16_t x, int16_t y, uint8_t count) {
  if (x < kMenuLeft || x > kMenuLeft + kMenuWidth) {
    return -1;
  }
  for (uint8_t i = 0; i < count; ++i) {
    const int16_t rowTop = kMenuTop + i * kMenuRowH;
    if (y >= rowTop && y < rowTop + (kMenuRowH - 6)) {
      return static_cast<int8_t>(i);
    }
  }
  return -1;
}

// kGridLeft/kGridTop/kGridCell/kGridGap/padCellRect() : grille 4x4
// partagee avec la page AUDIO plus bas (touche = jouer le Teensy) --
// gardee ici meme si la page PADS & LEDS d'origine (qui les a introduits)
// a ete remplacee par CONTROLES ci-dessous.
constexpr int16_t kGridLeft = 60;
constexpr int16_t kGridTop = 90;
constexpr int16_t kGridCell = 80;
constexpr int16_t kGridGap = 10;

void padCellRect(uint8_t pad, int16_t &x, int16_t &y) {
  const uint8_t row = pad / 4;
  const uint8_t col = pad % 4;
  x = static_cast<int16_t>(kGridLeft + col * (kGridCell + kGridGap));
  y = static_cast<int16_t>(kGridTop + row * (kGridCell + kGridGap));
}

// ---------------------------------------------------------------------
// Page CONTROLES -- visualisation seule de la croix + 4 boutons + 3
// potards cables DIRECTEMENT sur le Teensy (NAV:/BTN:/POT:, voir
// AZ2_Protocol.h) -- remplace PADS & LEDS le 2026-09-15, suite a
// l'abandon du Pico/mux LED (voir AZ2_CABLAGE_MASTER.md). Permet de
// verifier chaque switch/potard un par un pendant le cablage.
// ---------------------------------------------------------------------
bool navState[4] = {};  // 0=HAUT 1=BAS 2=GAUCHE 3=DROITE
bool btnState[4] = {};  // 0=A 1=B 2=C 3=D
uint8_t potValue[3] = {};
// Bouton poussoir integre a chaque encodeur rotatif (ENC:0-2, voir
// AZ2_Protocol.h) -- ajoute le 2026-09-15, absent du premier cablage
// (potards simples n'avaient pas de bouton).
bool encSwState[3] = {};

constexpr int16_t kNavBox = 56;
constexpr int16_t kNavGap = 4;
constexpr int16_t kNavCenterX = 130;
constexpr int16_t kNavCenterY = 220;

void navRect(uint8_t dir, int16_t &x, int16_t &y) {
  switch (dir) {
    case 0: x = kNavCenterX - kNavBox / 2; y = kNavCenterY - kNavBox - kNavGap; break;
    case 1: x = kNavCenterX - kNavBox / 2; y = kNavCenterY + kNavGap; break;
    case 2: x = kNavCenterX - kNavBox - kNavGap; y = kNavCenterY - kNavBox / 2; break;
    default: x = kNavCenterX + kNavGap; y = kNavCenterY - kNavBox / 2; break;
  }
}

void drawNavBox(uint8_t dir) {
  int16_t x, y;
  navRect(dir, x, y);
  static const char *const kLabels[4] = {"H", "B", "G", "D"};
  gfx->fillRect(x, y, kNavBox, kNavBox, navState[dir] ? kPalette[dir % kPaletteCount] : RGB565_BLACK);
  gfx->drawRect(x, y, kNavBox, kNavBox, kFaint);
  gfx->setTextSize(3);
  gfx->setTextColor(navState[dir] ? RGB565_BLACK : kDim);
  gfx->setCursor(static_cast<int16_t>(x + kNavBox / 2 - 9), static_cast<int16_t>(y + kNavBox / 2 - 12));
  gfx->print(kLabels[dir]);
}

constexpr int16_t kBtnBox = 60;
constexpr int16_t kBtnGap = 12;
constexpr int16_t kBtnLeft = 300;
constexpr int16_t kBtnTop = 160;

void btnRect(uint8_t index, int16_t &x, int16_t &y) {
  x = static_cast<int16_t>(kBtnLeft + (index % 2) * (kBtnBox + kBtnGap));
  y = static_cast<int16_t>(kBtnTop + (index / 2) * (kBtnBox + kBtnGap));
}

void drawBtnBox(uint8_t index) {
  int16_t x, y;
  btnRect(index, x, y);
  static const char kLabels[4] = {'A', 'B', 'C', 'D'};
  gfx->fillRect(x, y, kBtnBox, kBtnBox, btnState[index] ? kPalette[(index + 1) % kPaletteCount] : RGB565_BLACK);
  gfx->drawRect(x, y, kBtnBox, kBtnBox, kFaint);
  gfx->setTextSize(3);
  gfx->setTextColor(btnState[index] ? RGB565_BLACK : kDim);
  gfx->setCursor(static_cast<int16_t>(x + kBtnBox / 2 - 9), static_cast<int16_t>(y + kBtnBox / 2 - 12));
  gfx->print(kLabels[index]);
}

constexpr int16_t kPotBarX = kMargin;
constexpr int16_t kPotBarW = kScreenSize - 2 * kMargin;
constexpr int16_t kPotBarH = 26;
constexpr int16_t kPotBarTop = 340;
constexpr int16_t kPotBarGap = 30;

// Bouton poussoir integre a l'encodeur (ENC:0-2, voir AZ2_Protocol.h) --
// pas de fonction musicale assignee, le temoin visuel EST le slider
// entier qui s'allume au complet pendant l'appui (demande 2026-09-15,
// "il faut que ca allume le slider complet"), plutot qu'un petit
// indicateur separe difficile a voir. encSwState[index] est lu
// directement par drawPotBar() ci-dessous ; appeler drawPotBar() suffit
// pour rafraichir l'affichage du clic, pas de fonction dediee.
void drawPotBar(uint8_t index) {
  const int16_t y = static_cast<int16_t>(kPotBarTop + index * (kPotBarH + kPotBarGap));
  static const char *const kLabels[3] = {"POT 1 - VOLUME", "POT 2 - REVERB", "POT 3 - DELAY"};

  gfx->setTextSize(1);
  gfx->setTextColor(RGB565_WHITE);
  gfx->setCursor(kPotBarX, static_cast<int16_t>(y - 14));
  gfx->print(kLabels[index]);
  char buf[8];
  snprintf(buf, sizeof(buf), "%d", potValue[index]);
  gfx->setCursor(static_cast<int16_t>(kPotBarX + kPotBarW - 28), static_cast<int16_t>(y - 14));
  gfx->print(buf);

  gfx->fillRect(kPotBarX, y, kPotBarW, kPotBarH, RGB565_BLACK);
  gfx->drawRect(kPotBarX, y, kPotBarW, kPotBarH, kFaint);
  // Bouton presse : slider allume a 100% quelle que soit la position
  // reelle du potard (temoin visuel du clic). Sinon, remplissage
  // proportionnel normal a la valeur.
  const int16_t fillW = encSwState[index]
                             ? static_cast<int16_t>(kPotBarW - 4)
                             : static_cast<int16_t>(static_cast<float>(potValue[index]) / 127.0f * (kPotBarW - 4));
  if (fillW > 0) {
    gfx->fillRect(static_cast<int16_t>(kPotBarX + 2), static_cast<int16_t>(y + 2), fillW,
                  static_cast<int16_t>(kPotBarH - 4), kPalette[index % kPaletteCount]);
  }
}

// Temoin de potard superpose EN HAUT de l'ecran, visible sur N'IMPORTE
// QUELLE page (2026-09-18, retour utilisateur : "quand on bouge le
// volume on a pas de jauge qui apparait, il faut que ca apparaisse en
// haut ou bas qu'on sache ou on en est") -- drawPotBar() existant reste
// EXCLUSIF a la page CONTROLES (position fixe dans sa mise en page),
// celui-ci est un second affichage indépendant, une simple bande fine
// tout en haut (y=0..10, avant le contenu de n'importe quelle page).
// S'auto-efface apres kPotToastTimeoutMs en relancant un rendu complet
// de la page courante (voir loop()) -- plus simple/robuste que de
// retenir ce qu'il y avait dessous pour le redessiner a la main.
constexpr int16_t kPotToastY = 0;
constexpr int16_t kPotToastH = 10;
constexpr uint32_t kPotToastTimeoutMs = 1500;
bool potToastActive = false;
uint32_t potToastLastMs = 0;

void drawPotToast(uint8_t index) {
  gfx->fillRect(0, kPotToastY, kScreenSize, kPotToastH, RGB565_BLACK);
  const int16_t fillW = static_cast<int16_t>(static_cast<float>(potValue[index]) / 127.0f * kScreenSize);
  if (fillW > 0) {
    gfx->fillRect(0, kPotToastY, fillW, kPotToastH, kPalette[index % kPaletteCount]);
  }
  potToastActive = true;
  potToastLastMs = millis();
}

void drawControlsPage() {
  drawSubHeader("CONTROLES", kPalette[0]);
  for (uint8_t i = 0; i < 4; ++i) {
    drawNavBox(i);
  }
  for (uint8_t i = 0; i < 4; ++i) {
    drawBtnBox(i);
  }
  for (uint8_t i = 0; i < 3; ++i) {
    drawPotBar(i);
  }
}

// ---------------------------------------------------------------------
// Page AUDIO -- grille tactile, envoie PAD:NN:DOWN/UP au Teensy
// 2 doigts geres en parallele (un pad tenu par slot tactile) -> accords.
// ---------------------------------------------------------------------
int8_t heldAudioPad[2] = {-1, -1};

void drawAudioCell(uint8_t pad, bool pressed) {
  int16_t x, y;
  padCellRect(pad, x, y);
  gfx->fillRect(x, y, kGridCell, kGridCell, pressed ? kPalette[pad % kPaletteCount] : RGB565_BLACK);
  gfx->drawRect(x, y, kGridCell, kGridCell, kPalette[pad % kPaletteCount]);
  gfx->setTextSize(1);
  gfx->setTextColor(pressed ? RGB565_BLACK : RGB565_WHITE);
  gfx->setCursor(static_cast<int16_t>(x + 6), static_cast<int16_t>(y + kGridCell - 16));
  if (pad < 10) gfx->print('0');
  gfx->print(pad);
}

// Clavier tactile comme editeur live (demande 2026-09-15, etape 6 de
// AZ2_TRACKER_ETUDE.md) : "taper un pad pendant qu'un pas de
// sequenceur est selectionne doit pouvoir poser cette note sur le pas
// au lieu de/en plus de croix haut/bas". selectedSeqTrack/
// selectedSeqStep valent TOUJOURS quelque chose depuis la refonte du
// tracker (plus jamais -1, voir leur declaration) -- impossible de
// deviner "un pas est selectionne" a partir de leur seule valeur.
// D'ou un bouton D dedie (libre, la GB n'utilise que A/B/C -- voir
// drawGbRecIndicator()/le commentaire de C) pour bascule explicite,
// pour ne jamais ecraser une composition par accident en jouant
// simplement sur les pads.
bool padEditsStep = false;
// -1 = generique (voix live Dexed fixe, comportement d'origine) ; sinon
// = piste dont les pads jouent le VRAI moteur/patch (2026-09-19, "on
// ajoute un bouton dans la fenetre du tracker pour ... joue
// l'instrument de la piste") -- distinct de padEditsStep : celui-ci
// decide si les presses sont EN PLUS ecrites sur le pas selectionne,
// celui-la decide quelle SOURCE SONORE joue. Les 2 sont orthogonaux.
// Mis a jour par le bouton CLAVIER du tracker (voir hitTestTrkSideBtn(3))
// et remis a -1 en entrant sur AUDIO depuis le menu general (voir les 2
// sites goTo(kMenuItems[...].target)).
int8_t padTargetTrack = -1;
// Chemin SD (carte du Teensy) actuellement assigne a chaque pad, ""
// = aucun (2026-09-19, "il faut pouvoir aussi les sauvegarder dans le
// projet global") -- mis a jour par l'echo PADSAMPLE:<pad>:READY:
// path=... cote Teensy (voir handleTeensyLine()), pas ecrit
// directement ici : reste ainsi TOUJOURS synchronise avec ce qui est
// reellement charge, que l'assignation vienne d'ici, du kit de depart
// au boot du Teensy, ou d'un chargement de projet.
char padSamplePath[az2::kPadCount][48] = {};
extern int8_t selectedSeqTrack;  // definie plus bas, avec le reste de l'etat du sequenceur
extern int8_t selectedSeqStep;

void drawAudioPage() {
  char title[56];
  if (padTargetTrack >= 0) {
    if (padEditsStep) {
      snprintf(title, sizeof(title), "AUDIO - piste %d, pose sur pas %d (D)", padTargetTrack + 1, selectedSeqStep);
    } else {
      snprintf(title, sizeof(title), "AUDIO - piste %d (D=poser sur pas)", padTargetTrack + 1);
    }
  } else if (padEditsStep) {
    // piste +1 (2026-09-19, "plus musicien") -- affichage seulement.
    snprintf(title, sizeof(title), "AUDIO - pose sur piste %d pas %d (D)", selectedSeqTrack + 1, selectedSeqStep);
  } else {
    snprintf(title, sizeof(title), "AUDIO - touche pour jouer (D=poser sur pas)");
  }
  drawSubHeader(title, kPalette[2]);
  for (uint8_t pad = 0; pad < az2::kPadCount; ++pad) {
    drawAudioCell(pad, false);
  }
  heldAudioPad[0] = -1;
  heldAudioPad[1] = -1;
}

int8_t hitTestAudioPad(int16_t x, int16_t y) {
  for (uint8_t pad = 0; pad < az2::kPadCount; ++pad) {
    int16_t px, py;
    padCellRect(pad, px, py);
    if (inBox(x, y, px, py, kGridCell, kGridCell)) {
      return static_cast<int8_t>(pad);
    }
  }
  return -1;
}

// ---------------------------------------------------------------------
// Page SEQUENCEUR -- grille tactile 4 pistes x 16 pas, envoie STEP: au
// Teensy ; curseur de lecture synchronise sur les CLOCK: recus ; bouton
// PLAY/STOP qui reflete l'etat reel (STATUS:TEENSY_AUDIO:).
// 8 pistes / 16 pas : doit rester aligne avec kTrackCount/kStepCount
// cote Teensy (src_teensy/az2_audio/main.cpp).
constexpr uint8_t kSeqTrackCount = 8;
constexpr uint8_t kSeqStepCount = 16;
// Bord droit commun a la vue tracker (colonnes NOTE/INST/FX/VAL/PROB/COND, voir
// plus bas) -- meme marge que le reste de l'appli (kMargin), plus de
// grille a aligner dessus depuis le retrait de l'ancienne vue ON/OFF
// (2026-09-16, voir plus bas).
constexpr int16_t kSeqRightEdge = kScreenSize - kMargin;

// 8 patterns (voir PATTERN:/SONGSET:/SONGLEN:/SONGMODE: dans
// AZ2_Protocol.h et patterns[] cote Teensy) -- demande 2026-09-16 ("il
// faut un tracker complet ... plus qu'assembler des patterns"). L'ESP32
// garde SES PROPRES copies des 8 grilles (pas de "dump" complet envoye
// par le Teensy au changement de pattern, trop volumineux -- 8x8x16
// pas) : seedees identiquement a seedDefaultNotes() cote Teensy au
// boot, puis tenues a jour par les memes echos NOTE:/STEP:/INST:/SFX:
// qu'avant, mais indexes par currentPattern (le pattern actuellement
// EDITE des deux cotes, voir PATTERN: plus bas).
constexpr uint8_t kPatternCount = 8;
uint8_t currentPattern = 0;

bool seqStepOn[kPatternCount][kSeqTrackCount][kSeqStepCount] = {};
// Note par pas (voir NOTE: dans AZ2_Protocol.h -- porte de MicroDexed-touch,
// demande le 2026-09-15 "prend le sequenceur du dexed touch"). Meme
// defauts que seedDefaultNotes() cote Teensy tant que le NOTE: echo n'est
// pas arrive.
uint8_t seqStepNote[kPatternCount][kSeqTrackCount][kSeqStepCount];
// Colonnes INST/FX/VAL du tracker (voir AZ2_TRACKER_ETUDE.md, INST:/SFX:
// dans AZ2_Protocol.h et handleInstCommand()/handleStepFxCommand() cote
// Teensy) -- 0xFF = patch par defaut de la piste, 0 = pas d'effet.
uint8_t seqStepPatch[kPatternCount][kSeqTrackCount][kSeqStepCount];
uint8_t seqStepFx[kPatternCount][kSeqTrackCount][kSeqStepCount] = {};
uint8_t seqStepFxVal[kPatternCount][kSeqTrackCount][kSeqStepCount] = {};
// Probabilite/condition par pas (2026-09-17, voir PROB:/COND: dans
// AZ2_Protocol.h et SequencerTrack::stepProb/stepCondition cote Teensy).
// seqStepProb DOIT etre seede a 100 (pas 0) au boot, sinon l'ecran
// afficherait "0%" avant le premier echo PROB: -- voir le bloc de seed
// plus bas (meme endroit que seqStepPatch=0xFF).
uint8_t seqStepProb[kPatternCount][kSeqTrackCount][kSeqStepCount];
uint8_t seqStepCondition[kPatternCount][kSeqTrackCount][kSeqStepCount] = {};

// Song : liste ordonnee de patterns a enchainer (voir songPatterns[]
// cote Teensy). Meme longueur max (kSongLength=16).
constexpr uint8_t kSongLength = 16;
uint8_t songPatterns[kSongLength] = {};
uint8_t songLen = 0;
bool songMode = false;
// Une couleur par effet (voir kPalette) -- reperage visuel rapide sur
// la grille ET la vue detail, demande le 2026-09-15 ("on met de la
// couleur, des effets"). kDim pour "aucun effet" (index 0). Doit rester
// alignee avec StepFx cote Teensy (None/Arp/Cut/Retrig).
const uint16_t kStepFxColors[] = {kDim, kPalette[1], kPalette[2], kPalette[3]};
uint8_t seqCurrentStep = 0;
bool seqPlaying = false;
float seqBpm = 120.0f;
uint8_t seqStepsPerBeat = 4;
bool metronomeOn = false;  // 2026-09-19, voir METRO: cote Teensy

// Piste/pas selectionnes dans la vue tracker (voir plus bas) -- la
// croix du Teensy (NAV:UP/DOWN) change la valeur de la colonne
// seqDetailCol du pas selectionne. Demarre a (0,0), pas (-1,-1) : la
// vue tracker est desormais TOUJOURS active (voir seqDetailMode), donc
// il faut toujours une piste/un pas valides des le boot.
int8_t selectedSeqTrack = 0;
int8_t selectedSeqStep = 0;

// Vue tracker (colonnes NOTE/INST/FX/VAL/PROB/COND d'UNE piste, comme l'ecran
// phrase de LSDJ/M8 -- voir AZ2_TRACKER_ETUDE.md) -- devenue la SEULE
// vue de la page SEQUENCEUR le 2026-09-16 (retour utilisateur : "on a
// pas de tracker a la M8 LSDJ", la grille ON/OFF + double-tap pour
// voir le detail ne correspondait pas a l'experience tracker attendue).
// La variable reste (toujours true) pour ne pas casser tout le code de
// navigation/edition deja ecrit autour, mais rien ne la remet plus a
// false -- plus de grille a laquelle "revenir".
bool seqDetailMode = true;
// 0=NOTE 1=INST 2=FX 3=VAL 4=PROB 5=COND (les 2 derniers ajoutes le
// 2026-09-17) -- voir detailColX()/drawDetailRow() pour l'affichage et
// le switch(seqDetailCol) dans le gestionnaire de croix pour l'edition.
int8_t seqDetailCol = 0;

// ---------------------------------------------------------------------
// Vue tracker (colonnes NOTE/INST/FX/VAL/PROB/COND d'une piste, voir
// docs/AZ2_TRACKER_ETUDE.md) -- devenue la vue PRINCIPALE ET UNIQUE de
// la page SEQUENCEUR le 2026-09-16 (retour utilisateur : "on a pas de
// tracker a la M8 LSDJ" -- chez ces references, l'ecran affiche
// TOUJOURS la colonne d'une piste, pas une grille ON/OFF qu'il faut
// toucher deux fois pour voir le detail). L'ancienne grille 8 pistes
// (drawSeqGrid()/drawSeqCell()/drawSeqTransport()/drawSeqTempo()/
// drawSeqDivision()) est supprimee -- code mort une fois cette vue
// devenue la seule (recuperable dans l'historique git si jamais utile).
constexpr int16_t kTrkTrackRowY = 66;
constexpr int16_t kTrkTrackRowH = 22;
constexpr int16_t kDetailTop = kTrkTrackRowY + kTrkTrackRowH + 18;  // +18 = place pour l'en-tete de colonnes
constexpr int16_t kDetailRowH = 16;
constexpr int16_t kDetailRowGap = 2;
constexpr int16_t kDetailLeft = kMargin;
constexpr int16_t kDetailStepW = 26;
constexpr int16_t kDetailNoteW = 60;
constexpr int16_t kDetailInstW = 50;
constexpr int16_t kDetailFxW = 50;
constexpr int16_t kDetailValW = 44;
// PRB/CND ajoutees le 2026-09-17 (voir PROB:/COND:) -- largeurs choisies
// etroites expres ("100%"/"1:2"/"FILL" tiennent a la taille de texte 1)
// pour rester dans les ~202px encore libres a droite de VAL avant le
// panneau lateral (voir kTrkSideX plus bas, qui retrecit d'autant).
// PAS VERIFIE A L'ECRAN (compile seulement, pas de materiel branche
// cette session) -- premiere chose a regarder au prochain flash reel.
constexpr int16_t kDetailProbW = 42;
constexpr int16_t kDetailCondW = 46;
// Bord DROIT reel de la grille (fin de la colonne CND), PAS
// kSeqRightEdge (bord de l'ECRAN, bien plus loin -- voir plus bas,
// kTrkSideX/kTrkSideW l'utilisent a raison pour placer le panneau
// LATERAL apres la grille). Bug trouve le 2026-09-19 ("les lignes
// disparaissent a mesure que j'edite ... ca efface le cadre [du
// panneau lateral]") : drawDetailRow() effacait (fillRect noir) toute
// la largeur jusqu'a kSeqRightEdge a chaque ligne editee -- ca
// recouvrait donc systematiquement la bande du panneau lateral a la
// meme hauteur Y que la ligne editee, un peu plus a chaque pas edite.
constexpr int16_t kDetailGridRight = kDetailLeft + kDetailStepW + kDetailNoteW + kDetailInstW + kDetailFxW +
                                      kDetailValW + kDetailProbW + kDetailCondW;

const char *const kNoteNames[12] = {"C-", "C#", "D-", "D#", "E-", "F-", "F#", "G-", "G#", "A-", "A#", "B-"};
const char *const kStepFxNames[] = {"---", "ARP", "CUT", "RET"};
constexpr uint8_t kStepFxCount = sizeof(kStepFxNames) / sizeof(kStepFxNames[0]);

void formatNoteName(uint8_t note, char *out, size_t outSize) {
  const int octave = static_cast<int>(note) / 12 - 1;  // MIDI 60 = C4, convention M8/LSDJ
  snprintf(out, outSize, "%s%d", kNoteNames[note % 12], octave);
}

int16_t detailColX(uint8_t col) {
  // 0=STEP (pas de colonne editable, juste le numero), 1=NOTE, 2=INST,
  // 3=FX, 4=VAL, 5=PROB, 6=COND (2 dernieres ajoutees le 2026-09-17) --
  // decalage de 1 par rapport a seqDetailCol (qui ne compte que les
  // colonnes editables, 0-5).
  switch (col) {
    case 0: return kDetailLeft;
    case 1: return static_cast<int16_t>(kDetailLeft + kDetailStepW);
    case 2: return static_cast<int16_t>(kDetailLeft + kDetailStepW + kDetailNoteW);
    case 3: return static_cast<int16_t>(kDetailLeft + kDetailStepW + kDetailNoteW + kDetailInstW);
    case 4: return static_cast<int16_t>(kDetailLeft + kDetailStepW + kDetailNoteW + kDetailInstW + kDetailFxW);
    case 5:
      return static_cast<int16_t>(kDetailLeft + kDetailStepW + kDetailNoteW + kDetailInstW + kDetailFxW +
                                   kDetailValW);
    default:
      return static_cast<int16_t>(kDetailLeft + kDetailStepW + kDetailNoteW + kDetailInstW + kDetailFxW +
                                   kDetailValW + kDetailProbW);
  }
}

void drawDetailHeader() {
  gfx->setTextSize(1);
  gfx->setTextColor(kDim);
  const int16_t y = static_cast<int16_t>(kDetailTop - 14);
  gfx->setCursor(static_cast<int16_t>(detailColX(0) + 2), y);
  gfx->print("PAS");
  gfx->setCursor(static_cast<int16_t>(detailColX(1) + 2), y);
  gfx->print("NOTE");
  gfx->setCursor(static_cast<int16_t>(detailColX(2) + 2), y);
  gfx->print("INST");
  gfx->setCursor(static_cast<int16_t>(detailColX(3) + 2), y);
  gfx->print("FX");
  gfx->setCursor(static_cast<int16_t>(detailColX(4) + 2), y);
  gfx->print("VAL");
  gfx->setCursor(static_cast<int16_t>(detailColX(5) + 2), y);
  gfx->print("PRB");
  gfx->setCursor(static_cast<int16_t>(detailColX(6) + 2), y);
  gfx->print("CND");
}

void drawDetailRow(uint8_t step) {
  const uint8_t track = static_cast<uint8_t>(selectedSeqTrack);
  const int16_t y = static_cast<int16_t>(kDetailTop + step * (kDetailRowH + kDetailRowGap));
  const bool on = seqStepOn[currentPattern][track][step];
  const bool rowSelected = (step == selectedSeqStep);
  const bool playhead = (step == seqCurrentStep);
  const uint16_t accent = kPalette[track % kPaletteCount];

  // kDetailGridRight (bord de la grille), PAS kSeqRightEdge (bord de
  // l'ECRAN, recouvrait le panneau lateral -- voir son commentaire).
  gfx->fillRect(kDetailLeft, y, kDetailGridRight - kDetailLeft, kDetailRowH,
                playhead ? dimColor(accent, 4) : RGB565_BLACK);

  char buf[8];
  gfx->setTextSize(1);

  // PAS
  gfx->setTextColor(kDim);
  snprintf(buf, sizeof(buf), "%02d", step);
  gfx->setCursor(static_cast<int16_t>(detailColX(0) + 2), static_cast<int16_t>(y + 6));
  gfx->print(buf);

  // NOTE (colonne editable 0)
  const bool noteSel = rowSelected && seqDetailCol == 0;
  if (noteSel) {
    gfx->fillRect(detailColX(1), y, kDetailNoteW, kDetailRowH, accent);
  }
  gfx->setTextColor(noteSel ? RGB565_BLACK : (on ? RGB565_WHITE : kFaint));
  if (on) {
    formatNoteName(seqStepNote[currentPattern][track][step], buf, sizeof(buf));
  } else {
    snprintf(buf, sizeof(buf), "---");
  }
  gfx->setCursor(static_cast<int16_t>(detailColX(1) + 2), static_cast<int16_t>(y + 6));
  gfx->print(buf);

  // INST (colonne editable 1) -- 0xFF = defaut piste, affiche "--"
  const bool instSel = rowSelected && seqDetailCol == 1;
  if (instSel) {
    gfx->fillRect(detailColX(2), y, kDetailInstW, kDetailRowH, accent);
  }
  gfx->setTextColor(instSel ? RGB565_BLACK : (on ? RGB565_WHITE : kFaint));
  const uint8_t patch = seqStepPatch[currentPattern][track][step];
  if (patch == 0xFF) {
    snprintf(buf, sizeof(buf), "--");
  } else {
    snprintf(buf, sizeof(buf), "%02d", patch);
  }
  gfx->setCursor(static_cast<int16_t>(detailColX(2) + 2), static_cast<int16_t>(y + 6));
  gfx->print(buf);

  // FX (colonne editable 2) -- une couleur par effet (kStepFxColors),
  // demande 2026-09-15 ("on met de la couleur, des effets").
  const uint8_t fxId = seqStepFx[currentPattern][track][step];
  const bool fxSel = rowSelected && seqDetailCol == 2;
  if (fxSel) {
    gfx->fillRect(detailColX(3), y, kDetailFxW, kDetailRowH, accent);
  } else if (on && fxId != 0) {
    // Fond legerement teinte de la couleur de l'effet, meme quand la
    // ligne n'est pas selectionnee -- repere visuel au premier coup
    // d'oeil, pas besoin d'ouvrir chaque pas pour voir ce qui a un FX.
    gfx->fillRect(detailColX(3), y, kDetailFxW, kDetailRowH, dimColor(kStepFxColors[fxId], 4));
  }
  gfx->setTextColor(fxSel ? RGB565_BLACK : (on ? kStepFxColors[fxId] : kFaint));
  gfx->setCursor(static_cast<int16_t>(detailColX(3) + 2), static_cast<int16_t>(y + 6));
  gfx->print(kStepFxNames[fxId]);

  // VAL (colonne editable 3) -- vide si pas d'effet actif
  const bool valSel = rowSelected && seqDetailCol == 3;
  if (valSel) {
    gfx->fillRect(detailColX(4), y, kDetailValW, kDetailRowH, accent);
  }
  gfx->setTextColor(valSel ? RGB565_BLACK : (on ? kStepFxColors[fxId] : kFaint));
  if (fxId == 0) {
    snprintf(buf, sizeof(buf), "--");
  } else {
    snprintf(buf, sizeof(buf), "%02X", seqStepFxVal[currentPattern][track][step]);
  }
  gfx->setCursor(static_cast<int16_t>(detailColX(4) + 2), static_cast<int16_t>(y + 6));
  gfx->print(buf);

  // PROB (colonne editable 4, 2026-09-17) -- masquee ("--") a 100%
  // (comportement d'origine, pas de bruit visuel sur un pattern qui
  // n'utilise pas la fonction).
  const uint8_t prob = seqStepProb[currentPattern][track][step];
  const bool probSel = rowSelected && seqDetailCol == 4;
  if (probSel) {
    gfx->fillRect(detailColX(5), y, kDetailProbW, kDetailRowH, accent);
  }
  gfx->setTextColor(probSel ? RGB565_BLACK : (on ? RGB565_WHITE : kFaint));
  if (prob >= 100) {
    snprintf(buf, sizeof(buf), "--");
  } else {
    snprintf(buf, sizeof(buf), "%d", prob);
  }
  gfx->setCursor(static_cast<int16_t>(detailColX(5) + 2), static_cast<int16_t>(y + 6));
  gfx->print(buf);

  // COND (colonne editable 5, 2026-09-17) -- meme principe visuel que
  // FX/VAL, label lisible via az2::stepConditionLabel() (partage avec le
  // Teensy pour ne pas dupliquer l'encodage).
  const uint8_t cond = seqStepCondition[currentPattern][track][step];
  const bool condSel = rowSelected && seqDetailCol == 5;
  if (condSel) {
    gfx->fillRect(detailColX(6), y, kDetailCondW, kDetailRowH, accent);
  }
  gfx->setTextColor(condSel ? RGB565_BLACK : (on ? RGB565_WHITE : kFaint));
  az2::stepConditionLabel(cond, buf, sizeof(buf));
  gfx->setCursor(static_cast<int16_t>(detailColX(6) + 2), static_cast<int16_t>(y + 6));
  gfx->print(buf);
}

// Selecteur de piste ("< PISTE N >", meme motif que la page PATCH) --
// desormais AU-DESSUS des colonnes NOTE/INST/FX/VAL/PROB/COND, toujours visible
// (plus besoin de toucher deux fois un pas pour changer de piste).
void drawTrkTrackRow() {
  gfx->fillRect(kMargin, kTrkTrackRowY, kScreenSize - 2 * kMargin, kTrkTrackRowH, RGB565_BLACK);
  gfx->setTextSize(2);
  gfx->setTextColor(kPalette[selectedSeqTrack % kPaletteCount]);
  char buf[16];
  snprintf(buf, sizeof(buf), "< PISTE %d >", selectedSeqTrack + 1);  // +1 : affichage "plus musicien"
  gfx->setCursor(static_cast<int16_t>(kScreenSize / 2 - 55), kTrkTrackRowY);
  gfx->print(buf);
}

bool hitTestTrkTrackPrev(int16_t x, int16_t y) {
  return inBox(x, y, kMargin, kTrkTrackRowY, kScreenSize / 2 - kMargin, kTrkTrackRowH);
}
bool hitTestTrkTrackNext(int16_t x, int16_t y) {
  return inBox(x, y, kScreenSize / 2, kTrkTrackRowY, kScreenSize / 2 - kMargin, kTrkTrackRowH);
}

// Transport + tempo + division, compactes sur UNE ligne (plus de place
// pour ca en 3 lignes empilees une fois les 16 pas affiches en
// permanence -- voir kDetailTop/kDetailRowH). PLAY/STOP a gauche, BPM
// au milieu (moitie gauche = -5, moitie droite = +5), DIVISION a
// droite (toucher = cran suivant).
constexpr int16_t kTrkControlsY = kDetailTop + kSeqStepCount * (kDetailRowH + kDetailRowGap) + 6;
// Retour a la taille/disposition d'origine (2026-09-19, retour
// utilisateur explicite : "la ligne du bas on la laisse comme elle
// est") -- METRONOME (et les autres boutons) vont dans le panneau
// LATERAL (voir drawTrkSidePanel()), pas ici.
constexpr int16_t kTrkControlsH = 34;
constexpr int16_t kTrkControlsW = kScreenSize - 2 * kMargin;
constexpr int16_t kTrkPlayW = kTrkControlsW / 3;
constexpr int16_t kTrkBpmX = kMargin + kTrkPlayW;
constexpr int16_t kTrkBpmW = kTrkControlsW / 3;
constexpr int16_t kTrkDivX = kTrkBpmX + kTrkBpmW;
constexpr int16_t kTrkDivW = kTrkControlsW - kTrkPlayW - kTrkBpmW;

void drawTrkControls() {
  gfx->fillRect(kMargin, kTrkControlsY, kTrkControlsW, kTrkControlsH, RGB565_BLACK);
  gfx->drawRect(kMargin, kTrkControlsY, kTrkPlayW, kTrkControlsH, kFaint);
  gfx->drawRect(kTrkBpmX, kTrkControlsY, kTrkBpmW, kTrkControlsH, kFaint);
  gfx->drawRect(kTrkDivX, kTrkControlsY, kTrkDivW, kTrkControlsH, kFaint);

  gfx->setTextSize(2);
  gfx->setTextColor(seqPlaying ? kPalette[1] : RGB565_WHITE);
  gfx->setCursor(static_cast<int16_t>(kMargin + 8), static_cast<int16_t>(kTrkControlsY + 8));
  gfx->print(seqPlaying ? "STOP" : "PLAY");

  gfx->setTextSize(1);
  gfx->setTextColor(kDim);
  gfx->setCursor(static_cast<int16_t>(kTrkBpmX + 4), static_cast<int16_t>(kTrkControlsY + 2));
  gfx->print("BPM -/+");
  gfx->setTextSize(2);
  gfx->setTextColor(RGB565_WHITE);
  char buf[8];
  snprintf(buf, sizeof(buf), "%d", static_cast<int>(seqBpm + 0.5f));
  gfx->setCursor(static_cast<int16_t>(kTrkBpmX + 4), static_cast<int16_t>(kTrkControlsY + 14));
  gfx->print(buf);

  gfx->setTextSize(1);
  gfx->setTextColor(kDim);
  gfx->setCursor(static_cast<int16_t>(kTrkDivX + 4), static_cast<int16_t>(kTrkControlsY + 2));
  gfx->print("DIVISION");
  gfx->setTextSize(2);
  gfx->setTextColor(RGB565_WHITE);
  gfx->setCursor(static_cast<int16_t>(kTrkDivX + 4), static_cast<int16_t>(kTrkControlsY + 14));
  gfx->print(az2::divisionLabel(seqStepsPerBeat));
}

bool hitTestTrkPlay(int16_t x, int16_t y) {
  return inBox(x, y, kMargin, kTrkControlsY, kTrkPlayW, kTrkControlsH);
}
// -1 = aucun, 0 = moitie gauche (-5 BPM), 1 = moitie droite (+5 BPM).
int8_t hitTestTrkBpm(int16_t x, int16_t y) {
  if (y < kTrkControlsY || y >= kTrkControlsY + kTrkControlsH) {
    return -1;
  }
  if (x >= kTrkBpmX && x < kTrkBpmX + kTrkBpmW / 2) {
    return 0;
  }
  if (x >= kTrkBpmX + kTrkBpmW / 2 && x < kTrkBpmX + kTrkBpmW) {
    return 1;
  }
  return -1;
}
bool hitTestTrkDiv(int16_t x, int16_t y) {
  return inBox(x, y, kTrkDivX, kTrkControlsY, kTrkDivW, kTrkControlsH);
}

// Panneau "patch actif" -- demande 2026-09-16 ("on a de la place, on
// affiche le patch actif et ses reglages du cote droit ... on met le
// patch en cours dans la piste selectionnee") : les colonnes NOTE/
// INST/FX/VAL ne remplissent pas toute la largeur (kSeqRightEdge), il
// reste ~194px a droite -- moteur + patch de la piste EDITEE
// (selectedSeqTrack), memes tableaux que la page MOTEURS (declares
// plus bas dans ce fichier, voir la declaration anticipee ci-dessous).
extern uint8_t trackEngine[kSeqTrackCount];
extern uint8_t trackPatch[kSeqTrackCount];
extern uint8_t trackCutoff[kSeqTrackCount];
extern uint8_t trackReso[kSeqTrackCount];
extern uint8_t trackAttack[kSeqTrackCount];
extern uint8_t trackDecay[kSeqTrackCount];
extern uint8_t trackSustain[kSeqTrackCount];
extern uint8_t trackRelease[kSeqTrackCount];
extern uint8_t trackAlgo[kSeqTrackCount];
extern uint8_t trackFeedback[kSeqTrackCount];

constexpr int16_t kTrkSideGap = 8;
// PRB/CND (2026-09-17) retrecissent ce panneau de ~88px (kDetailProbW +
// kDetailCondW) -- PAS VERIFIE A L'ECRAN si ce qui reste (~106px) est
// encore assez large pour le contenu de drawTrkSidePanel(), a l'oeil au
// prochain flash reel.
constexpr int16_t kTrkSideX = kDetailLeft + kDetailStepW + kDetailNoteW + kDetailInstW + kDetailFxW + kDetailValW +
                               kDetailProbW + kDetailCondW + kTrkSideGap;
constexpr int16_t kTrkSideW = kSeqRightEdge - kTrkSideX;

constexpr int16_t kTrkSideH = kSeqStepCount * (kDetailRowH + kDetailRowGap);

// Panneau lateral repense le 2026-09-19 (retour utilisateur sur
// materiel reel : "le cadre du patch est toujours pas bon" + "des
// bouton plus gros un bouton pour le clavier un pour les effet un
// pour le moteur et patch") -- l'ancien resume texte (moteur/patch/
// cutoff/reso/adsr) disparait completement, remplace par 5 boutons
// PLEINE LARGEUR empiles qui couvrent toute la hauteur du panneau :
// MOTEUR, PATCH, EFFET, CLAVIER, METRONOME. Chacun ouvre directement
// la page correspondante pour la piste du tracker actuellement
// affichee (sauf METRONOME, une simple bascule, et EFFET qui reste
// dans le tracker mais amene le focus croix sur la colonne FX).
constexpr uint8_t kTrkSideBtnCount = 6;
constexpr int16_t kTrkSideBtnGap = 4;
constexpr int16_t kTrkSideBtnH = (kTrkSideH - (kTrkSideBtnCount - 1) * kTrkSideBtnGap) / kTrkSideBtnCount;

int16_t trkSideBtnY(uint8_t idx) {
  return static_cast<int16_t>(kDetailTop + idx * (kTrkSideBtnH + kTrkSideBtnGap));
}

void drawTrkSideBtn(uint8_t idx, uint16_t color, bool filled, const char *label) {
  const int16_t y = trkSideBtnY(idx);
  if (filled) {
    gfx->fillRect(static_cast<int16_t>(kTrkSideX + 1), y, static_cast<int16_t>(kTrkSideW - 2), kTrkSideBtnH, color);
    gfx->setTextColor(RGB565_BLACK);
  } else {
    gfx->fillRect(static_cast<int16_t>(kTrkSideX + 1), y, static_cast<int16_t>(kTrkSideW - 2), kTrkSideBtnH,
                   RGB565_BLACK);
    gfx->drawRect(static_cast<int16_t>(kTrkSideX + 1), y, static_cast<int16_t>(kTrkSideW - 2), kTrkSideBtnH, color);
    gfx->setTextColor(color);
  }
  gfx->setTextSize(2);
  gfx->setCursor(static_cast<int16_t>(kTrkSideX + 10), static_cast<int16_t>(y + kTrkSideBtnH / 2 - 8));
  gfx->print(label);
}

bool hitTestTrkSideBtn(uint8_t idx, int16_t x, int16_t y) {
  return inBox(x, y, kTrkSideX, trkSideBtnY(idx), kTrkSideW, kTrkSideBtnH);
}

void drawTrkSidePanel() {
  const uint16_t accent = kPalette[selectedSeqTrack % kPaletteCount];

  gfx->fillRect(kTrkSideX, kDetailTop, kTrkSideW, kTrkSideH, RGB565_BLACK);
  gfx->drawRect(kTrkSideX, kDetailTop, kTrkSideW, kTrkSideH, accent);

  drawTrkSideBtn(0, accent, false, "MOTEUR");
  drawTrkSideBtn(1, accent, true, "PATCH");
  drawTrkSideBtn(2, kPalette[2], false, "EFFET");
  drawTrkSideBtn(3, kPalette[5], false, "CLAVIER");
  drawTrkSideBtn(4, metronomeOn ? kPalette[3] : kFaint, metronomeOn, "METRO");
  // 2026-09-19, "dans le tracker il manque le bouton sauvegarder" --
  // sauvegarde tout le morceau (voir saveProject()) dans l'emplacement
  // PROJET actuellement choisi (projectSlot, meme emplacement que la
  // page PROJET -- pas un 2e systeme de slots), sans quitter le
  // tracker. Rempli en vert un court instant apres l'appui (voir le
  // hitTest correspondant plus bas) -- seul retour visuel disponible,
  // la sauvegarde elle-meme reste quasi instantanee.
  drawTrkSideBtn(5, RGB565(60, 200, 90), false, "SAUVER");
}

void drawSeqDetailPage() {
  char title[16];
  snprintf(title, sizeof(title), "PATTERN %d", currentPattern);
  drawSubHeader(title, kPalette[0]);
  drawTrkTrackRow();
  drawDetailHeader();
  for (uint8_t s = 0; s < kSeqStepCount; ++s) {
    drawDetailRow(s);
  }
  drawTrkSidePanel();
  drawTrkControls();
}

// Zone tactile sur le titre de l'en-tete (juste apres la fleche retour,
// voir hitBack()) -- toucher cycle le pattern EDITE (voir currentPattern,
// PATTERN: dans AZ2_Protocol.h).
bool hitTestPatternHeader(int16_t x, int16_t y) {
  return inBox(x, y, 90, 0, 200, 50);
}

void drawSequencerPage();  // definie plus bas -- seul appelant de switchToPattern()

void switchToPattern(uint8_t p) {
  currentPattern = static_cast<uint8_t>(p % kPatternCount);
  char msg[12];
  snprintf(msg, sizeof(msg), "PATTERN:%d", currentPattern);
  sendToTeensy(msg);
  drawSequencerPage();
}

int8_t hitTestDetailRow(int16_t x, int16_t y) {
  // kDetailGridRight (bord de la grille), pas kSeqRightEdge (bord de
  // l'ecran) -- inoffensif en pratique (un toucher dans le panneau
  // lateral finissait par ne matcher aucune colonne de toute facon),
  // corrige par coherence avec le fix de drawDetailRow() ci-dessus.
  if (x < kDetailLeft || x > kDetailGridRight) {
    return -1;
  }
  for (uint8_t s = 0; s < kSeqStepCount; ++s) {
    const int16_t rowY = static_cast<int16_t>(kDetailTop + s * (kDetailRowH + kDetailRowGap));
    if (y >= rowY && y < rowY + kDetailRowH) {
      return static_cast<int8_t>(s);
    }
  }
  return -1;
}

// Page SEQUENCEUR = toujours la vue tracker (voir drawSeqDetailPage()
// et le commentaire sur seqDetailMode plus haut) -- plus de grille
// ON/OFF separee.
void drawSequencerPage() {
  drawSeqDetailPage();
}

// ---------------------------------------------------------------------
// Page MOTEURS -- moteur + patch par piste, demandee le 2026-09-14 ("les
// moteurs audio ne sont pas selectionnables ni reglables ... faut faire
// un truc propre"). Une ligne par piste : toucher la moitie gauche
// change de moteur (ENGINE:), la moitie droite change de patch (PATCH:)
// -- le Teensy applique et renvoie confirmation, voir handleTeensyLine().
// ---------------------------------------------------------------------
// Meme motif que seedDefaultNotes() cote Teensy (Dexed/Dexed/EPiano/
// Braids repete sur les pistes 4-7) -- juste le defaut affiche avant
// que announceHello() ne confirme l'etat reel a la connexion.
// Doit rester identique aux valeurs de boot du Teensy. DEXED est encore
// selectionnable, mais pas active par defaut tant que son souffle sur le
// materiel reel n'est pas resolu.
uint8_t trackEngine[kSeqTrackCount] = {az2::kEngineAnalog, az2::kEngineAnalog, az2::kEngineEPiano, az2::kEngineBraids,
                                      az2::kEngineAnalog, az2::kEngineAnalog, az2::kEngineEPiano, az2::kEngineBraids};
uint8_t trackPatch[kSeqTrackCount] = {0, 0, 0, 0, 0, 0, 0, 0};
// Mute/solo (MUTE:/SOLO:, priorite #1 de la liste indispensable) --
// bascules cote Teensy dans trackMuted[]/trackSoloed[]/trackEffectiveGain(),
// voir le piege Braids documente dans AZ2_FEUILLE_DE_ROUTE.md.
bool trackMuted[kSeqTrackCount] = {};
bool trackSoloed[kSeqTrackCount] = {};

// Page MOTEURS repensee le 2026-09-19 (retour utilisateur sur materiel
// reel : "il faut l'organiser differemment une liste de moteur a
// gauche et a chaque moteur selectionne ca met les patch a droite et
// en dessous la mini fenetre de reglage du patch si on clic dessus on
// arrive a la page de reglage de patch"). Piste choisie en haut (meme
// motif "< PISTE N >" que PATCH/SEQUENCEUR), puis 2 colonnes : la
// liste des 6 MOTEURS a gauche, la liste des patches du moteur
// ASSIGNE a cette piste a droite (defile si plus de kEngListVisibleRows
// -- jusqu'a 255 pour DEXED), puis un bandeau "mini reglages" en bas,
// tactile, qui ouvre la page PATCH complete.
//
// Choisir une ligne (croix ou tactile) = assigner IMMEDIATEMENT (pas
// d'etape de confirmation separee -- meme convention "manipulation
// directe" que le reste de l'appli) : la liste MOTEUR n'a donc pas
// besoin d'un curseur distinct de trackEngine[piste], ni la liste
// PATCH d'un curseur distinct de trackPatch[piste] -- juste
// engPatchScroll pour savoir quelle partie de la liste (potentiellement
// longue) est actuellement visible.
int8_t selectedEngineTrack = 0;
// false = focus croix sur la liste MOTEUR (gauche), true = liste PATCH
// (droite) -- GAUCHE/DROITE bascule (spatial, plus intuitif qu'avant
// avec de vraies colonnes cote a cote), HAUT/BAS deplace/choisit dans
// la colonne au focus.
bool engineColPatch = false;
uint16_t engPatchScroll = 0;
// true = focus croix sur la ligne PISTE en haut (GAUCHE/DROITE change
// alors la piste), false = focus dans une des 2 listes (voir
// engineColPatch pour laquelle) -- voir le gestionnaire NAV: pour le
// detail complet (2026-09-19, 2e passe suite au retour "on est un peu
// dans le desordre de controle").
bool engOnTrackRow = false;

constexpr int16_t kEngTrackRowY = 66;
constexpr int16_t kEngTrackRowH = 22;
constexpr int16_t kEngListTop = kEngTrackRowY + kEngTrackRowH + 10;
constexpr int16_t kEngListLeftW = (kScreenSize - 2 * kMargin) * 4 / 10;
constexpr int16_t kEngGap = 6;
constexpr int16_t kEngListRightX = kMargin + kEngListLeftW + kEngGap;
constexpr int16_t kEngListRightW = kScreenSize - 2 * kMargin - kEngListLeftW - kEngGap;
constexpr int16_t kEngListRowH = 42;
// 6 -- tombe pile sur le nombre de moteurs (liste gauche jamais
// scrollee), la liste PATCH (droite) partage la meme fenetre/hauteur
// et defile au-dela (voir engPatchScroll), meme principe que
// patchScroll sur la page PATCH.
constexpr uint8_t kEngListVisibleRows = az2::kEngineCount;
constexpr int16_t kEngListH = kEngListVisibleRows * kEngListRowH;
constexpr int16_t kEngMiniY = kEngListTop + kEngListH + 10;
constexpr int16_t kEngMiniH = 66;

void drawEngTrackRow() {
  const int16_t w = static_cast<int16_t>(kScreenSize - 2 * kMargin);
  gfx->fillRect(kMargin, kEngTrackRowY, w, kEngTrackRowH, RGB565_BLACK);
  // Contour blanc quand le focus croix est sur cette ligne (2026-09-19,
  // voir engOnTrackRow) -- seul indice visuel de "ou" on est avant de
  // bouger, important puisque GAUCHE/DROITE change de sens selon le
  // focus (piste ici, moteur/patch sinon).
  if (engOnTrackRow) {
    gfx->drawRect(kMargin, kEngTrackRowY, w, kEngTrackRowH, RGB565_WHITE);
  }
  gfx->setTextSize(2);
  gfx->setTextColor(kPalette[selectedEngineTrack % kPaletteCount]);
  char buf[16];
  snprintf(buf, sizeof(buf), "< PISTE %d >", selectedEngineTrack + 1);  // +1 : affichage "plus musicien"
  gfx->setCursor(static_cast<int16_t>(kScreenSize / 2 - 55), kEngTrackRowY);
  gfx->print(buf);
}
bool hitTestEngTrackPrev(int16_t x, int16_t y) {
  return inBox(x, y, kMargin, kEngTrackRowY, static_cast<int16_t>(kScreenSize / 2 - kMargin), kEngTrackRowH);
}
bool hitTestEngTrackNext(int16_t x, int16_t y) {
  return inBox(x, y, static_cast<int16_t>(kScreenSize / 2), kEngTrackRowY,
               static_cast<int16_t>(kScreenSize / 2 - kMargin), kEngTrackRowH);
}

void drawEngListRow(uint8_t engineIdx) {
  const uint8_t t = static_cast<uint8_t>(selectedEngineTrack);
  const int16_t y = static_cast<int16_t>(kEngListTop + engineIdx * kEngListRowH);
  const bool isCurrent = (engineIdx == trackEngine[t]);
  const bool focused = isCurrent && !engineColPatch && !engOnTrackRow;
  const uint16_t accent = kPalette[t % kPaletteCount];
  const int16_t h = static_cast<int16_t>(kEngListRowH - 2);

  gfx->fillRect(kMargin, y, kEngListLeftW, h, isCurrent ? accent : RGB565_BLACK);
  gfx->drawRect(kMargin, y, kEngListLeftW, h, isCurrent ? accent : kFaint);
  // Contour BLANC EPAIS (3px, 2026-09-19 -- "on fait un truc en
  // surbrillance plus visible pour qu'on voit mieux ce qui est
  // selectionne") quand c'est la ligne au focus croix -- un seul pixel
  // se voyait mal par-dessus le remplissage deja colore.
  if (focused) {
    for (int16_t o = 0; o < 3; ++o) {
      gfx->drawRect(static_cast<int16_t>(kMargin + 1 + o), static_cast<int16_t>(y + 1 + o),
                    static_cast<int16_t>(kEngListLeftW - 2 - 2 * o), static_cast<int16_t>(h - 2 - 2 * o), RGB565_WHITE);
    }
  }
  gfx->setTextSize(2);
  gfx->setTextColor(isCurrent ? RGB565_BLACK : RGB565_WHITE);
  gfx->setCursor(static_cast<int16_t>(kMargin + 8), static_cast<int16_t>(y + h / 2 - 8));
  gfx->print(az2::engineName(engineIdx));
}

// slot = position dans la fenetre visible (0..kEngListVisibleRows-1),
// PAS l'index de patch lui-meme (voir engPatchScroll).
void drawEngPatchRow(uint8_t slot) {
  const uint8_t t = static_cast<uint8_t>(selectedEngineTrack);
  const uint16_t patchIdx = static_cast<uint16_t>(engPatchScroll + slot);
  const int16_t y = static_cast<int16_t>(kEngListTop + slot * kEngListRowH);
  const int16_t h = static_cast<int16_t>(kEngListRowH - 2);
  const uint16_t count = az2::enginePatchCount(trackEngine[t]);

  if (patchIdx >= count) {
    gfx->fillRect(kEngListRightX, y, kEngListRightW, h, RGB565_BLACK);
    return;
  }
  const bool isCurrent = (patchIdx == trackPatch[t]);
  const bool focused = isCurrent && engineColPatch && !engOnTrackRow;
  const uint16_t accent = kPalette[t % kPaletteCount];

  gfx->fillRect(kEngListRightX, y, kEngListRightW, h, isCurrent ? accent : RGB565_BLACK);
  gfx->drawRect(kEngListRightX, y, kEngListRightW, h, isCurrent ? accent : kFaint);
  // Contour epais -- meme raison/meme technique que drawEngListRow().
  if (focused) {
    for (int16_t o = 0; o < 3; ++o) {
      gfx->drawRect(static_cast<int16_t>(kEngListRightX + 1 + o), static_cast<int16_t>(y + 1 + o),
                    static_cast<int16_t>(kEngListRightW - 2 - 2 * o), static_cast<int16_t>(h - 2 - 2 * o), RGB565_WHITE);
    }
  }
  gfx->setTextSize(1);
  gfx->setTextColor(isCurrent ? RGB565_BLACK : RGB565_WHITE);
  char buf[24];
  snprintf(buf, sizeof(buf), "%3d %s", patchIdx, az2::enginePatchName(trackEngine[t], static_cast<uint8_t>(patchIdx)));
  gfx->setCursor(static_cast<int16_t>(kEngListRightX + 6), static_cast<int16_t>(y + h / 2 - 4));
  gfx->print(buf);
}

void drawEngLists() {
  for (uint8_t i = 0; i < az2::kEngineCount; ++i) {
    drawEngListRow(i);
  }
  for (uint8_t s = 0; s < kEngListVisibleRows; ++s) {
    drawEngPatchRow(s);
  }
  // Cadre epais AUTOUR DE TOUTE LA LISTE qui a le focus croix
  // (2026-09-19, meme demande que le contour de ligne plus haut) --
  // dessine EN DERNIER (par-dessus les lignes) pour voir tout de suite
  // "de quel cote" on est (moteur ou patch), pas seulement quelle
  // ligne precise -- utile des qu'on hesite en un coup d'oeil rapide.
  if (!engOnTrackRow) {
    const uint16_t accent = kPalette[selectedEngineTrack % kPaletteCount];
    const int16_t boxX = engineColPatch ? kEngListRightX : kMargin;
    const int16_t boxW = engineColPatch ? kEngListRightW : kEngListLeftW;
    for (int16_t o = 0; o < 3; ++o) {
      gfx->drawRect(static_cast<int16_t>(boxX - o), static_cast<int16_t>(kEngListTop - o),
                    static_cast<int16_t>(boxW + 2 * o), static_cast<int16_t>(kEngListH + 2 * o), accent);
    }
  }
}

// Bandeau "mini reglages" en bas -- resume le patch actif (2 lignes
// cles selon le moteur, meme logique que patchRowLabel()/
// patchParamRef() de la page PATCH), tactile : ouvre cette meme page
// PATCH complete pour aller plus loin (voir hitTestEngMini()).
void drawEngMiniPatch() {
  const uint8_t t = static_cast<uint8_t>(selectedEngineTrack);
  const uint16_t accent = kPalette[t % kPaletteCount];
  const int16_t w = static_cast<int16_t>(kScreenSize - 2 * kMargin);

  gfx->fillRect(kMargin, kEngMiniY, w, kEngMiniH, RGB565_BLACK);
  gfx->drawRect(kMargin, kEngMiniY, w, kEngMiniH, accent);

  gfx->setTextSize(1);
  gfx->setTextColor(kDim);
  gfx->setCursor(static_cast<int16_t>(kMargin + 8), static_cast<int16_t>(kEngMiniY + 4));
  gfx->print("REGLAGES DU PATCH -- toucher pour tout regler >");

  gfx->setTextSize(2);
  gfx->setTextColor(RGB565_WHITE);
  char buf[28];
  if (trackEngine[t] == az2::kEngineDexed) {
    snprintf(buf, sizeof(buf), "ALGO %d  FDBK %d", trackAlgo[t] + 1, trackFeedback[t]);
  } else {
    snprintf(buf, sizeof(buf), "CUTOFF %d  RESO %d", trackCutoff[t], trackReso[t]);
  }
  gfx->setCursor(static_cast<int16_t>(kMargin + 8), static_cast<int16_t>(kEngMiniY + 20));
  gfx->print(buf);

  gfx->setTextSize(1);
  gfx->setTextColor(accent);
  gfx->setCursor(static_cast<int16_t>(kMargin + 8), static_cast<int16_t>(kEngMiniY + 46));
  gfx->print(az2::enginePatchName(trackEngine[t], trackPatch[t]));
}

bool hitTestEngMini(int16_t x, int16_t y) {
  return inBox(x, y, kMargin, kEngMiniY, static_cast<int16_t>(kScreenSize - 2 * kMargin), kEngMiniH);
}

void drawEnginesPage() {
  drawSubHeader("MOTEURS", kPalette[2]);
  drawEngTrackRow();
  drawEngLists();
  drawEngMiniPatch();
}

// Renvoie l'index de moteur (0-5) touche dans la liste GAUCHE, -1 si
// hors zone.
int8_t hitTestEngListRow(int16_t x, int16_t y) {
  if (x < kMargin || x >= kMargin + kEngListLeftW || y < kEngListTop || y >= kEngListTop + kEngListH) {
    return -1;
  }
  return static_cast<int8_t>((y - kEngListTop) / kEngListRowH);
}

// Renvoie le SLOT (0..kEngListVisibleRows-1, PAS l'index de patch --
// voir engPatchScroll) touche dans la liste DROITE, -1 si hors zone.
int8_t hitTestEngPatchRow(int16_t x, int16_t y) {
  if (x < kEngListRightX || x >= kEngListRightX + kEngListRightW || y < kEngListTop || y >= kEngListTop + kEngListH) {
    return -1;
  }
  return static_cast<int8_t>((y - kEngListTop) / kEngListRowH);
}

// Redessin complet -- utilise par les echos ENGINE:/PATCH:/MUTE:/SOLO:
// (voir plus bas) qui redessinaient auparavant UNE ligne (drawEngRow(),
// ancien format 8 pistes) -- desormais un seul track affiche a la
// fois, un redessin complet est aussi simple et sans risque d'oubli.
void drawEngRow(uint8_t track) {
  if (track == selectedEngineTrack && currentScreen == Screen::Engines) {
    drawEnginesPage();
  }
}

// ---------------------------------------------------------------------
// Page PATCH -- filtre + ADSR + oscilloscope en direct, demande le
// 2026-09-15 ("on fait en sorte que nos moteurs audio soient completement
// configurables dans une fenetre ou on voit l'onde du son jouer evoluer
// en modifiant le patch ... il faut tout un filtre"). Colonne de gauche =
// coupure/resonance du filtre (FILT:, voir trackFilter[] cote Teensy),
// ADSR (ENV:, s'applique au moteur ANALOG -- voir handleEnvCommand()
// cote Teensy pour le pourquoi). Le tracer d'onde recoit les paquets
// SCOPE (voir kScopePacketMagic dans AZ2_Protocol.h) de la piste
// actuellement affichee -- envoie SCOPE:piste en entrant/changeant de
// piste, SCOPE:OFF en quittant (voir goTo()).
// ---------------------------------------------------------------------
int8_t patchTrack = 0;
// true = focus croix sur la ligne PISTE en haut (GAUCHE/DROITE change
// alors la piste), false = focus dans la grille de parametres (voir
// selectedPatchRow, declare plus bas) -- meme convention que
// engOnTrackRow sur la page MOTEURS (2026-09-19, "la droite gauche
// change les piste il faut que ca change les reglages selectionnes
// [a la place]") : on atteint la ligne PISTE en montant (HAUT) depuis
// la toute premiere ligne de la grille, jamais autrement. Declare ici
// (avant drawPatchTrackRow()) plutot qu'aux cotes de selectedPatchRow
// car utilise des la definition de cette fonction, plus bas dans ce
// meme bloc.
bool patchOnTrackRow = false;
// cutoff, resonance, attaque, chute, maintien, relachement -- tous 0-127,
// memes defauts "neutres" que cote Teensy (grand ouvert / ADSR rapide).
// PAR PISTE (pas juste un etat transitoire de la page PATCH) -- demande
// 2026-09-16 ("on affiche les reglages [de patch] du cote droit [du
// sequenceur]") : il faut connaitre les vraies valeurs de N'IMPORTE
// QUELLE piste pour les montrer dans le panneau lateral du sequenceur
// (voir drawTrkSidePanel()), pas seulement celle actuellement ouverte
// sur la page PATCH (patchTrack). Mises a jour par les echos FILT:/
// ENV: du Teensy (voir handleTeensyLine()), pas seulement par les
// boutons -/+ de cette page.
uint8_t trackCutoff[kSeqTrackCount];
uint8_t trackReso[kSeqTrackCount];
uint8_t trackAttack[kSeqTrackCount];
uint8_t trackDecay[kSeqTrackCount];
uint8_t trackSustain[kSeqTrackCount];
uint8_t trackRelease[kSeqTrackCount];
// Reglages propres au moteur DEXED (DXP:, voir handleDexedParamCommand()
// cote Teensy) -- demande 2026-09-16 ("il faut des reglages, on a pas de
// reglages dans la fenetre dexed du tracker") : l'ADSR generique
// (ENV:) n'est PAS ecoutee par Dexed (sa propre EG interne au patch DX7
// la remplace), une piste Dexed n'avait donc aucun reglage utile sur la
// page PATCH avant ca. Algorithme stocke brut 0-31 (affiche +1, cf.
// convention DX7 1-32), feedback 0-7.
uint8_t trackAlgo[kSeqTrackCount] = {};
uint8_t trackFeedback[kSeqTrackCount] = {};
const char *const kPatchLabels[6] = {"CUTOFF", "RESONANCE", "ATTACK", "DECAY", "SUSTAIN", "RELEASE"};
const char *const kPatchLabelsDexed[6] = {"CUTOFF", "RESONANCE", "ALGO (DX7)", "FEEDBACK", "--", "--"};

// Lignes 2-5 de la page PATCH dependent du moteur de la piste : ADSR
// generique pour tout le monde SAUF Dexed (rows 4-5 sans effet chez lui,
// voir le commentaire au-dessus de trackAlgo[]). Ne concerne QUE les 6
// lignes fixes (0-5) -- "row < 6" ajoute avec les lignes extra
// (2026-09-18) : sans lui, "row >= 4" desactiverait a tort TOUTES les
// lignes extra de DEXED (6 et plus), qui n'ont rien a voir avec ce cas
// Dexed-ADSR precis. Les appelants ne doivent d'ailleurs appeler ceci
// que pour row < 6 (voir patchExtraCount()/patchVolRow() pour le reste
// de la page) -- le clamp reste par securite si jamais appele hors de
// ce domaine.
bool patchRowActive(uint8_t track, uint8_t row) {
  return !(trackEngine[track] == az2::kEngineDexed && row >= 4 && row < 6);
}

const char *patchRowLabel(uint8_t track, uint8_t row) {
  return (trackEngine[track] == az2::kEngineDexed) ? kPatchLabelsDexed[row] : kPatchLabels[row];
}

uint8_t patchRowMax(uint8_t track, uint8_t row) {
  if (trackEngine[track] == az2::kEngineDexed) {
    if (row == 2) return 31;  // ALGO : 32 algorithmes DX7 (0-31)
    if (row == 3) return 7;   // FEEDBACK : 0-7
  }
  return 127;
}

// Reference directe dans le tableau du bon parametre pour une piste
// donnee -- evite de dupliquer un switch partout ou un reglage est
// lu/ecrit (page PATCH ET panneau lateral du sequenceur). Rows 4-5 sur
// une piste Dexed renvoient un stockage inerte (trackSustain/Release,
// jamais envoyes -- voir patchRowActive(), la page ne dessine ni
// n'autorise le toucher dessus).
uint8_t &patchParamRef(uint8_t track, uint8_t row) {
  if (trackEngine[track] == az2::kEngineDexed) {
    switch (row) {
      case 0: return trackCutoff[track];
      case 1: return trackReso[track];
      case 2: return trackAlgo[track];
      case 3: return trackFeedback[track];
      case 4: return trackSustain[track];
      default: return trackRelease[track];
    }
  }
  switch (row) {
    case 0: return trackCutoff[track];
    case 1: return trackReso[track];
    case 2: return trackAttack[track];
    case 3: return trackDecay[track];
    case 4: return trackSustain[track];
    default: return trackRelease[track];
  }
}

// ---------------------------------------------------------------------
// Lignes "extra" de la page PATCH (2026-09-18, "un editeur de patch
// complet et completement reglable ... sovegardable") -- au-dela des
// 6 lignes filtre/ADSR-ou-DXP fixes ci-dessus, chaque moteur peut
// exposer un nombre different de parametres supplementaires (DXR:/EXP:/
// BXP: cote Teensy, voir handleDexedRawCommand()/handleEPianoParamCommand()/
// handleBraidsParamCommand()). Ces lignes viennent APRES les 6 lignes
// fixes et AVANT volume/slot (qui se decalent donc dynamiquement --
// voir patchVolRow()/patchSlotRow() -- au lieu d'etre fixes a 6/7).
// KARPLUS/ANALOG n'ont rien de plus a exposer (0 ligne extra, page
// inchangee -- meme mise en page qu'avant ce chantier).
uint8_t patchExtraCount(uint8_t track) {
  switch (trackEngine[track]) {
    case az2::kEngineDexed: return 17;   // parametres globaux DX7 (hors algo/feedback deja lignes 2-3, hors nom)
    case az2::kEngineEPiano: return 12;  // les 12 parametres continus mdaEPiano
    case az2::kEngineBraids: return 2;   // color, timbre (shape reste sur la page MOTEURS)
    default: return 0;
  }
}
uint8_t patchVolRow(uint8_t track) { return static_cast<uint8_t>(6 + patchExtraCount(track)); }
uint8_t patchSlotRow(uint8_t track) { return static_cast<uint8_t>(patchVolRow(track) + 1); }
uint8_t patchTotalRows(uint8_t track) { return static_cast<uint8_t>(patchSlotRow(track) + 1); }

// 2 parametres par ligne VISUELLE (2026-09-19, "mettre 2 reglage par
// ligne pour gagner de la place") -- tous les parametres "simples"
// (0..patchVolRow(track) inclus, donc VOLUME participe aussi a la
// paire) partagent leur ligne 2 par 2 ; SLOT (le dernier, 3 sous-
// boutons deja denses -- SLOT/SAVE/LOAD) reste TOUJOURS seul sur sa
// propre ligne. logicalRow reste le meme index qu'avant (0-5 base,
// 6..volRow-1 extra, volRow=volume, slotRow=slot) -- seule la
// POSITION A L'ECRAN change ici, pas la numerotation logique (utilisee
// par selectedPatchRow/patchScroll, la navigation croix reste
// coherente sans etre reecrite en profondeur).
int16_t patchVisualRow(uint8_t track, uint8_t logicalRow) {
  const uint8_t volRow = patchVolRow(track);
  if (logicalRow <= volRow) {
    return static_cast<int16_t>(logicalRow / 2);
  }
  return static_cast<int16_t>((volRow + 2) / 2);  // = ceil((volRow+1)/2), la ligne SLOT juste apres les paires
}
uint8_t patchTotalVisualRows(uint8_t track) {
  const uint8_t volRow = patchVolRow(track);
  return static_cast<uint8_t>((volRow + 2) / 2 + 1);
}
// true = colonne DROITE (logicalRow impair), false = GAUCHE -- sans
// objet pour la ligne SLOT (toujours pleine largeur, jamais appele
// pour elle).
bool patchIsRightCol(uint8_t logicalRow) { return (logicalRow % 2) == 1; }

// Deplacement HAUT/BAS (2026-09-19, suite du chantier "2 reglages par
// ligne") : monte/descend d'une ligne VISUELLE en gardant la meme
// colonne (gauche/droite) quand elle existe, saute les lignes
// inactives (DEXED 4-5, voir patchRowActive()). Renvoie -1 quand on
// doit sortir vers la ligne PISTE (HAUT depuis la toute premiere
// ligne) -- l'appelant bascule alors patchOnTrackRow. Ne bouge pas
// (renvoie `row` tel quel) quand on est deja sur la derniere ligne
// (BAS depuis SLOT).
int8_t patchStepVisual(uint8_t track, int8_t row, int8_t dir) {
  const uint8_t volRow = patchVolRow(track);
  const uint8_t slotRow = patchSlotRow(track);
  const int16_t slotVisual = patchVisualRow(track, slotRow);
  const bool wasRight = (row <= static_cast<int8_t>(volRow)) && patchIsRightCol(static_cast<uint8_t>(row));
  int16_t visualRow = patchVisualRow(track, static_cast<uint8_t>(row));
  for (;;) {
    visualRow = static_cast<int16_t>(visualRow + dir);
    if (visualRow < 0) {
      return -1;
    }
    if (visualRow > slotVisual) {
      return row;
    }
    int8_t candidate;
    if (visualRow == slotVisual) {
      candidate = static_cast<int8_t>(slotRow);
    } else {
      const int8_t left = static_cast<int8_t>(visualRow * 2);
      const int8_t right = static_cast<int8_t>(visualRow * 2 + 1);
      candidate = (wasRight && right <= static_cast<int8_t>(volRow)) ? right : left;
    }
    if (candidate == static_cast<int8_t>(slotRow) || candidate >= 6 ||
        patchRowActive(track, static_cast<uint8_t>(candidate))) {
      return candidate;
    }
    // Ligne inactive : continue de chercher dans la meme direction
    // plutot que de s'arreter dessus (meme esprit que la boucle
    // GAUCHE/DROITE ci-dessous).
  }
}

// Deplacement GAUCHE/DROITE (2026-09-19, "la droite gauche [doit]
// changer les reglages selectionnes [dans la fenetre des patch]" --
// avant, GAUCHE/DROITE changeait de piste ici ; ce role passe
// desormais a la ligne PISTE, voir patchOnTrackRow) : parcourt l'ORDRE
// LOGIQUE des parametres (0,1 = 1ere ligne visuelle colonne gauche/
// droite, 2,3 = 2e ligne, etc.) -- comme une grille lue de gauche a
// droite puis ligne suivante, ce qui fait naturellement alterner les
// 2 colonnes d'une meme ligne puis passer a la ligne suivante en
// bout de course. Boucle (dernier <-> premier), saute les lignes
// inactives.
int8_t patchStepLogical(uint8_t track, int8_t row, int8_t dir, uint8_t total) {
  int8_t next = row;
  for (uint8_t tries = 0; tries < total; ++tries) {
    next = static_cast<int8_t>(((next + dir) % total + total) % total);
    if (next >= 6 || patchRowActive(track, static_cast<uint8_t>(next))) {
      return next;
    }
  }
  return row;
}

// Octet brut DXR (0-144) pour chaque ligne extra DEXED, dans l'ordre
// d'affichage -- voir DexedVoiceParameters dans dexed.h cote Teensy
// (offset 126 dans le buffer deballe, ajoute ici a l'envoi/la lecture).
// ALGO/FEEDBACK/NOM exclus (deja geres ou hors scope, voir
// patchExtraCount()).
constexpr uint8_t kDexedExtraRaw[17] = {
    0, 1, 2, 3, 4, 5, 6, 7,  // PEG R1-4, L1-4
    10,                      // OSC_KEY_SYNC
    11, 12, 13, 14,          // LFO SPEED/DELAY/PMD/AMD
    15, 16, 17,              // LFO SYNC/WAVE/PMS
    18,                      // TRANSPOSE
};
constexpr const char *kDexedExtraLabel[17] = {
    "PEG R1", "PEG R2", "PEG R3", "PEG R4", "PEG L1", "PEG L2", "PEG L3", "PEG L4",
    "KEY SYNC", "LFO SPEED", "LFO DELAY", "LFO PMD", "LFO AMD", "LFO SYNC", "LFO WAVE", "LFO PMS",
    "TRANSPOSE",
};
constexpr uint8_t kDexedExtraMax[17] = {
    99, 99, 99, 99, 99, 99, 99, 99,
    1, 99, 99, 99, 99, 1, 5, 7,
    48,
};

constexpr const char *kEPianoExtraLabel[12] = {
    "DECAY", "RELEASE", "HARDNESS", "TREBLE", "TREMOLO", "LFO RATE",
    "VEL SENSE", "STEREO", "TUNE", "DETUNE", "OVERDRIVE", "VOLUME",
};

constexpr const char *kBraidsExtraLabel[2] = {"COLOR", "TIMBRE"};

const char *patchExtraLabel(uint8_t track, uint8_t extraIdx) {
  switch (trackEngine[track]) {
    case az2::kEngineDexed: return kDexedExtraLabel[extraIdx];
    case az2::kEngineEPiano: return kEPianoExtraLabel[extraIdx];
    case az2::kEngineBraids: return kBraidsExtraLabel[extraIdx];
    default: return "?";
  }
}

uint8_t patchExtraMax(uint8_t track, uint8_t extraIdx) {
  // EPIANO/BRAIDS : toutes leurs lignes extra sont sur l'echelle
  // 0-127 (voir EXP:/BXP: cote Teensy) -- seul DEXED a une plage
  // reelle differente par parametre (voir kDexedExtraMax, reprise des
  // vraies bornes DX7).
  if (trackEngine[track] == az2::kEngineDexed) {
    return kDexedExtraMax[extraIdx];
  }
  return 127;
}

// Valeur courante de chaque ligne extra, par piste -- 17 = le plus
// grand des 3 moteurs concernes (DEXED), reutilise tel quel pour
// EPIANO (12) et BRAIDS (2), le reste de la ligne n'etant simplement
// jamais lu/affiche pour ces moteurs (voir patchExtraCount()).
uint8_t patchExtraVal[kSeqTrackCount][17] = {};

void sendPatchExtra(uint8_t track, uint8_t extraIdx) {
  char msg[24];
  switch (trackEngine[track]) {
    case az2::kEngineDexed:
      snprintf(msg, sizeof(msg), "DXR:%d:%d:%d", track, kDexedExtraRaw[extraIdx], patchExtraVal[track][extraIdx]);
      break;
    case az2::kEngineEPiano:
      snprintf(msg, sizeof(msg), "EXP:%d:%d:%d", track, extraIdx, patchExtraVal[track][extraIdx]);
      break;
    case az2::kEngineBraids:
      snprintf(msg, sizeof(msg), "BXP:%d:%d:%d", track, extraIdx, patchExtraVal[track][extraIdx]);
      break;
    default:
      return;
  }
  sendToTeensy(msg);
}

// Interroge le Teensy pour peupler patchExtraVal[track][] a l'entree
// sur la page/piste/moteur -- sans ca, l'ecran afficherait 0 pour tout
// tant que l'utilisateur n'a pas lui-meme modifie chaque ligne au
// moins une fois. Les reponses arrivent en DXR:/EXP: (BXP: n'a pas de
// forme "?", voir handleBraidsParamCommand() cote Teensy -- write-only,
// pas grave : color/timbre partent a 0 a l'affectation du moteur, une
// valeur de depart raisonnable pour 2 reglages de couleur sonore).
void queryPatchExtra(uint8_t track) {
  const uint8_t count = patchExtraCount(track);
  char msg[16];
  for (uint8_t i = 0; i < count; ++i) {
    if (trackEngine[track] == az2::kEngineDexed) {
      snprintf(msg, sizeof(msg), "DXR?%d:%d", track, kDexedExtraRaw[i]);
      sendToTeensy(msg);
    } else if (trackEngine[track] == az2::kEngineEPiano) {
      snprintf(msg, sizeof(msg), "EXP?%d:%d", track, i);
      sendToTeensy(msg);
    }
  }
}

uint8_t scopeSamples[az2::kScopeSamplesPerPacket] = {};
bool scopeHasData = false;

constexpr int16_t kPatchTrackRowY = 66;
constexpr int16_t kPatchScopeTop = 96;
constexpr int16_t kPatchScopeH = 90;
constexpr int16_t kPatchRowTop = kPatchScopeTop + kPatchScopeH + 14;
constexpr int16_t kPatchRowH = 34;

void drawPatchTrackRow() {
  const int16_t w = static_cast<int16_t>(kScreenSize - 2 * kMargin);
  gfx->fillRect(kMargin, kPatchTrackRowY, w, 22, RGB565_BLACK);
  // Contour blanc quand le focus croix est sur cette ligne (2026-09-19,
  // meme convention que drawEngTrackRow()/engOnTrackRow sur la page
  // MOTEURS) -- seul indice visuel de "ou" on est avant de bouger,
  // important puisque GAUCHE/DROITE change de sens selon le focus
  // (piste ici, reglage de patch sinon).
  if (patchOnTrackRow) {
    gfx->drawRect(kMargin, kPatchTrackRowY, w, 22, RGB565_WHITE);
  }
  gfx->setTextSize(2);
  gfx->setTextColor(kPalette[patchTrack % kPaletteCount]);
  char buf[16];
  snprintf(buf, sizeof(buf), "< PISTE %d >", patchTrack + 1);  // +1 : affichage "plus musicien"
  gfx->setCursor(static_cast<int16_t>(kScreenSize / 2 - 55), kPatchTrackRowY);
  gfx->print(buf);
}

// N'efface/redessine QUE l'interieur (pas le cadre, voir drawPatchPage()
// qui le dessine une seule fois en entrant sur la page) -- appelee a
// chaque paquet SCOPE recu (~15/s, voir kScopeSendIntervalMs cote
// Teensy), redessiner le cadre a chaque fois donnait un effet de
// scintillement genant ("la fenetre patch ... elle scintille un peu
// trop").
void drawPatchScope() {
  gfx->fillRect(static_cast<int16_t>(kMargin + 1), static_cast<int16_t>(kPatchScopeTop + 1),
                static_cast<int16_t>(kScreenSize - 2 * kMargin - 2), static_cast<int16_t>(kPatchScopeH - 2),
                RGB565_BLACK);
  if (!scopeHasData) {
    gfx->setTextSize(1);
    gfx->setTextColor(kDim);
    gfx->setCursor(static_cast<int16_t>(kMargin + 8), static_cast<int16_t>(kPatchScopeTop + kPatchScopeH / 2 - 4));
    gfx->print("(silence -- joue une note sur cette piste)");
    return;
  }
  const int16_t w = static_cast<int16_t>(kScreenSize - 2 * kMargin);
  int16_t prevX = kMargin, prevY = static_cast<int16_t>(kPatchScopeTop + kPatchScopeH / 2);
  const uint16_t traceColor = kPalette[patchTrack % kPaletteCount];
  for (uint8_t i = 0; i < az2::kScopeSamplesPerPacket; ++i) {
    const int16_t x = static_cast<int16_t>(kMargin + (i * w) / (az2::kScopeSamplesPerPacket - 1));
    const int16_t y = static_cast<int16_t>(kPatchScopeTop + 1 +
                                            ((255 - scopeSamples[i]) * (kPatchScopeH - 2)) / 255);
    if (i > 0) {
      gfx->drawLine(prevX, prevY, x, y, traceColor);
    }
    prevX = x;
    prevY = y;
  }
}

// Nombre de lignes VISUELLES affichees a l'ecran en meme temps --
// INCHANGE depuis l'origine de cette page (8, meme disposition pixel),
// mais depuis le 2026-09-19 chaque ligne visuelle peut contenir 2
// parametres LOGIQUES (voir patchVisualRow()) -- la fenetre defile
// desormais sur des lignes VISUELLES, pas logiques.
constexpr uint8_t kPatchVisibleRows = 8;
uint8_t patchScroll = 0;  // 1ere ligne VISUELLE affichee en haut de la fenetre
constexpr int16_t kPatchColGap = 8;

// Si le parametre logique `logicalRow` est actuellement dans la
// fenetre visible, calcule sa position (y/x/largeur -- x/w different
// selon la colonne gauche/droite pour les lignes appariees, voir
// patchVisualRow()/patchIsRightCol(), SLOT reste seule/pleine largeur)
// et renvoie true ; sinon renvoie false SANS rien dessiner -- les
// appelants existants (echo FILT:/ENV:/DXP:/VOL: notamment)
// redessinent par NUMERO DE PARAMETRE LOGIQUE, pas par position
// ecran : quand ce parametre est scrolle hors champ, le bon geste est
// de ne rien dessiner (le shadow reste a jour, il se redessine
// correctement au retour), pas de planter ou de dessiner au mauvais
// endroit.
bool patchRowVisible(uint8_t logicalRow, int16_t &y, int16_t &x, int16_t &w) {
  const uint8_t track = static_cast<uint8_t>(patchTrack);
  const uint8_t volRow = patchVolRow(track);
  const int16_t visualRow = patchVisualRow(track, logicalRow);
  if (visualRow < patchScroll || visualRow >= patchScroll + kPatchVisibleRows) {
    return false;
  }
  y = static_cast<int16_t>(kPatchRowTop + (visualRow - patchScroll) * kPatchRowH);
  if (logicalRow > volRow) {
    // Ligne SLOT : seule sur sa ligne, pleine largeur.
    x = kMargin;
    w = static_cast<int16_t>(kScreenSize - 2 * kMargin);
    return true;
  }
  const int16_t halfW = static_cast<int16_t>((kScreenSize - 2 * kMargin - kPatchColGap) / 2);
  x = patchIsRightCol(logicalRow) ? static_cast<int16_t>(kMargin + halfW + kPatchColGap) : kMargin;
  w = halfW;
  return true;
}

// Ligne selectionnee par la croix (2026-09-18, retour utilisateur sur
// materiel reel : "la fenetre de patch on peut rien regler avec les
// boutons" -- comme le panneau tracker avant son propre fix, cette page
// n'etait pilotable qu'au tactile). 0-5 = les 6 lignes filtre/ADSR-ou-
// DXP (voir patchParamRef()), 6..patchVolRow(t)-1 = les lignes extra du
// moteur (voir patchExtraCount()), puis VOLUME puis SLOT/SAVE/LOAD
// (index dynamique, voir patchVolRow()/patchSlotRow() -- ne sont plus
// fixes a 6/7 depuis l'ajout des lignes extra). Meme convention que
// seqDetailCol : GAUCHE/DROITE changent la piste (patchTrack), HAUT/BAS
// SEULS deplacent la ligne selectionnee, A maintenu + HAUT/BAS edite sa
// valeur -- SAUF sur la ligne SLOT ou A maintenu + GAUCHE/DROITE
// declenchent SAVE/LOAD (pas une valeur continue) -- voir le
// gestionnaire de croix plus bas.
int8_t selectedPatchRow = 0;

// Dessine le parametre LOGIQUE `i` (0-5 uniquement -- les lignes extra
// ont leur propre fonction, drawPatchExtraRow() plus bas) si il est
// actuellement visible dans la fenetre de defilement ; ne fait rien
// sinon (voir patchRowVisible()). Demi-largeur depuis le 2026-09-19
// ("mettre 2 reglage par ligne pour gagner de la place") -- PLUS de
// boutons tactiles +/- ici (pas la place, voir le commentaire de
// patchRowVisible()) : edition croix uniquement (A maintenu +
// HAUT/BAS), deja le moyen principal utilise partout ce soir. Le
// tactile reste utile pour SELECTIONNER une case (tap = select),
// juste plus pour l'editer directement.
void drawPatchRow(uint8_t i) {
  int16_t y, x, w;
  if (!patchRowVisible(i, y, x, w)) {
    return;
  }
  const int16_t rowH = static_cast<int16_t>(kPatchRowH - 4);
  const uint8_t track = static_cast<uint8_t>(patchTrack);
  const bool rowSelected = !patchOnTrackRow && (selectedPatchRow == static_cast<int8_t>(i));
  const uint16_t accent = kPalette[track % kPaletteCount];

  gfx->fillRect(x, y, w, rowH, RGB565_BLACK);

  if (!patchRowActive(track, i)) {
    // Piste DEXED : lignes 4-5 sans effet (ADSR generique non ecoutee,
    // voir patchRowActive()) -- grisees plutot qu'une valeur qui ne
    // sert a rien pour ce moteur.
    gfx->drawRect(x, y, w, rowH, kFaint);
    gfx->setTextSize(1);
    gfx->setTextColor(kFaint);
    gfx->setCursor(static_cast<int16_t>(x + 4), static_cast<int16_t>(y + 4));
    gfx->print("(sans effet)");
    return;
  }

  gfx->drawRect(x, y, w, rowH, rowSelected ? accent : kFaint);

  gfx->setTextSize(1);
  gfx->setTextColor(kDim);
  gfx->setCursor(static_cast<int16_t>(x + 4), static_cast<int16_t>(y + 3));
  gfx->print(patchRowLabel(track, i));

  // ALGO (Dexed) affiche 1-32 (convention DX7), stocke 0-31 en interne.
  const bool isDexedAlgo = (trackEngine[track] == az2::kEngineDexed && i == 2);
  const uint8_t raw = patchParamRef(track, i);
  char buf[6];
  snprintf(buf, sizeof(buf), "%3d", isDexedAlgo ? raw + 1 : raw);
  gfx->setTextSize(2);
  gfx->setTextColor(RGB565_WHITE);
  gfx->setCursor(static_cast<int16_t>(x + w - 34), static_cast<int16_t>(y + 3));
  gfx->print(buf);
}

// Dessine une ligne EXTRA (logicalRow >= 6, < patchVolRow(track)) --
// meme habillage visuel que drawPatchRow() ci-dessus (demi-largeur,
// sans boutons tactiles +/-, voir son commentaire), juste une source
// de donnees differente (patchExtraVal[] au lieu de patchParamRef()).
// Ne fait rien si hors fenetre visible, meme convention que
// drawPatchRow().
void drawPatchExtraRow(uint8_t logicalRow) {
  int16_t y, x, w;
  if (!patchRowVisible(logicalRow, y, x, w)) {
    return;
  }
  const int16_t rowH = static_cast<int16_t>(kPatchRowH - 4);
  const uint8_t track = static_cast<uint8_t>(patchTrack);
  const uint8_t extraIdx = static_cast<uint8_t>(logicalRow - 6);
  const bool rowSelected = !patchOnTrackRow && (selectedPatchRow == static_cast<int8_t>(logicalRow));
  const uint16_t accent = kPalette[track % kPaletteCount];

  gfx->fillRect(x, y, w, rowH, RGB565_BLACK);
  gfx->drawRect(x, y, w, rowH, rowSelected ? accent : kFaint);

  gfx->setTextSize(1);
  gfx->setTextColor(kDim);
  gfx->setCursor(static_cast<int16_t>(x + 4), static_cast<int16_t>(y + 3));
  gfx->print(patchExtraLabel(track, extraIdx));

  char buf[6];
  snprintf(buf, sizeof(buf), "%3d", patchExtraVal[track][extraIdx]);
  gfx->setTextSize(2);
  gfx->setTextColor(RGB565_WHITE);
  gfx->setCursor(static_cast<int16_t>(x + w - 34), static_cast<int16_t>(y + 3));
  gfx->print(buf);
}

void sendPatchFilt() {
  const uint8_t t = static_cast<uint8_t>(patchTrack);
  char msg[24];
  snprintf(msg, sizeof(msg), "FILT:%d:%d:%d", patchTrack, trackCutoff[t], trackReso[t]);
  sendToTeensy(msg);
}

void sendPatchEnv() {
  const uint8_t t = static_cast<uint8_t>(patchTrack);
  char msg[24];
  snprintf(msg, sizeof(msg), "ENV:%d:%d:%d:%d:%d", patchTrack, trackAttack[t], trackDecay[t], trackSustain[t],
           trackRelease[t]);
  sendToTeensy(msg);
}

// index : 0=algorithme, 1=feedback -- voir handleDexedParamCommand()
// cote Teensy.
void sendPatchDxp(uint8_t index) {
  const uint8_t t = static_cast<uint8_t>(patchTrack);
  char msg[24];
  snprintf(msg, sizeof(msg), "DXP:%d:%d:%d", t, index, index == 0 ? trackAlgo[t] : trackFeedback[t]);
  sendToTeensy(msg);
}

// Volume par piste (VOL:, priorite #4 de la liste indispensable,
// AZ2_BENCHMARK_CONCURRENCE.md) -- 7e ligne, VOLONTAIREMENT separee du
// systeme patchParamRef()/patchRowLabel() des 6 lignes filtre/ADSR-ou-
// DXP au-dessus (celui-ci change de sens selon le moteur, le volume
// s'applique lui a TOUS les moteurs de la meme facon -- pas la peine de
// le meler a cette logique conditionnelle). Voir trackVolume[] et le
// commentaire du piege Braids cote Teensy (AZ2_FEUILLE_DE_ROUTE.md).
uint8_t trackVolume[kSeqTrackCount] = {127, 127, 127, 127, 127, 127, 127, 127};

// VOLUME participe desormais a l'appariement 2-par-ligne comme les
// autres parametres simples (2026-09-19) -- meme habillage/memes
// contraintes de largeur que drawPatchRow(), plus de boutons tactiles
// +/- (voir son commentaire).
void drawVolRow() {
  const uint8_t t = static_cast<uint8_t>(patchTrack);
  int16_t y, x, w;
  if (!patchRowVisible(patchVolRow(t), y, x, w)) {
    return;
  }
  const int16_t rowH = static_cast<int16_t>(kPatchRowH - 4);
  const bool rowSelected = !patchOnTrackRow && (selectedPatchRow == static_cast<int8_t>(patchVolRow(t)));
  const uint16_t accent = kPalette[t % kPaletteCount];

  gfx->fillRect(x, y, w, rowH, RGB565_BLACK);
  gfx->drawRect(x, y, w, rowH, rowSelected ? accent : kFaint);

  gfx->setTextSize(1);
  gfx->setTextColor(kDim);
  gfx->setCursor(static_cast<int16_t>(x + 4), static_cast<int16_t>(y + 3));
  gfx->print("VOLUME");

  char buf[6];
  snprintf(buf, sizeof(buf), "%3d", trackVolume[t]);
  gfx->setTextSize(2);
  gfx->setTextColor(RGB565_WHITE);
  gfx->setCursor(static_cast<int16_t>(x + w - 34), static_cast<int16_t>(y + 3));
  gfx->print(buf);
}

void sendPatchVol() {
  char msg[16];
  snprintf(msg, sizeof(msg), "VOL:%d:%d", patchTrack, trackVolume[static_cast<uint8_t>(patchTrack)]);
  sendToTeensy(msg);
}

// Sauvegarde/chargement de patch (demande 2026-09-16 : "on doit
// pouvoir sauvegarder les patch") -- un "patch" ici = moteur + patch
// integre + filtre + ADSR de la piste affichee (patchTrack), ecrit sur
// la carte SD de l'ESP32 (deja utilisee pour les ROM GB) dans
// /patches/N.txt, format simple "moteur,patch,cutoff,reso,a,d,s,r".
// 8 emplacements numerotes, comme les patterns.
constexpr uint8_t kPatchSlotCount = 8;
uint8_t patchSlot = 0;
constexpr int16_t kPatchSlotH = 32;
constexpr int16_t kPatchSlotBtnW = (kScreenSize - 2 * kMargin) / 3;

void drawPatchSlotRow() {
  const uint8_t t = static_cast<uint8_t>(patchTrack);
  int16_t y, rx, rw;
  if (!patchRowVisible(patchSlotRow(t), y, rx, rw)) {
    return;
  }
  const int16_t saveX = static_cast<int16_t>(kMargin + kPatchSlotBtnW);
  const int16_t loadX = static_cast<int16_t>(kMargin + 2 * kPatchSlotBtnW);
  const bool rowSelected = !patchOnTrackRow && (selectedPatchRow == static_cast<int8_t>(patchSlotRow(t)));
  const uint16_t accent = kPalette[t % kPaletteCount];
  gfx->fillRect(kMargin, y, kScreenSize - 2 * kMargin, kPatchSlotH, RGB565_BLACK);
  gfx->drawRect(kMargin, y, kPatchSlotBtnW, kPatchSlotH, rowSelected ? accent : kFaint);
  gfx->drawRect(saveX, y, kPatchSlotBtnW, kPatchSlotH, rowSelected ? accent : kFaint);
  gfx->drawRect(loadX, y, kPatchSlotBtnW, kPatchSlotH, rowSelected ? accent : kFaint);

  gfx->setTextSize(2);
  gfx->setTextColor(RGB565_WHITE);
  char buf[12];
  snprintf(buf, sizeof(buf), "SLOT %d", patchSlot);
  gfx->setCursor(static_cast<int16_t>(kMargin + 6), static_cast<int16_t>(y + 8));
  gfx->print(buf);

  gfx->setTextColor(kPalette[1 % kPaletteCount]);
  gfx->setCursor(static_cast<int16_t>(saveX + 14), static_cast<int16_t>(y + 8));
  gfx->print("SAVE");

  gfx->setTextColor(kPalette[2 % kPaletteCount]);
  gfx->setCursor(static_cast<int16_t>(loadX + 14), static_cast<int16_t>(y + 8));
  gfx->print("LOAD");
}

// Position dynamique (2026-09-19, bug reel trouve en reprenant ce
// chantier : ces 3 hitTest*() utilisaient encore une constante figee
// "kPatchSlotY" calculee pour l'ANCIENNE mise en page 1-reglage-par-
// ligne -- depuis l'appariement 2-par-ligne, la ligne SLOT n'est plus
// forcement a la position visuelle 7 (ex. KARPLUS/ANALOG, 0 ligne
// extra : elle tombe desormais en position visuelle 4), le tactile
// visait donc completement a cote sans jamais planter (juste un tap
// qui "ne fait rien"). Recalcule via patchRowVisible() a chaque appel,
// comme drawPatchSlotRow() le fait deja -- renvoie false si la ligne
// est actuellement scrollee hors champ (aucun hit possible).
bool hitTestPatchSlotNum(int16_t x, int16_t y) {
  int16_t ry, rx, rw;
  if (!patchRowVisible(patchSlotRow(static_cast<uint8_t>(patchTrack)), ry, rx, rw)) {
    return false;
  }
  return inBox(x, y, kMargin, ry, kPatchSlotBtnW, kPatchSlotH);
}
bool hitTestPatchSlotSave(int16_t x, int16_t y) {
  int16_t ry, rx, rw;
  if (!patchRowVisible(patchSlotRow(static_cast<uint8_t>(patchTrack)), ry, rx, rw)) {
    return false;
  }
  return inBox(x, y, static_cast<int16_t>(kMargin + kPatchSlotBtnW), ry, kPatchSlotBtnW, kPatchSlotH);
}
bool hitTestPatchSlotLoad(int16_t x, int16_t y) {
  int16_t ry, rx, rw;
  if (!patchRowVisible(patchSlotRow(static_cast<uint8_t>(patchTrack)), ry, rx, rw)) {
    return false;
  }
  return inBox(x, y, static_cast<int16_t>(kMargin + 2 * kPatchSlotBtnW), ry, kPatchSlotBtnW, kPatchSlotH);
}

// Ecrit tel quel (pas d'ajout) -- SD.remove() d'abord pour eviter tout
// risque d'ancien contenu residuel si FILE_WRITE ouvrait en ajout sur
// cette version de la lib (pas verifie, prudence peu couteuse ici).
// Ecriture ATOMIQUE (2026-09-19, defaut P1 signale par l'audit de
// code du meme jour) : l'ancien code faisait SD.remove(path) PUIS
// SD.open(path, FILE_WRITE) -- une coupure de courant, une erreur SD
// ou un plantage entre ces 2 etapes detruisait la derniere sauvegarde
// valide sans rien la remplacer. Sequence utilisee ici a la place
// (meme principe partout ou ce fichier sauvegarde quelque chose sur
// la carte SD -- patch, projet) : ecrit dans "<path>.tmp", verifie
// une taille non nulle, deplace l'ancien fichier (s'il existe) vers
// "<path>.bak", puis renomme le "tmp" vers le nom final. A aucun
// moment le fichier "final" n'est absent ou tronque -- soit l'ancien
// est encore la, soit le nouveau y est deja completement.
// `content` : callback qui ecrit dans le fichier ouvert (permet de
// reutiliser cette fonction pour un patch (1 ligne) ou un projet
// (bien plus long) sans dupliquer la logique tmp/bak/rename).
template <typename WriteFn>
bool atomicSaveFile(const char *path, WriteFn writeContent) {
  char tmpPath[40];
  char bakPath[40];
  snprintf(tmpPath, sizeof(tmpPath), "%s.tmp", path);
  snprintf(bakPath, sizeof(bakPath), "%s.bak", path);

  SD.remove(tmpPath);  // reste eventuel d'une tentative precedente avortee
  File f = SD.open(tmpPath, FILE_WRITE);
  if (!f) {
    return false;
  }
  writeContent(f);
  f.close();
  // Taille verifiee APRES fermeture, pas avant (bug reel trouve sur le
  // vrai materiel le 2026-09-19 : f.size() juste apres les f.printf()
  // mais AVANT f.close() renvoyait 0 sur cette implementation FS --
  // sans doute des octets pas encore vidanges/comptabilises tant que
  // le fichier reste ouvert -- ce qui faisait echouer TOUTE
  // sauvegarde avec PATCH_SAVE_ERROR/PROJECT_SAVE_ERROR alors que
  // l'ecriture elle-meme avait reussi. Reouvrir le fichier pour
  // verifier sa taille est donc fait expres, une seconde lecture, plus
  // lent mais fiable.
  File check = SD.open(tmpPath);
  const size_t written = check ? check.size() : 0;
  if (check) {
    check.close();
  }
  if (written == 0) {
    // Rien ecrit -- ne remplace surtout pas une sauvegarde valide par
    // un fichier vide, abandonne proprement.
    SD.remove(tmpPath);
    return false;
  }

  if (SD.exists(path)) {
    SD.remove(bakPath);  // .bak precedent, si un jour restaure manuellement puis jamais nettoye
    SD.rename(path, bakPath);
  }
  if (!SD.rename(tmpPath, path)) {
    // Echec du dernier renommage : restaure l'ancien fichier depuis le
    // backup plutot que de laisser "path" absent.
    SD.rename(bakPath, path);
    SD.remove(tmpPath);
    return false;
  }
  return true;
}

void savePatchSlot(uint8_t slot) {
  const uint8_t t = static_cast<uint8_t>(patchTrack);
  SD.mkdir("/patches");
  char path[24];
  snprintf(path, sizeof(path), "/patches/%d.txt", slot);

  // 10 champs depuis l'ajout DXP (algo/feedback Dexed, sinon perdus au
  // rechargement -- PATCH: recharge tout le voice data DX7 depuis la
  // banque, voir loadDexedPatch() cote Teensy). Fichiers a 8 champs
  // (avant DXP) restent lisibles, voir loadPatchSlot().
  const bool ok = atomicSaveFile(path, [&](File &f) {
    f.printf("%d,%d,%d,%d,%d,%d,%d,%d,%d,%d\n", trackEngine[t], trackPatch[t], trackCutoff[t], trackReso[t],
              trackAttack[t], trackDecay[t], trackSustain[t], trackRelease[t], trackAlgo[t], trackFeedback[t]);
  });
  if (!ok) {
    Serial.print("PATCH_SAVE_ERROR:");
    Serial.println(path);
    return;
  }
  Serial.print("PATCH_SAVED:");
  Serial.println(path);
}

// Charge le slot et APPLIQUE au Teensy (ENGINE:/PATCH:/FILT:/ENV:) --
// les tableaux locaux (trackEngine[] etc.) sont mis a jour par les
// echos normaux du Teensy une fois les commandes traitees, pas ici.
void loadPatchSlot(uint8_t slot) {
  char path[24];
  snprintf(path, sizeof(path), "/patches/%d.txt", slot);
  File f = SD.open(path);
  if (!f) {
    Serial.print("PATCH_LOAD_EMPTY:");
    Serial.println(path);
    return;
  }
  const String line = f.readStringUntil('\n');
  f.close();

  int vals[10] = {};
  int idx = 0;
  int start = 0;
  for (int i = 0; i <= line.length() && idx < 10; ++i) {
    if (i == line.length() || line.charAt(i) == ',') {
      vals[idx++] = line.substring(start, i).toInt();
      start = i + 1;
    }
  }
  if (idx < 8) {
    Serial.print("PATCH_LOAD_BADFILE:");
    Serial.println(path);
    return;
  }
  // Fichier a 8 champs (avant l'ajout DXP) : algo/feedback pas stockes,
  // laisse la banque de patch Dexed les fixer (comportement d'avant).
  const bool hasDxp = (idx >= 10);

  const uint8_t t = static_cast<uint8_t>(patchTrack);
  char msg[24];
  snprintf(msg, sizeof(msg), "ENGINE:%d:%d", t, vals[0]);
  sendToTeensy(msg);
  snprintf(msg, sizeof(msg), "PATCH:%d:%d", t, vals[1]);
  sendToTeensy(msg);
  snprintf(msg, sizeof(msg), "FILT:%d:%d:%d", t, vals[2], vals[3]);
  sendToTeensy(msg);
  snprintf(msg, sizeof(msg), "ENV:%d:%d:%d:%d:%d", t, vals[4], vals[5], vals[6], vals[7]);
  sendToTeensy(msg);
  if (hasDxp) {
    // Envoyes APRES PATCH: expres -- PATCH: recharge tout le voice data
    // DX7 depuis la banque (voir loadDexedPatch()), qui ecraserait ces
    // deux octets s'ils partaient avant.
    snprintf(msg, sizeof(msg), "DXP:%d:0:%d", t, vals[8]);
    sendToTeensy(msg);
    snprintf(msg, sizeof(msg), "DXP:%d:1:%d", t, vals[9]);
    sendToTeensy(msg);
  }
  Serial.print("PATCH_LOADED:");
  Serial.println(path);
}

// Dessine (ou efface) TOUTE la fenetre de 8 lignes visibles d'un coup
// -- utilisee par drawPatchPage() (premier affichage) ET par tout
// changement qui peut deplacer patchScroll (navigation croix au-dela
// des 6 lignes fixes, changement de piste/moteur). Plus simple et plus
// robuste qu'un redessin ligne-par-ligne "au bon endroit" une fois le
// defilement possible -- un peu plus de travail ecran, sans
// consequence (pas appelee a haute frequence, contrairement au tracer
// scope qui a son propre chemin dedie).
void drawPatchWindow() {
  const uint8_t t = static_cast<uint8_t>(patchTrack);
  const uint8_t total = patchTotalRows(t);
  const uint8_t volRow = patchVolRow(t);
  const uint8_t slotRow = patchSlotRow(t);
  for (uint8_t slot = 0; slot < kPatchVisibleRows; ++slot) {
    const uint8_t logicalRow = static_cast<uint8_t>(patchScroll + slot);
    if (logicalRow >= total) {
      int16_t y, rx, rw;
      if (patchRowVisible(logicalRow, y, rx, rw)) {
        gfx->fillRect(kMargin, y, kScreenSize - 2 * kMargin, kPatchRowH - 4, RGB565_BLACK);
      }
      continue;
    }
    if (logicalRow < 6) {
      drawPatchRow(logicalRow);
    } else if (logicalRow == volRow) {
      drawVolRow();
    } else if (logicalRow == slotRow) {
      drawPatchSlotRow();
    } else {
      drawPatchExtraRow(logicalRow);
    }
  }
}

// Redessine UNE ligne logique par son numero, quel que soit son type
// (fixe/extra/volume/slot) -- petit repartiteur utilise par la
// navigation croix (deux lignes a rafraichir a chaque pas : celle
// qu'on quitte et celle qu'on selectionne), pour ne pas dupliquer ce
// if/else a chaque appel.
void redrawPatchLogicalRow(uint8_t track, uint8_t row) {
  if (row < 6) {
    drawPatchRow(row);
  } else if (row == patchVolRow(track)) {
    drawVolRow();
  } else if (row == patchSlotRow(track)) {
    drawPatchSlotRow();
  } else {
    drawPatchExtraRow(row);
  }
}

// Ligne LOGIQUE controlee par l'encodeur `slot` (0=encodeur1, 1=
// encodeur2) etant donne la selection croix actuelle -- les 2
// encodeurs "reglables" agissent sur les 2 valeurs de la ligne
// VISUELLE actuellement selectionnee (voir patchVisualRow()), meme
// quand une seule des deux est "selectionnee" par la croix (voir
// selectedPatchRow) : acces tactile direct aux 2 valeurs d'un coup,
// complement naturel du reglage croix (2026-09-19, "les 2 [encodeurs]
// peuvent servir aux reglages de parametres ... on les utilise pas
// assez"). -1 si cet encodeur n'a rien a controler sur la ligne
// actuelle (ex: encodeur 2 sur SLOT, ou sur une ligne dont la colonne
// droite n'existe pas).
int8_t patchEncoderLogicalRow(uint8_t t, uint8_t slot) {
  const uint8_t volRow = patchVolRow(t);
  const uint8_t slotRow = patchSlotRow(t);
  const int16_t visualRow = patchVisualRow(t, static_cast<uint8_t>(selectedPatchRow));
  if (visualRow == patchVisualRow(t, slotRow)) {
    return (slot == 0) ? static_cast<int8_t>(slotRow) : -1;
  }
  const int8_t left = static_cast<int8_t>(visualRow * 2);
  const int8_t right = static_cast<int8_t>(visualRow * 2 + 1);
  if (slot == 0) {
    return left;
  }
  return (right <= static_cast<int8_t>(volRow)) ? right : -1;
}

const char *patchEncoderLabel(uint8_t t, uint8_t slot) {
  const int8_t row = patchEncoderLogicalRow(t, slot);
  if (row < 0) {
    return nullptr;
  }
  const uint8_t volRow = patchVolRow(t);
  const uint8_t slotRow = patchSlotRow(t);
  if (static_cast<uint8_t>(row) == volRow) {
    return "VOLUME";
  }
  if (static_cast<uint8_t>(row) == slotRow) {
    return "SLOT";
  }
  if (row < 6) {
    return patchRowLabel(t, static_cast<uint8_t>(row));
  }
  return patchExtraLabel(t, static_cast<uint8_t>(row - 6));
}

void updatePatchEncoderHints() {
  const uint8_t t = static_cast<uint8_t>(patchTrack);
  drawEncoderHints(patchEncoderLabel(t, 0), patchEncoderLabel(t, 1));
}

void drawPatchPage() {
  drawSubHeader("PATCH", kPalette[4]);
  updatePatchEncoderHints();
  drawPatchTrackRow();
  // Cadre du tracer dessine UNE fois ici -- drawPatchScope() (appelee a
  // chaque paquet SCOPE recu) ne touche plus que l'interieur, voir son
  // commentaire.
  gfx->drawRect(kMargin, kPatchScopeTop, kScreenSize - 2 * kMargin, kPatchScopeH, kFaint);
  drawPatchScope();
  drawPatchWindow();
}

bool hitTestPatchTrackPrev(int16_t x, int16_t y) {
  return inBox(x, y, kMargin, kPatchTrackRowY, kScreenSize / 2 - kMargin, 22);
}
bool hitTestPatchTrackNext(int16_t x, int16_t y) {
  return inBox(x, y, kScreenSize / 2, kPatchTrackRowY, kScreenSize / 2 - kMargin, 22);
}

// Renvoie -1 (aucun), sinon l'index du PARAMETRE LOGIQUE touche (0..
// patchVolRow(track) inclus -- base+extra+VOLUME, tous appariees 2 par
// ligne desormais ; SLOT garde ses propres hitTest*() dedies, voir
// plus bas, jamais couvert ici). Un tap SELECTIONNE seulement
// (2026-09-19, plus d'edition +/- directe au tactile -- voir le
// commentaire de patchRowVisible()) : l'edition se fait ensuite a la
// croix (A maintenu + HAUT/BAS), meme reflexe que partout ailleurs.
int8_t hitTestPatchParam(int16_t x, int16_t y) {
  const uint8_t t = static_cast<uint8_t>(patchTrack);
  const uint8_t volRow = patchVolRow(t);
  const int16_t rowH = static_cast<int16_t>(kPatchRowH - 4);
  for (uint8_t i = 0; i <= volRow; ++i) {
    int16_t rowY, rowX, rowW;
    if (!patchRowVisible(i, rowY, rowX, rowW)) {
      continue;
    }
    if (inBox(x, y, rowX, rowY, rowW, rowH)) {
      return static_cast<int8_t>(i);
    }
  }
  return -1;
}

// Applique `delta` a la valeur du parametre actuellement selectionne
// (selectedPatchRow) et l'envoie au Teensy -- factorise le 2026-09-19
// ("on devrait pouvoir changer les valeurs ... en maintenant A et en
// pressant droite/gauche [en plus de haut/bas]") : A+GAUCHE/DROITE
// edite desormais la valeur exactement comme A+HAUT/BAS (meme
// fonction, meme convention de signe -- DROITE/HAUT = +1). Reprend
// mot pour mot la logique qui vivait avant dans le gestionnaire de
// croix (voir son commentaire pour le detail de chaque cas : VOLUME/
// SLOT/ligne fixe-ou-DXP/ligne EXTRA).
void patchApplyDelta(uint8_t t, int delta) {
  const uint8_t volRow = patchVolRow(t);
  const uint8_t slotRow = patchSlotRow(t);
  if (selectedPatchRow == static_cast<int8_t>(volRow)) {
    uint8_t &vol = trackVolume[t];
    vol = static_cast<uint8_t>(constrain(static_cast<int>(vol) + delta, 0, 127));
    drawVolRow();
    sendPatchVol();
  } else if (selectedPatchRow == static_cast<int8_t>(slotRow)) {
    patchSlot = static_cast<uint8_t>((static_cast<int>(patchSlot) + delta + kPatchSlotCount) % kPatchSlotCount);
    drawPatchSlotRow();
  } else if (selectedPatchRow < 6 && patchRowActive(t, static_cast<uint8_t>(selectedPatchRow))) {
    uint8_t &param = patchParamRef(t, static_cast<uint8_t>(selectedPatchRow));
    param = static_cast<uint8_t>(constrain(static_cast<int>(param) + delta, 0,
                                             static_cast<int>(patchRowMax(t, static_cast<uint8_t>(selectedPatchRow)))));
    drawPatchRow(static_cast<uint8_t>(selectedPatchRow));
    if (selectedPatchRow < 2) {
      sendPatchFilt();
    } else if (trackEngine[t] == az2::kEngineDexed) {
      sendPatchDxp(static_cast<uint8_t>(selectedPatchRow - 2));
    } else {
      sendPatchEnv();
    }
  } else if (selectedPatchRow >= 6) {
    const uint8_t extraIdx = static_cast<uint8_t>(selectedPatchRow - 6);
    uint8_t &val = patchExtraVal[t][extraIdx];
    val = static_cast<uint8_t>(
        constrain(static_cast<int>(val) + delta, 0, static_cast<int>(patchExtraMax(t, extraIdx))));
    drawPatchExtraRow(static_cast<uint8_t>(selectedPatchRow));
    sendPatchExtra(t, extraIdx);
  }
}

// ---------------------------------------------------------------------
// Page MIXER -- volume de TOUTES les pistes en un coup d'oeil (demande
// 2026-09-19, "le mixeur doit gerer le volume de toutes les voix" --
// jusqu'ici seule la ligne VOLUME de la page PATCH permettait de regler
// UNE piste a la fois, il fallait changer de piste pour comparer/regler
// les autres). 8 barres verticales façon table de mixage. Croix :
// GAUCHE/DROITE choisit la piste, HAUT/BAS regle directement son volume
// (pas besoin de maintenir A -- metaphore fader, geste le plus frequent
// sur cette page). BTN:A = mute, BTN:D = solo (memes conventions que la
// page MOTEURS pour SOLO). Encodeurs 1/2 CONTEXTUELS (2026-09-19, "on
// va [leur] attribuer une couleur et les inclure a chaque fois dans
// l'application ... on les utilise pas assez") : encodeur 1 = choisit
// la piste, encodeur 2 = son volume -- voir drawEncoderHints() et le
// dispatch POT: plus bas.
// ---------------------------------------------------------------------
int8_t selectedMixerTrack = 0;
constexpr int16_t kMixerBarTop = 90;
constexpr int16_t kMixerBarBottom = 370;
constexpr int16_t kMixerBarH = kMixerBarBottom - kMixerBarTop;
constexpr int16_t kMixerColW = (kScreenSize - 2 * kMargin) / kSeqTrackCount;
constexpr int16_t kMixerBarW = kMixerColW - 14;

void drawMixerTrack(uint8_t t) {
  const int16_t x = static_cast<int16_t>(kMargin + t * kMixerColW + (kMixerColW - kMixerBarW) / 2);
  const bool selected = (selectedMixerTrack == static_cast<int8_t>(t));
  const uint16_t accent = kPalette[t % kPaletteCount];

  // Efface toute la colonne (barre + libelles au-dessus/en dessous) --
  // simple et robuste, pas de redessin partiel "au bon endroit" (meme
  // choix que drawPatchWindow()).
  gfx->fillRect(static_cast<int16_t>(kMargin + t * kMixerColW), static_cast<int16_t>(kMixerBarTop - 16),
                kMixerColW, static_cast<int16_t>(kMixerBarH + 40), RGB565_BLACK);

  const int16_t fillH = static_cast<int16_t>((static_cast<int32_t>(trackVolume[t]) * kMixerBarH) / 127);
  const int16_t fillY = static_cast<int16_t>(kMixerBarBottom - fillH);
  const uint16_t barColor = trackMuted[t] ? kFaint : accent;
  gfx->drawRect(x, kMixerBarTop, kMixerBarW, kMixerBarH, kFaint);
  if (fillH > 0) {
    gfx->fillRect(x, fillY, kMixerBarW, fillH, barColor);
  }
  if (selected) {
    // Contour blanc epais (3px, meme convention que la page MOTEURS
    // depuis "on fait un truc en surbrillance plus visible").
    gfx->drawRect(static_cast<int16_t>(x - 3), static_cast<int16_t>(kMixerBarTop - 3),
                  static_cast<int16_t>(kMixerBarW + 6), static_cast<int16_t>(kMixerBarH + 6), RGB565_WHITE);
    gfx->drawRect(static_cast<int16_t>(x - 4), static_cast<int16_t>(kMixerBarTop - 4),
                  static_cast<int16_t>(kMixerBarW + 8), static_cast<int16_t>(kMixerBarH + 8), RGB565_WHITE);
  }

  gfx->setTextSize(1);
  gfx->setTextColor(accent);
  char buf[4];
  // t+1 (2026-09-19, "les pistes c'est mieux de les numeroter de 1 a 8
  // ... c'est plus musicien" -- affichage seulement, t reste 0-7 en
  // interne/dans le protocole, voir trackVolume[]/VOL:).
  snprintf(buf, sizeof(buf), "%d", t + 1);
  gfx->setCursor(static_cast<int16_t>(x + kMixerBarW / 2 - 3), static_cast<int16_t>(kMixerBarTop - 14));
  gfx->print(buf);

  gfx->setTextColor(RGB565_WHITE);
  char volBuf[5];
  snprintf(volBuf, sizeof(volBuf), "%d", trackVolume[t]);
  gfx->setCursor(static_cast<int16_t>(x + kMixerBarW / 2 - (trackVolume[t] >= 100 ? 9 : 6)),
                 static_cast<int16_t>(kMixerBarBottom + 6));
  gfx->print(volBuf);

  if (trackMuted[t] || trackSoloed[t]) {
    gfx->setTextColor(trackMuted[t] ? RGB565(200, 60, 60) : RGB565(60, 220, 90));
    gfx->setCursor(static_cast<int16_t>(x + kMixerBarW / 2 - 3), static_cast<int16_t>(kMixerBarBottom + 18));
    gfx->print(trackMuted[t] ? "M" : "S");
  }
}

// Boutons MUTE/SOLO tactiles (2026-09-19, "il faut que les 2 controles
// soit[ent] boutons tactil[es]" -- jusqu'ici seuls B/D physiques
// marchaient, rien a toucher a l'ecran) -- agissent sur la piste
// SELECTIONNEE (meme reflexe que B/D), pas sur celle touchee (pas de
// tap-and-select combine ici, la selection se fait separement via une
// colonne ou GAUCHE/DROITE).
constexpr int16_t kMixerBtnY = kMixerBarBottom + 34;
constexpr int16_t kMixerBtnH = 32;
constexpr int16_t kMixerBtnW = (kScreenSize - 2 * kMargin - 8) / 2;
constexpr int16_t kMixerMuteX = kMargin;
constexpr int16_t kMixerSoloX = kMargin + kMixerBtnW + 8;

void drawMixerActionBtns() {
  const uint8_t t = static_cast<uint8_t>(selectedMixerTrack);
  constexpr uint16_t kMuteColor = RGB565(200, 60, 60);
  constexpr uint16_t kSoloColor = RGB565(60, 220, 90);

  gfx->fillRect(kMixerMuteX, kMixerBtnY, kMixerBtnW, kMixerBtnH, trackMuted[t] ? kMuteColor : RGB565_BLACK);
  gfx->drawRect(kMixerMuteX, kMixerBtnY, kMixerBtnW, kMixerBtnH, kMuteColor);
  gfx->fillRect(kMixerSoloX, kMixerBtnY, kMixerBtnW, kMixerBtnH, trackSoloed[t] ? kSoloColor : RGB565_BLACK);
  gfx->drawRect(kMixerSoloX, kMixerBtnY, kMixerBtnW, kMixerBtnH, kSoloColor);

  gfx->setTextSize(2);
  gfx->setTextColor(trackMuted[t] ? RGB565_BLACK : kMuteColor);
  gfx->setCursor(static_cast<int16_t>(kMixerMuteX + kMixerBtnW / 2 - 28), static_cast<int16_t>(kMixerBtnY + 8));
  gfx->print("MUTE");
  gfx->setTextColor(trackSoloed[t] ? RGB565_BLACK : kSoloColor);
  gfx->setCursor(static_cast<int16_t>(kMixerSoloX + kMixerBtnW / 2 - 24), static_cast<int16_t>(kMixerBtnY + 8));
  gfx->print("SOLO");
}

bool hitTestMixerMute(int16_t x, int16_t y) {
  return inBox(x, y, kMixerMuteX, kMixerBtnY, kMixerBtnW, kMixerBtnH);
}
bool hitTestMixerSolo(int16_t x, int16_t y) {
  return inBox(x, y, kMixerSoloX, kMixerBtnY, kMixerBtnW, kMixerBtnH);
}

// Bascule mute (true) ou solo (false) sur la piste SELECTIONNEE --
// factorise (2026-09-19) pour etre appele aussi bien par B/D
// (physique) que par les boutons tactiles MUTE/SOLO ci-dessus, sans
// dupliquer l'envoi MUTE:/SOLO: + le redessin.
void toggleMixerMuteSolo(bool mute) {
  const uint8_t t = static_cast<uint8_t>(selectedMixerTrack);
  char msg[12];
  if (mute) {
    trackMuted[t] = !trackMuted[t];
    snprintf(msg, sizeof(msg), "MUTE:%d:%d", t, trackMuted[t] ? 1 : 0);
  } else {
    trackSoloed[t] = !trackSoloed[t];
    snprintf(msg, sizeof(msg), "SOLO:%d:%d", t, trackSoloed[t] ? 1 : 0);
  }
  sendToTeensy(msg);
  drawMixerTrack(t);
  drawMixerActionBtns();
}

void drawMixerPage() {
  drawSubHeader("MIXER", kPalette[5 % kPaletteCount]);
  drawEncoderHints("PISTE", "VOLUME");
  for (uint8_t t = 0; t < kSeqTrackCount; ++t) {
    drawMixerTrack(t);
  }
  drawMixerActionBtns();
}

bool hitTestMixerTrack(int16_t x, int16_t y, uint8_t &track) {
  if (y < kMixerBarTop - 16 || y > kMixerBarBottom + 30) {
    return false;
  }
  const int col = (x - kMargin) / kMixerColW;
  if (col < 0 || col >= static_cast<int>(kSeqTrackCount)) {
    return false;
  }
  track = static_cast<uint8_t>(col);
  return true;
}

// ---------------------------------------------------------------------
// Page SONG -- chainage de patterns, demande le 2026-09-16 ("c'est
// plus un sequenceur qui peut nous permettre d'assembler des patterns,
// mais il faut un tracker complet"). Modele Polyend (le plus simple des
// 3 references etudiees, voir AZ2_TRACKER_ETUDE.md) : chaque case de
// song = un pattern ENTIER (8 pistes ensemble). MODE bascule boucle
// simple (comportement d'origine) / song ; LONGUEUR (0-16) ; grille de
// 16 cases, touche pour cycler le pattern assigne (0-7).
// ---------------------------------------------------------------------
constexpr int16_t kSongModeRowY = 90;
constexpr int16_t kSongRowH = 38;
constexpr int16_t kSongBtnW = 70;
constexpr int16_t kSongLenRowY = kSongModeRowY + kSongRowH + 8;
constexpr int16_t kSongGridTop = kSongLenRowY + kSongRowH + 12;
constexpr uint8_t kSongCols = 4;
constexpr int16_t kSongSlotGap = 6;
constexpr int16_t kSongSlotW = (kScreenSize - 2 * kMargin - (kSongCols - 1) * kSongSlotGap) / kSongCols;
constexpr int16_t kSongSlotH = 56;

void drawSongModeRow() {
  gfx->fillRect(kMargin, kSongModeRowY, kScreenSize - 2 * kMargin, kSongRowH, RGB565_BLACK);
  gfx->drawRect(kMargin, kSongModeRowY, kScreenSize - 2 * kMargin, kSongRowH, kFaint);
  gfx->setTextSize(1);
  gfx->setTextColor(kDim);
  gfx->setCursor(static_cast<int16_t>(kMargin + 8), static_cast<int16_t>(kSongModeRowY + 3));
  gfx->print("MODE (toucher pour changer)");
  gfx->setTextSize(2);
  gfx->setTextColor(songMode ? kPalette[1] : RGB565_WHITE);
  gfx->setCursor(static_cast<int16_t>(kMargin + 8), static_cast<int16_t>(kSongModeRowY + 16));
  gfx->print(songMode ? "SONG" : "BOUCLE SIMPLE");
}

void drawSongLenRow() {
  const int16_t minusX = kMargin;
  const int16_t plusX = static_cast<int16_t>(kScreenSize - kMargin - kSongBtnW);
  gfx->fillRect(kMargin, kSongLenRowY, kScreenSize - 2 * kMargin, kSongRowH, RGB565_BLACK);
  gfx->drawRect(minusX, kSongLenRowY, kSongBtnW, kSongRowH, kFaint);
  gfx->drawRect(plusX, kSongLenRowY, kSongBtnW, kSongRowH, kFaint);
  gfx->setTextSize(2);
  gfx->setTextColor(RGB565_WHITE);
  gfx->setCursor(static_cast<int16_t>(minusX + 24), static_cast<int16_t>(kSongLenRowY + 6));
  gfx->print('-');
  gfx->setCursor(static_cast<int16_t>(plusX + 24), static_cast<int16_t>(kSongLenRowY + 6));
  gfx->print('+');
  char buf[20];
  snprintf(buf, sizeof(buf), "LONGUEUR: %d", songLen);
  gfx->setCursor(static_cast<int16_t>(kScreenSize / 2 - 55), static_cast<int16_t>(kSongLenRowY + 10));
  gfx->print(buf);
}

void songSlotRect(uint8_t i, int16_t &x, int16_t &y) {
  const uint8_t col = static_cast<uint8_t>(i % kSongCols);
  const uint8_t row = static_cast<uint8_t>(i / kSongCols);
  x = static_cast<int16_t>(kMargin + col * (kSongSlotW + kSongSlotGap));
  y = static_cast<int16_t>(kSongGridTop + row * (kSongSlotH + kSongSlotGap));
}
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
