propann/L-AZ-2/src_teensy/microdexed-touch/MicroDexed-touch/MicroDexed-touch.ino

/*
   MicroDexed-touch

   MicroDexed is a port of the Dexed sound engine
   Dexed ist heavily based on https://github.com/google/music-synthesizer-for-android

   (c)2018-2021 H. Wirtz <wirtz@parasitstudio.de>
   (c)2021-2026 H. Wirtz <wirtz@parasitstudio.de>, M. Koslowski <positionhigh@gmx.de>

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
   You should have received a copy of the GNU General Public License
   along with this program; if not, write to the Free Software Foundation,
   Inc., 51 Franklin Street, Fifth Floor, Boston, MA 02110-1301  USA
*/

#include <limits.h>
#include "config.h"
#include "scope.h"
#include <Audio.h>
#include <Wire.h>
#include <MIDI.h>
#include <SD.h>

#ifdef  MCP_CV
#include "MCP4728.h"  // 4-Channel DAC 12Bit mcp4728
MCP4728 dac;
#endif

#define NOTESTEP_CV  34.38f

#ifdef  SECOND_SD
SDClass SD_EXTERNAL;
#endif

#include <SPI.h>
#include "filemanager.h"

#if defined RGB_ENCODERS
#if defined MCP_23008
#include "MCP23008.h"
MCP23008 mcp(0x20);
#endif
#if defined MCP_23017
#include "MCP23017.h"
MCP23017 mcp(0x20);
#endif
#endif

#include <EEPROM.h> // fixes header file not found when compiling framework's bluetooth.cpp

#include "ILI9341_t3n.h"
#include <LCDMenuLib2.h>
#include "screensaver.h"
#include "UI.h"
#include "touch.h"
#include "USBHost_t36.h"
#include "MD_REncoder.h"
#include <TeensyTimerTool.h>
using namespace TeensyTimerTool;

#include "microsynth.h"
#include "braids.h"

#include "effect_dynamics.h"
#include "midi_devices.h"
#include "synth_dexed.h"
#include "dexed_sd.h"
#include "effect_modulated_delay.h"
#include "effect_stereo_mono.h"
#include "effect_mono_stereo.h"
#include "effect_platervbstereo.h"
#include "effect_gate.h"

#if defined BITCRUSH
#include "effect_bitcrush.h"
#endif

#include "template_mixer.hpp"
#include "drums.h"
#include "sequencer.h"
#include "synth_mda_epiano.h"
#include "effect_stereo_panorama.h"
#include <synth_braids.h>
#include "MultiBandCompressor.h" 
#include "PitchSamplePlayer.h"
#include "livesequencer.h"
#include <vector>

//#include "D50Synth.h"

#if defined GENERIC_DISPLAY
#include "XPT2046_Touchscreen.h"
#endif

#ifdef CAPACITIVE_TOUCH_DISPLAY
#include "Adafruit_FT6206.h"
#endif

#ifdef COMPILE_FOR_SDCARD
#include <TeensyVariablePlayback.h>
#endif

#ifdef PSRAM
#include "effect_delay_ext8.h"
#endif

#if defined APC
#include "APC.h"
bool APC_BUTTONS_RIGHT[8];
uint8_t APC_SAMPLE_SCROLL_OFFSET = 64;
uint8_t APC_TONAL_SCROLL_OFFSET = 64;
uint8_t APC_PREVIOUS_NOTE = 254;
uint8_t APC_MODE = APC_OFF;
#endif

// D50Synth d50Synth; 
// struct d50_config_s d50;


// Allocate the delay lines for left and right channels
short braids_l_delayline[BRAIDS_FLANGE_DELAY_LENGTH];
short braids_r_delayline[BRAIDS_FLANGE_DELAY_LENGTH];
int braids_flanger_idx = BRAIDS_FLANGE_DELAY_LENGTH / 4;
int braids_flanger_depth = BRAIDS_FLANGE_DELAY_LENGTH / 4;
const float braids_flanger_freq = 0.5F;

uint8_t check_internal_sd_card(void);
#ifdef  SECOND_SD
void  check_external_sd_card(void);
#endif
void check_and_create_directories(void);
void show_cpu_and_mem_usage(void);
void initial_values(bool init);

void printLoadedSample(const uint8_t i, const char* name);

#ifdef DEBUG
void show_configuration(void);
void show_cpu_and_mem_usage(void);
void show_patch(uint8_t);
void SerialPrintFormatInt3(uint8_t num);
int FreeMem(void);
#endif

bool checkMidiChannelDexed(byte inChannel, uint8_t instance_id);
bool bootup_performance_loading = true;
bool remote_active = false;
bool back_button_touch_page_check_and_init_done = false;
bool current_page_has_touch_back_button = false;
uint8_t gate_state_old[2];

#if defined GENERIC_DISPLAY 
extern XPT2046_Touchscreen touch;
#endif

#ifdef CAPACITIVE_TOUCH_DISPLAY
extern Adafruit_FT6206 touch;
#endif

// Editor operations
int menuhelper_previous_val;

#if defined BITCRUSH
AudioEffectBitcrush    bitcrush_effect;
AudioMixer<8> bitcrush_mixer;
#endif

AudioMultiBandCompressor MultiBandCompressor;
Realtime_Scope scope;

// Audio engines
AudioSynthDexed* MicroDexed[NUM_DEXED];
AudioSynthEPiano ep(NUM_EPIANO_VOICES);
AudioAnalyzePeak ep_peak_r;
AudioAnalyzePeak ep_peak_l;

// Sidechain
AudioEffectFade fade_sidechain_r;
AudioEffectFade fade_sidechain_l;
AudioMixer<14> sidechain_mixer_r;
AudioMixer<14> sidechain_mixer_l;

AudioSynthBraids* synthBraids[NUM_BRAIDS];
AudioMixer<NUM_BRAIDS> braids_mixer;
AudioMixer<4>* braids_mixer_filter[NUM_BRAIDS];
AudioMixer<2> braids_mixer_reverb;
AudioEffectEnvelope* braids_envelope[NUM_BRAIDS];
AudioFilterBiquad* braids_filter[NUM_BRAIDS];
AudioEffectFlange braids_flanger_r;
AudioEffectFlange braids_flanger_l;
AudioEffectStereoPanorama braids_stereo_panorama;
AudioAnalyzePeak braids_peak_r;
AudioAnalyzePeak braids_peak_l;
uint8_t braids_slot;
braids_t braids_osc;
uint16_t braids_filter_state[NUM_BRAIDS];
uint16_t braids_filter_state_last_displayed[NUM_BRAIDS];
extern uint16_t braids_filter_lfo_count[NUM_BRAIDS];
extern bool braids_lfo_direction[NUM_BRAIDS];
elapsedMillis braids_control_rate;

AudioSynthWaveform microsynth_waveform[NUM_MICROSYNTH];
AudioSynthNoisePink microsynth_noise[NUM_MICROSYNTH];
AudioEffectEnvelope microsynth_envelope_osc[NUM_MICROSYNTH];
AudioEffectEnvelope microsynth_envelope_noise[NUM_MICROSYNTH];
AudioFilterStateVariable microsynth_filter_osc[NUM_MICROSYNTH];
AudioFilterStateVariable microsynth_filter_noise[NUM_MICROSYNTH];
AudioEffectStereoPanorama microsynth_stereo_panorama_osc[NUM_MICROSYNTH];
AudioEffectStereoPanorama microsynth_stereo_panorama_noise[NUM_MICROSYNTH];
AudioMixer<2> microsynth_mixer_r[NUM_MICROSYNTH];
AudioMixer<2> microsynth_mixer_l[NUM_MICROSYNTH];
AudioMixer<2> microsynth_main_mixer_r;
AudioMixer<2> microsynth_main_mixer_l;
AudioMixer<4> microsynth_mixer_filter_osc[NUM_MICROSYNTH];
AudioMixer<4> microsynth_mixer_filter_noise[NUM_MICROSYNTH];
AudioMixer<2> microsynth_mixer_reverb;
AudioAnalyzePeak microsynth_peak_osc_0;
AudioAnalyzePeak microsynth_peak_osc_1;
AudioAnalyzePeak microsynth_peak_noise_0;
AudioAnalyzePeak microsynth_peak_noise_1;
extern elapsedMillis microsynth_delay_timer[2];

AudioSynthWaveform* chorus_modulator[NUM_DEXED];

AudioEffectModulatedDelay* dexed_chorus[NUM_DEXED];

AudioEffectGate* Gate[2];  //noise gate for delay feedback channels A+B

AudioMixer<2 * NUM_DRUMS + 4>* global_delay_in_mixer[2];

AudioMixer<2>* delay_fb_mixer[NUM_DEXED];

AudioFilterStateVariable global_delay_filter[2];
AudioMixer<4> global_delay_filter_mixer[NUM_DEXED];

#ifdef PSRAM
AudioEffectDelayExternal8* delay_fx[2];
#else
AudioEffectDelay* delay_fx[2];
#endif

AudioMixer<2>* delay_mixer[NUM_DEXED];
AudioEffectMonoStereo* dexed_mono2stereo[NUM_DEXED];
AudioEffectMonoStereo* delay_mono2stereo[NUM_DEXED];

AudioMixer<2> dexed_chorus_mixer_r[NUM_DEXED];
AudioMixer<2> dexed_chorus_mixer_l[NUM_DEXED];

AudioEffectStereoPanorama ep_stereo_panorama;
AudioSynthWaveform ep_chorus_modulator;
AudioFilterBiquad ep_modchorus_filter;
AudioEffectModulatedDelayStereo ep_modchorus;
AudioMixer<2> ep_chorus_mixer_r;
AudioMixer<2> ep_chorus_mixer_l;

AudioAnalyzePeak microdexed_peak_0;
AudioAnalyzePeak microdexed_peak_1;

#if (NUM_DEXED>2)
AudioAnalyzePeak microdexed_peak_2;
AudioAnalyzePeak microdexed_peak_3;
#endif

AudioMixer<REVERB_MIX_CH_MAX> reverb_mixer_r;
AudioMixer<REVERB_MIX_CH_MAX> reverb_mixer_l;

AudioEffectPlateReverb reverb;

AudioMixer<MASTER_MIX_CH_MAX> master_mixer_r;
AudioMixer<MASTER_MIX_CH_MAX> master_mixer_l;

AudioAmplifier volume_r;
AudioAmplifier volume_l;
AudioEffectStereoMono stereo2mono;
AudioAnalyzePeak master_peak_r;
AudioAnalyzePeak master_peak_l;
#if defined(TEENSY_AUDIO_BOARD) && defined(SGTL5000_AUDIO_THRU)
AudioMixer<2> audio_thru_mixer_r;
AudioMixer<2> audio_thru_mixer_l;
#endif

AudioMixer<3> finalized_mixer_r;
AudioMixer<3> finalized_mixer_l;

AudioSynthWaveformDc dc1;
microsynth_t microsynth[NUM_MICROSYNTH];

// Drumset
#if NUM_DRUMS > 0

#ifdef COMPILE_FOR_SDCARD
AudioPlaySdResmp* Drum[NUM_DRUMS];
#endif

PitchSamplePlayer* Drum[NUM_DRUMS];

#if defined(COMPILE_FOR_PROGMEM) || defined(COMPILE_FOR_PSRAM)
#include "effect_delay_ext8.h"
#endif


#if defined(DRUMS_FILTERS) 
AudioFilterBiquad* Drum_filter[NUM_DRUMS * 2];
AudioEffectEnvelope* sample_envelope[NUM_DRUMS * 2];
#endif

AudioMixer<NUM_DRUMS> drum_mixer_r;
AudioMixer<NUM_DRUMS> drum_mixer_l;

AudioAnalyzePeak drum_mixer_peak_r;
AudioAnalyzePeak drum_mixer_peak_l;

AudioMixer<NUM_DRUMS> drum_reverb_send_mixer_r;
AudioMixer<NUM_DRUMS> drum_reverb_send_mixer_l;
#endif

AudioAnalyzePeak reverb_return_peak_r;
AudioAnalyzePeak reverb_return_peak_l;

LiveSequencer liveSeq;

extern uint32_t gamepad_buttons_neutral;
extern uint8_t gamepad_0_neutral;
extern uint8_t gamepad_1_neutral;

#ifdef COMPILE_FOR_PSRAM
#include "psramloader.h"
extern PsramLoader sampleLoader;
PitchSamplePlayer WAV_preview_PSRAM;
#endif

extern ILI9341_t3n display;
extern MD_REncoder ENCODER[];
#if defined SMFPLAYER
extern MD_MIDIFile SMF;
#endif
extern uint8_t activeSample;
extern uint8_t generic_temp_select_menu;
extern uint8_t generic_active_function;
extern uint8_t generic_menu;
extern bool generic_full_draw_required;
extern uint8_t num_slices[2];
extern uint8_t selected_slice_sample[2];
extern uint32_t slice_start[2][16];
extern uint32_t slice_end[2][16];
extern uint16_t slices_scrollspeed;
extern bool slices_autoalign;
extern uint8_t external_psram_size;
extern uint32_t psram_free_bytes;
extern ts_t ts;
extern fm_t fm;
extern JoystickController joysticks[];
extern bool remote_console_keystate_select;
extern bool remote_console_keystate_a;
extern bool remote_console_keystate_b;

#if defined(TEENSY_AUDIO_BOARD)
AudioOutputI2S i2s1;
AudioControlSGTL5000 sgtl5000;
#elif defined(I2S_AUDIO_ONLY)
AudioOutputI2S i2s1;
#elif defined(TGA_AUDIO_BOARD)
AudioOutputI2S i2s1;
AudioControlWM8731master wm8731_1;
#elif defined(PT8211_AUDIO)
AudioOutputPT8211 pt8211_1;
#elif defined(TEENSY_DAC_SYMMETRIC)
AudioOutputAnalogStereo dacOut;
AudioMixer<4> invMixer;
#elif defined(TEENSY_DAC)
AudioOutputAnalogStereo dacOut;
#endif

#if defined(TEENSY_AUDIO_BOARD) && defined(SGTL5000_AUDIO_THRU)
AudioInputI2S i2s1in;
#endif

#ifdef GRANULAR
#include "granular.h"
AudioChromaticGranularPoly granularPoly;

AudioFilterBiquad granular_filter_l;
AudioFilterBiquad granular_filter_r;

granular_params_t granular_params;

#endif

AudioAnalyzePeak mb_before_l;
AudioAnalyzePeak mb_before_r;
AudioAnalyzePeak mb_after_l;
AudioAnalyzePeak mb_after_r;

AudioConnection patchCord_l(finalized_mixer_l, 0, i2s1, 1);
AudioConnection patchCord_r(finalized_mixer_r, 0, i2s1, 0);

// Connect D50 to audio output
// AudioConnection patchCorda1(*d50Synth.getOutputMixer(), 0, i2s1, 0);
// AudioConnection patchCorda2(*d50Synth.getOutputMixer(), 1, i2s1, 1);

// WAV/AUDIO Recording
AudioRecordQueue record_queue_l;
AudioRecordQueue record_queue_r;

#ifdef COMPILE_FOR_PSRAM
extern void load_sd_noisemaker_json(void);
#endif

//
// Static patching of audio objects
//
const AudioConnection patchCord[] = {
  // Audio chain tail
  {reverb_mixer_r, 0, reverb, 0},
  {reverb_mixer_l, 0, reverb, 1},

  //normal reverb
   {reverb, 0, master_mixer_r, MASTER_MIX_CH_REVERB},
   {reverb, 1, master_mixer_l, MASTER_MIX_CH_REVERB},

   //sidechain start
    {reverb, 0, sidechain_mixer_r, MASTER_MIX_CH_REVERB},
     {reverb, 1, sidechain_mixer_l, MASTER_MIX_CH_REVERB},
     //sidechain end

       {master_mixer_l, volume_l},
       {master_mixer_r, volume_r},
       {volume_l, 0, stereo2mono, 0},
       {volume_r, 0, stereo2mono, 1},

       {master_mixer_l, 0, master_peak_l, 0},
       {master_mixer_r, 0, master_peak_r, 0},

       {master_mixer_l, 0, mb_before_l, 0},
       {master_mixer_r, 0, mb_before_r, 0},

       // Realtime Scope
       {master_mixer_l, 0, scope, 0},

       // Outputs

       #if defined(I2S_AUDIO_ONLY)
           {dc1, 0, finalized_mixer_l, 2},
           {dc1, 0, finalized_mixer_r, 2},
          #endif

             {stereo2mono, 0, finalized_mixer_l, 0},
             {stereo2mono, 1, finalized_mixer_r, 0},

              {master_mixer_l, 0, MultiBandCompressor, 0},
              {master_mixer_r, 0, MultiBandCompressor, 1},

             {MultiBandCompressor, 0, finalized_mixer_l, 1},
             {MultiBandCompressor, 1, finalized_mixer_r, 1},

          {finalized_mixer_l, 0, mb_after_l, 0},
         {finalized_mixer_r, 0, mb_after_r, 0},

         // {finalized_mixer_l, 0, i2s1, 1},
         // {finalized_mixer_r, 0, i2s1, 0},

         //WAV RECORDER
         {finalized_mixer_l, 0, record_queue_l, 0},
         {finalized_mixer_r, 0, record_queue_r, 0},

     #if defined(TEENSY_AUDIO_BOARD) && defined(SGTL5000_AUDIO_THRU)
         {stereo2mono, 0, audio_thru_mixer_r, 0},
         {stereo2mono, 1, audio_thru_mixer_l, 0},
         {audio_thru_mixer_r, 0, i2s1, 0},
         {audio_thru_mixer_l, 0, i2s1, 1},
     #endif

         {drum_reverb_send_mixer_r, 0, reverb_mixer_r, REVERB_MIX_CH_DRUMS},
         {drum_reverb_send_mixer_l, 0, reverb_mixer_l, REVERB_MIX_CH_DRUMS},

#ifdef GRANULAR
  {granularPoly, 0, granular_filter_l,0},
   {granularPoly, 0, granular_filter_r,0},

     {granular_filter_l, 0, master_mixer_l, MASTER_MIX_CH_GRANULAR},
    {granular_filter_r, 0, master_mixer_r, MASTER_MIX_CH_GRANULAR},

          {granular_filter_r, 0, reverb_mixer_r, REVERB_MIX_CH_GRANULAR},
          {granular_filter_l, 0, reverb_mixer_l, REVERB_MIX_CH_GRANULAR},

#endif

#ifdef BITCRUSH
          {bitcrush_effect, 0, reverb_mixer_r, REVERB_MIX_CH_BITCRUSH},
          {bitcrush_effect, 0, reverb_mixer_l, REVERB_MIX_CH_BITCRUSH},
#endif

         {drum_mixer_r, 0, master_mixer_r, MASTER_MIX_CH_DRUMS},
         {drum_mixer_l, 0, master_mixer_l, MASTER_MIX_CH_DRUMS},
         {drum_mixer_r, 0, drum_mixer_peak_r, 0},
         {drum_mixer_l, 0, drum_mixer_peak_l, 0},

         {reverb, 0, reverb_return_peak_r, 0},
         {reverb, 1, reverb_return_peak_l, 0},

         {ep, 0, ep_stereo_panorama, 0},
         {ep, 1, ep_stereo_panorama, 1},
         {ep_stereo_panorama, 0, ep_peak_r, 0},
         {ep_stereo_panorama, 1, ep_peak_l, 0},
         {ep_stereo_panorama, 0, ep_chorus_mixer_r, 0},
         {ep_stereo_panorama, 1, ep_chorus_mixer_l, 0},
         {ep_stereo_panorama, 0, ep_modchorus, 0},
         {ep_stereo_panorama, 1, ep_modchorus, 1},
         {ep_chorus_modulator, 0, ep_modchorus_filter, 0},
         {ep_modchorus_filter, 0, ep_modchorus, 2},
         {ep_modchorus, 0, ep_chorus_mixer_r, 1},
         {ep_modchorus, 1, ep_chorus_mixer_l, 1},
         {ep_chorus_mixer_r, 0, reverb_mixer_r, REVERB_MIX_CH_EPIANO},
         {ep_chorus_mixer_l, 0, reverb_mixer_l, REVERB_MIX_CH_EPIANO},
         {ep_chorus_mixer_r, 0, master_mixer_r, MASTER_MIX_CH_EPIANO},
         {ep_chorus_mixer_l, 0, master_mixer_l, MASTER_MIX_CH_EPIANO},

         {ep_chorus_mixer_r, 0, sidechain_mixer_r, MASTER_MIX_CH_EPIANO},
         {ep_chorus_mixer_l, 0, sidechain_mixer_l, MASTER_MIX_CH_EPIANO},

         {microsynth_noise[0], 0, microsynth_envelope_noise[0], 0}, // noise generator to envelope
         {microsynth_noise[1], 0, microsynth_envelope_noise[1], 0},

         {microsynth_envelope_noise[0], 0, microsynth_filter_noise[0], 0}, // noise envelope to filter
         {microsynth_envelope_noise[1], 0, microsynth_filter_noise[1], 0},

         {microsynth_filter_noise[0], 0, microsynth_mixer_filter_noise[0], 0}, // noise filter to mixer
         {microsynth_filter_noise[0], 1, microsynth_mixer_filter_noise[0], 1},
         {microsynth_filter_noise[0], 2, microsynth_mixer_filter_noise[0], 2},

         {microsynth_filter_noise[1], 0, microsynth_mixer_filter_noise[1], 0},
         {microsynth_filter_noise[1], 1, microsynth_mixer_filter_noise[1], 1},
         {microsynth_filter_noise[1], 2, microsynth_mixer_filter_noise[1], 2},

         {microsynth_envelope_noise[0], 0, microsynth_mixer_filter_noise[0], 3}, // unfiltered noise to mixer
         {microsynth_envelope_noise[1], 0, microsynth_mixer_filter_noise[1], 3},

         {microsynth_mixer_filter_noise[0], 0, microsynth_stereo_panorama_noise[0], 0}, // noise to panorama 0
         {microsynth_mixer_filter_noise[0], 0, microsynth_stereo_panorama_noise[0], 1},

         {microsynth_mixer_filter_noise[1], 0, microsynth_stereo_panorama_noise[1], 0}, // noise to panorama 1
         {microsynth_mixer_filter_noise[1], 0, microsynth_stereo_panorama_noise[1], 1},

         {microsynth_waveform[0], 0, microsynth_envelope_osc[0], 0}, // osc waveform to envelope
         {microsynth_waveform[1], 0, microsynth_envelope_osc[1], 0},

         {microsynth_envelope_osc[0], 0, microsynth_filter_osc[0], 0}, // osc envelope to filter
         {microsynth_envelope_osc[1], 0, microsynth_filter_osc[1], 0},

         {microsynth_envelope_osc[0], 0, microsynth_mixer_filter_osc[0], 3}, // osc env to mixer for bypass
         {microsynth_envelope_osc[1], 0, microsynth_mixer_filter_osc[1], 3},

         {microsynth_filter_osc[0], 0, microsynth_mixer_filter_osc[0], 0}, // osc filter 0 to mixer 0
         {microsynth_filter_osc[0], 1, microsynth_mixer_filter_osc[0], 1},
         {microsynth_filter_osc[0], 2, microsynth_mixer_filter_osc[0], 2},

         {microsynth_filter_osc[1], 0, microsynth_mixer_filter_osc[1], 0}, // osc filter 1 to mixer 1
         {microsynth_filter_osc[1], 1, microsynth_mixer_filter_osc[1], 1},
         {microsynth_filter_osc[1], 2, microsynth_mixer_filter_osc[1], 2},

         {microsynth_mixer_filter_osc[0], 0, microsynth_stereo_panorama_osc[0], 0}, // mixer 0 to panorama 0
         {microsynth_mixer_filter_osc[0], 0, microsynth_stereo_panorama_osc[0], 1},

         {microsynth_mixer_filter_osc[1], 0, microsynth_stereo_panorama_osc[1], 0}, // mixer 1 to panorama 1
         {microsynth_mixer_filter_osc[1], 0, microsynth_stereo_panorama_osc[1], 1},

         {microsynth_stereo_panorama_osc[0], 0, microsynth_mixer_r[0], 0}, // osc 0 pan to internal mixer
         {microsynth_stereo_panorama_osc[0], 1, microsynth_mixer_l[0], 0},

         {microsynth_stereo_panorama_osc[1], 0, microsynth_mixer_r[1], 0}, // osc 1 pan to internal mixer
         {microsynth_stereo_panorama_osc[1], 1, microsynth_mixer_l[1], 0},

         {microsynth_stereo_panorama_noise[0], 0, microsynth_mixer_r[0], 1}, // noise 0 to mixer
         {microsynth_stereo_panorama_noise[0], 1, microsynth_mixer_l[0], 1},

         {microsynth_stereo_panorama_noise[1], 0, microsynth_mixer_r[1], 1}, // noise 1 to mixer
         {microsynth_stereo_panorama_noise[1], 1, microsynth_mixer_l[1], 1},

         {microsynth_mixer_r[0], 0, microsynth_main_mixer_r, 0},
         {microsynth_mixer_l[0], 0, microsynth_main_mixer_l, 0},

         {microsynth_mixer_r[1], 0, microsynth_main_mixer_r, 1},
         {microsynth_mixer_l[1], 0, microsynth_main_mixer_l, 1},

         {microsynth_main_mixer_r, 0, master_mixer_r, MASTER_MIX_CH_MICROSYNTH},
         {microsynth_main_mixer_l, 0, master_mixer_l, MASTER_MIX_CH_MICROSYNTH},

         //sidechain

         {microsynth_main_mixer_r, 0, sidechain_mixer_r, MASTER_MIX_CH_MICROSYNTH},
         {microsynth_main_mixer_l, 0, sidechain_mixer_l, MASTER_MIX_CH_MICROSYNTH},
         //sidechain end

            {microsynth_mixer_r[0], 0, microsynth_mixer_reverb, 0},
            {microsynth_mixer_r[1], 0, microsynth_mixer_reverb, 1},

            {microsynth_mixer_reverb, 0, reverb_mixer_r, REVERB_MIX_CH_MICROSYNTH},
            {microsynth_mixer_reverb, 1, reverb_mixer_l, REVERB_MIX_CH_MICROSYNTH},

            {microsynth_mixer_filter_osc[0], 0, microsynth_peak_osc_0, 0},     // osc 1 (inst1) to peak analyzer
            {microsynth_mixer_filter_osc[1], 0, microsynth_peak_osc_1, 0},     // osc 2 (inst2) to peak analyzer
            {microsynth_mixer_filter_noise[0], 0, microsynth_peak_noise_0, 0}, // unfiltered noise to mixer
            {microsynth_mixer_filter_noise[1], 0, microsynth_peak_noise_1, 0},
};

//
// Dynamic patching of MicroDexed objects
//
std::vector<AudioConnection*> dynamicConnections;

FLASHMEM void create_audio_dexed_chain(uint8_t instance_id)
{
  MicroDexed[instance_id] = new AudioSynthDexed(MAX_NOTES / NUM_DEXED, SAMPLE_RATE);

  dexed_mono2stereo[instance_id] = new AudioEffectMonoStereo();
  delay_mono2stereo[instance_id] = new AudioEffectMonoStereo();

  chorus_modulator[instance_id] = new AudioSynthWaveform();
  dexed_chorus[instance_id] = new AudioEffectModulatedDelay();

  // Allocate global delay mixer once for all instances
  if (instance_id == 0)
  {
    global_delay_in_mixer[0] = new AudioMixer<2 * NUM_DRUMS + 4>();
    global_delay_in_mixer[1] = new AudioMixer<2 * NUM_DRUMS + 4>();
  }

  delay_fb_mixer[instance_id] = new AudioMixer<2>();

  if (instance_id == 0 || instance_id == 1)
  {
    Gate[instance_id] = new AudioEffectGate();
#ifdef PSRAM
    delay_fx[instance_id] = new AudioEffectDelayExternal8(AUDIO_MEMORY8_EXTMEM, DELAY_MAX_TIME);
    const uint32_t delay_memory_size = (sizeof(((audio_block_t*)0)->data[0])) * (DELAY_MAX_TIME * (AUDIO_SAMPLE_RATE_EXACT / 1000.0f)) + 0.5f;
    psram_free_bytes -= delay_memory_size;
#else
    delay_fx[instance_id] = new AudioEffectDelay();
#endif
    dynamicConnections.emplace_back(new AudioConnection(*Gate[instance_id], 0, *delay_fx[instance_id], 0));
  }

  delay_mixer[instance_id] = new AudioMixer<2>();

  if (instance_id == 0)
  {
    dynamicConnections.emplace_back(new AudioConnection(*MicroDexed[instance_id], 0, microdexed_peak_0, 0));

    dynamicConnections.emplace_back(new AudioConnection(sidechain_mixer_r, 0, fade_sidechain_r, 0));
    dynamicConnections.emplace_back(new AudioConnection(sidechain_mixer_l, 0, fade_sidechain_l, 0));

    dynamicConnections.emplace_back(new AudioConnection(fade_sidechain_r, 0, master_mixer_r, MASTER_MIX_CH_SIDECHAIN));
    dynamicConnections.emplace_back(new AudioConnection(fade_sidechain_l, 0, master_mixer_l, MASTER_MIX_CH_SIDECHAIN));

#ifdef BITCRUSH
    dynamicConnections.emplace_back(new AudioConnection(bitcrush_effect, 0, master_mixer_r, MASTER_MIX_CH_BITCRUSH));
    dynamicConnections.emplace_back(new AudioConnection(bitcrush_effect, 0, master_mixer_l, MASTER_MIX_CH_BITCRUSH));

    dynamicConnections.emplace_back(new AudioConnection(bitcrush_mixer, 0, bitcrush_effect, 0));
#endif

  }
  else
    if (instance_id == 1)
      dynamicConnections.emplace_back(new AudioConnection(*MicroDexed[instance_id], 0, microdexed_peak_1, 0));
#if defined(DRUMS_FILTERS)  
    else
      if (instance_id == 2)
        dynamicConnections.emplace_back(new AudioConnection(*MicroDexed[instance_id], 0, microdexed_peak_2, 0));
      else
        if (instance_id == 3)
          dynamicConnections.emplace_back(new AudioConnection(*MicroDexed[instance_id], 0, microdexed_peak_3, 0));
#endif

#ifdef BITCRUSH
  dynamicConnections.emplace_back(new AudioConnection(*MicroDexed[instance_id], 0, bitcrush_mixer, instance_id));
  if (instance_id == 0)
  {
    dynamicConnections.emplace_back(new AudioConnection(drum_mixer_r, 0, bitcrush_mixer, 4));
    dynamicConnections.emplace_back(new AudioConnection(drum_mixer_l, 0, bitcrush_mixer, 5));
  }
#endif

  dynamicConnections.emplace_back(new AudioConnection(*MicroDexed[instance_id], 0, *global_delay_in_mixer[0], instance_id));
  dynamicConnections.emplace_back(new AudioConnection(*MicroDexed[instance_id], 0, *global_delay_in_mixer[1], instance_id));

  //chorus
  dynamicConnections.emplace_back(new AudioConnection(*MicroDexed[instance_id], 0, *dexed_chorus[instance_id], 0));
  dynamicConnections.emplace_back(new AudioConnection(*chorus_modulator[instance_id], 0, *dexed_chorus[instance_id], 1));

  dynamicConnections.emplace_back(new AudioConnection(*dexed_chorus[instance_id], 0, dexed_chorus_mixer_r[instance_id], 1));
  dynamicConnections.emplace_back(new AudioConnection(*dexed_chorus[instance_id], 0, dexed_chorus_mixer_l[instance_id], 1));

  //normal
  dynamicConnections.emplace_back(new AudioConnection(dexed_chorus_mixer_r[instance_id], 0, master_mixer_r, instance_id));
  dynamicConnections.emplace_back(new AudioConnection(dexed_chorus_mixer_l[instance_id], 0, master_mixer_l, instance_id));

  //test fades with sidechain mixer

  dynamicConnections.emplace_back(new AudioConnection(dexed_chorus_mixer_r[instance_id], 0, sidechain_mixer_r, instance_id));
  dynamicConnections.emplace_back(new AudioConnection(dexed_chorus_mixer_l[instance_id], 0, sidechain_mixer_l, instance_id));

  //test fades sidechain mixer

  if (instance_id == 0 || instance_id == 1)
  {
    dynamicConnections.emplace_back(new AudioConnection(*global_delay_in_mixer[instance_id], 0, global_delay_filter[instance_id], 0));
    dynamicConnections.emplace_back(new AudioConnection(*global_delay_in_mixer[instance_id], 0, global_delay_filter_mixer[instance_id], 0)); // bypass

    dynamicConnections.emplace_back(new AudioConnection(global_delay_filter[instance_id], 0, global_delay_filter_mixer[instance_id], 1));    // low
    dynamicConnections.emplace_back(new AudioConnection(global_delay_filter[instance_id], 1, global_delay_filter_mixer[instance_id], 2));    // band
    dynamicConnections.emplace_back(new AudioConnection(global_delay_filter[instance_id], 2, global_delay_filter_mixer[instance_id], 3));    // hi

    dynamicConnections.emplace_back(new AudioConnection(global_delay_filter_mixer[instance_id], 0, *delay_fb_mixer[instance_id], 0));
    dynamicConnections.emplace_back(new AudioConnection(global_delay_filter_mixer[instance_id], 0, *delay_mixer[instance_id], 0));

    dynamicConnections.emplace_back(new AudioConnection(*delay_fb_mixer[instance_id], 0, *Gate[instance_id], 0));
    dynamicConnections.emplace_back(new AudioConnection(*delay_fb_mixer[instance_id], 0, *Gate[instance_id], 1));

    dynamicConnections.emplace_back(new AudioConnection(*delay_fx[instance_id], 0, *delay_fb_mixer[instance_id], 1));

    dynamicConnections.emplace_back(new AudioConnection(*delay_fx[instance_id], 0, *delay_mixer[instance_id], 1));

    dynamicConnections.emplace_back(new AudioConnection(*delay_mixer[instance_id], 0, *delay_mono2stereo[instance_id], 0));
  }

  dynamicConnections.emplace_back(new AudioConnection(*MicroDexed[instance_id], 0, reverb_mixer_r, instance_id));
  dynamicConnections.emplace_back(new AudioConnection(*MicroDexed[instance_id], 0, reverb_mixer_l, instance_id));


  if (instance_id == 0 || instance_id == 1) //connections to delay 1 and delay 2
  {

    // epiano delay
    dynamicConnections.emplace_back(new AudioConnection(ep, 0, *global_delay_in_mixer[instance_id], 7));
    dynamicConnections.emplace_back(new AudioConnection(ep, 1, *global_delay_in_mixer[instance_id], 8));

    // microsynth delays
    dynamicConnections.emplace_back(new AudioConnection(microsynth_mixer_filter_osc[0], 0, *global_delay_in_mixer[instance_id], 4));
    dynamicConnections.emplace_back(new AudioConnection(microsynth_mixer_filter_osc[1], 0, *global_delay_in_mixer[instance_id], 5));

  }

  dynamicConnections.emplace_back(new AudioConnection(*MicroDexed[instance_id], 0, *dexed_mono2stereo[instance_id], 0));
  //dynamicConnections.emplace_back(new AudioConnection(*MicroDexed[instance_id], 1, *dexed_mono2stereo[instance_id], 1));

  // dexed dry output
  dynamicConnections.emplace_back(new AudioConnection(*dexed_mono2stereo[instance_id], 0, dexed_chorus_mixer_r[instance_id], 0));
  dynamicConnections.emplace_back(new AudioConnection(*dexed_mono2stereo[instance_id], 1, dexed_chorus_mixer_l[instance_id], 0));


  // delay outs as sends to reverb
  dynamicConnections.emplace_back(new AudioConnection(*delay_mixer[instance_id], 0, reverb_mixer_r, REVERB_MIX_CH_AUX_DELAY1 + instance_id));
  dynamicConnections.emplace_back(new AudioConnection(*delay_mixer[instance_id], 0, reverb_mixer_l, REVERB_MIX_CH_AUX_DELAY1 + instance_id));

  // master out
  dynamicConnections.emplace_back(new AudioConnection(*delay_mono2stereo[instance_id], 0, master_mixer_r, MASTER_MIX_CH_DELAY1 + instance_id));
  dynamicConnections.emplace_back(new AudioConnection(*delay_mono2stereo[instance_id], 1, master_mixer_l, MASTER_MIX_CH_DELAY1 + instance_id));

  // sidechain
  dynamicConnections.emplace_back(new AudioConnection(*delay_mono2stereo[instance_id], 0, sidechain_mixer_r, MASTER_MIX_CH_DELAY1 + instance_id));
  dynamicConnections.emplace_back(new AudioConnection(*delay_mono2stereo[instance_id], 1, sidechain_mixer_l, MASTER_MIX_CH_DELAY1 + instance_id));

  if (instance_id == 1)
  {
    // delay1 to delay2
    dynamicConnections.emplace_back(new AudioConnection(*global_delay_in_mixer[0], 0, *global_delay_in_mixer[1], 9));
    // delay2 to delay1
    dynamicConnections.emplace_back(new AudioConnection(*global_delay_in_mixer[1], 0, *global_delay_in_mixer[0], 9));

#ifdef GRANULAR
    dynamicConnections.emplace_back(new AudioConnection(granular_filter_l, 0, *global_delay_in_mixer[0], 18));
    dynamicConnections.emplace_back(new AudioConnection(granular_filter_r, 0, *global_delay_in_mixer[1], 18));
#endif
#ifdef BITCRUSH
    dynamicConnections.emplace_back(new AudioConnection(bitcrush_effect, 0, *global_delay_in_mixer[0], 19));
    dynamicConnections.emplace_back(new AudioConnection(bitcrush_effect, 0, *global_delay_in_mixer[1], 19));
#endif


  }

#ifdef DEBUG
  LOG.print(F("Dexed-Instance: "));
  LOG.println(instance_id);
#endif
}

FLASHMEM void create_audio_braids_chain(uint8_t instance_id)
{
  synthBraids[instance_id] = new AudioSynthBraids();
  braids_envelope[instance_id] = new AudioEffectEnvelope();
  braids_filter[instance_id] = new AudioFilterBiquad();
  braids_mixer_filter[instance_id] = new AudioMixer<4>();

  dynamicConnections.emplace_back(new AudioConnection(*synthBraids[instance_id], 0, *braids_envelope[instance_id], 0));
  dynamicConnections.emplace_back(new AudioConnection(*braids_envelope[instance_id], 0, *braids_filter[instance_id], 0));
  dynamicConnections.emplace_back(new AudioConnection(*braids_filter[instance_id], 0, *braids_mixer_filter[instance_id], 0));
  dynamicConnections.emplace_back(new AudioConnection(*braids_envelope[instance_id], 0, *braids_mixer_filter[instance_id], 3)); // filter is off
  dynamicConnections.emplace_back(new AudioConnection(*braids_mixer_filter[instance_id], 0, braids_mixer, instance_id));

  if (instance_id == 0)
  {

    dynamicConnections.emplace_back(new AudioConnection(braids_mixer, 0, braids_stereo_panorama, 0));
    dynamicConnections.emplace_back(new AudioConnection(braids_mixer, 0, braids_stereo_panorama, 1));

    dynamicConnections.emplace_back(new AudioConnection(braids_stereo_panorama, 0, braids_flanger_r, 0));
    dynamicConnections.emplace_back(new AudioConnection(braids_stereo_panorama, 1, braids_flanger_l, 0));

    //normal
    dynamicConnections.emplace_back(new AudioConnection(braids_flanger_r, 0, master_mixer_r, MASTER_MIX_CH_BRAIDS));
    dynamicConnections.emplace_back(new AudioConnection(braids_flanger_l, 0, master_mixer_l, MASTER_MIX_CH_BRAIDS));

    // sidechain mixer
    dynamicConnections.emplace_back(new AudioConnection(braids_flanger_r, 0, sidechain_mixer_r, MASTER_MIX_CH_BRAIDS));
    dynamicConnections.emplace_back(new AudioConnection(braids_flanger_l, 0, sidechain_mixer_l, MASTER_MIX_CH_BRAIDS));

    // sidechain mixer end
    dynamicConnections.emplace_back(new AudioConnection(braids_mixer, 0, braids_mixer_reverb, 0));
    dynamicConnections.emplace_back(new AudioConnection(braids_mixer, 0, braids_mixer_reverb, 1));
    dynamicConnections.emplace_back(new AudioConnection(braids_mixer_reverb, 0, reverb_mixer_r, REVERB_MIX_CH_BRAIDS));
    dynamicConnections.emplace_back(new AudioConnection(braids_mixer_reverb, 1, reverb_mixer_l, REVERB_MIX_CH_BRAIDS));

    dynamicConnections.emplace_back(new AudioConnection(braids_stereo_panorama, 0, braids_peak_r, 0));
    dynamicConnections.emplace_back(new AudioConnection(braids_stereo_panorama, 1, braids_peak_l, 0));

    // braids delays
    dynamicConnections.emplace_back(new AudioConnection(braids_mixer, 0, *global_delay_in_mixer[0], 6));
    dynamicConnections.emplace_back(new AudioConnection(braids_mixer, 0, *global_delay_in_mixer[1], 6));
  }
}

//
// Dynamic patching of Drum objects
//
FLASHMEM void create_audio_drum_chain(uint8_t instance_id)
{
  // Drum[instance_id] = new AudioPlayMemory();
  // Drum[instance_id] = new AudioPlaySdWav();

#if defined(DRUMS_FILTERS) 
  sample_envelope[instance_id] = new AudioEffectEnvelope();
  sample_envelope[instance_id + NUM_DRUMS] = new AudioEffectEnvelope();
  sample_envelope[instance_id]->releaseNoteOn(0);
  sample_envelope[instance_id + NUM_DRUMS]->releaseNoteOn(0);
#endif

#ifdef COMPILE_FOR_SDCARD
  Drum[instance_id] = new AudioPlaySdResmp();
#endif

  Drum[instance_id] = new PitchSamplePlayer();

  Drum[instance_id]->enableInterpolation(false);

  Drum[instance_id]->setPlaybackRate(1.0);

#if defined(DRUMS_FILTERS) 
  Drum_filter[instance_id] = new AudioFilterBiquad();
  Drum_filter[instance_id + NUM_DRUMS] = new AudioFilterBiquad();

  Drum_filter[instance_id]->setLowpass(0, 20000, 0.2); //phtodo
  Drum_filter[instance_id + NUM_DRUMS]->setLowpass(0, 20000, 0.2); //phtodo
#endif

#if defined(DRUMS_FILTERS) 
  dynamicConnections.emplace_back(new AudioConnection(*Drum[instance_id], 0, *sample_envelope[instance_id], 0));
  dynamicConnections.emplace_back(new AudioConnection(*Drum[instance_id], 1, *sample_envelope[NUM_DRUMS + instance_id], 0));

  dynamicConnections.emplace_back(new AudioConnection(*sample_envelope[instance_id], 0, *Drum_filter[instance_id], 0));
  dynamicConnections.emplace_back(new AudioConnection(*sample_envelope[NUM_DRUMS + instance_id], 0, *Drum_filter[NUM_DRUMS + instance_id], 0));

  dynamicConnections.emplace_back(new AudioConnection(*Drum_filter[instance_id], 0, drum_mixer_r, instance_id));
  dynamicConnections.emplace_back(new AudioConnection(*Drum_filter[NUM_DRUMS + instance_id], 0, drum_mixer_l, instance_id));

  dynamicConnections.emplace_back(new AudioConnection(*Drum_filter[instance_id], 0, drum_reverb_send_mixer_r, instance_id));
  dynamicConnections.emplace_back(new AudioConnection(*Drum_filter[NUM_DRUMS + instance_id], 0, drum_reverb_send_mixer_l, instance_id));

  dynamicConnections.emplace_back(new AudioConnection(*Drum_filter[instance_id], 0, *global_delay_in_mixer[0], 10 + instance_id));
  dynamicConnections.emplace_back(new AudioConnection(*Drum_filter[NUM_DRUMS + instance_id], 0, *global_delay_in_mixer[1], 10 + instance_id));
#else
  //no filter code
  dynamicConnections.emplace_back(new AudioConnection(*Drum[instance_id], 0, drum_mixer_r, instance_id));
  dynamicConnections.emplace_back(new AudioConnection(*Drum[instance_id], 1, drum_mixer_l, instance_id));
  dynamicConnections.emplace_back(new AudioConnection(*Drum[instance_id], 0, drum_reverb_send_mixer_r, instance_id));
  dynamicConnections.emplace_back(new AudioConnection(*Drum[instance_id], 1, drum_reverb_send_mixer_l, instance_id));
  dynamicConnections.emplace_back(new AudioConnection(*Drum[instance_id], 0, *global_delay_in_mixer[0], 10 + instance_id));
  dynamicConnections.emplace_back(new AudioConnection(*Drum[instance_id], 1, *global_delay_in_mixer[1], 10 + instance_id));

  //dynamicConnections.emplace_back(new AudioConnection(*Drum[instance_id], 0, *Drum_filter[instance_id], 0);
  //dynamicConnections.emplace_back(new AudioConnection(*Drum[instance_id], 1, *Drum_filter[NUM_DRUMS + instance_id], 0);
#endif

#ifdef DEBUG
  LOG.print(F("Drum-Instance: "));
  LOG.println(instance_id);
  LOG.print(F("Dynamic-Connection-Counter="));
  LOG.println(dynamicConnections.size());
#endif
}

FLASHMEM void create_audio_wav_preview_chain()
{
#ifdef COMPILE_FOR_PSRAM
  dynamicConnections.emplace_back(new AudioConnection(WAV_preview_PSRAM, 1, master_mixer_r, MASTER_MIX_CH_WAV_PREVIEW_PSRAM));
  dynamicConnections.emplace_back(new AudioConnection(WAV_preview_PSRAM, 0, master_mixer_l, MASTER_MIX_CH_WAV_PREVIEW_PSRAM));
#endif

}

uint8_t sd_card_internal = 0;
Sd2Card card_internal;
SdVolume volume_internal;

#ifdef  SECOND_SD
uint8_t sd_card_external = 0;
Sd2Card card_external;
SdVolume volume_external;
#endif

uint8_t midi_bpm_counter = 0;
uint8_t midi_bpm = 0;
int16_t _midi_bpm = -1;
elapsedMillis midi_bpm_timer;
//elapsedMillis long_button_pressed;
elapsedMillis control_rate;
elapsedMillis save_sys;
elapsedMillis touchReadTimer = 0;

static constexpr int SCREENSAVER_RESET_RATE_MS = 500;
elapsedMillis screenSaverResetTimer = 0;
bool wakeScreenFlag = true;

bool save_sys_flag = false;
uint8_t active_voices[NUM_DEXED];
uint8_t midi_voices[NUM_DEXED];
#ifdef SHOW_CPU_LOAD_MSEC
elapsedMillis cpu_mem_millis;
#endif
uint32_t cpumax = 0;

bool sidechain_active = false;
bool sidechain_trigger;
uint8_t sidechain_sample_number = NUM_DRUMSET_CONFIG - 1;
int sidechain_speed = 0;
uint8_t sidechain_steps = 4;

sdcard_t sdcard_infos;

config_t configuration;
char version_string[display_cols + 10 + 1];
char sd_string[display_cols + 1];
char g_bank_name[NUM_DEXED][BANK_NAME_LEN];
char g_voice_name[NUM_DEXED][VOICE_NAME_LEN];
char tmp_bank_name[BANK_NAME_LEN];
char tmp_voice_name[VOICE_NAME_LEN];
char receive_bank_filename[FILENAME_LEN];
uint8_t selected_instance_id = 0;
uint8_t microsynth_selected_instance = 0;
bool ui_save_notification_icon;

uint8_t remote_MIDI_CC = 0;
uint8_t remote_MIDI_CC_value;

uint8_t incomingSerialByte;

int8_t midi_decay_dexed[NUM_DEXED] = { -1, -1 };
int8_t midi_decay_microsynth[NUM_MICROSYNTH];
elapsedMillis midi_decay_timer_microsynth;
elapsedMillis microsynth_control_rate;
elapsedMillis midi_decay_timer_dexed;

// Allocate the delay lines for chorus
int16_t* delayline[NUM_DEXED];
int16_t* ep_delayline_r;
int16_t* ep_delayline_l;

extern drum_config_t drum_config[NUM_DRUMSET_CONFIG];
extern CustomSample customSamples[NUM_CUSTOM_SAMPLES];
uint8_t drum_counter;
uint8_t drum_midi_channel = DEFAULT_DRUM_MIDI_CHANNEL;
uint8_t slices_midi_channel = drum_midi_channel + 1;
extern sequencer_t seq;
PeriodicTimer sequencer_timer;
PeriodicTimer MIDI_input_timer;

multisample_s msp[NUM_MULTISAMPLES];
multisample_zone_t msz[NUM_MULTISAMPLES][NUM_MULTISAMPLE_ZONES];
uint8_t note_buffer_msp[NUM_DRUMS];

extern LCDMenuLib2 LCDML;

custom_midi_map_t custom_midi_map[NUM_CUSTOM_MIDI_MAPPINGS];

bool touch_ic_found = false;

// // Hook (https://www.pjrc.com/teensy/td_startup.html)
// extern "C" void startup_late_hook(void);
// extern "C" volatile uint32_t systick_millis_count;

// void startup_late_hook(void) {
//   // force millis() to be 300 to skip startup delays
//   systick_millis_count = 300;

#if defined (RGB_ENCODERS) && defined (MCP_23008) || defined (RGB_ENCODERS) && defined (MCP_23017)

void setled(uint8_t pin, bool state)
{
  mcp.write1(pin, state);
}

FLASHMEM void set_custom_enc_colors()
{

  mcp.write1(RGB_LED_L_RED, !bitRead(configuration.sys.rgb_enc_color_def, 0));
  mcp.write1(RGB_LED_L_GREEN, !bitRead(configuration.sys.rgb_enc_color_def, 1));
  mcp.write1(RGB_LED_L_BLUE, !bitRead(configuration.sys.rgb_enc_color_def, 2));

  if (LCDML.FUNC_getID() == LCDML.OTHER_getIDFromFunction(UI_func_system_settings) && generic_active_function)
  {
    mcp.write1(RGB_LED_R_RED, !bitRead(configuration.sys.rgb_enc_color_sel, 0));
    mcp.write1(RGB_LED_R_GREEN, !bitRead(configuration.sys.rgb_enc_color_sel, 1));
    mcp.write1(RGB_LED_R_BLUE, !bitRead(configuration.sys.rgb_enc_color_sel, 2));
  }
  else if (seq.edit_state == 0)
  {
    mcp.write1(RGB_LED_R_RED, !bitRead(configuration.sys.rgb_enc_color_def, 0));
    mcp.write1(RGB_LED_R_GREEN, !bitRead(configuration.sys.rgb_enc_color_def, 1));
    mcp.write1(RGB_LED_R_BLUE, !bitRead(configuration.sys.rgb_enc_color_def, 2));
  }
  else
  {
    mcp.write1(RGB_LED_R_RED, !bitRead(configuration.sys.rgb_enc_color_sel, 0));
    mcp.write1(RGB_LED_R_GREEN, !bitRead(configuration.sys.rgb_enc_color_sel, 1));
    mcp.write1(RGB_LED_R_BLUE, !bitRead(configuration.sys.rgb_enc_color_sel, 2));
  }
}

#endif

/***********************************************************************
   SETUP
 ***********************************************************************/

#ifdef MUSIKANDMORE
bool cv_clock;
bool cv_clock_previous;
bool trs_pedal;
bool trs_pedal_previous;
int analog_volume_value;
int analog_volume_value_previous;
#endif

void updateEncoderL(void)
{
  ENCODER[ENC_L].update();
}

void updateEncoderR(void)
{
  ENCODER[ENC_R].update();
}

extern bool trs_pedal;

#if (defined BUTTON_LEDS && defined MCP_23008) || (defined BUTTON_LEDS && defined MCP_23017)
FLASHMEM void All_Button_LEDS(bool state)
{
  if (state)
  {

    setled(LED_UP, HIGH);

    if (configuration.sys.sus_pedal)
      setled(LED_DOWN, trs_pedal);
    else
      setled(LED_DOWN, HIGH);

    setled(LED_LEFT, HIGH);
    setled(LED_RIGHT, HIGH);
    setled(LED_SEL, HIGH);
    setled(LED_START, HIGH);

    setled(LED_BUT_B, HIGH);
    setled(LED_BUT_A, HIGH);

#ifdef MCP_CV       
    // digitalWrite(GATE_OUT, HIGH);
    digitalWrite(CV_CLOCK_OUT, HIGH);
#endif

  }
  else {
    if (!(configuration.sys.ext_clock && cv_clock))
      setled(LED_UP, LOW);

    if (configuration.sys.sus_pedal)
      setled(LED_DOWN, trs_pedal);
    else
      setled(LED_DOWN, LOW);

    setled(LED_LEFT, LOW);
    setled(LED_RIGHT, LOW);
    setled(LED_SEL, LOW);

    setled(LED_BUT_B, LOW);
    if (seq.running == false)
      setled(LED_START, LOW);

    //if (seq.edit_state==0)
    setled(LED_BUT_A, LOW);

#ifdef MCP_CV       
    // digitalWrite(GATE_OUT, LOW);
    digitalWrite(CV_CLOCK_OUT, LOW);
#endif

  }
}
#endif

#ifdef  MCP_CV
FLASHMEM void initMCP4728() {
  dac.attach(Wire, 14);
  //dac.readRegisters();
  dac.selectVref(MCP4728::VREF::INTERNAL_2_8V, MCP4728::VREF::INTERNAL_2_8V, MCP4728::VREF::INTERNAL_2_8V, MCP4728::VREF::INTERNAL_2_8V);
  dac.selectPowerDown(MCP4728::PWR_DOWN::NORMAL, MCP4728::PWR_DOWN::NORMAL, MCP4728::PWR_DOWN::NORMAL, MCP4728::PWR_DOWN::NORMAL);
  dac.selectGain(MCP4728::GAIN::X2, MCP4728::GAIN::X2, MCP4728::GAIN::X2, MCP4728::GAIN::X2);
  // dac.analogWrite(MCP4728::DAC_CH::A, 111);
  // dac.analogWrite(MCP4728::DAC_CH::B, 222);
  // dac.analogWrite(MCP4728::DAC_CH::C, 333);
  // dac.analogWrite(MCP4728::DAC_CH::D, 444);
  dac.enable(true);
  //dac.readRegisters();
  delay(500);
}
#endif

#ifdef GRANULAR
extern void updateGranularFilters();
#endif

FLASHMEM void setup()
{

  //**************************
  //Reset QSPI clock from 88Mhz to 132 Mhz.
  CCM_CCGR7 |= CCM_CCGR7_FLEXSPI2(CCM_CCGR_OFF);
  CCM_CBCMR = (CCM_CBCMR & ~(CCM_CBCMR_FLEXSPI2_PODF_MASK | CCM_CBCMR_FLEXSPI2_CLK_SEL_MASK))
    | CCM_CBCMR_FLEXSPI2_PODF(4) | CCM_CBCMR_FLEXSPI2_CLK_SEL(2); // 528/5 = 132 MHz
  CCM_CCGR7 |= CCM_CCGR7_FLEXSPI2(CCM_CCGR_ON);
  //**************************

#ifdef GRANULAR
  granularPoly.begin();

  granular_params.grain_size = 40;
  granular_params.grain_position = 50;
  granular_params.semitones = 50;
  granular_params.volume = 95;
  granular_params.density = 30;
  granular_params.spread = 80;
  granular_params.active = true;

  //  granularPoly.setParams(params);

#endif

//d50Synth.begin();



#if  !defined CAPACITIVE_TOUCH_DISPLAY
  delay(60);
#endif


#ifdef  MCP_CV
  initMCP4728();  // 4x 12Bit DAC MCP4728 Init
  pinMode(GATE_OUT, OUTPUT);
#endif

#if defined (RGB_ENCODERS) && defined (MCP_23008) || defined (RGB_ENCODERS) && defined (MCP_23017)

  Wire.begin();
  Wire.setClock(400000);
  // Wire.setClock(100000);
  mcp.begin();

#if defined MCP_23008
  mcp.pinMode8(0x00);    //  0 = output,  1 = input
#endif

#if defined MCP_23017
  mcp.pinMode8(0, 0x00);  //  0 = output , 1 = input
  mcp.pinMode8(1, 0x00);
#endif

  //mcp.write8(0xFF);

  setled(RGB_LED_R_RED, HIGH);
  setled(RGB_LED_R_GREEN, HIGH);
  setled(RGB_LED_R_BLUE, LOW);

  // mcp.setAllPins(B, HIGH);

#endif

#if (defined BUTTON_LEDS && defined MCP_23008) || (defined BUTTON_LEDS && defined MCP_23017)
  // mcp.pinMode(LED_UP, OUTPUT);
  // mcp.pinMode(LED_DOWN, OUTPUT);
  // mcp.pinMode(LED_LEFT, OUTPUT);
  // mcp.pinMode(LED_RIGHT, OUTPUT);
  // mcp.pinMode(LED_SEL, OUTPUT);
  // mcp.pinMode(LED_START, OUTPUT);
  // mcp.pinMode(LED_BUT_A, OUTPUT);
  // mcp.pinMode(LED_BUT_B, OUTPUT);
 // All_Button_LEDS(true);
#endif

#ifdef MIDI_ACTIVITY_LIGHTS
  pinMode(LED_MIDI_IN, OUTPUT);
  pinMode(LED_MIDI_OUT, OUTPUT);
#endif

#ifdef MUSIKANDMORE // MUSIKANDMORE Hardware Pins
  pinMode(MCP_INTA, INPUT_PULLUP);
  pinMode(ANALOG_VOLUME_IN, INPUT_PULLUP);
  pinMode(CV_CLOCK_OUT, OUTPUT);
  pinMode(CV_CLOCK_IN, INPUT_PULLUP);
  pinMode(TRS_PEDAL_IN, INPUT_PULLUP);
#endif

#ifdef DEBUG
  LOG.println(CrashReport);
  // setup_debug_message();

  generate_version_string(version_string, sizeof(version_string));
  LOG.println(F("MicroDexed based on https://github.com/asb2m10/dexed"));
  LOG.println(F("(c)2018-2023 H. Wirtz <wirtz@parasitstudio.de>"));
  LOG.println(F("https://codeberg.org/dcoredump/MicroDexed"));
  LOG.println(F("MicroDexed touch based on https://codeberg.org/dcoredump/MicroDexed"));
  LOG.println(F("https://codeberg.org/positionhigh/MicroDexed-touch"));
  LOG.print(F("Version: "));
  LOG.println(version_string);
  LOG.print(F("CPU-Speed: "));
  LOG.print(F_CPU / 1000000.0, 1);
  LOG.println(F(" MHz"));
  LOG.println(F("<setup start>"));
  LOG.flush();
#endif

  //Reset clock to 132 Mhz
        // CCM_CCGR7 |= CCM_CCGR7_FLEXSPI2(CCM_CCGR_OFF);
        // CCM_CBCMR = (CCM_CBCMR & ~(CCM_CBCMR_FLEXSPI2_PODF_MASK | CCM_CBCMR_FLEXSPI2_CLK_SEL_MASK))
        //     | CCM_CBCMR_FLEXSPI2_PODF(4) | CCM_CBCMR_FLEXSPI2_CLK_SEL(2); // 528/5 = 132 MHz
        // CCM_CCGR7 |= CCM_CCGR7_FLEXSPI2(CCM_CCGR_ON);

#ifdef PSRAM
  // zero all malloccable RAM so crashes are deterministic
  std::vector<uint8_t*> blocks;
  int size = 10000;
  bool done = false;
  while (done == false) {
    uint8_t* b = (uint8_t*)malloc(size);
    done = b == nullptr;
    if (done == false) {
      memset(b, 0x00, size);
      blocks.emplace_back(b);
    }
  }
  for (uint8_t* b : blocks) {
    free(b);
  }
  blocks.clear();
  // ***********
#endif

#ifdef CAPACITIVE_TOUCH_DISPLAY
  pinMode(TFT_TOUCH_IRQ, INPUT);
#endif

#if defined (RGB_ENCODERS) && defined (MCP_23008) || defined (RGB_ENCODERS) && defined (MCP_23017)
  pinMode(BUT_R_PIN, INPUT);
  pinMode(BUT_L_PIN, INPUT);
#else
  pinMode(BUT_R_PIN, INPUT_PULLUP);
  pinMode(BUT_L_PIN, INPUT_PULLUP);
#endif


  //Encoder with Interrupts
  attachInterrupt(ENC_L_PIN_A, updateEncoderL, CHANGE);
  attachInterrupt(ENC_L_PIN_B, updateEncoderL, CHANGE);
  attachInterrupt(ENC_R_PIN_A, updateEncoderR, CHANGE);
  attachInterrupt(ENC_R_PIN_B, updateEncoderR, CHANGE);

#ifdef ONBOARD_BUTTON_INTERFACE
  pinMode(BI_UP, INPUT_PULLUP);
  pinMode(BI_DOWN, INPUT_PULLUP);
  pinMode(BI_LEFT, INPUT_PULLUP);
  pinMode(BI_RIGHT, INPUT_PULLUP);
  pinMode(BI_SELECT, INPUT_PULLUP);
  pinMode(BI_START, INPUT_PULLUP);
  pinMode(BI_BUTTON_A, INPUT_PULLUP);
  pinMode(BI_BUTTON_B, INPUT_PULLUP);
#endif

  // Init display
  SPI.begin();
  display.begin();

  // invert display colors
#ifdef CAPACITIVE_TOUCH_DISPLAY
  display.invertDisplay(1);
  //display.invertDisplay(configuration.sys.invert_colors);
#endif

#if defined GENERIC_DISPLAY
  touch.begin();
  touch_ic_found = true;
#endif

#ifdef CAPACITIVE_TOUCH_DISPLAY
  if (!touch.begin(40))
  {
    ;
#ifdef DEBUG
    LOG.println("Unable to start touchscreen.");
#endif
    touch_ic_found = false;

  }
  else
  {
    ;
#ifdef DEBUG
    LOG.println("Touchscreen started.");
#endif
    touch_ic_found = true;
  }
#endif

#ifdef COMPILE_FOR_PSRAM
  psram_free_bytes = external_psram_size * 1048576;
#endif

  // Setup MIDI devices
  setup_midi_devices();

  // Start audio system
  AudioMemory(AUDIO_MEM);

  // add a 1 bit DC offset to prevent a pop / tick sound whenever the envelope becomes silent, probably due to the DAC switching to power-saving mode
  dc1.amplitude(-1.0f / 32768.0f);

#if defined(TEENSY_AUDIO_BOARD)
  sgtl5000.enable();
  sgtl5000.lineOutLevel(SGTL5000_LINEOUT_LEVEL);
  sgtl5000.dacVolumeRamp();
  sgtl5000.dacVolume(1.0);
  // sgtl5000.dacVolumeRampLinear();
  // sgtl5000.dacVolumeRampDisable();
  sgtl5000.unmuteHeadphone();
  sgtl5000.unmuteLineout();
  sgtl5000.volume(SGTL5000_HEADPHONE_VOLUME, SGTL5000_HEADPHONE_VOLUME); // Headphone volume

#ifdef SGTL5000_AUDIO_THRU
  // sgtl5000.audioPreProcessorEnable();
  sgtl5000.inputSelect(AUDIO_INPUT_LINEIN);
  sgtl5000.lineInLevel(5);
  // sgtl5000.adcHighPassFilterEnable();
  // sgtl5000.adcHighPassFilterDisable();
#endif
  sgtl5000.audioProcessorDisable();
  sgtl5000.autoVolumeDisable();
  sgtl5000.surroundSoundDisable();
  sgtl5000.enhanceBassDisable();

#ifdef DEBUG
  LOG.println(F("Teensy-Audio-Board enabled."));
#endif

#elif defined(TGA_AUDIO_BOARD)
  wm8731_1.enable();
  wm8731_1.volume(1.0);
#ifdef DEBUG
  LOG.println(F("TGA board enabled."));
#endif
#elif defined(I2S_AUDIO_ONLY)
#ifdef DEBUG
  LOG.println(F("I2S enabled."));
#endif
#elif defined(PT8211_AUDIO)
#ifdef DEBUG
  LOG.println(F("PT8211 enabled."));
#endif
#elif defined(TEENSY_DAC_SYMMETRIC)
  invMixer.gain(0, -1.f);
#ifdef DEBUG
  LOG.println(F("Internal DAC using symmetric outputs enabled."));
#endif
#else

#ifdef DEBUG
  LOG.println(F("Internal DAC enabled."));
#endif

#endif

#ifdef MUSIKANDMORE
  All_Button_LEDS(true);
#endif

  // create dynamic Dexed instances
  for (uint8_t instance_id = 0; instance_id < NUM_DEXED; instance_id++)
  {
#ifdef DEBUG
    LOG.print(F("Creating MicroDexed instance "));
    LOG.println(instance_id, DEC);
#endif
    create_audio_dexed_chain(instance_id);
  }
#ifdef DEBUG
  for (uint8_t instance_id = 0; instance_id < NUM_DEXED; instance_id++)
  {
    LOG.print(F("Instance "));
    LOG.print(instance_id);
    LOG.print(F(": "));
    LOG.print(MicroDexed[instance_id]->getMaxNotes());
    LOG.println(F(" voices"));
  }
#endif

  // create dynamic Braids instances
  for (uint8_t instance_id = 0; instance_id < NUM_BRAIDS; instance_id++)
  {
    create_audio_braids_chain(instance_id);
  }

  if (!braids_flanger_r.begin(braids_r_delayline, BRAIDS_FLANGE_DELAY_LENGTH, braids_flanger_idx, braids_flanger_depth, braids_flanger_freq))
  {
#ifdef DEBUG
    LOG.println(F("AudioEffectFlanger - right channel begin failed"));
#endif
    while (1)
      ;
  }

  if (!braids_flanger_l.begin(braids_l_delayline, BRAIDS_FLANGE_DELAY_LENGTH, braids_flanger_idx, braids_flanger_depth, braids_flanger_freq))
  {
#ifdef DEBUG
    LOG.println(F("AudioEffectFlanger - left channel begin failed"));
#endif
    while (1)
      ;
  }
  // Initially the flanger effect is off.
  braids_flanger_r.voices(FLANGE_DELAY_PASSTHRU, 0, 0);
  braids_flanger_l.voices(FLANGE_DELAY_PASSTHRU, 0, 0);

  // Setup (PROGMEM) sample drums
  // create dynamic Drum instances
  for (uint8_t instance_id = 0; instance_id < NUM_DRUMS; instance_id++)
  {
#ifdef DEBUG
    LOG.print(F("Creating Drum instance "));
    LOG.println(instance_id, DEC);
#endif
    create_audio_drum_chain(instance_id);

    drum_mixer_r.gain(instance_id, 1.0);
    drum_mixer_l.gain(instance_id, 1.0);
    drum_reverb_send_mixer_r.gain(instance_id, 0.0);
    drum_reverb_send_mixer_l.gain(instance_id, 0.0);

#if defined SMFPLAYER
    SMF.begin(&(SdFat&)SD);
    SMF.setMidiHandler(midiCallback);
#endif
  }

  // Setup EPiano
  // EP_CHORUS
  ep_delayline_r = (int16_t*)malloc(MOD_DELAY_SAMPLE_BUFFER * sizeof(int16_t));
  if (ep_delayline_r == NULL)
  {
#ifdef DEBUG
    LOG.println(F("AudioEffectModulatedDelay R - memory allocation failed EP"));
#endif
    while (1)
      ;
  }
  ep_delayline_l = (int16_t*)malloc(MOD_DELAY_SAMPLE_BUFFER * sizeof(int16_t));
  if (ep_delayline_l == NULL)
  {
#ifdef DEBUG
    LOG.println(F("AudioEffectModulatedDelay L - memory allocation failed EP"));
#endif
    while (1)
      ;
  }

  if (!ep_modchorus.begin(ep_delayline_r, ep_delayline_l, MOD_DELAY_SAMPLE_BUFFER))
  {
#ifdef DEBUG
    LOG.println(F("AudioEffectModulatedDelayStereo - begin failed EP"));
#endif
    while (1)
      ;
  }

#if MOD_FILTER_OUTPUT == MOD_BUTTERWORTH_FILTER_OUTPUT
  // Butterworth filter, 12 db/octave
  ep_modchorus_filter.setLowpass(0, MOD_FILTER_CUTOFF_HZ, 0.707);
#elif MOD_FILTER_OUTPUT == MOD_LINKWITZ_RILEY_FILTER_OUTPUT
  // Linkwitz-Riley filter, 48 dB/octave
  ep_modchorus_filter.setLowpass(0, MOD_FILTER_CUTOFF_HZ, 0.54);
  ep_modchorus_filter.setLowpass(1, MOD_FILTER_CUTOFF_HZ, 1.3);
  ep_modchorus_filter.setLowpass(2, MOD_FILTER_CUTOFF_HZ, 0.54);
  ep_modchorus_filter.setLowpass(3, MOD_FILTER_CUTOFF_HZ, 1.3);
#endif
  ep_chorus_mixer_r.gain(0, 1.0);
  ep_chorus_mixer_l.gain(0, 1.0);
  ep_chorus_mixer_r.gain(1, mapfloat(EP_CHORUS_LEVEL_DEFAULT, EP_CHORUS_LEVEL_MIN, EP_CHORUS_LEVEL_MAX, 0.0, 0.5));
  ep_chorus_mixer_l.gain(1, mapfloat(EP_CHORUS_LEVEL_DEFAULT, EP_CHORUS_LEVEL_MIN, EP_CHORUS_LEVEL_MAX, 0.0, 0.5));
  ep_stereo_panorama.panorama(mapfloat(PANORAMA_DEFAULT, PANORAMA_MIN, PANORAMA_MAX, -1.0, 1.0));

  microsynth_update_all_settings(0);
  microsynth_update_all_settings(1);

#ifdef GRANULAR
  updateGranularFilters();
#endif

  braids_update_all_settings();

  liveSeq.initOnce();

  // Setup effects

  /// dexed chorus
  for (uint8_t instance_id = 0; instance_id < NUM_DEXED; instance_id++)
  {
    delayline[instance_id] = (int16_t*)malloc(MOD_DELAY_SAMPLE_BUFFER * sizeof(int16_t));
    if (delayline[instance_id] != NULL)
    {
      memset(delayline[instance_id], 0, MOD_DELAY_SAMPLE_BUFFER * sizeof(int16_t));
      if (!dexed_chorus[instance_id]->begin(delayline[instance_id], MOD_DELAY_SAMPLE_BUFFER))
      {
#ifdef DEBUG
        LOG.print(F("AudioEffectModulatedDelay - begin failed ["));
        LOG.print(instance_id);
        LOG.println(F("]"));
#endif
        while (1)
          ;
      }
    }
    else
    {
#ifdef DEBUG
      LOG.print(F("AudioEffectModulatedDelay - memory allocation failed ["));
      LOG.print(instance_id);
      LOG.println(F("]"));
#endif
      while (1)
        ;
    }
  }
#ifdef DEBUG
  LOG.print(F("MOD_DELAY_SAMPLE_BUFFER="));
  LOG.print(MOD_DELAY_SAMPLE_BUFFER, DEC);
  LOG.println(F(" samples"));
#endif

  // Setup WAV preview play
  create_audio_wav_preview_chain();

#if defined(COMPILE_FOR_PSRAM)
  master_mixer_r.gain(MASTER_MIX_CH_WAV_PREVIEW_PSRAM, 0.5);
  master_mixer_l.gain(MASTER_MIX_CH_WAV_PREVIEW_PSRAM, 0.5);
#endif

  AudioNoInterrupts();
  // Start SD card
  sd_card_internal = check_internal_sd_card();

#ifdef  SECOND_SD
  check_external_sd_card();
#endif

  AudioInterrupts();
  if (sd_card_internal < 1)
  {
#ifdef DEBUG
    LOG.println(F("SD card not accessible."));
#endif
    strcpy(receive_bank_filename, "*ERROR*");
    for (uint8_t instance_id = 0; instance_id < NUM_DEXED; instance_id++)
    {
      strcpy(g_voice_name[instance_id], "*ERROR*");
      strcpy(g_bank_name[instance_id], "*ERROR*");
    }
  }
  else
  {
#ifdef DEBUG
    LOG.println(F("SD card found."));
#endif
    AudioNoInterrupts();
    check_and_create_directories();
    AudioInterrupts();
    memset(receive_bank_filename, 0, FILENAME_LEN);
    for (uint8_t instance_id = 0; instance_id < NUM_DEXED; instance_id++)
    {
      // load default SYSEX data
      load_sd_voice(configuration.dexed[instance_id].pool, configuration.dexed[instance_id].bank, configuration.dexed[instance_id].voice, instance_id);

      memset(g_voice_name[instance_id], 0, VOICE_NAME_LEN);
      memset(g_bank_name[instance_id], 0, BANK_NAME_LEN);
    }
  }

  // Start timer (to avoid a crash when loading the performance data)
  sequencer_timer.begin(sequencer, seq.tempo_ms / (seq.ticks_max + 1), false);
#if !defined APC
  //MIDI_input_timer.begin(check_midi_devices, 5000, true);  //crashes when using APC with timer interrupt (USB Host MIDI out+in at the same time?)
#endif

#if defined (RGB_ENCODERS) && defined (MCP_23008) || defined (RGB_ENCODERS) && defined (MCP_23017)
  if (digitalRead(BUT_R_PIN) || digitalRead(BUT_L_PIN)) // is pushed
    bootup_performance_loading = false;
#else
  if (digitalRead(BUT_R_PIN) == false || digitalRead(BUT_L_PIN) == false) // is pushed
    bootup_performance_loading = false;
#endif


#ifdef ONBOARD_BUTTON_INTERFACE
  if (digitalRead(BI_BUTTON_A) == false || digitalRead(BI_BUTTON_B) == false) // is pushed
    bootup_performance_loading = false;
#endif

  // Initialize processor and memory measurements
  AudioProcessorUsageMaxReset();
  AudioMemoryUsageMaxReset();

  // Load voices
#ifdef DEBUG
  for (uint8_t instance_id = 0; instance_id < NUM_DEXED; instance_id++)
  {
    LOG.print(F("Dexed instance "));
    LOG.print(instance_id);
    LOG.println(F(":"));
    LOG.print(F("Bank/Voice ["));
    LOG.print(configuration.dexed[instance_id].bank, DEC);
    LOG.print(F("/"));
    LOG.print(configuration.dexed[instance_id].voice, DEC);
    LOG.println(F("]"));
    LOG.print(F("Polyphony: "));
    LOG.println(configuration.dexed[instance_id].polyphony, DEC);
  }
  LOG.print(F("AUDIO_BLOCK_SAMPLES="));
  LOG.print(AUDIO_BLOCK_SAMPLES);
  LOG.print(F(" (Time per block="));
  LOG.print(1000000 / (SAMPLE_RATE / AUDIO_BLOCK_SAMPLES));
  LOG.println(F("ms)"));
#endif

#ifdef DEBUG
  LOG.println(F("Show CPU Usage"));
#endif

#if defined(DEBUG) && defined(SHOW_CPU_LOAD_MSEC)
  show_cpu_and_mem_usage();
#endif

  // Init master_mixer

  for (uint8_t instance_id = 0; instance_id < NUM_DEXED; instance_id++)
  {
    master_mixer_r.gain(instance_id, VOL_MAX_FLOAT);
    master_mixer_l.gain(instance_id, VOL_MAX_FLOAT);

    dexed_chorus_mixer_r[instance_id].gain(0, VOL_MAX_FLOAT);
    dexed_chorus_mixer_l[instance_id].gain(0, VOL_MAX_FLOAT);

    dexed_chorus_mixer_r[instance_id].gain(1, 0);
    dexed_chorus_mixer_l[instance_id].gain(1, 0);

  }

#ifdef GRANULAR
  master_mixer_r.gain(MASTER_MIX_CH_GRANULAR, VOL_MAX_FLOAT);
  master_mixer_l.gain(MASTER_MIX_CH_GRANULAR, VOL_MAX_FLOAT);
#endif

#ifdef BITCRUSH
  master_mixer_r.gain(MASTER_MIX_CH_BITCRUSH, 0.6);
  master_mixer_l.gain(MASTER_MIX_CH_BITCRUSH, 0.6);
#endif

  master_mixer_r.gain(MASTER_MIX_CH_SIDECHAIN, VOL_MAX_FLOAT);
  master_mixer_l.gain(MASTER_MIX_CH_SIDECHAIN, VOL_MAX_FLOAT);

  master_mixer_r.gain(MASTER_MIX_CH_REVERB, VOL_MAX_FLOAT);
  master_mixer_l.gain(MASTER_MIX_CH_REVERB, VOL_MAX_FLOAT);

  master_mixer_r.gain(MASTER_MIX_CH_DRUMS, VOL_MAX_FLOAT);
  master_mixer_l.gain(MASTER_MIX_CH_DRUMS, VOL_MAX_FLOAT);
  seq.drums_volume = VOL_MAX_FLOAT;

  master_mixer_r.gain(MASTER_MIX_CH_EPIANO, VOL_MAX_FLOAT);
  master_mixer_l.gain(MASTER_MIX_CH_EPIANO, VOL_MAX_FLOAT);

  master_mixer_r.gain(MASTER_MIX_CH_MICROSYNTH, VOL_MAX_FLOAT);
  master_mixer_l.gain(MASTER_MIX_CH_MICROSYNTH, VOL_MAX_FLOAT);

  master_mixer_r.gain(MASTER_MIX_CH_BRAIDS, VOL_MAX_FLOAT);
  master_mixer_l.gain(MASTER_MIX_CH_BRAIDS, VOL_MAX_FLOAT);

  master_mixer_r.gain(MASTER_MIX_CH_DELAY1, VOL_MAX_FLOAT);
  master_mixer_l.gain(MASTER_MIX_CH_DELAY1, VOL_MAX_FLOAT);
  master_mixer_r.gain(MASTER_MIX_CH_DELAY2, VOL_MAX_FLOAT);
  master_mixer_l.gain(MASTER_MIX_CH_DELAY2, VOL_MAX_FLOAT);

#if defined(TEENSY_AUDIO_BOARD) && defined(SGTL5000_AUDIO_THRU)
  audio_thru_mixer_r.gain(0, VOL_MAX_FLOAT); // MD signal sum
  audio_thru_mixer_l.gain(0, VOL_MAX_FLOAT); // MD signal sum
#ifdef TEENSY_AUDIO_BOARD
  audio_thru_mixer_r.gain(1, VOL_MAX_FLOAT); // I2S input
  audio_thru_mixer_l.gain(1, VOL_MAX_FLOAT); // I2S input
#else
  audio_thru_mixer_r.gain(1, 0.0);
  audio_thru_mixer_l.gain(1, 0.0);
#endif
  audio_thru_mixer_r.gain(2, 0.0);
  audio_thru_mixer_l.gain(2, 0.0);
  audio_thru_mixer_r.gain(3, 0.0);
  audio_thru_mixer_l.gain(3, 0.0);
#endif

  finalized_mixer_l.gain(0, VOL_MAX_FLOAT); // normal output, mute multiband
  finalized_mixer_r.gain(0, VOL_MAX_FLOAT);
  finalized_mixer_l.gain(1, 0);
  finalized_mixer_r.gain(1, 0);
  finalized_mixer_l.gain(2, 1.0); //dc offset 
  finalized_mixer_r.gain(2, 1.0); //dc offset 

  global_delay_in_mixer[0]->gain(9, 0.0);
  global_delay_in_mixer[1]->gain(9, 0.0);

#ifdef DEBUG
  LOG.println(F("<setup end>"));
#endif

  // ep_modchorus.set_bypass(true);
  if (seq.name[0] == 0)
    strcpy(seq.name, "INIT Perf");

#ifdef DEBUG
  LOG.println(F("Setup UI."));
#endif
  // Load initial Performance or the last used one
  initial_values(false);

  setup_ui();

  gamepad_buttons_neutral = joysticks[0].getButtons();
  gamepad_0_neutral = joysticks[0].getAxis(0);
  gamepad_1_neutral = joysticks[0].getAxis(1);

#ifdef MIDI_ACTIVITY_LIGHTS
  set_midi_led_pins();
#endif

#if (defined BUTTON_LEDS && defined MCP_23008) || (defined BUTTON_LEDS && defined MCP_23017)
  All_Button_LEDS(false);
#ifdef MIDI_ACTIVITY_LIGHTS
  digitalWrite(LED_MIDI_IN, HIGH);
  digitalWrite(LED_MIDI_OUT, HIGH);
#endif
#endif

#ifdef COMPILE_FOR_PSRAM
  display.setTextSize(2);
  display.setTextColor(COLOR_SYSTEXT, COLOR_BACKGROUND);
  display.setCursor(1 * CHAR_width, CHAR_height * 1);
  display.print(F("LOADING SAMPLES:"));
  display.setCursor(21 * CHAR_width, CHAR_height * 1);
  display.print(F("/"));
  display.setCursor(23 * CHAR_width, CHAR_height * 1);
  display.print(NUM_DRUMSET_CONFIG);

  display.setTextSize(1);
  for (int i = 0; i < NUM_STATIC_PITCHED_SAMPLES; i++) {  // load pitched samples
    char temp_name[36];
    strcpy(temp_name, "/DRUMS/");
    strcat(temp_name, drum_config[i].filename);
    strcat(temp_name, ".wav");
    sampleLoader.loadSampleToDrums(temp_name, drum_config[i], SD);
    printLoadedSample(i, temp_name);
  }

  // load drums
  for (int i = NUM_STATIC_PITCHED_SAMPLES + NUM_CUSTOM_SAMPLES; i < NUM_DRUMSET_CONFIG; i++) {
    char temp_name[36];
    strcpy(temp_name, "/DRUMS/");
    strcat(temp_name, drum_config[i].filename);
    strcat(temp_name, ".wav");
    sampleLoader.loadSampleToDrums(temp_name, drum_config[i], SD);
    printLoadedSample(i, temp_name);
  }
  display.setTextSize(2);
  AudioInterrupts();
  display.console = true;
  display.fillRect(0, CHAR_height, DISPLAY_WIDTH, CHAR_height * 4, COLOR_BACKGROUND);
  display.console = false;
#endif

#ifdef COMPILE_FOR_PSRAM
  load_sd_noisemaker_json();
#endif

  //SD CARD PRESET CONTENT NOT FOUND, PROVIDE POSSIBLE SOLUTIONS TO USER
  if (!SD.exists("/DEXED/0/0") || !SD.exists("/DEXED/0/99") || !SD.exists("/PERFORMANCE") || !SD.exists("/DRUMS"))
  {
    LCDML.OTHER_jumpToFunc(UI_func_sd_content_not_found);
  }
  else {
    if ((count_omni() != 0 || count_midi_channel_duplicates(false) != 0) && configuration.sys.skip_midi_channel_warning == false) // startup with midi channel setup page
      LCDML.OTHER_jumpToFunc(UI_func_midi_channels);
    else
      if (seq.clock == 1 && configuration.sys.skip_midi_channel_warning == false) //MIDI Slave
        LCDML.OTHER_jumpToFunc(UI_func_seq_settings);
      else
      {
        if (configuration.sys.boot_anim_skip == 0)
          boot_animation();
        // Menu Startup
        switch (configuration.sys.load_at_startup_page)
        {
        case 0:
          LCDML.OTHER_jumpToFunc(UI_func_voice_select);
          break;
        case 1:
          LCDML.OTHER_jumpToFunc(UI_func_song);
          break;
        case 2:
          LCDML.OTHER_jumpToFunc(UI_func_seq_pattern_editor);
          break;
        case 3:
          LCDML.OTHER_jumpToFunc(UI_func_microsynth);
          break;
        case 4:
          LCDML.OTHER_jumpToFunc(UI_func_seq_tracker);
          break;
        case 5:
          LCDML.OTHER_jumpToFunc(UI_func_MultiSamplePlay);
          break;
        case 6:
          LCDML.OTHER_jumpToFunc(UI_func_epiano);
          break;
        case 7:
          LCDML.OTHER_jumpToFunc(UI_func_braids);
          break;
        case 8:
          LCDML.OTHER_jumpToFunc(UI_func_mixer);
          break;
        case 9:
          LCDML.OTHER_jumpToFunc(UI_func_livesequencer);
          break;
        case 10:
          LCDML.FUNC_goBackToMenu();
          break;
        case 11:
          LCDML.OTHER_jumpToFunc(UI_func_chord_arranger);
        case 12:
          LCDML.OTHER_jumpToFunc(UI_func_noisemaker);
          break;
        case 50:
          LCDML.OTHER_jumpToFunc(UI_func_information);
          break;
        default:
          LCDML.OTHER_jumpToFunc(UI_func_voice_select); // fallback to voice select
        }
      }
  }

#ifdef MIDI_ACTIVITY_LIGHTS
  digitalWrite(LED_MIDI_IN, LOW);
  digitalWrite(LED_MIDI_OUT, LOW);
#endif
}

#ifdef COMPILE_FOR_PSRAM
FLASHMEM void load_custom_samples_to_psram()
{
  // load CUSTOM samples
  for (int i = NUM_STATIC_PITCHED_SAMPLES; i < (NUM_STATIC_PITCHED_SAMPLES + NUM_CUSTOM_SAMPLES); i++) {
    String fullpath = customSamples[i - NUM_STATIC_PITCHED_SAMPLES].filepath;
    fullpath += "/";
    fullpath += drum_config[i].filename;
    sampleLoader.loadSampleToDrums(fullpath, drum_config[i], SD);
    if (drum_config[i].len == 0 || drum_config[i].len > 10000000) {
      char temp_name[36];
      sprintf(temp_name, "CUSTOM%02d", i - NUM_STATIC_PITCHED_SAMPLES + 1);
      strcpy(drum_config[i].filename, temp_name);
      strcpy(drum_config[i].name, temp_name);
    }
  }
}

FLASHMEM void unload_all_custom_samples() {
  for (int i = NUM_STATIC_PITCHED_SAMPLES; i < (NUM_STATIC_PITCHED_SAMPLES + NUM_CUSTOM_SAMPLES); i++) {
    if (drum_config[i].drum_data != nullptr && drum_config[i].len > 0) {
      sampleLoader.unloadSample(drum_config[i].drum_data, drum_config[i].len * 2);
      drum_config[i].drum_data = nullptr;
      drum_config[i].len = 0;
    }
  }
}
#endif

FLASHMEM void print_midi_channel_activity(uint8_t x, uint8_t y, float audio_vol)
{
  uint8_t display_val = 0;
  if (audio_vol * 1024 > 253)
    display_val = 254;
  else
    display_val = uint8_t(audio_vol * 1024);

  setCursor_textGrid_small(x, y);
  display.setTextColor(ColorHSV(100, 250, display_val));
  display.print(">");
}

FLASHMEM void handle_touchscreen_midi_channel_page()
{
  if (seq.running)
  {
    display.setTextSize(1);
    print_midi_channel_activity(39, 5, microdexed_peak_0.read());
    print_midi_channel_activity(39, 6, microdexed_peak_1.read());
#if (NUM_DEXED>2)
    print_midi_channel_activity(39, 7, microdexed_peak_2.read());
    print_midi_channel_activity(39, 8, microdexed_peak_3.read());
#endif
    print_midi_channel_activity(39, 9, (ep_peak_l.read() + ep_peak_r.read()) / 2);
    if (microsynth_peak_osc_0.available())
      print_midi_channel_activity(39, 11, microsynth_peak_osc_0.read());
    else
      print_midi_channel_activity(39, 11, 0);
    if (microsynth_peak_osc_1.available())
      print_midi_channel_activity(39, 12, microsynth_peak_osc_1.read());
    else
      print_midi_channel_activity(39, 12, 0);

    if (braids_peak_l.available() && braids_peak_r.available())
      print_midi_channel_activity(39, 14, (braids_peak_l.read() + braids_peak_r.read()) / 2);
    else
      print_midi_channel_activity(39, 14, 0);

    print_midi_channel_activity(39, 16, ts.msp_peak[0]);
    print_midi_channel_activity(39, 17, ts.msp_peak[1]);
    ts.msp_peak[0] = ts.msp_peak[0] / 1.05;
    ts.msp_peak[1] = ts.msp_peak[1] / 1.05;

    if (drum_mixer_peak_r.available() && drum_mixer_peak_l.available())
      print_midi_channel_activity(39, 18, (drum_mixer_peak_l.read() + drum_mixer_peak_r.read()) / 2);
    else
      print_midi_channel_activity(39, 18, 0);

    //// sample slices activity is missing here phtodo

    display.setTextColor(COLOR_SYSTEXT, COLOR_BACKGROUND);
  }
}

FLASHMEM void sub_step_recording(bool touchinput, uint8_t touchparam)
{
  if (seq.running == false && seq.step_recording)
  {
    if (touchinput && touchparam == 1) //rest step
    {
      seq.note_in = 0;
      seq.note_in_velocity = 0;
    }
    else if (touchinput && touchparam == 2 && seq.content_type[seq.active_pattern] != 0) //latch step
    {
      seq.note_in = 130;
      seq.note_in_velocity = 0;
    }
    if ((seq.recording == false && seq.note_in > 0 && seq.note_in_velocity > 0 && touchinput == false) ||
      (touchinput == true && seq.cycle_touch_element == 1 && touchparam == 1) ||
      (touchinput == true && seq.cycle_touch_element == 1 && touchparam == 2 && seq.content_type[seq.active_pattern] != 0))

    {
      uint8_t cur_step = 0;
      if (LCDML.FUNC_getID() == LCDML.OTHER_getIDFromFunction(UI_func_seq_pattern_editor))
        cur_step = seq.menu - 3;
      else if (LCDML.FUNC_getID() == LCDML.OTHER_getIDFromFunction(UI_func_seq_vel_editor))
        cur_step = seq.menu - 1;

      if (cur_step < 16)
      {
        seq.note_data[seq.active_pattern][cur_step] = seq.note_in;

        if (touchparam == 0)
        {
          if (seq.content_type[seq.active_pattern] == 0 && get_sample_note(activeSample) > 209 && ts.virtual_keyboard_instrument != VK_DRUMS) // pitched sample
          {
            seq.vel[seq.active_pattern][cur_step] = get_sample_note(activeSample);
          }
          else
            seq.vel[seq.active_pattern][cur_step] = seq.note_in_velocity;
        }

        else if (touchinput && touchparam == 1)
        {
          seq.vel[seq.active_pattern][cur_step] = 0;
        }
        else if (touchinput && touchparam == 2)
        {
          seq.vel[seq.active_pattern][cur_step] = 0;
        }

        setCursor_textGrid(cur_step, 1);
        display.setTextSize(2);

        if (seq.auto_advance_step == 0)
          display.setTextColor(COLOR_SYSTEXT, RED);
        else
        {
          if (seq.vel[seq.active_pattern][cur_step] > 209)
            display.setTextColor(COLOR_PITCHSMP, COLOR_BACKGROUND);
          else
            set_pattern_content_type_color(seq.active_pattern);
        }
        display.print(seq_find_shortname(cur_step)[0]);
        seq_printAllVelocitySteps_single_step(cur_step, GREY1);
        if (seq.cycle_touch_element != 1)
          print_track_steps_detailed_only_current_playing_note(0, CHAR_height * 4 + 3, cur_step);

        display.setTextSize(2);
        display.setTextColor(COLOR_SYSTEXT, RED);
        if (seq.auto_advance_step > 0)
        {
          if (cur_step < 15)
          {
            seq.menu = seq.menu + 1;
            setCursor_textGrid(cur_step + 1, 1);
            display.print(seq_find_shortname(cur_step + 1)[0]);
            if (seq.cycle_touch_element != 1)
              print_track_steps_detailed_only_current_playing_note(0, CHAR_height * 4 + 3, cur_step + 1);
          }
          else
          {
            if (seq.auto_advance_step == 1) // continue auto advance after last step on first step
            {
              seq.menu = seq.menu - 15;
              setCursor_textGrid(cur_step - 15, 1);
              display.print(seq_find_shortname(cur_step - 15)[0]);
              if (seq.cycle_touch_element != 1)
                print_track_steps_detailed_only_current_playing_note(0, CHAR_height * 4 + 3, cur_step - 15);
            }
            else // stop at last step
            {
              // disable step record
              seq.step_recording = false;
              // handleStop
              draw_button_on_grid(36, 1, "STEP", "RECORD", 1); // print step recorder icon
            }
          }
        }
      }
      seq.note_in = 0;
      seq.note_in_velocity = 0;
    }
  }
}

float pseudo_log_curve(float value)
{
  // return (mapfloat(_pseudo_log * arm_sin_f32(value), 0.0, _pseudo_log * arm_sin_f32(1.0), 0.0, 1.0));
  // return (1 - sqrt(1 - value * value));
  // return (pow(2, value) - 1);
  return (pow(value, 2.2));
}

uint8_t sc_seq_step_displayed;

FLASHMEM void set_sidechain_levels()
{

  for (uint8_t i = 0; i < NUM_DEXED; i++)
  {
    //dexed 
    master_mixer_r.gain(MASTER_MIX_CH_DEXED1 + i, VOL_MAX_FLOAT - mapfloat(configuration.dexed[i].sidechain_send, REVERB_SEND_MIN, REVERB_SEND_MAX, 0.0, VOL_MAX_FLOAT));
    master_mixer_l.gain(MASTER_MIX_CH_DEXED1 + i, VOL_MAX_FLOAT - mapfloat(configuration.dexed[i].sidechain_send, REVERB_SEND_MIN, REVERB_SEND_MAX, 0.0, VOL_MAX_FLOAT));
    sidechain_mixer_r.gain(MASTER_MIX_CH_DEXED1 + i, mapfloat(configuration.dexed[i].sidechain_send, REVERB_SEND_MIN, REVERB_SEND_MAX, 0.0, VOL_MAX_FLOAT));
    sidechain_mixer_l.gain(MASTER_MIX_CH_DEXED1 + i, mapfloat(configuration.dexed[i].sidechain_send, REVERB_SEND_MIN, REVERB_SEND_MAX, 0.0, VOL_MAX_FLOAT));
  }

  //microsynth
  master_mixer_r.gain(MASTER_MIX_CH_MICROSYNTH, VOL_MAX_FLOAT - mapfloat(microsynth[0].sidechain_send, REVERB_SEND_MIN, REVERB_SEND_MAX, 0.0, VOL_MAX_FLOAT));
  master_mixer_l.gain(MASTER_MIX_CH_MICROSYNTH, VOL_MAX_FLOAT - mapfloat(microsynth[0].sidechain_send, REVERB_SEND_MIN, REVERB_SEND_MAX, 0.0, VOL_MAX_FLOAT));
  sidechain_mixer_r.gain(MASTER_MIX_CH_MICROSYNTH, mapfloat(microsynth[0].sidechain_send, REVERB_SEND_MIN, REVERB_SEND_MAX, 0.0, VOL_MAX_FLOAT));
  sidechain_mixer_l.gain(MASTER_MIX_CH_MICROSYNTH, mapfloat(microsynth[0].sidechain_send, REVERB_SEND_MIN, REVERB_SEND_MAX, 0.0, VOL_MAX_FLOAT));

  //epiano 
  master_mixer_r.gain(MASTER_MIX_CH_EPIANO, VOL_MAX_FLOAT - mapfloat(configuration.epiano.sidechain_send, REVERB_SEND_MIN, REVERB_SEND_MAX, 0.0, VOL_MAX_FLOAT));
  master_mixer_l.gain(MASTER_MIX_CH_EPIANO, VOL_MAX_FLOAT - mapfloat(configuration.epiano.sidechain_send, REVERB_SEND_MIN, REVERB_SEND_MAX, 0.0, VOL_MAX_FLOAT));
  sidechain_mixer_r.gain(MASTER_MIX_CH_EPIANO, mapfloat(configuration.epiano.sidechain_send, REVERB_SEND_MIN, REVERB_SEND_MAX, 0.0, VOL_MAX_FLOAT));
  sidechain_mixer_l.gain(MASTER_MIX_CH_EPIANO, mapfloat(configuration.epiano.sidechain_send, REVERB_SEND_MIN, REVERB_SEND_MAX, 0.0, VOL_MAX_FLOAT));

  //braids 
  master_mixer_r.gain(MASTER_MIX_CH_BRAIDS, VOL_MAX_FLOAT - mapfloat(braids_osc.sidechain_send, REVERB_SEND_MIN, REVERB_SEND_MAX, 0.0, VOL_MAX_FLOAT));
  master_mixer_l.gain(MASTER_MIX_CH_BRAIDS, VOL_MAX_FLOAT - mapfloat(braids_osc.sidechain_send, REVERB_SEND_MIN, REVERB_SEND_MAX, 0.0, VOL_MAX_FLOAT));
  sidechain_mixer_r.gain(MASTER_MIX_CH_BRAIDS, mapfloat(braids_osc.sidechain_send, REVERB_SEND_MIN, REVERB_SEND_MAX, 0.0, VOL_MAX_FLOAT));
  sidechain_mixer_l.gain(MASTER_MIX_CH_BRAIDS, mapfloat(braids_osc.sidechain_send, REVERB_SEND_MIN, REVERB_SEND_MAX, 0.0, VOL_MAX_FLOAT));

  //delay1 
  master_mixer_r.gain(MASTER_MIX_CH_DELAY1, VOL_MAX_FLOAT - mapfloat(configuration.fx.delay1_sidechain_send, REVERB_SEND_MIN, REVERB_SEND_MAX, 0.0, VOL_MAX_FLOAT));
  master_mixer_l.gain(MASTER_MIX_CH_DELAY1, VOL_MAX_FLOAT - mapfloat(configuration.fx.delay1_sidechain_send, REVERB_SEND_MIN, REVERB_SEND_MAX, 0.0, VOL_MAX_FLOAT));
  sidechain_mixer_r.gain(MASTER_MIX_CH_DELAY1, mapfloat(configuration.fx.delay1_sidechain_send, REVERB_SEND_MIN, REVERB_SEND_MAX, 0.0, VOL_MAX_FLOAT));
  sidechain_mixer_l.gain(MASTER_MIX_CH_DELAY1, mapfloat(configuration.fx.delay1_sidechain_send, REVERB_SEND_MIN, REVERB_SEND_MAX, 0.0, VOL_MAX_FLOAT));

  //delay2 
  master_mixer_r.gain(MASTER_MIX_CH_DELAY2, VOL_MAX_FLOAT - mapfloat(configuration.fx.delay2_sidechain_send, REVERB_SEND_MIN, REVERB_SEND_MAX, 0.0, VOL_MAX_FLOAT));
  master_mixer_l.gain(MASTER_MIX_CH_DELAY2, VOL_MAX_FLOAT - mapfloat(configuration.fx.delay2_sidechain_send, REVERB_SEND_MIN, REVERB_SEND_MAX, 0.0, VOL_MAX_FLOAT));
  sidechain_mixer_r.gain(MASTER_MIX_CH_DELAY2, mapfloat(configuration.fx.delay2_sidechain_send, REVERB_SEND_MIN, REVERB_SEND_MAX, 0.0, VOL_MAX_FLOAT));
  sidechain_mixer_l.gain(MASTER_MIX_CH_DELAY2, mapfloat(configuration.fx.delay2_sidechain_send, REVERB_SEND_MIN, REVERB_SEND_MAX, 0.0, VOL_MAX_FLOAT));

  //reverb
  master_mixer_r.gain(MASTER_MIX_CH_REVERB, VOL_MAX_FLOAT - mapfloat(configuration.fx.reverb_sidechain_send, REVERB_SEND_MIN, REVERB_SEND_MAX, 0.0, VOL_MAX_FLOAT));
  master_mixer_l.gain(MASTER_MIX_CH_REVERB, VOL_MAX_FLOAT - mapfloat(configuration.fx.reverb_sidechain_send, REVERB_SEND_MIN, REVERB_SEND_MAX, 0.0, VOL_MAX_FLOAT));

  sidechain_mixer_r.gain(MASTER_MIX_CH_REVERB, mapfloat(configuration.fx.reverb_sidechain_send, REVERB_SEND_MIN, REVERB_SEND_MAX, 0.0, VOL_MAX_FLOAT));
  sidechain_mixer_l.gain(MASTER_MIX_CH_REVERB, mapfloat(configuration.fx.reverb_sidechain_send, REVERB_SEND_MIN, REVERB_SEND_MAX, 0.0, VOL_MAX_FLOAT));

}

FLASHMEM void update_sidechain()
{
  if (LCDML.FUNC_getID() == LCDML.OTHER_getIDFromFunction(UI_func_sidechain))
  {
    display.setTextSize(1);
    display.setTextColor(RED, COLOR_BACKGROUND);
    setCursor_textGrid_small(28, 4);
    if (sidechain_trigger)
    {
      display.print(F("T"));
      sc_seq_step_displayed = seq.step;
    }
    else if (sc_seq_step_displayed != seq.step)
    {
      display.print(F(" "));
      sc_seq_step_displayed = seq.step;
    }
    display.setTextColor(COLOR_SYSTEXT, COLOR_BACKGROUND);
  }

  if (sidechain_trigger)
  {

    AudioNoInterrupts();
    fade_sidechain_r.fadeOut(2);
    fade_sidechain_l.fadeOut(2);
    AudioInterrupts();
    delay(3);

    AudioNoInterrupts();
    fade_sidechain_r.fadeIn(sidechain_speed);
    fade_sidechain_l.fadeIn(sidechain_speed);
    AudioInterrupts();

    sidechain_trigger = false;
  }
}

// Gaussian Wave Breathing
#if defined GLOW
float glow_smoothness_pts = 25;//larger=slower change in brightness
float glow_gamma = 0.25; // affects the width of peak (more or less darkness)
float glow_beta = 0.5; // shifts the gaussian to be symmetric
float glow_bright = 0;
int glow_count = 0;
uint16_t glow_x;
uint8_t glow_y;
uint8_t glow_len;
uint8_t glow_track;
int glow_value;
int glow_input_value;
int glow_menu_item;
int glow_limit_min;
int glow_limit_max;
const char* glow_str;
uint8_t  glow_textsize;
const char* glow_zero_name;
uint8_t glow_type;

FLASHMEM static bool set_glow_params(uint8_t x, uint8_t y, uint8_t type, int menuitem, bool force = false)
{
  bool result = menuitem == generic_temp_select_menu || force;
  if (result)
  {
    glow_x = x;
    glow_y = y;
    glow_menu_item = menuitem;
    glow_type = type;
    glow_count = 0;
  }
  return result;
}

//song page only
FLASHMEM void set_glow_print_number(uint16_t x, uint8_t y, int input, uint8_t length, uint8_t track, uint8_t menuitem, uint8_t textsize, bool state)
{
  set_glow_params(x, y, state ? 5 : 6, menuitem, true);
  glow_input_value = input;
  glow_len = length;
  glow_textsize = textsize;
  glow_track = track;
}

FLASHMEM void set_glow_print_formatted_number_signed(uint16_t x, uint8_t y, int input, uint8_t length, uint8_t menuitem, uint8_t textsize)
{
  if (set_glow_params(x, y, 4, menuitem))
  {
    glow_input_value = input;
    glow_len = length;
    glow_textsize = textsize;
  }
}
FLASHMEM void set_glow_show_text_no_grid(uint16_t x, uint8_t y, uint8_t field_size, const char* str, uint8_t menuitem, uint8_t textsize)
{
  if (set_glow_params(x, y, 3, menuitem))
  {
    glow_str = str;
    glow_len = field_size;
    glow_textsize = textsize;
  }
}

FLASHMEM void set_glow_print_number(uint16_t x, uint8_t y, int input, uint8_t length, uint8_t menuitem, uint8_t textsize)
{
  if (set_glow_params(x, y, 2, menuitem))
  {
    glow_input_value = input;
    glow_len = length;
    glow_textsize = textsize;
  }
}

FLASHMEM void set_glow_panbar(uint8_t x, uint8_t y, int input, int menuitem)
{
  if (set_glow_params(x, y, 1, menuitem))
  {
    glow_input_value = input;
  }
}

FLASHMEM void set_glow_bargraph(uint8_t x, uint8_t y, int input, int menuitem, int min, int max, const char* zero)
{
  if (set_glow_params(x, y, 0, menuitem))
  {
    glow_input_value = input;
    glow_limit_min = min;
    glow_limit_max = max;
    glow_zero_name = zero;
  }
}

#define GLOW_OFF -999.0f
FLASHMEM void draw_glow()
{
  display.setTextSize(1);
  if (glow_bright > GLOW_OFF)
    display.setTextColor(COLOR_BACKGROUND, ColorHSV(0, 0, int(glow_bright)));
  else
    display.setTextColor(COLOR_SYSTEXT, COLOR_BACKGROUND);

  if (glow_type == 0)
  {
    setCursor_textGrid_small(glow_x, glow_y);

    if (glow_limit_min == 0 && glow_limit_max == 1)
      display.print(glow_input_value ? F("ON ") : F("OFF"));
    else if (glow_zero_name != NULL && glow_input_value == 0)
      display.print(glow_zero_name);
    else if (glow_zero_name != NULL && glow_input_value == 17)
      display.print(glow_zero_name);
    else if (glow_limit_min < 0)
      print_formatted_number_signed(glow_input_value, 2);
    else if (glow_limit_max < 100) {
      setCursor_textGrid_small(glow_x + 1, glow_y);
      print_formatted_number(glow_input_value, 2);
    }
    else if (glow_limit_max < 1000) {
      print_formatted_number(glow_input_value, 3);
    }
    else {
      print_formatted_number(glow_input_value, 4);
    }
  }
  else if (glow_type == 1)  //panbar
  {
    setCursor_textGrid_small(glow_x, glow_y);
    _print_panbar_value(glow_input_value);
  }
  else if (glow_type == 2)  //integer
  {
    display.setTextSize(glow_textsize);
    display.setCursor(glow_x, glow_y);
    print_formatted_number(glow_input_value, glow_len);
  }

  else if (glow_type == 3)  //text
  {
    display.setTextSize(glow_textsize);
    show_no_grid(glow_y, glow_x, glow_len, glow_str);
  }

  else if (glow_type == 4)  //signed integer
  {
    display.setTextSize(glow_textsize);
    display.setCursor(glow_x, glow_y);
    print_formatted_number_signed(glow_input_value, glow_len);
  }
  else if (glow_type == 5)  //integer song page
  {
    display.setTextSize(glow_textsize);
    display.setCursor(glow_x, glow_y);
    print_formatted_number(glow_input_value, glow_len);
  }

  else if (glow_type == 6)  //integer song page, empty "--"
  {
    display.setTextSize(glow_textsize);
    display.setCursor(glow_x, glow_y);
    display.print(F("--"));
  }

  display.setTextSize(1);
}

FLASHMEM void glow(void)
{
  if (!remote_active)
  {
    if ((seq.edit_state == 0 && glow_menu_item == generic_temp_select_menu && LCDML.FUNC_getID() < 63 && legacy_touch_button_back_page() == false)
      || (seq.edit_state == 0 && LCDML.FUNC_getID() == LCDML.OTHER_getIDFromFunction(UI_func_song) && glow_track == seq.selected_track &&
        seq.tracktype_or_instrument_assign == 0 && seq.loop_edit_step == 0))
    {
      if (glow_count >= 0)
      {
        if (glow_count < glow_smoothness_pts)
          glow_count++;
        else
          glow_count = 0;

        glow_bright = 255.0 * (exp(-(pow(((glow_count / glow_smoothness_pts) - glow_beta) / glow_gamma, 2.0)) / 2.0));
      }
      else
        glow_bright = GLOW_OFF;
      draw_glow();
    }
  }
}

FLASHMEM void remove_glow(void)
{
  glow_count = -1;
  glow();
}
#endif

FLASHMEM void print_gate_state(uint8_t g)
{
  if (Gate[g]->get_state() == 0)
    display.print("BYPASS ");
  else if (Gate[g]->get_state() == 1)
    display.print("ATTACK ");
  else if (Gate[g]->get_state() == 2)
    display.print("HOLD   ");
  else if (Gate[g]->get_state() == 3)
    display.print("RELEASE");
}

bool display_buffer_envelopes[NUM_DRUMS];
bool display_buffer_samples[NUM_DRUMS];

#if defined SMFPLAYER
bool smf_playing = false;
#endif

#ifdef MIDI_ACTIVITY_LIGHTS
uint8_t LED_MIDI_IN_counter = 0;
uint8_t LED_MIDI_OUT_counter = 0;
#endif

#if defined APC
extern void apc_drawString_Background();
bool apc_scroll_message = true;
bool apc_welcome_message = true;
int apc_scroll_counter = 0;
char apc_scrolltext[16];
#endif

#if defined (RGB_ENCODERS) && defined (MCP_23008) || defined (RGB_ENCODERS) && defined (MCP_23017)
uint8_t RGB_state = 199;
FLASHMEM void setRGBencoderColor()
{
  if (RGB_state != seq.edit_state) {

    //     if (seq.edit_state == 0)
    //     {
    //       setled(RGB_LED_L_RED, HIGH);
    //       setled(RGB_LED_L_GREEN, HIGH);
    //       setled(RGB_LED_L_BLUE, LOW);
    //       setled(RGB_LED_R_RED, HIGH);
    //       setled(RGB_LED_R_GREEN, HIGH);
    //       setled(RGB_LED_R_BLUE, LOW);
    // // #if (defined BUTTON_LEDS && defined MCP_23008) || (defined BUTTON_LEDS && defined MCP_23017)
    // //       setled(LED_BUT_A, LOW);
    // // #endif
    //     }
    //     else
    //     {
    //       setled(RGB_LED_L_RED, HIGH);
    //       setled(RGB_LED_L_GREEN, HIGH);
    //       setled(RGB_LED_L_BLUE, LOW);

    //       setled(RGB_LED_R_RED, LOW);
    //       setled(RGB_LED_R_GREEN, HIGH);
    //       setled(RGB_LED_R_BLUE, HIGH);
    // // #if (defined BUTTON_LEDS && defined MCP_23008) || (defined BUTTON_LEDS && defined MCP_23017)
    // //       setled(LED_BUT_A, HIGH);
    // //       #endif
    //     }

    set_custom_enc_colors();
    RGB_state = seq.edit_state;
  }
}
#endif

#if defined MIDI_ACTIVITY_LIGHTS
FLASHMEM void midi_activity_leds()
{
  if (LED_MIDI_OUT_counter != 0)
  {
    if (LED_MIDI_OUT_counter == 1)
    {
      digitalWrite(LED_MIDI_OUT, HIGH);
      LED_MIDI_OUT_counter++;
    }
    else
    {
      LED_MIDI_OUT_counter++;
      if (LED_MIDI_OUT_counter > 1)
      {
        digitalWrite(LED_MIDI_OUT, LOW);
        LED_MIDI_OUT_counter = 0;
      }
    }
  }
  if (LED_MIDI_IN_counter != 0)
  {
    if (LED_MIDI_IN_counter == 1)
    {
      digitalWrite(LED_MIDI_IN, HIGH);
      LED_MIDI_IN_counter++;
    }
    else
    {
      LED_MIDI_IN_counter++;
      if (LED_MIDI_IN_counter > 1)
      {
        digitalWrite(LED_MIDI_IN, LOW);
        LED_MIDI_IN_counter = 0;
      }
    }
  }
}
#endif

#ifdef MUSIKANDMORE
FLASHMEM void set_trs_pedal()
{
  MicroDexed[selected_instance_id]->setSustain(trs_pedal);
  if (!MicroDexed[selected_instance_id]->getSustain())
  {
    for (uint8_t note = 0; note < MicroDexed[selected_instance_id]->getMaxNotes(); note++)
    {
      if (MicroDexed[selected_instance_id]->voices[note].sustained && !MicroDexed[selected_instance_id]->voices[note].keydown)
      {
        MicroDexed[selected_instance_id]->voices[note].dx7_note->keyup();
        MicroDexed[selected_instance_id]->voices[note].sustained = false;
      }
    }
  }
}
#endif

uint8_t dac_state = 0;
uint8_t dac_midi_note;
uint8_t dac_midi_vel;
uint16_t dac_cv_1;
uint16_t dac_cv_3;

extern void print_note_name_and_octave(uint8_t inNumber);
extern ChordInfo currentChord;

extern uint8_t chord_input[4];
extern void updateCurrentChord(const uint8_t midiNotes[], uint8_t size);
extern  void show(uint8_t pos_y, uint8_t pos_x, uint8_t field_size, const char* str);
extern bool getChordName(const uint8_t midiNotes[], uint8_t size, char* output);
extern const char* midiToNote(uint8_t midiNote);

FLASHMEM uint8_t count_chord_notes() {
  uint8_t  count = 0;
  for (uint8_t i = 0; i < 4; i++) {
    if (chord_input[i] != 0) {
      count++;
    }
  }
  return count;
}

SuggestedChord suggestions[6];

FLASHMEM void resetCurrentChord() {
  memset(&currentChord, 0, sizeof(ChordInfo));
}

extern void resetChordBuffer();
extern uint8_t chord_note_count;
extern uint8_t since_last_note;
extern void suggestNextChords(ChordInfo current, SuggestedChord suggestions[6]);
extern bool chord_autostart;

void preview_chord_suggestion(uint8_t input)
{
  for (int i = 0; i < 4; i++)
  {
    if (suggestions[input].notes[i] != 0)
    {
      handleNoteOnInput(1, suggestions[input].notes[i], 60, 0);
    }
  }

  delay(50);

  for (int i = 0; i < 4; i++)
  {
    if (suggestions[input].notes[i] != 0)
    {
      handleNoteOff(1, suggestions[input].notes[i], 0, 0);
    }
  }
}

FLASHMEM void printSuggestions() {
  if (LCDML.FUNC_getID() == LCDML.OTHER_getIDFromFunction(UI_func_chord_arranger))
  {
    if (!currentChord.active) return;

    suggestNextChords(currentChord, suggestions);

    //char output[6];
    //char output2[8];
    display.setTextSize(1);
    display.setTextColor(COLOR_SYSTEXT, COLOR_BACKGROUND);
    for (int i = 0; i < 6; i++) {
      //setCursor_textGrid_small(5, i+16);
       // snprintf_P(output, sizeof(output), PSTR("Suggestion %d: %s - Notes: "), i+1, suggestions[i].name);
        // display.print(output );
      snprintf_P(suggestions[i].notenames, sizeof(suggestions[i].notenames), PSTR("%s%s%s%s"), midiToNote(suggestions[i].notes[0]), midiToNote(suggestions[i].notes[1]), midiToNote(suggestions[i].notes[2]), midiToNote(suggestions[i].notes[03]));
      // display.print(output);
      TouchButton::drawButton(GRID.X[i], GRID.Y[4], suggestions[i].name, suggestions[i].notenames, TouchButton::BUTTON_NORMAL);

    }
  }
}

#ifdef COMPILE_FOR_PSRAM
extern void  refreshNoisemakerParameterEditors();
extern bool noisemaker_update_params_flag;
#endif

FLASHMEM void show_chord()
{
  if (LCDML.FUNC_getID() == LCDML.OTHER_getIDFromFunction(UI_func_chord_arranger))
  {
    display.setTextSize(1);
    display.setTextColor(COLOR_SYSTEXT, COLOR_BACKGROUND);

    setCursor_textGrid_small(20, 1);
    display.print(chord_note_count);
    for (uint8_t d = 0; d < 4; d++)
    {
      setCursor_textGrid_small(24 + d * 4, 1);
      display.print(midiToNote(chord_input[d]));
      display.print(chord_input[d] / 12);
      display.print(" ");
    }

    if (seq.arr_split_note == 0 || seq.note_in > seq.arr_split_note)
    {
      display.console = true;
      display.fillRect(CHAR_width_small + seq.note_in * 3.55, 110, 4, 4, RED);
    }
    else if (chord_input[3] != 0)
    {
      display.console = true;
      display.fillRect(CHAR_width_small + chord_input[2] * 3.55, 110, 4, 4, RED);
    }

    char result1[30];
    display.setTextSize(0);

    // if (!seq.running)
    //       updateCurrentChord(chord_input, 3);

    getChordName(chord_input, chord_note_count, result1);

    //       if (!seq.running && chord_arranger_autostart==false)
    //       {
    //         chord_arranger_autostart=true;
    //  handleStart();
    //       }

    display.setTextSize(1);
    show_no_grid(CHAR_height * 2, CHAR_width_small, 26, result1);
  }

}

#ifdef GRANULAR
FLASHMEM void display_granular_status()
{
  uint8_t totalVoices = MAX_POLY_VOICES;

  // Static variables to track previous state
  static bool lastVoiceState[MAX_POLY_VOICES] = { false };
  static float lastGrainPositions[MAX_POLY_VOICES * MAX_GRAINS_PER_VOICE] = { 0 };
  static uint8_t lastGrainCount = 0;
  static bool firstRun = true;

  // Voice indicators area (top right corner)
  static const uint16_t voiceY = 2;
  static const uint8_t Box = 6;
  static const uint16_t startX = 320 - (totalVoices * (Box + 2));

  // Grain indicators area
  static const uint16_t grainAreaY = 23;
  static const uint16_t grainAreaHeight = 7;
  static const uint16_t grainAreaX = 0;
  static const uint16_t grainAreaWidth = 320;

  bool voiceStateChanged = false;
  bool grainPositionsChanged = false;

  // Get current sample info for position mapping
  const drum_config_t& slot = drum_config[granular_params.sample_note];
  uint32_t sampleFrames = slot.len / (sizeof(int16_t) * slot.numChannels);
  if (sampleFrames == 0) sampleFrames = 1;

  // Check if voice states changed
  for (uint8_t i = 0; i < totalVoices; i++) {
    bool currentState = granularPoly.voices[i]->isPlaying();
    if (firstRun || currentState != lastVoiceState[i]) {
      voiceStateChanged = true;
      lastVoiceState[i] = currentState;
    }
  }

  // Collect current grain positions
  uint8_t currentGrainCount = 0;
  float currentGrainPositions[MAX_POLY_VOICES * MAX_GRAINS_PER_VOICE];

  for (uint8_t v = 0; v < MAX_POLY_VOICES; v++) {
    if (granularPoly.voices[v]->isPlaying()) {
      for (uint8_t g = 0; g < MAX_GRAINS_PER_VOICE; g++) {
        if (granularPoly.voices[v]->grains[g].active) {
          float grainPos = granularPoly.voices[v]->grains[g].position;
          if (grainPos >= 0 && grainPos < sampleFrames &&
            currentGrainCount < MAX_POLY_VOICES * MAX_GRAINS_PER_VOICE) {
            currentGrainPositions[currentGrainCount++] = grainPos;
          }
        }
      }
    }
  }

  // Check if grain positions changed significantly
  if (currentGrainCount != lastGrainCount) {
    grainPositionsChanged = true;
  }
  else {
    for (uint8_t i = 0; i < currentGrainCount; i++) {
      // Only redraw if position changed by more than 2 pixels on screen
      uint16_t oldX = grainAreaX + (uint16_t)((lastGrainPositions[i] / sampleFrames) * grainAreaWidth);
      uint16_t newX = grainAreaX + (uint16_t)((currentGrainPositions[i] / sampleFrames) * grainAreaWidth);
      if (abs((int16_t)newX - (int16_t)oldX) > 2) {
        grainPositionsChanged = true;
        break;
      }
    }
  }

  // Only update if something changed or it's the first run
  if (voiceStateChanged || grainPositionsChanged || firstRun) {
    firstRun = false;

    // Update voice indicators only if they changed
    if (voiceStateChanged || firstRun) {
      for (uint8_t i = 0; i < totalVoices; i++) {
        uint16_t voiceX = startX + i * (Box + 2);
        if (granularPoly.voices[i]->isPlaying()) {
          // Active voice - filled rectangle
          display.fillRect(voiceX, voiceY, Box, Box, GREEN);
        }
        else {
          // Inactive voice - outline only
          display.fillRect(voiceX, voiceY, Box, Box, GREY2);
        }
      }
    }

    // Update grain indicators only if they changed
    if (grainPositionsChanged || firstRun) {
      // Instead of clearing entire area, only clear what's necessary

      // Method 1: Clear only the areas around changed grains (most efficient)
      if (!firstRun) {
        // Erase only the old grain lines that are no longer needed or have moved
        for (uint8_t i = 0; i < lastGrainCount; i++) {
          if (lastGrainPositions[i] >= 0) {
            uint16_t oldX = grainAreaX + (uint16_t)((lastGrainPositions[i] / sampleFrames) * grainAreaWidth);
            if (oldX >= grainAreaX && oldX < grainAreaX + grainAreaWidth) {
              // Erase the old grain line by drawing a black line
              display.drawLine(oldX, grainAreaY + 1, oldX, grainAreaY + grainAreaHeight - 2, COLOR_BACKGROUND);
            }
          }
        }
      }
      else {
        // First run - clear entire area
        display.fillRect(grainAreaX, grainAreaY, grainAreaWidth, grainAreaHeight, COLOR_BACKGROUND);
      }

      // Draw new grain positions
      for (uint8_t i = 0; i < currentGrainCount; i++) {
        uint16_t grainX = grainAreaX + (uint16_t)((currentGrainPositions[i] / sampleFrames) * grainAreaWidth);
        if (grainX >= grainAreaX && grainX < grainAreaX + grainAreaWidth) {
          // Draw small vertical line
          uint8_t lineHeight = grainAreaHeight - 2;
          display.drawLine(grainX, grainAreaY + 1, grainX, grainAreaY + lineHeight, COLOR_SYSTEXT);
          //  display.drawPixel(grainX, grainAreaY + 1, ;
        }
      }
    }

    // Update tracking
    lastGrainCount = currentGrainCount;
    for (uint8_t i = 0; i < currentGrainCount; i++) {
      lastGrainPositions[i] = currentGrainPositions[i];
    }
    for (uint8_t i = currentGrainCount; i < MAX_POLY_VOICES * MAX_GRAINS_PER_VOICE; i++) {
      lastGrainPositions[i] = -1;
    }
  }
}
#endif

void loop()
{
  // Chords Detection
// Handle chord timeout
  if (chord_note_count > 0 && since_last_note > CHORD_CAPTURE_WINDOW) {
    if (chord_note_count >= 3) {
      // Finalize the chord
      updateCurrentChord(chord_input, min(chord_note_count, MAX_CHORD_NOTES));
      show_chord();
    }
    resetChordBuffer();
  }

  // MM Test Stuff

#ifdef MUSIKANDMORE
  if (configuration.sys.sus_pedal)
  {
    trs_pedal = digitalRead(TRS_PEDAL_IN);
    if (trs_pedal != trs_pedal_previous)
    {
      set_trs_pedal();
      setled(LED_DOWN, trs_pedal);

      trs_pedal_previous = trs_pedal;
    }
  }

#ifdef MUSIKANDMORE
  if (configuration.sys.ext_clock)
  {
    seq.clock = 1;
    cv_clock = digitalRead(CV_CLOCK_IN);

    if (cv_clock != cv_clock_previous)
    {
      sequencer();
      sequencer();
      sequencer();
      sequencer();

      if (midi_bpm_counter % 4 == 0)
      {
        midi_bpm = (round(60000.0f / float(midi_bpm_timer * 2)));
        if ((_midi_bpm > midi_bpm + 2 && midi_bpm > 30 && midi_bpm < 180) ||
          (_midi_bpm < midi_bpm - 2 && midi_bpm >30 && midi_bpm < 180))

        {
          seq.bpm = midi_bpm;
          _midi_bpm = midi_bpm;
          update_seq_speed();
        }

        midi_bpm_timer = 0;
        midi_bpm_counter = 0;
      }
      midi_bpm_counter++;
      setled(LED_UP, cv_clock);
      cv_clock_previous = cv_clock;
    }
  }
#endif

#endif

  // Serial read (commands from web remote)
  incomingSerialByte = 0;
  if (Serial.available() > 0)
  {
    incomingSerialByte = Serial.read();
    if (incomingSerialByte == '%')
    {
      // SD file management from remote console
      sd_filemanager();
    }
  }

#if 1//defined APC  //only necessary for APC since it is conflicting with Interrupt Timer
  // MIDI input handling
  check_midi_devices();
#endif

  // check encoder (old, polling)
  //ENCODER[ENC_L].update();
  //ENCODER[ENC_R].update();

  extern bool multiband_active;
  extern bool multiband_confirm;

#if defined APC
  if (apc_scroll_message)
  {
    if (apc_welcome_message && apc_scroll_counter == 0)
    {
      snprintf_P(apc_scrolltext, sizeof(apc_scrolltext), PSTR("MDT"));
      apc_welcome_message = false;
    }
    apc_drawString_Background();
  }
  //This is the best place to trigger the refresh of the sample name or new step. If done too soon (in apc_NoteOn), it displays wrong name.
  //Before was at case midi::NoteOff:, but better is to not overload the midi interrupt with prints.
  apc_trigger_print_in_lcd();
#endif

  LCDML.loop();

  if (touchReadTimer >= TOUCH_MAX_REFRESH_RATE_MS && touch_ic_found)
  {
    touchReadTimer = 0;
    updateTouchScreen();
    const TouchFn touchHandler = getCurrentTouchHandler();
    if (touchHandler) {
      touchHandler();
    }
    else if (LCDML.FUNC_getID() > _LCDML_DISP_cnt) {
      // menu
      handle_touchscreen_menu();
      scope.draw_scope(230, 18, 87, 64);
    }

    if (back_button_touch_page_check_and_init_done == false) {
      current_page_has_touch_back_button = (touch_button_back_page() || legacy_touch_button_back_page());
      if (current_page_has_touch_back_button) {
        draw_back_touchbutton();
      }
      back_button_touch_page_check_and_init_done = true;
    }

    if (current_page_has_touch_back_button) {
      handle_page_with_touch_back_button();
    }

    const ScopeSettings s = getCurrentScopeSettings();
    const bool inhibitDrawing = s.onlyDrawWhenRunning && !seq.running;
    if (s.enabled && !inhibitDrawing) {
      scope.draw_scope(s.x, s.y, s.w, s.h);
    }
  }

  if (screenSaverResetTimer >= SCREENSAVER_RESET_RATE_MS) {
    screenSaverResetTimer = 0;
    if (wakeScreenFlag) {
      wakeScreenFlag = false;
      resetScreenTimer();
    }
  }

  if (LCDML.FUNC_getID() == LCDML.OTHER_getIDFromFunction(UI_func_recorder))
  {
    if (fm.wav_recorder_mode == 1) {
      continueWavRecording();
    }
  }

#ifdef GRANULAR
  else if (LCDML.FUNC_getID() == LCDML.OTHER_getIDFromFunction(UI_func_granular))
  {
    display_granular_status();
  }
#endif

  else if (LCDML.FUNC_getID() == LCDML.OTHER_getIDFromFunction(UI_func_drums))
  {
    display.setTextSize(1);
    for (uint8_t d = 0; d < NUM_DRUMS; d++)
    {
      if (Drum[d]->isPlaying() != display_buffer_samples[d])
      {
        //  setCursor_textGrid_small(24 + d * 2, 2);
        display.setCursor(122 + (d * 2 * CHAR_width_small), 18);
        if (Drum[d]->isPlaying())
        {
          display.setTextColor(GREEN, COLOR_BACKGROUND);
          display.print("o");
        }
        else
        {
          display.setTextColor(GREY2, COLOR_BACKGROUND);
          display.print("-");
        }
        display_buffer_samples[d] = Drum[d]->isPlaying();
      }
    }
  }
  else if (LCDML.FUNC_getID() == LCDML.OTHER_getIDFromFunction(UI_func_master_effects))
  {
    if (Gate[0]->get_state() != gate_state_old[0])
    {
      display.setTextSize(1);
      setCursor_textGrid_small(1 + 5, 5);
      display.setTextColor(GREEN, GREY4);
      print_gate_state(0);
      gate_state_old[0] = Gate[0]->get_state();
    }

    if (Gate[1]->get_state() != gate_state_old[1])
    {
      display.setTextSize(1);
      setCursor_textGrid_small(17 + 5, 5);
      display.setTextColor(GREEN, GREY3);
      print_gate_state(1);
      gate_state_old[1] = Gate[1]->get_state();
    }
  }
  else if (LCDML.FUNC_getID() == LCDML.OTHER_getIDFromFunction(UI_func_seq_pattern_editor) || LCDML.FUNC_getID() == LCDML.OTHER_getIDFromFunction(UI_func_seq_vel_editor))
  {
    if (seq.running == false) {
      sub_step_recording(false, 0);
    }
  }

#if defined SMFPLAYER
  else if (!SMF.isEOF())
  {
    if (SMF.getNextEvent()) {
    }
  }
  else if (smf_playing)
  {
    if (LCDML.FUNC_getID() == LCDML.OTHER_getIDFromFunction(UI_func_midiplayer))
    {
      if (generic_temp_select_menu == 1)
        display.setTextColor(COLOR_BACKGROUND, COLOR_SYSTEXT);
      else
        display.setTextColor(COLOR_SYSTEXT, COLOR_BACKGROUND);
      setCursor_textGrid_small(33, 6);
      display.print("STOPPED");
      print_smf_parameters();
      helptext_r(F("START PLAYING"));
      seq.edit_state = false;
    }
    smf_playing = false;
    SMF.close();
  }
#endif

  if (microsynth_control_rate > MICROSYNTH_CONTROL_RATE_MS) // update lfos, filters etc. when played live or by seq.
  {

#ifdef COMPILE_FOR_PSRAM
    if (noisemaker_update_params_flag)
    {
      refreshNoisemakerParameterEditors();
    }
#endif

    if (LCDML.FUNC_getID() == LCDML.OTHER_getIDFromFunction(UI_func_cv_page) && dac_state != 0)
    {
      display.setTextSize(1);
      display.setTextColor(COLOR_SYSTEXT, COLOR_BACKGROUND);

      if (dac_state == 1) //dac on
      {
        setCursor_textGrid_small(19, 3);
        print_formatted_number(dac_midi_note, 3);
        setCursor_textGrid_small(19, 4);
        print_note_name_and_octave(dac_midi_note);
        display.print("  ");
        setCursor_textGrid_small(19, 5);
        print_formatted_number(dac_cv_1, 4);
        setCursor_textGrid_small(19, 6);
        print_formatted_number(dac_midi_vel, 3);
        setCursor_textGrid_small(19, 7);
        print_formatted_number(dac_cv_3, 4);

        setCursor_textGrid_small(30, 1);
        display.print("ON");
      }
      else  //dac off
      {
        setCursor_textGrid_small(30, 1);
        display.print("  ");
      }
      dac_state = 0;
    }

#if defined (RGB_ENCODERS) && defined (MCP_23008) || defined (RGB_ENCODERS) && defined (MCP_23017)
    setRGBencoderColor();
#endif

    microsynth_control_rate = 0;
    update_microsynth_params();
    // Microsynth Realtime Screen Updates

    if (LCDML.FUNC_getID() == LCDML.OTHER_getIDFromFunction(UI_func_microsynth)) {
      if (microsynth[microsynth_selected_instance].pwm_last_displayed != microsynth[microsynth_selected_instance].pwm_current && seq.cycle_touch_element != 1)
      {
        display.setTextSize(1);
        setCursor_textGrid_small(15, 17);
        display.setTextColor(GREY2, COLOR_BACKGROUND);
        print_formatted_number(microsynth[microsynth_selected_instance].pwm_current / 10, 3);
        microsynth[microsynth_selected_instance].pwm_last_displayed = microsynth[microsynth_selected_instance].pwm_current;
      }

      if (seq.cycle_touch_element != 1 && microsynth[microsynth_selected_instance].filter_osc_freq_last_displayed != microsynth[microsynth_selected_instance].filter_osc_freq_current)
      {
        display.setTextSize(1);
        setCursor_textGrid_small(15, 15);
        display.setTextColor(GREY2, COLOR_BACKGROUND);
        print_formatted_number(microsynth[microsynth_selected_instance].filter_osc_freq_current / 100, 3);
        microsynth[microsynth_selected_instance].filter_osc_freq_last_displayed = microsynth[microsynth_selected_instance].filter_osc_freq_current;
      }

      // debug
      display.setTextSize(1);
      display.setTextColor(GREY2, COLOR_BACKGROUND);
      setCursor_textGrid_small(42, 8);
      print_formatted_number(microsynth[0].lfo_delay, 4);
      setCursor_textGrid_small(42, 9);
      print_formatted_number(microsynth[0].lfo_fade, 4);
    }
  }

  if (braids_control_rate > BRAIDS_CONTROL_RATE_MS) // update  filters when played live or by seq.
  {
    braids_control_rate = 0;
    update_braids_params();
    if (LCDML.FUNC_getID() == LCDML.OTHER_getIDFromFunction(UI_func_braids))
    {
      display.setTextSize(1);
      display.setTextColor(GREY2, COLOR_BACKGROUND);

      for (uint8_t d = 0; d < NUM_BRAIDS; d++)
      {
        if (braids_filter_state_last_displayed[d] != braids_filter_state[d])
        {
          if (d >= NUM_BRAIDS / 2)
            setCursor_textGrid_small(49, 7 + d - NUM_BRAIDS / 2);
          else
            setCursor_textGrid_small(45, 7 + d);
          print_formatted_number(braids_filter_state[d] / 100, 3);
          braids_filter_state_last_displayed[d] = braids_filter_state[d];
        }
      }
    }
  }

  if (seq.running)
  {
    if (sidechain_active)
      ;
    update_sidechain();  //work in progress
  }

  if (control_rate > CONTROL_RATE_MS)
  {
    control_rate = 0;

#if defined GLOW
    glow();
#endif

    // display.fillRect(10,10,30,30, ColorHSV(1, 0, int(led_bright)));

    if (seq.running && seq.step != seq.UI_last_seq_step)
    {
      update_display_functions_while_seq_running();
    }

    // check for value changes, unused voices and CPU overload
    for (uint8_t instance_id = 0; instance_id < NUM_DEXED; instance_id++)
    {
      active_voices[instance_id] = MicroDexed[instance_id]->getNumNotesPlaying();
      if (active_voices[instance_id] == 0)
        midi_voices[instance_id] = 0;
    }

    if (LCDML.FUNC_getID() == LCDML.OTHER_getIDFromFunction(UI_func_voice_select)) // draw MIDI in activity bars
    {
      for (uint8_t instance_id = 0; instance_id < NUM_DEXED; instance_id++)
      {
        display.console = true;
        if (midi_decay_timer_dexed > MIDI_DECAY_TIMER && midi_decay_dexed[instance_id] > 0)
        {
          midi_decay_dexed[instance_id]--;
          display.fillRect(167 + (instance_id * 12), 19, 5, 8 - midi_decay_dexed[instance_id], COLOR_BACKGROUND);                           // region above bar
          display.fillRect(167 + (instance_id * 12), 27 - midi_decay_dexed[instance_id], 5, midi_decay_dexed[instance_id], COLOR_PITCHSMP); // bar
        }
        else if (midi_voices[instance_id] == 0 && midi_decay_dexed[instance_id] == 0 && !MicroDexed[instance_id]->getSustain())
        {
          midi_decay_dexed[instance_id]--;
          display.fillRect(167 + (instance_id * 12), 19 + 7, 5, 1, COLOR_BACKGROUND);
        }
      }
      if (midi_decay_timer_dexed > MIDI_DECAY_LEVEL_TIME)
      {
        midi_decay_timer_dexed = 0;
      }
      display.console = false;
    }
    else if (LCDML.FUNC_getID() == LCDML.OTHER_getIDFromFunction(UI_func_microsynth)) // draw MIDI in activity bars on microsynth page
    {
      for (uint8_t instance_id = 0; instance_id < NUM_MICROSYNTH; instance_id++)
      {
        display.console = true;
        if (midi_decay_timer_microsynth > MIDI_DECAY_TIMER && midi_decay_microsynth[instance_id] > 1)
        {
          midi_decay_microsynth[instance_id]--;
          display.fillRect(13 * 6 + (instance_id * 12), 10, 5, 8 - midi_decay_microsynth[instance_id], COLOR_BACKGROUND);                                // region above bar
          display.fillRect(13 * 6 + (instance_id * 12), 18 - midi_decay_microsynth[instance_id], 5, midi_decay_microsynth[instance_id], COLOR_PITCHSMP); // bar
        }
        // if value is 0 then no drawing should happen - so stop at 1
        if (midi_decay_microsynth[instance_id] == 1)
        {
          display.console = true;
          display.fillRect(13 * 6 + (instance_id * 12), 17, 5, 1, COLOR_BACKGROUND);
          midi_decay_microsynth[instance_id] = 0;
        }
        if (midi_decay_timer_microsynth > MIDI_DECAY_LEVEL_TIME)
        {
          midi_decay_timer_microsynth = 0;
        }
      }
      display.console = false;
    }
  }

  // SAVE-SYS-EVENT-HANDLING
  if (save_sys > SAVE_SYS_MS && save_sys_flag == true)
  {
#ifdef DEBUG
    LOG.println(F("Check if we can save configuration.sys"));
#endif
    bool instance_is_playing = false;
    for (uint8_t instance_id = 0; instance_id < NUM_DEXED; instance_id++)
    {
      if (active_voices[instance_id] > 0 || seq.running)
      {
        instance_is_playing = true;
        break;
      }
    }
    if (instance_is_playing == false)
    {
      for (uint8_t instance_id = 0; instance_id < NUM_DRUMS; instance_id++)
      {
        if (Drum[instance_id]->isPlaying())
        {
          instance_is_playing = true;
          break;
        }
      }
    }
    if (instance_is_playing == false)
    {
      save_sd_sys_json();
      save_sys = 0;
      save_sys_flag = false;
      if (LCDML.FUNC_getID() == 255 && ts.keyb_in_menu_activated == false)
      {
        TouchButton::drawButton(GRID.X[0], GRID.Y[5], "CONFIG", "SAVED", TouchButton::BUTTON_ACTIVE);
        ui_save_notification_icon = true;
      }
      else if (LCDML.FUNC_getID() == LCDML.OTHER_getIDFromFunction(UI_func_system_settings) ||
        LCDML.FUNC_getID() == LCDML.OTHER_getIDFromFunction(UI_func_test_touchscreen))
      {
        TouchButton::drawButton(GRID.X[0], GRID.Y[5], "CONFIG", "SAVED", TouchButton::BUTTON_ACTIVE);
        ui_save_notification_icon = true;
      }
#ifdef DEBUG
      LOG.println(F("Saved."));
#endif
    }
    else
    {
#ifdef DEBUG
      LOG.println(F("System is playing, next try..."));
#endif
      save_sys = 0;
    }
  }

  if (save_sys > SAVE_SYS_MS && ui_save_notification_icon)
  {

    if (LCDML.FUNC_getID() == 255)
    {
      display.console = true;
      TouchButton::clearButton(GRID.X[0], GRID.Y[5], COLOR_BACKGROUND);
      ui_save_notification_icon = false;
      display.console = false;
    }
    else if (LCDML.FUNC_getID() == LCDML.OTHER_getIDFromFunction(UI_func_system_settings) ||
      LCDML.FUNC_getID() == LCDML.OTHER_getIDFromFunction(UI_func_test_touchscreen))
    {
      display.console = true;
      TouchButton::clearButton(GRID.X[0], GRID.Y[5], COLOR_BACKGROUND);

      ui_save_notification_icon = false;
      display.console = false;
    }
  }
  else  if (multiband_confirm && multiband_active == false && save_sys > 1500)
  {
    multiband_confirm = false;
    if (ts.keyb_in_menu_activated == false && LCDML.FUNC_getID() == 255)
      TouchButton::drawButton(GRID.X[4], GRID.Y[5], "MULTI", "BAND", TouchButton::BUTTON_NORMAL);
    else
      if (LCDML.FUNC_getID() == LCDML.OTHER_getIDFromFunction(UI_func_multiband_dynamics))
        TouchButton::drawButton(GRID.X[0], GRID.Y[1] + 7, "MULTI", "BAND", TouchButton::BUTTON_NORMAL);
  }

#if defined(DEBUG) && defined(SHOW_CPU_LOAD_MSEC)
  if (cpu_mem_millis >= SHOW_CPU_LOAD_MSEC)
  {
    cpu_mem_millis -= SHOW_CPU_LOAD_MSEC;
    show_cpu_and_mem_usage();
  }
#endif

  // send all buffered draw commands to WebRemote
  if (remote_active)
  {
    display.flushSysEx();
  }
}

/******************************************************************************
  MIDI MESSAGE HANDLER
******************************************************************************/

#if defined(DRUMS_FILTERS) 
void set_stereo_envelopes(uint8_t instance_id, uint8_t sample)
{
  AudioNoInterrupts();
  sample_envelope[instance_id]->attack(pow(drum_config[sample].env_attack, 1.2f));
  sample_envelope[instance_id + NUM_DRUMS]->attack(pow(drum_config[sample].env_attack, 1.2f));

  sample_envelope[instance_id]->hold(pow(drum_config[sample].env_hold, 1.5f));
  sample_envelope[instance_id + NUM_DRUMS]->hold(pow(drum_config[sample].env_hold, 1.5f));

  sample_envelope[instance_id]->decay(pow(drum_config[sample].env_decay, 1.5f));
  sample_envelope[instance_id + NUM_DRUMS]->decay(pow(drum_config[sample].env_decay, 1.5f));

  sample_envelope[instance_id]->sustain((float)drum_config[sample].env_sustain / 100);
  sample_envelope[instance_id + NUM_DRUMS]->sustain((float)drum_config[sample].env_sustain / 100);

  sample_envelope[instance_id]->release(pow(drum_config[sample].env_release, 2.5f));
  sample_envelope[instance_id + NUM_DRUMS]->release(pow(drum_config[sample].env_release, 2.5f));
  AudioInterrupts();
}

void set_filter(uint8_t d, uint8_t slot) {
  if (drum_config[d].filter_mode == 0)
  {
    Drum_filter[slot]->setLowpass(0, 20000, 0.2);
    Drum_filter[slot + NUM_DRUMS]->setLowpass(0, 20000, 0.2);
  }
  else if (drum_config[d].filter_mode == 1)
  {
    Drum_filter[slot]->setLowpass(0, get_sample_filter_freq(d) * 14000, 0.5);
    Drum_filter[slot + NUM_DRUMS]->setLowpass(0, get_sample_filter_freq(d) * 14000, 0.5);
  }
  else if (drum_config[d].filter_mode == 2)
  {
    Drum_filter[slot]->setBandpass(0, get_sample_filter_freq(d) * 14000, 0.5);
    Drum_filter[slot + NUM_DRUMS]->setBandpass(0, get_sample_filter_freq(d) * 14000, 0.5);
  }
  else if (drum_config[d].filter_mode == 3)
  {
    Drum_filter[slot]->setHighpass(0, get_sample_filter_freq(d) * 14000, 0.5);
    Drum_filter[slot + NUM_DRUMS]->setHighpass(0, get_sample_filter_freq(d) * 14000, 0.5);
  }
}
#endif

uint8_t msp_playmode_sample_slot[NUM_DRUMS];

#if defined COMPILE_FOR_PSRAM

void Multi_Sample_Player(byte inNumber, byte inVelocity, byte instance)
{

  // find the MSP preset slot for this midi channel

  if (drum_counter >= NUM_DRUMS)
    drum_counter = 0;
  uint8_t slot = drum_get_slot(DRUM_POLY);

  if (slot != 99)
  {

    //drum_type[slot] = DRUM_POLY;
    Drum[slot]->enableInterpolation(true);
    for (uint8_t y = 0; y < NUM_MULTISAMPLE_ZONES; y++)
    {
      if (inNumber >= msz[instance][y].low && inNumber <= msz[instance][y].high)
      {

        ts.msp_peak[instance] = (inVelocity * msz[instance][y].vol * msp[instance].sound_intensity) / 900000;
        float pan = mapfloat(msz[instance][y].pan, PANORAMA_MIN, PANORAMA_MAX, 0.0, 1.0);

        AudioNoInterrupts();

#if defined DRUMS_FILTERS
        set_filter(msz[instance][y].psram_entry_number, slot);
#endif
        // drum_mixer_r.gain(slot, (1.0 - pan) * volume_transform(mapfloat(inVelocity * msz[presetslot][y].vol * msp[presetslot].sound_intensity, 0, 1270000, 0.0, 0.9)));
        // drum_mixer_l.gain(slot, pan * volume_transform(mapfloat(inVelocity * msz[presetslot][y].vol * msp[presetslot].sound_intensity, 0, 1270000, 0.0, 0.9)));

        if (drum_config[y].numChannels == 1) //mono
        {
          drum_mixer_r.gain(slot, (1.0 - pan) * volume_transform(mapfloat(inVelocity * msz[instance][y].vol * msp[instance].sound_intensity, 0, 1270000, 0.0, 0.8)));
          drum_mixer_l.gain(slot, pan * volume_transform(mapfloat(inVelocity * msz[instance][y].vol * msp[instance].sound_intensity, 0, 1270000, 0.0, 0.8)));
        }
        else //stereo
        {
          drum_mixer_r.gain(slot, 1.0 * volume_transform(mapfloat(inVelocity * msz[instance][y].vol * msp[instance].sound_intensity, 0, 1270000, 0.0, 0.8)));
          drum_mixer_l.gain(slot, 1.0 * volume_transform(mapfloat(inVelocity * msz[instance][y].vol * msp[instance].sound_intensity, 0, 1270000, 0.0, 0.8)));
        }

        drum_reverb_send_mixer_r.gain(slot, volume_transform(mapfloat(msz[instance][y].rev, 0, 100, 0.0, 0.8)));
        drum_reverb_send_mixer_l.gain(slot, volume_transform(mapfloat(msz[instance][y].rev, 0, 100, 0.0, 0.8)));

        global_delay_in_mixer[0]->gain(slot + 10, get_sample_delay1(msz[instance][y].psram_entry_number) / 5);
        global_delay_in_mixer[1]->gain(slot + 10, get_sample_delay2(msz[instance][y].psram_entry_number) / 5);

        msp_playmode_sample_slot[slot] = msz[instance][y].playmode;

        if (msz[instance][y].loop_type == 0)
          Drum[slot]->setLoopType(loop_type::looptype_none);
        else   if (msz[instance][y].loop_type == 1)
          Drum[slot]->setLoopType(loop_type::looptype_repeat);
        else if (msz[instance][y].loop_type == 2)
          Drum[slot]->setLoopType(loop_type::looptype_pingpong);

        note_buffer_msp[slot] = inNumber;
        // Drum[slot]->setPlaybackRate(powf(2.0, (inNumber - msz[instance][y].rootnote) / 12.0) );

        Drum[slot]->setPlaybackRate(powf(2.0, (inNumber - msz[instance][y].rootnote) / 12.0) * mapfloat(msz[instance][y].tune, 0, 200, 0.98, 1.02));
#if defined DRUMS_FILTERS
        set_stereo_envelopes(slot, msz[instance][y].psram_entry_number);
        sample_envelope[slot]->noteOn();
        sample_envelope[slot + NUM_DRUMS]->noteOn();
#endif
        AudioInterrupts();

#if  defined COMPILE_FOR_PSRAM
        if ((drum_config[msz[instance][y].psram_entry_number].drum_data != NULL && drum_config[msz[instance][y].psram_entry_number].len > 0 &&
          drum_config[msz[instance][y].psram_entry_number].len < 10000000 && y >= 0 && y < NUM_DRUMSET_CONFIG - 1) ||
          (drum_config[msz[instance][y].psram_entry_number].drum_data != NULL && drum_config[msz[instance][y].psram_entry_number].len > 0 &&
            drum_config[msz[instance][y].psram_entry_number].len < 10000000 && y >= 210 && y < 216))
        {

          Drum[slot]->playRaw((int16_t*)drum_config[msz[instance][y].psram_entry_number].drum_data, drum_config[msz[instance][y].psram_entry_number].len,
            drum_config[msz[instance][y].psram_entry_number].numChannels);

          if (msz[instance][y].loop_type != 0)
          {

            //Drum[slot]->startLoop(msz[instance][y].loop_start);
            Drum[slot]->setLoopStart(msz[instance][y].loop_start);
            Drum[slot]->setLoopFinish(msz[instance][y].loop_end);

          }

        }
#endif

        //     if (LCDML.FUNC_getID() == LCDML.OTHER_getIDFromFunction(UI_func_MultiSamplePlay)) {
        //     display.fillRect(0, 185 + y * 5, 2 * CHAR_width_small + msz[instance][y].low * 3.5 - (24 * 3.5) - 1, 5, COLOR_BACKGROUND);
        //     display.fillRect(2 * CHAR_width_small + msz[instance][y].low * 3.5 - (24 * 3.5), 185 + y * 5,
        //                      (msz[instance][y].high - msz[instance][y].low) * 3.5 + 2.5, 5, RED);

        //     display.fillRect(2 * CHAR_width_small + msz[instance][y].high * 3.5 - (24 * 3.5) + 3.5, 185 + y * 5,
        //                      DISPLAY_WIDTH - (msz[instance][y].high * 3.5) + (18 * 3.5), 5, COLOR_BACKGROUND);
        //     display.fillRect(2 * CHAR_width_small + msz[instance][y].rootnote * 3.5 - (24 * 3.5) - 1, 185 + y * 5 + 1,
        //                      3.5 + 1, 5 - 2, COLOR_SYSTEXT);
        //   }
        // }
        // else
        // {
        //     if (LCDML.FUNC_getID() == LCDML.OTHER_getIDFromFunction(UI_func_MultiSamplePlay)) {
        //     display.fillRect(2 * CHAR_width_small + msz[instance][y].low * 3.5 - (24 * 3.5), 185 + y * 5,
        //                      (msz[instance][y].high - msz[instance][y].low) * 3.5 + 2.5, 5, get_multisample_zone_color(y));
        //     display.fillRect(2 * CHAR_width_small + msz[instance][y].rootnote * 3.5 - (24 * 3.5) - 1, 185 + y * 5 + 1,
        //                      3.5 + 1, 5 - 2, COLOR_SYSTEXT);
        //   }
        // }
      }
    }
  }
}
#endif
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
