propann/L-AZ-2/(commit log)

2026-09-13 Document SparkFun 4x4 LED button matrix role
2026-09-13 Mention SparkFun 4x4 LED matrix in README
2026-09-14 AZ-2: real screen UI, dynamic engines/patches, 8-track sequencer, master FX
    Ecran ESP32 (src_esp32/az2_screen, jamais commite avant) :
    - Menu tactile + pages PADS/ENCODEURS/AUDIO/LIENS SERIE/A PROPOS sur le
    vrai ecran VIEWE UEDX48480040E-WB (GC9503V + FT6336U).
    - Page SEQUENCEUR : grille 4 pistes x 16 pas tactile, curseur de lecture
    synchronise sur CLOCK:, transport PLAY/STOP, tempo +/- et division du
    pas reglables a l'ecran, bandes verticales de mesure coloreees.
    - Page MOTEURS : moteur + patch par piste, cycle au toucher.
    - Validation des lectures I2C tactiles (rejette touchCount/coordonnees
    hors bornes -- corrige un flot de faux TOUCH:DOWN observe reellement).
    Teensy (src_teensy/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
    [main.cpp]
2026-09-14 AZ-2: diagnostic LED Pico (LEDTEST), etude mode JEUX, placeholder ecran
    Pico (src_pico) :
    - Mode diagnostic LEDTEST (commande serie USB) : allume un seul canal du
    mux a la fois, maintenu ~0,7s, avec le detail imprime en clair --
    demande pour debugger l'absence de LED. Utilise en direct
    (2026-09-14) : zero LED sur les 48 combinaisons testees malgre boutons
    et alimentation mux corrects -- cause identifiee : broche EN du
    CD74HC4067 laissee en l'air (doit aller au GND commun). Doc de
    cablage mise a jour avec cette broche, absente du tableau original.
    Mode JEUX (nouveau doc AZ2_EMULATION_JEUX.md) :
    - Etude technique : Retro-Go (deja vendored) est ESP-IDF natif + ecrans
    SPI ILI9341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
    [main.cpp]
2026-09-14 AZ-2: mode JEUX reoriente vers GB/GBC (Walnut-CGB) au lieu de NES
    Suite a la precision "l'idee c'est plutot GB/GBA/GBC, ca suffira" :
    - Recherche : Peanut-GB (MIT, callbacks purs, single-header C99, tourne
    a pleine vitesse meme sur un Raspberry Pi Pico) + Walnut-CGB (MIT,
    quasi drop-in, vrai support GBC, deja demontre sur ESP32-S3/M5Stack
    Cardputer) retenus a la place d'Anemoia-ESP32 (NES, GPLv3) -- callbacks
    hote (gb_rom_read/lcd_draw_line) bien mieux adaptes pour brancher
    directement sur notre Arduino_GFX, sans aucun code d'affichage a
    arracher.
    - GBA etudie et ecarte du v0 : ~20fps mesures avec frameskip sur
    ESP32-S3 (44gba/44vba) -- pas fluide, pas une bonne experience sur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
2026-09-15 AZ-2: abandon du Pico, croix+boutons+potards directs sur le Teensy
    Suite a un long diagnostic en direct (EN du mux non relie -> corrige,
    resistance serie manquante -> ajoutee, masses LED/boutons -> verifiees
    et pontees, 3.3V puis 5V testes) sans jamais obtenir une seule LED
    fonctionnelle sur la matrice SparkFun + mux CD74HC4067, decision : "ca
    m'a soule, on fait sans la matrice de bouton" -- architecture simplifiee
    a 2 cartes (ESP32 ecran + Teensy), plus de 3e cerveau.
    Teensy (src_teensy/az2_audio) :
    - Retrait complet de Serial3/du lien Pico (announce*/relayLine/
    readSerialCommands/setup ne parlent plus qu'a Serial+Serial1).
    - Nouveau : croix (4 switches, pins 2-5) + boutons A/B/C/D (pins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
    [main.cpp]
2026-09-15 AZ-2: note par pas (dexed-touch), page CONTROLES, correctif potards
    Suite a "prend le sequenceur du dexed touch" + "on remplace l'ancien
    pad/led/mux par les nouveaux boutons" :
    - SequencerTrack : note UNIQUE par piste -> note PAR PAS
    (stepNote[16], comme seq.note_data[pattern][step] dans
    MicroDexed-touch/sequencer.cpp). Nouvelle commande NOTE:piste:pas:note
    (0-127), relayee comme STEP:/ENGINE:/etc.
    - Correctif potards : le lissage + seuil de 2026-09-14 ne suffisait pas
    -- une broche flottante (potard pas encore cable) peut se balader sur
    une bonne partie de la plage, pas juste vibrer de +/-1. Ajout d'un
    plafond dur (20Hz max/potard) en plus du lis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
    [main.cpp]
2026-09-15 AZ-2: 2 nouveaux moteurs audio (Karplus-Strong, Analog)
    Suite a "on voit si on peut ajouter des moteurs audio si oui lesquels" :
    2 moteurs de plus, tous deux objets STANDARD de la lib Audio Teensy
    (zero vendoring), choisis pour couvrir des familles de synthese absentes
    des 3 premiers (FM/piano electrique/oscillateur complexe) :
    - KARPLUS (AudioSynthKarplusStrong) : corde pincee physique. API minimale
    (noteOn(freq,vel)/noteOff()), 1 seul patch possible.
    - ANALOG (AudioSynthWaveform + AudioEffectEnvelope, chaines en
    permanence par piste) : oscillateur classique + enveloppe ADSR,
    patch = forme d'onde (Sinus/Dent de scie/Carre/Triangle).
    kEngineCount passe de 3 a 5 dans AZ2_Protocol.h (t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
    [main.cpp]
2026-09-15 AZ-2: ecran de veille Matrix + page CONFIGURATION
    Suite a "on met en place un fond ecran a la matrix reglable en temps qui
    s'active au bout d'un moment configure dans le menu configuration" :
    - Nouvelle page CONFIGURATION (menu) : reglage du delai d'inactivite
    avant veille, +/- 10s, 0=desactive jusqu'a 600s. RAM uniquement pour
    l'instant (pas de sauvegarde flash/NVS entre redemarrages).
    - Ecran de veille "Matrix" (pluie de caracteres verts, esthetique du
    projet depuis le debut) : s'active apres le delai configure sans
    activite (toucher ecran OU appui NAV:/BTN: relaye par le Teensy),
    se ferme sur n'importe quelle activite en redessinant l'ecran courant.
    - Garde-fous anti-flicker :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
2026-09-15 AZ-2: topo concurrence + nettoyage (page ENCODEURS morte retiree)
    Suite a "on fait une etude des groovebox du commerce M8 et autres et on
    fait un topo pour voir ce qui manque ce qu'on supprime" :
    docs/AZ2_BENCHMARK_CONCURRENCE.md : nouvelle section "Topo 2026-09-15"
    -- etat reel de la machine compare aux concurrents deja documentes,
    tableau des manques par priorite (mute/solo, sauvegarde persistante,
    swing = haute priorite/faible effort ; volume/pan par piste et MIDI =
    priorite moyenne ; samples et enchainement de patterns = bloques par le
    materiel/gros chantier), et liste de ce qui peut etre supprime.
    Nettoyage applique immediatement (identifie par le topo) :
    - Page ENCODEURS retiree de l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
2026-09-15 AZ-2: ecran de veille adouci, support carte SD (ESP32)
    Suite a "l'ecran de veille saute tout le temps a la figure faut le
    rendre moins present" : delai par defaut passe de 60s a 3 minutes (trop
    court pendant une session de cablage/soudure), animation ralentie
    (110ms/pas au lieu de 60) et couleurs moins vives (moins de blanc pur).
    Reste reglable en direct depuis la page CONFIGURATION.
    Suite a "on prepare aussi la carte sd" : support SD ajoute cote ESP32
    (SD.begin() avec broches custom SPI, voir AZ2_CABLAGE_MASTER.md).
    Attention documentee : SD-CS (IO47) partage le meme GPIO que le bus SPI
    3 fils de commande de l'ecran -- verifie sans risque sur le depot
    officiel VIEWE car ce bus n'est utilis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
2026-09-15 AZ-2: anti-rebond bruit I2C tactile (audit suite a "ca apparait au toucher")
    Cause trouvee suite a "il apparait des que je touche un bouton, verifie
    tout le code" : le bus I2C tactile (GPIO40/41) n'exigeait aucune
    confirmation avant d'agir sur une lecture -- un seul echantillon
    parasite par du bruit electrique (switch pas encore fixe proprement,
    deja vu dans les logs en TOUCH:I2C_ERROR:BAD_COUNT par intermittence)
    peut avoir des coordonnees qui tombent par hasard DANS l'ecran, ce que
    les filtres existants (touchCount>2, coordonnees hors ecran) ne
    detectent pas puisque ce n'est pas un cas grossier.
    Correctif : un toucher n'est accepte comme DOWN qu'apres 2 lectures
    consecutives actives (loop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
    [main.cpp]
2026-09-15 AZ-2: corrige le bug "ecran de veille se relance des qu'on le reveille"
    Cause trouvee suite a "quand je reveille l'ecran ca remet en mode
    veille" : le test d'inactivite dans loop() comparait "now" (millis()
    fige en haut de la fonction) a lastActivityMs -- mais noteActivity(),
    appelee juste avant sur un reveil, remet lastActivityMs a jour avec un
    NOUVEL appel a millis(), forcement >= now. "now - lastActivityMs"
    devenait alors une soustraction non signee negative, qui deborde vers
    un nombre enorme -- le test d'inactivite le lisait comme "des heures se
    sont ecoulees" et relancait la veille instantanement, dans le MEME tour
    de boucle que le reveil.
    Correctif : le test d'inactivite relit millis(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
    [main.cpp]
2026-09-15 AZ-2: emulateur Game Boy / GBC integre (mode JEUX)
    Suite a "y'a rien dans jeux, c'est le moment de mettre l'emulateur gb
    gbc et gba si on arrive" :
    - Walnut-CGB vendore (src_esp32/az2_screen/walnut_cgb/walnut_cgb.h,
    header unique ~9900 lignes, licence MIT verifiee dans le fichier).
    - Nouveau module gb_emulator.h/.cpp : ROM chargee depuis /games sur la
    carte SD vers la PSRAM du module ESP32-S3 (8 Mo, meme puce que
    l'ecran), callbacks gb_rom_read/cart_ram_read/write/error, rendu
    ligne par ligne (CGB: gb->cgb.fixPalette deja en RGB565 ; DMG: palette
    verte classique) transmis a gbBlitLine() (main.cpp, seul endroit qui
    connait `gfx`) -- mise a l'echelle x3 (160x144 -> 480x432, centre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
    [gb_emulator.cpp, gb_emulator.h, main.cpp]
2026-09-15 AZ-2: stabilise l'emulateur GB/GBC (frame_skip + rendu groupe)
    Suite a "on a des sauts d'images on peut stabiliser" (confirme que
    l'emulateur tourne reellement avec une ROM en carte SD) :
    - gb.direct.frame_skip = true : option native du coeur -- continue
    d'emuler CHAQUE frame a vitesse normale (logique/timing du jeu
    corrects), mais n'appelle lcd_draw_line() qu'une frame sur deux. Le
    rendu (bus RGB parallele) etait le gros cout, pas l'emulation CPU ;
    diviser son volume par 2 stabilise la cadence sans ralentir le jeu.
    - gbBlitLine() : 1 seul draw16bitRGBBitmap() par ligne source (bloc
    480x3 d'un coup) au lieu de 3 appels separes -- moins de surcharge par
    appel vers l'ecran.
    Teste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
    [gb_emulator.cpp, main.cpp]
2026-09-15 JEUX: menu de selection de ROM (liste /games, plus un seul jeu auto)
    Suite a la demande explicite : "l'emulateur demarre une rom il nous faut
    un menu pour demarrer la rom qu'on choisit dans une liste de rom pas
    uniquement un jeux" -- confirme par l'utilisateur que le chargement
    automatique d'une ROM unique fonctionnait deja en reel (Tobu Tobu Girl).
    - gb_emulator.h/.cpp : gbLoadFirstRom() remplace par deux fonctions
    distinctes -- gbScanRoms() liste tous les .gb/.gbc trouves dans
    /games (jusqu'a 16, kGbMaxRoms) sans rien charger, gbLoadRom(nom)
    charge et demarre un fichier precis. Comportement de chargement
    (PSRAM, gb_init, cart RAM, frame_skip) inchange.
    - main.cpp : goTo(Screen::Re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
2026-09-15 Menu en 4 cadres, sauvegarde GB, SD Teensy, fix loader Teensy, nettoyage
    Suite a "on est trop charge on fait 4 cadre reglage avec tout ce qui
    est config musique jeux doc" + "sauvegarde tout" + demandes de suivi
    sur les encodeurs (sens, bouton) :
    ESP32 (src_esp32/az2_screen/) :
    - Menu reorganise en 2 niveaux : grille de 4 categories (MUSIQUE/JEUX/
    CONFIG/DOC) puis sous-liste des pages existantes -- croix + bouton A
    pilotent la navigation/confirmation (grille en 2x2, sous-liste comme
    avant), bouton B revient en arriere (categorie -> grille -> ecran
    precedent), tactile toujours fonctionnel en parallele.
    - Sauvegarde de partie GB : cart RAM ecrite dans <rom>.sav a cote de la
    ROM sur l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
    [config.h, gb_emulator.cpp, main.cpp]
2026-09-15 Son de l'emulateur GB -> DAC Teensy (paquets), remap boutons JEUX
    Suite a "il faut un emulateur complet classe ... comment l'envoyer sous
    forme de paquet plutot aux Teensy pour que le DAC le joue" + "faut les
    config sur les encodeurs ... comme ca on a a/b, start/select et les
    gachettes" :
    - Walnut-CGB n'emet pas l'audio lui-meme (audio_read/audio_write =
    simples hooks registre, doc du header verifiee directement) -- ajout
    de minigb_apu (deltabeard/Peanut-GB, vendored dans minigb_apu/,
    licence MIT verifiee) qui transforme ces acces en PCM stereo 16 bits.
    ENABLE_SOUND=1 desormais.
    - Chaque frame GB : buffer minigb_apu reduit a mono 8 bits a 8kHz
    (deli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
2026-09-15 Etude tracker : LSDJ / M8 / Polyend, synthese pour AZ-2
    Suite a "on fait un tracker a la LSDJ mais plus complet genre M8" puis
    "les meilleurs tracker, on fait une etude, on reunit les meilleures
    fonctions/organisation" -- recherche sourcee (manuels officiels +
    lsdj-doc) sur les 3 references citees/pertinentes avant tout code.
    Retenu (voir docs/AZ2_TRACKER_ETUDE.md pour le detail complet) :
    - Hierarchie song/chain/phrase commune aux 3 -- notre sequenceur n'a
    qu'un pattern de 16 pas en boucle, pas de chainage. Plus gros ecart
    structurel, repousse a une etape suivante.
    - Colonnes par pas Note+Instrument+1-3 effets, confirme dans les 3 --
    deja la tranche choisie pour la v1.
    - Banque d'ins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
2026-09-15 Etude tracker : ajoute gammes/accords, clavier live, projets
    Suite a l'etude initiale (LSDJ/M8/Polyend), 3 demandes de suivi : "on
    ajoute les gammes accord", "que notre clavier tactile serve a editer en
    live les sons", "qu'on puisse creer facilement un projet, le
    sauvegarder". Documente comme etapes 5-7 du plan, sequencees APRES la
    fondation deja actee (ticks + colonnes NOTE/INST/FX/VAL) puisqu'elles
    s'appuient dessus (gammes/clavier live editent directement la colonne
    NOTE) ou dependent d'un format de donnees stabilise (sauvegarde de
    projet). Rien code -- doc seulement, implementation a suivre.
    Claude-Session: https://claude.ai/code/s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
2026-09-15 Tracker : ticks internes, colonnes NOTE/INST/FX/VAL, fix 8 pistes ecran
    Suite au plan de AZ2_TRACKER_ETUDE.md (etapes 1-3) :
    Teensy (src_teensy/az2_audio/) :
    - Sous-decoupage du pas en 4 ticks (kTicksPerStep) sur la meme
    IntervalTimer -- fondation commune ARP/CUT/RETRIG (LSDJ/M8/Polyend).
    advanceSequencer() renommee advanceTick() : tick 0 = declenchement du
    pas (comme avant), ticks suivants = traitement d'effet
    (triggerStepFx()). ARP et RETRIG reutilisent trackNoteOn()/
    trackNoteOff() (note-off puis note-on) -- marchent uniformement sur
    les 5 moteurs sans rien connaitre de leurs specificites.
    - SequencerTrack etendu : stepPatch[] (colonne INST, 0xFF = defaut
    piste -- stocke/tr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
    [main.cpp]
2026-09-15 Topo : etat des lieux avant session de nuit autonome
    Demande explicite ("on fait un topo de la situation, on documente")
    avant de lancer une session autonome ("tu as toute la nuit ... je te
    laisse en automatique"). Photographie l'etat reel du projet : ce qui
    est confirme en materiel vs ce qui est code mais pas encore teste
    (notamment le son GB et le tracker, en attente d'un reflash ESP32 --
    mode boot manuel requis, utilisateur absent). Sert de point de depart
    et sera mis a jour au fil de la nuit.
    Claude-Session: https://claude.ai/code/session_015NWwYxj3D8BhXaL4QJ3EZd
2026-09-15 Tracker : couleur par effet (grille + vue detail)
    Suite a "on met de la couleur, des effets" -- chaque effet (ARP/CUT/
    RET) a sa couleur (kStepFxColors, alignee sur la palette synthwave
    existante) : texte FX/VAL colore dans la vue detail, fond legerement
    teinte pour les pas avec effet actif (visible sans ouvrir le detail),
    et une petite pastille coloree dans le coin des cellules de la grille
    8 pistes qui ont un effet.
    Compile (pio run -e screen_esp). Pas encore flashe/vu en reel (ESP32
    en attente de mode boot manuel).
    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
2026-09-15 Filtre resonant par piste (FILT:) -- teste en reel
    Suite a "on fait un max de code ... on fait un M8 killer" -- chaque
    piste a maintenant son propre filtre (AudioFilterStateVariable,
    Chamberlin SVF entier, tres bon marche en CPU -- verifie), insere entre
    le moteur actif et le mixeur de groupe (patchTrackIn[] pointe
    desormais vers trackFilter[track] au lieu du groupe directement,
    connexion fixe filtre->groupe en plus). Sortie passe-bas utilisee pour
    l'instant (bande/passe-haut pas exposes en v1).
    Protocole : FILT:piste:coupure(0-127):resonance(0-127) -- coupure
    mappee exponentiel 20Hz-18kHz (sensation synthe standard), resonance
    lineaire 0.7-5.0 (plage acceptee par le filtre). Grand ouvert p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
    [main.cpp]
2026-09-15 ADSR editable par piste (ENV:) -- teste en reel
    Suite a "modifiant les patch adrs" -- ENV:piste:attaque:chute:
    maintien:relachement (0-127 chacun) s'applique a trackAnalogEnv[]
    (AudioEffectEnvelope) : seul moteur de la palette avec une vraie
    enveloppe ADSR generique exposee (Dexed/EPiano ont leur propre
    comportement interne au patch, Braids/Karplus n'ont pas d'enveloppe).
    Accepte pour n'importe quelle piste, meme si son moteur actif n'est
    pas encore ANALOG -- l'enveloppe est deja prete des qu'on y bascule.
    Temps mappes en quadratique 0-2000ms (plus de resolution pres de 0,
    utile pour une attaque tres courte -- pertinent pour un son
    percussif) ; maintien lineaire 0.0-1.0.
    Verifie en reel (T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
2026-09-15 Oscilloscope Teensy->ESP32 (SCOPE:) -- bug de gel trouve et corrige
    Suite a "une fenetre ou on voit l'onde du son jouer evoluer en
    modifiant le patch" -- meme principe de paquet binaire que le son GB
    (voir AZ2_Protocol.h, kScopePacketMagic=0x02) mais dans l'AUTRE sens
    (Teensy -> ESP32) : AudioRecordQueue capture les blocs bruts du filtre
    de la piste "observee" (SCOPE:piste / SCOPE:OFF, rebranchement
    dynamique comme patchTrackIn[]), decime x4 vers 32 octets PCM 8 bits,
    envoie un paquet toutes les ~20ms (bien plus lent que l'arrivee reelle
    des blocs, ~2.9ms a 44.1kHz -- largement suffisant pour un tracer
    visuel). Desactive (scopeQueue.end()) hors edition de patch, cout CPU
    nul.
    BUG REEL trouv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
    [main.cpp]
2026-09-15 Page PATCH ecran : filtre + ADSR + oscilloscope en direct
    Suite a "on fait en sorte que nos moteurs audio soient completement
    configurables dans une fenetre ou on voit l'onde du son jouer evoluer
    en modifiant le patch ... il faut tout un filtre" -- nouvelle page
    PATCH (categorie MUSIQUE) :
    - Selecteur de piste (< PISTE N >).
    - Tracer d'onde en direct : recoit les paquets SCOPE (voir
    kScopePacketMagic dans AZ2_Protocol.h, commit precedent cote Teensy)
    et dessine une ligne brisee -- message "(silence...)" tant qu'aucune
    note ne joue sur la piste observee (le filtre source ne transmet rien
    sans entree, voir le commit precedent).
    - 6 lignes de reglage a boutons -/+ (meme motif que CONFIG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
2026-09-15 Topo : mise a jour apres la session de nuit (filtre/ADSR/scope)
    Journal complet de ce qui a ete fait (couleurs tracker, filtre,
    ADSR, oscilloscope + le bug de gel reel trouve/corrige dessus) et de
    ce qui reste a verifier au reveil (ESP32 jamais reflashe cette nuit,
    tout le cote ecran depuis hier soir seulement compile-verifie).
    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
2026-09-15 Gammes : verrouillage a la saisie de note (croix/detail sequenceur)
    Suite a "on ajoute les gammes accord" -- 5 gammes (CHROMATIQUE/MAJEUR/
    MINEUR/PENTA MAJ/PENTA MIN, racine C fixe pour cette version), reglage
    sur la page CONFIGURATION (memes boutons -/+ que le reglage d'ecran de
    veille). CHROMATIQUE = comportement d'origine (aucune restriction),
    donc rien ne change tant qu'on ne touche pas ce reglage -- retro-
    compatible par defaut.
    nextNoteInScale() remplace le simple "+/-1 demi-ton" partout ou la
    croix transpose une note (grille du sequenceur ET vue detail, colonne
    NOTE) : saute directement a la prochaine note DANS LA GAMME choisie,
    jusqu'a un tour chromatique complet avant d'abandonner.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
    [main.cpp]
2026-09-15 Topo : ajoute gammes, verification finale de nuit
    Journal complet a jour (5 items faits cette nuit), verification finale
    croisee (les deux environnements compilent ensemble, Teensy reinterroge
    une derniere fois -- stable). Cloture la session de nuit autonome.
    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
2026-09-16 Tracker : 8 patterns + chainage en song (PATTERN:/SONGSET:/SONGLEN:/SONGMODE:)
    Suite au retour sur le materiel : "c'est plus un sequenceur qui peut
    nous permettre d'assembler des patterns, mais il faut un tracker
    complet" -- exactement le point deja identifie et repousse dans
    AZ2_TRACKER_ETUDE.md ("chainage de patterns (song)"). Modele le plus
    simple des 3 references etudiees (Polyend) : un pas de song = un
    pattern complet (8 pistes ensemble), pas de chaines par piste
    independantes comme LSDJ/M8.
    - `SequencerTrack seqTracks[8]` devient `patterns[8][8]` (8 patterns de
    16 pas x 8 pistes). `currentPattern` = pattern EDITE (STEP:/NOTE:/
    INST:/SFX: s'appliquent toujours a celui-ci, meme si u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
2026-09-16 Page SONG ecran (chainage de patterns) + fix scintillement page PATCH
    ESP32 : nouvelle page SONG (categorie MUSIQUE) -- bascule MODE (boucle
    simple/song), reglage LONGUEUR (-/+), grille de 16 cases (touche pour
    cycler le pattern assigne 0-7). Envoie SONGMODE:/SONGLEN:/SONGSET: vers
    le Teensy (voir commit precedent). Page SEQUENCEUR (grille ET vue
    detail) : le titre affiche desormais le pattern edite ("SEQUENCEUR -
    PAT N"), toucher le titre cycle le pattern (switchToPattern(), envoie
    PATTERN:). Les grilles de pas (seqStepOn/Note/Patch/Fx/FxVal) sont
    maintenant indexees par pattern (8 copies locales, seedees comme cote
    Teensy -- pas de "dump" complet envoye au changement de pattern, trop
    volum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
    [main.cpp]
2026-09-16 Sequenceur : la vue tracker (NOTE/INST/FX/VAL) devient la vue unique
    Retour utilisateur direct apres avoir vu la page sur le vrai ecran :
    "on a pas de tracker a la M8 LSDJ" -- confirme (question posee) : le
    probleme est la VUE elle-meme. Chez LSDJ/M8, l'ecran affiche TOUJOURS
    la colonne NOTE/INST/FX/VAL d'une piste (16 lignes) ; notre grille
    ON/OFF + double-tap pour voir le detail ne correspond pas a cette
    experience.
    Changement : la grille 8 pistes (ON/OFF, bandes de mesure) est
    SUPPRIMEE. La page SEQUENCEUR affiche desormais TOUJOURS :
    - Titre = pattern edite ("PATTERN N", toucher pour cycler).
    - Selecteur de piste juste en dessous ("< PISTE N >", toucher les
    moities gauche/droite pour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
    [main.cpp]
2026-09-16 Sequenceur : panneau patch actif dans l'espace libre a droite
    Suite a "on a de la place, on affiche le patch actif et ses reglages
    du cote droit ... on met le patch en cours dans la piste
    selectionnee" -- les colonnes NOTE/INST/FX/VAL ne remplissent pas
    kSeqRightEdge, ~194px restaient vides a droite. Nouveau panneau
    drawTrkSidePanel() (bordure couleur de la piste) : moteur (ENGINE) +
    patch en gros, memes tableaux trackEngine[]/trackPatch[] que la page
    MOTEURS. Se redessine au changement de piste (deja fait via
    drawSeqDetailPage()) et sur echo ENGINE:/PATCH: si la piste concernee
    est celle affichee.
    Filtre/ADSR PAS inclus dans ce panneau (mentionne juste en texte,
    "voir la page PATCH") -- ce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
2026-09-16 Panneau patch (ADSR/DXP), sauvegarde patch SD, croix sur page MOTEURS
    - Sequenceur : panneau lateral "patch actif" affiche desormais
    CUTOFF/RESONANCE/ADSR (ou ALGO/FEEDBACK pour DEXED) + bouton AGRANDIR
    vers la page PATCH complete de la piste selectionnee.
    - Page PATCH : ligne SLOT (0-7) + SAVE/LOAD, ecrit/lit /patches/N.txt
    sur la SD de l'ESP32 (moteur, patch, filtre, ADSR, algo/feedback
    Dexed). LOAD renvoie ENGINE:/PATCH:/FILT:/ENV:/DXP: au Teensy.
    - Reglages propres au moteur DEXED (DXP:, algo 1-32 + feedback 0-7) :
    l'ADSR generique n'a jamais eu d'effet sur ce moteur (EG DX7 interne
    au patch) -- page PATCH bascule l'affichage des lignes 2-5 selon le
    moteur de la piste (ADSR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
    [main.cpp]
2026-09-16 Audit code mort : suppression Pico, launcher LVGL vendore inutilise, stubs
    Demande du jour ("on fait un job sur tout code mort, audit de code") :
    - src_pico/ (Pico abandonne le 2026-09-14, plus dans platformio.ini
    depuis -- le cablage/diagnostic reste documente en prose dans
    AZ2_CABLAGE_PICO.md, le code reste dans l'historique git si besoin).
    - src_esp32/Launcher_lvgl-master/ (75 Mo, vendored d'un exemple
    fournisseur, JAMAIS reference dans platformio.ini ni aucun .cpp/.h --
    confirme par grep avant suppression).
    - src_esp32/main.cpp et src_teensy/main.cpp : stubs vides (setup/loop
    no-op) hors build_src_filter, sans reference nulle part.
    - kHelloKeypad (AZ2_Protocol.h) + son OR defe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
    [main.cpp]
2026-09-16 Audit : synchro tactile/croix page MOTEURS, commentaire transpose a jour
    - Page MOTEURS : un toucher deplace aussi le curseur croix (piste +
    colonne focus) sur la ligne/case touchee -- avant, toucher la piste 5
    puis appuyer sur la croix modifiait encore la piste 0 (curseur resté
    a son ancienne position, jamais synchronise par le tactile).
    - Commentaire de transposeSemitones (voix live) : renvoyait vers
    AZ2_TODO_PICO.md (ferme, plus a jour) -- precise que MACRO: existe
    toujours cote protocole mais n'a plus d'emetteur depuis la suppression
    du Pico, a rebrancher sur un futur controle.
    Claude-Session: https://claude.ai/code/se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
    [main.cpp]
2026-09-16 Recherche concurrence, feuille de route, README -- journee du 2026-09-16
    Demande ("recherche concurrents, ameliorations indispensables, etat des
    lieux, feuille de route, presentation du projet") pendant l'absence de
    l'utilisateur -- boards non branches sur cette machine, tout compile
    seulement, rien reverifie en reel aujourd'hui.
    - AZ2_BENCHMARK_CONCURRENCE.md : 2 machines ajoutees (Teenage
    Engineering OP-XY, nanoloop), 2 reverifiees (M8 Model:02, Polyend
    Tracker Mini), liste d'ameliorations indispensables priorisee
    (mute/solo, sauvegarde de projet complet, swing, volume/pan par
    piste, sampler, MIDI, accords, clavier live).
    - AZ2_FEUILLE_DE_ROUTE.md : "Phase 8" avec cette liste prio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
2026-09-16 Audit : pieges reels trouves pour mute/solo, volume/pan et swing
    En preparant l'implementation (priorite 1-4 de la liste indispensable),
    3 pieges concrets trouves en lisant le code existant AVANT d'ecrire quoi
    que ce soit -- aucun materiel branche aujourd'hui pour verifier un
    changement sur le chemin audio/l'ISR du sequenceur, donc rien implemente,
    juste documente precisement pour la prochaine session avec le materiel :
    - Mute/solo et volume/pan (si sur le meme gain) : le gain du mixeur de
    groupe sert DEJA de porte note-on/note-off pour le moteur BRAIDS
    (trackNoteOn()/trackNoteOff()) -- un mute naif l'ecraserait et un
    demute en cours de note ne serait jamais reapplique. Facon correcte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
2026-09-17 GB : bouton C pour quitter la partie, verification complete du mapping
    Demande ("faut mettre start/select sur les encodeurs, verifier si on a
    bien tout les controles, faut un truc pour sortir de l'emulateur") :
    - Start/Select etaient DEJA sur les encodeurs 1/2 (bouton integre)
    depuis le 2026-09-15 -- verifie en relisant le code, toujours en
    place, rien a changer la-dessus.
    - Verification complete : croix (D-pad), A/B, Select/Start (encodeurs)
    couvrent les 6 entrees d'une vraie Game Boy (pas de L/R sur le
    materiel d'origine) -- mapping deja complet.
    - Manque reel trouve : aucun moyen de quitter une partie en cours (B
    est pris par le jeu, A ne fait rien de special en jeu). Corrige :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
    [main.cpp]
2026-09-17 Teensy reflashe et verifie en reel : DXP fonctionne comme documente
    Teensy branche -- flash de master_teensy (contenait handleDexedParamCommand/
    announceDexedParams depuis 2 echanges, jamais teste en reel jusqu'ici).
    Verifie par serie USB :
    - Boot propre, CPU 8.6%/9.9% max, memoire 133-141/200 blocs (identique
    aux mesures d'avant, aucune regression).
    - DXP:0:0:5 et DXP:0:1:3 (algo/feedback piste 0) bien relayes/appliques.
    - PATCH:0:0 (rechargement) ecrase l'algo/feedback avec ceux de la
    banque (DXP:0:0:4 / DXP:0:1:0) -- comportement voulu, confirme en
    reel pour la premiere fois.
    Claude-Session: https://claude.ai/code/session_015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
2026-09-17 Emulateur GB : pagination de la liste de ROM (16 -> 40, defilement)
    Demande ("met en plus des trucs cool ... genre 20 30") -- copie de 30+
    jeux perso sur la carte a revele 2 limites reelles :
    - kGbMaxRoms=16 coupait silencieusement gbScanRoms() avant de trouver
    toute la collection (aucun message d'erreur, juste des jeux invisibles).
    - Meme a 16, la liste dessinait toutes les lignes a la suite sans
    defilement -- au-dela de ~9-10 lignes (480px / 40px par ligne), le
    reste tombait hors ecran et devenait injoignable au tactile.
    Corrige : kGbMaxRoms releve a 40, liste paginee a 8 lignes visibles
    (meme convention que les 8 pistes ailleurs) + fleches </> et
    compteur "X-Y / N" en bas quand il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
    [gb_emulator.h, main.cpp]
2026-09-17 Sampler GB : capture REC/STOP -> .wav sur la SD du Teensy (phase 1)
    Demande ("un bouton encodeur pour REC/STOP, une routine pour capter les
    sons de l'emulateur ... sur la SD du Teensy") :
    - Teensy : gbRecStart()/gbRecPush()/gbRecStop()/writeWavHeader() pres
    de handleGbAudioPacket() -- capture le flux GB tel qu'il arrive
    (8kHz mono, avant le sur-echantillonnage vers 44.1kHz fait pour la
    lecture), ecrit un .wav PCM 16 bits standard dans
    /samples/SAMPLE_NNN.wav sur BUILTIN_SDCARD (carte dediee du Teensy,
    distincte de celle de l'ESP32). Protocole REC:START/REC:STOP,
    echo REC:STARTED:/REC:STOPPED:/REC:ERROR:. Garde-fou 30s (arret
    automatique si on oublie STOP).
    - ESP32 : encodeur 0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
    [main.cpp]
2026-09-17 Sauvegarde/chargement de PROJET complet (page PROJET, priorite #2)
    Priorite #2 de la liste indispensable (AZ2_BENCHMARK_CONCURRENCE.md) --
    contrairement au patch (savePatchSlot(), une seule piste), un "projet"
    couvre TOUT le morceau : BPM/division/gamme, chainage song, moteur/
    patch/filtre/ADSR/algo-feedback des 8 pistes, et les 1024 pas (8
    patterns x 8 pistes x 16 pas) note/etat/patch/effet/valeur.
    Purement cote ESP32 -- aucun changement Teensy, toutes les commandes
    protocole existaient deja (STEP:/NOTE:/INST:/SFX:/ENGINE:/PATCH:/FILT:/
    ENV:/DXP:/BPM:/DIV:/PATTERN:/SONGSET:/SONGLEN:/SONGMODE:), zero risque
    sur le chemin audio.
    - Nouvelle page Screen::Project (menu MUSIQUE) : 4 emplacement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
2026-09-17 Volume par piste (VOL:), en evitant le piege Braids trouve hier
    Priorite #4 de la liste indispensable, implementee en respectant
    precisement le piege documente hier (le gain du mixeur de groupe sert
    de porte note-on/off pour BRAIDS, un volume naif l'aurait casse) :
    - Teensy : VOL:<piste>:<0-127>, trackVolume[] par piste (defaut 127).
    Pour les moteurs autres que Braids, applique immediatement (gain de
    groupe statique hors note-on/off). Pour Braids, applique seulement a
    la PROCHAINE note (trackNoteOn()) -- pas de risque de perturber la
    porte en dehors d'une transition. Limite connue et documentee : un
    changement de volume sur une note Braids deja tenue ne s'entend qu'a
    la transiti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
2026-09-17 Clavier tactile comme editeur live de note (priorite #8)
    Etape 6 de AZ2_TRACKER_ETUDE.md ("taper un pad pendant qu'un pas de
    sequenceur est selectionne doit pouvoir poser cette note sur le pas").
    Purement ESP32, aucun changement Teensy.
    - selectedSeqTrack/selectedSeqStep valent TOUJOURS quelque chose depuis
    la refonte du tracker (plus -1) -- pas moyen de deviner "un pas est
    selectionne" a partir de leur seule valeur. Bouton D (libre) bascule
    donc explicitement la page AUDIO entre jouer en direct / poser sur
    piste-pas (indique dans le titre), pour ne jamais ecraser une
    composition par accident.
    - Taper un pad en mode "poser" allume le pas (STEP: ON) et y ecrit la
    note (NOTE:).
    -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
    [main.cpp]
2026-09-17 Mute/solo par piste -- resolution propre du piege Braids (priorite #1)
    LE piege le plus serieux trouve le 2026-09-16 (le gain du mixeur de
    groupe sert de porte note-on/off pour BRAIDS) est resolu, mieux que
    prevu a l'origine :
    - trackNoteHeld[] suit si une note Braids est REELLEMENT tenue sur
    chaque piste. Avec cette info, applyGroupGainNow(track) calcule le
    bon gain dans TOUS les cas et peut etre appelee a tout moment sans
    jamais fausser la porte -- mute/demute est donc IMMEDIAT, meme sur
    une note Braids deja tenue (meilleur que l'approche volume seul de
    la veille, qui acceptait un decalage sur ce moteur specifique).
    - trackEffectiveGain(track) combine volume+mute+solo en un seul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
    [main.cpp]
2026-09-17 MIDI notes IN (priorite #6) -- MVP, route vers la voix live
    USB_MIDI_SERIAL etait deja dans platformio.ini depuis le debut du
    projet, jamais exploite avant aujourd'hui. usbMIDI est fourni
    automatiquement par le core Teensy des que ce mode USB est choisi,
    rien a cabler physiquement.
    - updateMidiIn() (boucle usbMIDI.read()) route NoteOn/NoteOff (tout
    canal) vers liveVoice.keydown()/keyup() -- EXACT meme chemin que les
    pads tactiles de l'ecran, zero risque nouveau sur le graphe audio.
    - NoteOn velocite 0 traite comme NoteOff (convention MIDI standard).
    Explicitement PAS fait : synchro horloge MIDI, MIDI OUT, routage vers
    une piste du sequenceur (chacune a un moteur fixe, pas encore concu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
    [main.cpp]
2026-09-17 Topo : 5 des 8 priorites indispensables faites aujourd'hui
    Journal recapitulatif de la session ("on attaque la feuille de route,
    avance un max") -- mute/solo, sauvegarde de projet, volume, MIDI IN,
    clavier tactile live : faits et compiles. Swing, accords, sampler
    phase 2/3 : pas faits (pieges/design necessitant le materiel).
    Rien de tout ca n'a ete flashe ni verifie en reel aujourd'hui (aucun
    board branche sur cette machine) -- prochaine etape prioritaire au
    retour du materiel : tout reverifier avant d'aller plus loin.
    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
2026-09-17 Audit doc : reconcilie les 2 listes priorisees, purge les sections perimees
    Demande ("on corrige la doc, la feuille de route, on fait un point sur
    les analyses") -- plusieurs incoherences trouvees en relisant tout :
    - AZ2_BENCHMARK_CONCURRENCE.md et AZ2_FEUILLE_DE_ROUTE.md numerotaient
    les 8 memes priorites DIFFEREMMENT (ex: "Accords" #7 dans l'un, #5
    dans l'autre) -- renumerote pour que les deux tableaux se
    correspondent exactement.
    - Items #2 (sauvegarde projet) et #5 (sampler) du benchmark : encore
    marques "pas fait"/estimation d'effort perimee alors que faits
    (2026-09-17) ou confirmes en reel (carte SD Teensy).
    - Table "Ce qui manque le plus" du 2026-09-15 : perimee dans son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
2026-09-17 Rafraichit l'en-tete de AZ2_ETAT_DES_LIEUX.md (etait fige au 2026-09-15)
    Les 3 premieres sections du document (Vue d'ensemble / Ce qui marche /
    Bugs connus) etaient restees telles quelles depuis le tout premier
    topo, alors que le reste du fichier a accumule 3 jours de journal en
    dessous -- un lecteur qui ouvre le doc tombait sur un etat perime
    (pas de filtre, pas d'ADSR, pas de gammes, C/D "pas de role"... tout
    ca est fait depuis). Reecrites pour refleter l'etat reel du
    2026-09-17 : ce qui est confirme en reel vs code-seulement vs
    carrement pas fait, avec pointeur clair vers le journal chronologique
    en dessous pour le detail jour par jour.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
2026-09-17 Audit doc : AZ2_ARCHITECTURE_FIRMWARE_DOUBLE.md corrige (matrice/MIDI/samples)
    Table des responsabilites ESP32/Teensy encore basee sur les plans
    d'origine (matrice 4x4 + LEDs physiques, MIDI/CV "hors v0", sample
    playback "a definir") -- corrigee pour refleter les decisions/l'etat
    reel : croix+boutons+encodeurs directs sur le Teensy (matrice/LEDs
    abandonnees 2026-09-14), MIDI notes IN fait, samples sur la SD dediee
    du Teensy (pas indexee par l'ESP32).
    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
2026-09-17 Audit doc : marque AZ2_ARCHITECTURE_FIRMWARE_DOUBLE.md comme planif precoce
    Ajoute une note en tete du document -- beaucoup de details (pages UI
    nommees, strategie samples A/B/C, etapes Teensy) datent d'avant que
    quoi que ce soit ne soit construit et ne correspondent plus a
    l'existant. Le principe general (ESP32=humain, Teensy=audio) reste
    exact, pointeur ajoute vers AZ2_ETAT_DES_LIEUX.md/AZ2_FEUILLE_DE_ROUTE.md
    pour l'etat reel plutot que de tout reecrire (doc de planification,
    priorite plus basse que les docs actives).
    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
2026-09-17 Audit doc : marque AZ2_ESP32_CONTROLE_WIFI_SD_RETRO.md comme planif precoce
    L'arborescence SD proposee (/az2/..., /retro-go/...) n'est pas celle
    reellement utilisee (en pratique : /games/, /patches/, /projects/ a la
    racine) et le document decrit encore Retro-Go comme le mode retro
    prevu alors qu'il a ete etudie puis ecarte le 2026-09-14 au profit de
    Walnut-CGB. Note ajoutee en tete plutot que tout reecrire (doc de
    planification, le Wi-Fi decrit reste correct -- jamais commence).
    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
2026-09-17 Audit doc : notes de peremption sur 3 docs de planification precoce
    - AZ2_ECRAN_FACADE.md : matrice SparkFun 4x4+LED (abandonnee
    2026-09-14) et mauvais modele d'ecran (ESP32-4848S040C_I/ST7701 au
    lieu du VIEWE UEDX48480040E-WB/GC9503V reel).
    - AZ2_FEUILLE_DE_ROUTE_MOTEUR.md : mentionne encore 3 firmwares
    (Pico abandonne) et "pas de SD/sample" (carte SD dediee + sampler
    phase 1 faits depuis).
    - AZ2_PORTAGE_MICRODEXED_TOUCH.md : meme correction de modele d'ecran
    (une seule cellule de tableau, corrigee inline).
    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
2026-09-17 Audit doc : note historique sur AZ2_CABLAGE_BASE.md (matrice abandonnee)
    Pointe vers AZ2_CABLAGE_MASTER.md (cablage reellement utilise) --
    dernier document de planification precoce de la passe d'audit
    d'aujourd'hui, le reste des docs cablage/DAC/emulation etaient deja
    a jour.
    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
2026-09-17 GB : navigation croix dans la liste de ROM + correction du bug d'affichage
    2 bugs reels rapportes en jouant, corriges :
    1. Navigation croix impossible dans la liste de ROM -- la croix etait
    TOUJOURS routee vers gbSetButton() (boutons du jeu), meme sans ROM
    chargee. Ajoute selectedRomIndex (surbrillance, meme convention que
    la piste choisie sur la page MOTEURS), HAUT/BAS deplacent la
    selection en suivant le defilement, A charge la ROM. gbSetButton()/
    le mapping A-B du jeu ne s'activent plus que si gbIsLoaded() est
    vraiment vrai, pas juste "page JEUX affichee".
    2. Bug d'affichage au demarrage d'une partie -- drawLinkStatus() (bas
    d'ecran, y=450) chevauche le bas de l'imag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
    [main.cpp]
2026-09-17 GB : compteur de FPS reel pour diagnostiquer le "vitesse pas top" GBC
    Retour utilisateur ("cote emulation GBC ca marche pas trop, c'est cote
    vitesse qu'on est pas bon") -- hypothese la plus probable : le limiteur
    "if (now - lastGbFrameMs >= 17)" plafonne la cadence mais ne rattrape
    jamais un retard. Si l'ESP32-S3 met plus de 17ms par tour de loop()
    (rendu + emulation + reseau) sur un jeu GBC plus lourd qu'un DMG
    simple, la cadence reelle tombe sous 59,7 im/s -- le jeu ET sa musique
    (meme horloge interne) tournent au ralenti. Pas un bug du mode double-
    vitesse CGB (verifie dans walnut_cgb.h : le coeur gere deja
    correctement `lcd_count += inst_cycles >> doubleSpeed`).
    Ajoute un compteur qui i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
    [main.cpp]
2026-09-17 Swing/groove (priorite #3) -- le piege timer du 2026-09-16 EVITE
    Contourne completement le piege identifie hier (reconfigurer
    sequencerTimer depuis sa propre ISR pour alterner 2 durees de tick)
    au lieu de le resoudre au prix du risque initial :
    - sequencerTimer garde sa periode FIXE pour toujours -- jamais un seul
    appel a .update() lie au swing, l'ISR tourne exactement comme avant.
    - Seul le seuil logiciel de fin de pas varie : ticksForCurrentStep
    (recalculee une fois au debut de chaque pas) vaut
    kTicksPerStep-swingAmount pour les pas pairs et
    kTicksPerStep+swingAmount pour les impairs -- shuffle classique,
    tempo moyen exact sur toute paire de pas (le total de ticks sur 2
    pas ne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
    [main.cpp]
2026-09-17 Teensy reflashe et verifie en reel : mute/solo/volume/swing/MIDI/sampler
    Tout le paquet du jour teste directement en serie sur le vrai Teensy :
    - Boot propre, CPU/memoire identiques a avant (8.6%/9.9%, 133/141/200
    blocs) -- aucune regression malgre tous les ajouts.
    - SWING:/MUTE:/SOLO:/VOL: tous acceptes et relayes correctement.
    - Test critique : SWING:96 (quasi maximum) + PLAY pendant 5s -- le
    sequenceur avance plusieurs mesures sans aucun gel, tempo moyen
    coherent malgre l'asymetrie forte. Le mecanisme "seuil logiciel
    variable, timer jamais reconfigure" tient la route en reel.
    - REC:START/REC:STOP (sampler) toujours fonctionnel.
    Reste a tester manuellement : mute/demute une piste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
2026-09-17 Audit complet du code (~6800 lignes) : 3 corrections rapides
    Relecture ligne par ligne des 2 firmwares + protocole, demandee par
    l'utilisateur pour recouper avec des analyses d'autres IA.
    Corrige (sans risque, pas de materiel necessaire) :
    - Page JEUX sans ROM : message "Pas de son pour l'instant" trompeur
    (le son GB fonctionne depuis longtemps) -- corrige.
    - AZ2_Protocol.h : kRecToggle jamais utilise nulle part, decrivait une
    convention differente de celle reellement implementee -- supprime.
    - handlePatternCommand() (Teensy) : commentaire disait "effectif au
    prochain pas", en realite c'est au prochain redemarrage de pattern
    (jusqu'a 16 pas plus tard) -- comportement voulu, commenta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
    [main.cpp]
2026-09-17 docs+ui_esp: clarifie que la matrice 4x4 SparkFun est abandonnee
    - AZ2_FEUILLE_DE_ROUTE.md : avertissement direct sur "Phase 3 - Matrice
    SparkFun 4x4" (le plan d'origine n'etait marque abandonne que bien
    plus bas dans le doc).
    - AZ2_PORTAGE_MICRODEXED_TOUCH.md : note "perime" en tete, comme les
    autres docs de planification precoce (en manquait).
    - src_esp32/az2_control/main.cpp : commentaire d'entete precisant que
    cet environnement (ui_esp, hors default_envs) teste le mux 4x4
    abandonne et n'est pas le firmware ESP32 shippe. Aucun changement de
    comportement, compile verifie (pio run -e ui_esp).
    - AZ2_ETAT_DES_LIEUX.md : journal de ce passage de menage.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
2026-09-17 esp32: setup() n'abandonne plus Teensy/tactile/SD si l'ecran echoue
    Si gfx->begin() echoue, setup() sautait tout le reste (Serial1 vers le
    Teensy, Wire tactile, SD) et ne laissait qu'une ligne
    DISPLAY:ERROR:BEGIN_FAILED comme diagnostic. Maintenant seuls l'intro
    et le premier affichage (qui ont vraiment besoin de l'ecran) sont
    sautes ; le lien Teensy, le tactile et la SD s'initialisent quand meme,
    donc un ecran en panne n'empeche plus de diagnostiquer le reste.
    Point note lors de l'audit du 2026-09-17, corrige ici. Compile verifie
    (pio run -e screen_esp) ; comportement normal (ecran OK) inchange.
    Claude-Session: https://claude.ai/code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
    [main.cpp]
2026-09-17 teensy: retour d'erreur explicite sur commande malformee/hors bornes
    Les handlers de commandes texte (STEP/NOTE/INST/SFX/PATTERN/SONGSET/
    SONGLEN/SONGMODE/BPM/DIV/SWING/ENGINE/PATCH/FX/VOL/MUTE/SOLO/FILT/ENV/
    DXP/SCOPE/PAD/MACRO) ignoraient silencieusement toute commande
    malformee ou hors bornes -- aucun moyen de savoir qu'une commande a ete
    rejetee, ni cote USB ni cote ESP32. Ajoute sendCommandError(), qui
    reprend la convention deja existante pour REC:ERROR: (gbRecStart()) :
    <COMMANDE>:ERROR:<raison>, envoye sur Serial et Serial1.
    Aucun changement sur le chemin valide (memes conditions de validation
    qu'avant). L'ESP32 ignore deja les lignes non reconnues, donc rien ne
    casse cote UI ; ces l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
    [main.cpp]
2026-09-17 teensy: swing max ne coupe plus la fenetre CUT/RETRIG
    triggerStepFx() (ARP/CUT/RETRIG) n'est appelee que dans la branche
    "sinon" (currentTick != 0) d'advanceTick(). L'ancien plafond de
    swingAmount (kTicksPerStep-1 = 3) pouvait raccourcir un pas pair a 1
    seul tick : currentTick restait alors a 0 pendant tout le pas, cette
    branche n'etait donc jamais executee -- un CUT ou un RETRIG pose sur ce
    pas ne se declenchait plus du tout au swing maximum.
    Fix : plafonne swingAmount a kTicksPerStep-2 (jamais moins de 2 ticks
    par pas) dans handleSwingCommand(), et met a jour les commentaires/
    formules de conversion associes (reponse HELLO, doc). Garantit au moins
    un passage dans la branche "sinon" par pa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
    [main.cpp]
2026-09-17 docs: note la remise a jour de main et le bug d'audit sur mauvaise branche
    main etait reste fige au commit initial du 13 septembre pendant que le
    developpement reel se faisait sur az2-screen-engines-sequencer -- un
    audit technique externe recemment pousse sur main a donc lu le code du
    jour 1 (conclusions comme "aucun sequenceur"/"un seul moteur sinus"
    fausses par rapport a l'etat reel). main a ete fusionne avec la branche
    de developpement le 2026-09-17 (commit 419d110) pour que toute future
    analyse externe lise le vrai code.
    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
2026-09-17 licence + hygiene du depot (GPLv3, plateformes figees, -89 Mo)
    Chantier demande explicitement par l'utilisateur suite a l'audit externe
    du 2026-09-17 ("on reste libre pour la licence et on fait tout ce qu'il
    faut") :
    - LICENSE (GPLv3) a la racine + docs/AZ2_LICENCES.md : inventaire de
    chaque composant tiers reellement compile dans un binaire livre, sa
    licence et sa provenance. GPLv3 choisi parce que Synth_MDA_EPiano
    (moteur EPIANO, GPLv3 uniquement, deja compile dans master_teensy)
    rendait le binaire deja GPLv3 de fait -- pas un choix arbitraire.
    Point ouvert documente : licence de Synth_Braids non fournie dans ce
    vendoring, a verifier avant distribution binaire plus large.
    - pl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
2026-09-17 tracker: probabilite + condition par pas (PROB:/COND:/FILL:)
    Nouvelle fonction demandee explicitement par l'utilisateur ("on
    travaille le tracker on fait un truc qui eclate tout") -- la plus citee
    dans l'etude concurrence face a Elektron/Digitakt (trig conditions).
    - AZ2_Protocol.h : encodage partage ESP32/Teensy sur 1 octet
    (stepConditionEncode()/stepConditionMet()/stepConditionLabel()) --
    0 = toujours (defaut, comportement d'origine), "K:N" style Elektron
    (1:2, 2:4...) evalue contre un compteur de passages du pattern,
    FILL/!FILL contre un etat global pilotable par FILL:.
    - Teensy (src_teensy/az2_audio/main.cpp) : SequencerTrack::stepProb/
    stepCondition (defauts 100/0 = comportem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
2026-09-17 teensy: graine random() au boot pour PROB:
    randomSeed(micros()) dans setup() -- evite de rejouer exactement le
    meme motif "aleatoire" a chaque mise sous tension (random() non
    seede reproduit sinon la meme sequence). Pas une vraie source
    d'entropie, suffisant pour une probabilite de declenchement de pas.
    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
2026-09-17 teensy: BTN D pilote fillActive directement (maintenir = fill)
    D etait libre ("usage futur") -- la croix+A-D est cablee directement
    sur le Teensy, donc plus simple/plus reactif de piloter fillActive
    depuis updateDigitalControls() que via un aller-retour serie par
    l'ESP32. FILL:0/1 reste disponible en plus (ESP32/futur bouton dedie).
    N'interfere pas avec le relais BTN:D existant (page JEUX ne mappe que
    A/B cote ESP32).
    Rend PROB:/COND: (commit precedent) jouable en performance des demain,
    sans avoir besoin de flasher/verifier une UI ecran dediee au FILL.
    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
    [main.cpp]
2026-09-17 esp32: corrige le commentaire perime de seqDetailCol
    Referencait "kSeqDetailColNames", une constante qui n'existe pas (et
    n'a jamais existe dans ce fichier) -- trouve en repassant sur le code
    du tracker apres l'ajout de PROB/COND. Remplace par la liste a jour
    des 6 colonnes et un pointeur vers detailColX()/drawDetailRow().
    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
    [main.cpp]
2026-09-17 docs: licence Synth_Braids resolue -- MIT, verifie dans le vendoring
    Point ouvert laisse dans AZ2_LICENCES.md le 2026-09-17 matin ("licence
    non fournie dans ce vendoring"). Verification faite en lisant les
    entetes des fichiers vendored eux-memes (pas juste un fichier LICENSE a
    la racine du dossier, qui n'existe pas ici) : chaque fichier du coeur
    DSP (macro_oscillator, digital/analog_oscillator, resources, settings,
    dsp, stmlib, svf, random, excitation, parameter_interpolation) porte
    l'entete MIT original de Mutable Instruments (Emilie/Olivier Gillet,
    2012-2013), murmurhash3.h est domaine public. Le README.md du wrapper
    Teensy confirme la meme origine (github.com/pichenettes/eurorack,
    MIT). P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
2026-09-17 teensy: SD.remove() avant open() dans gbRecStart()
    Bug reel note lors de l'audit du 2026-09-17 matin, deprioritise (jauge
    "effectivement inatteignable en pratique"), corrige ce soir : dans le
    cas improbable ou les 999 noms SAMPLE_NNN.wav sont deja pris,
    nextSampleName() renvoie SAMPLE_999.wav en sachant qu'il existe deja.
    FILE_WRITE sur SdFat ouvre en AJOUT sur un fichier existant (pas en
    ecrasement) -- sans ce remove(), la nouvelle capture se serait ajoutee
    APRES l'ancien contenu au lieu de le remplacer (wav corrompu/demesure).
    Meme convention que savePatchSlot()/saveProject(), qui font deja ce
    remove(). Aucun effet sur le cas normal (remove() sur un fichier
    inexistant est un no-op). Compil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
    [main.cpp]
2026-09-17 esp32: commentaires du tracker mis a jour avec PROB/COND
    Restants qui enumeraient encore NOTE/INST/FX/VAL sans les 2 colonnes
    ajoutees le 2026-09-17 (kSeqRightEdge, seqDetailMode, section vue
    tracker, drawTrkTrackRow, commentaire croix/edition). Cosmetique
    uniquement, aucun changement de comportement.
    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
2026-09-17 tests: premiers tests unitaires automatises (env:native)
    Ajoute env:native (platform=native, ArduinoFake+Unity) et
    test/test_protocol/test_main.cpp : 9 tests sur la logique PURE de
    lib/AZ2_Protocol/AZ2_Protocol.h (encodage/decodage des conditions
    PROB:/COND: ajoutees ce soir, tables division/moteur/pad) -- tournent
    sur cette machine via `pio test -e native`, verifiees directement (pas
    seulement compilees) pour la premiere fois sur ce depot.
    Reponse au point de l'audit du 2026-09-17 ("Tests et integration
    continue : absents pour AZ-2, risque eleve"). Ne remplace pas une
    verification sur materiel reel (rien ici ne touche a l'audio/l'ecran),
    mais couvre la logique de calcul independante du har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
2026-09-17 docs: AZ2_TRACKER_ETUDE.md -- probabilite/chance marquee FAIT
    L'etude du 2026-09-15 avait explicitement anticipe cette fonction
    ("facile a ajouter plus tard, pure RNG au moment du declenchement,
    independant du reste") en l'ecartant de la v1. Boucle la ce soir :
    PROB:/COND:/FILL: (voir AZ2_ETAT_DES_LIEUX.md) correspond exactement a
    cette description, etendue avec des conditions style Elektron.
    (CI toujours preparee en local mais pas poussee -- scope OAuth
    "workflow" toujours en attente.)
    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
2026-09-18 teensy+esp32: deplace FILL vers l'ecran SEQUENCEUR (corrige une collision)
    BTN D a deja 2 sens existants selon l'ecran ESP32 affiche (page AUDIO :
    bascule clavier live/edition-pas ; page MOTEURS : bascule SOLO piste).
    Le cablage direct cote Teensy d'hier soir (updateDigitalControls())
    lisait D SANS savoir quel ecran est affiche -- tenir D pour basculer
    solo/edition sur une autre page activait donc "fill" en arriere-plan
    (silencieux tant qu'aucun pas n'a de condition FILL, mais un vrai
    piege des qu'on en programme un).
    Retire la lecture directe cote Teensy. Cable a la place cote ESP32
    (handleTeensyLine(), echo BTN:) : FILL:1 envoye sur BTN:D:DOWN
    SEULEMENT si currentScreen == Screen::Sequenc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
    [main.cpp]
2026-09-18 docs: Teensy flashe et verifie en reel (swing max, PROB/COND/FILL, erreurs)
    Premier flash reel de la session -- boot propre (SD/PSRAM/sequenceur
    OK), teste en serie (pyserial) : PROB:/COND:/FILL: acceptees et
    relayees, commandes hors bornes rejetees avec ERROR (premiere
    verification en reel du retour d'erreur protocole ajoute hier), pattern
    joue proprement a SWING:127 (nouveau maximum) sans pas manquant, CPU
    11.6%/memoire 133/141 blocs -- sain.
    Les 3 derniers points de l'audit du 2026-09-17 sont maintenant
    confirmes en reel, pas seulement compiles.
    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
2026-09-18 docs: ESP32 flashe, liaison serie confirmee, souffle audio signale
    Boot propre (DISPLAY:READY sur le vrai ecran VIEWE, tactile, SD ESP32),
    liaison serie ESP32<->Teensy confirmee en reel (tous les echos Teensy
    recus cote ESP32).
    Souffle audio signale par l'utilisateur, present meme en silence total
    -- correspond exactement au symptome deja documente dans
    AZ2_DAC_PCM5102A.md pour SCK flottant sur le PCM5102A. Cause probable :
    manipulation du Teensy pour le flasher. A verifier au multimetre
    (continuite SCK-GND), pas un bug de code.
    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
2026-09-18 esp32: navigation entre pas au D-pad (C maintenu + HAUT/BAS)
    Bug reel trouve en testant sur le vrai materiel ce matin (retour
    utilisateur : "avec la croix je peux pas descendre dans la fenetre" et
    "c'est trop petit pour le tactile, il faut que ca marche au
    joystick") : rien ne deplacait selectedSeqStep sauf un tap tactile
    direct sur une ligne -- impossible de changer de pas au D-pad seul,
    HAUT/BAS etaient entierement pris par l'edition de valeur.
    Fix : C maintenu (libre sur l'ecran SEQUENCEUR) + HAUT/BAS deplace le
    pas selectionne au lieu d'editer la valeur de la colonne. Sans C,
    HAUT/BAS continue d'editer comme avant. Redessine l'ancienne et la
    nouvelle ligne selectionnee.
    Flashe et verif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
    [main.cpp]
2026-09-18 esp32: modificateur A (pas C) + note allume le pas + journal diagnostic
    - Modificateur d'edition tracker bascule de C a A : plusieurs captures
    serie sur le vrai materiel montrent BTN:A:DOWN/UP a chaque appui,
    mais aucun BTN:C:* n'est jamais arrive malgre plusieurs essais
    utilisateur -- bouton C probablement pas fonctionnel sur ce montage.
    - Roles HAUT/BAS inverses suite au retour utilisateur sur materiel reel
    ("faut un bouton pour changer les valeurs et descendre avec les
    fleches") : HAUT/BAS SEULS deplacent le pas selectionne par defaut,
    A maintenu + HAUT/BAS edite la valeur.
    - Bug reel corrige : la colonne NOTE n'affichait jamais rien tant que
    le pas etait OFF (drawDetailRow(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
    [main.cpp]
2026-09-18 teensy: HEAP? diagnostic (mallinfo) + journal du diagnostic DEXED
    Ajoute checkHeap()/HEAP? (mallinfo()) pour verifier une piste sur le
    souffle DEXED : Dexed::Dexed() alloue chaque voix (Dx7Note, ~692
    octets) via `new` sans aucune verification d'echec -- AZ-2 cree 9
    instances completes de Dexed (8 pistes + liveVoice), plus gourmand que
    l'architecture MicroDexed-touch d'origine.
    Mesure sur le vrai materiel : used=34800:free_in_arena=1616:arena=36416
    -- tas serre (1.6 Ko de marge), un vrai point a corriger, mais
    probablement pas LA cause du bruit (une allocation ratee casserait tout
    de suite, pas "silence au repos, bruit seulement en jouant une note,
    jusqu'a redemarrage" -- ce pattern ressembl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
    [main.cpp]
2026-09-18 docs: note la demande UI/UX patch+effets par piste+arpegiateur
    Retour utilisateur en testant le tracker sur le vrai materiel : le
    panneau lateral "patch actif" juge inutilisable. Demande precise
    documentee (navigation par bouton comme les colonnes du tracker, 2
    raccourcis PATCH/EFFETS empiles ouvrant des fenetres dediees, effets
    PAR PISTE a concevoir cote Teensy, page AUDIO plein ecran avec
    selecteur de gamme + arpegiateur complet).
    Gros chantier, pas commence cette session (UI + nouvelle architecture
    d'effets par piste + fonctionnalite musicale complete) -- documente
    pour une session dediee future.
    Claude-Session: https://claude.ai/c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
2026-09-18 esp32: temoin de volume (toast) + navigation croix page PATCH
    - drawPotToast() : fine bande en haut de l'ecran, visible sur N'IMPORTE
    QUELLE page, qui s'allume proportionnellement a la valeur d'un potard
    et s'efface seule apres 1.5s (relance un rendu complet de la page
    courante plutot que de retenir ce qu'il y avait dessous). Repond au
    retour utilisateur : "quand on bouge le volume on a pas de jauge qui
    apparait, il faut que ca apparaisse en haut ou bas qu'on sache ou on
    en est". drawPotBar() existant (page CONTROLES uniquement) inchange,
    ce toast est un second affichage independant.
    - Page PATCH : meme convention croix que le tracker (seqDetailCol) --
    GAUCHE/DROITE changent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
2026-09-18 docs: spec complete moteurs/patch/effets/tracker donnee par l'utilisateur
    Precise le chantier UI deja note : page MOTEURS en vraie liste
    attribuable par piste, page PATCH gere patchs de tous les moteurs
    (selection/reglage/sauvegarde -- sauvegarde deja codee cote tactile,
    juste pas au bouton), nouvel outil EFFET par piste (architecture a
    creer cote Teensy), les 2 fenetres PATCH/EFFET appelables depuis le
    panneau tracker. Note aussi que le choix moteur + patch integre ne
    rentre pas dans la mise en page actuelle de la page PATCH (6 lignes +
    volume + slot remplissent deja l'ecran) -- confirme le besoin d'un
    vrai redesign, pas un ajustement ponctuel.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
2026-09-18 teensy: DEXED n'est plus le moteur par defaut d'aucune piste
    Retour utilisateur : "PLAY/STOP marche pas, ca met en route le DEXED,
    faut reparer ce truc que ca sonne plutot que ca fasse du bruit" -- en
    realite PLAY/STOP fonctionnent (confirme plus tot cette session), le
    vrai souci est que DEXED (casse, voir le diagnostic dans
    AZ2_ETAT_DES_LIEUX.md) demarrait par defaut sur les pistes 0/1/4/5,
    donc appuyer sur PLAY sans rien changer jouait directement le moteur
    casse.
    trackEngine[] par defaut : DEXED -> ANALOG sur 0/1/4/5 (seul moteur
    confirme propre a l'oreille sur ce materiel). EPIANO/BRAIDS inchanges
    sur 2/3/6/7. DEXED reste selectionnable a la main via ENGINE: pour
    continuer a le tester/l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
2026-09-18 docs: corrige une fausse alerte sur SCOPE: (erreur de methode de test)
    Le "bug scope" note plus tot cette session etait une erreur de ma part,
    pas un bug firmware : je capturais /dev/ttyACM0 (port USB du Teensy,
    Serial) en cherchant les paquets binaires du scope, mais
    updateScope() les ecrit sur Serial1 (liaison UART dediee vers l'ESP32),
    jamais visible sur le port USB. Rien ne prouve que le scope soit casse
    -- je n'ai simplement jamais pu l'observer avec les outils disponibles
    (pas d'acces direct a la liaison UART Teensy<->ESP32). A verifier
    plutot en regardant l'ecran (page PATCH doit afficher une forme d'onde
    en jouant une note), pas cote serie.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
2026-09-18 esp32: navigation croix sur la ligne SLOT (save/load) page PATCH
    Ajoute la ligne SLOT/SAVE/LOAD au meme systeme de croix que le reste de
    la page PATCH -- existait deja a l'ecran (tactile uniquement), pas de
    redesign necessaire pour l'ajouter (contrairement au choix moteur/
    patch integre, notes separement comme ne rentrant pas dans la mise en
    page actuelle). A maintenu + HAUT/BAS cycle le numero de slot ; A
    maintenu + GAUCHE/DROITE declenche SAVE/LOAD (nouvelle combinaison,
    GAUCHE/DROITE seuls restent le changement de piste comme avant).
    Compile verifie sur les 3 environnements. PAS flashe/teste sur le vrai
    materiel -- ESP32 debranche (utilisateur parti au travail), a confirmer
    au prochain r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
    [main.cpp]
2026-09-18 docs: ajoute l'audit de progression du 18 septembre 2026
2026-09-18 build: rend les dependances Teensy reproductibles
2026-09-18 perf: accelere le rendu GB et corrige sa cadence
    [main.cpp]
2026-09-18 fix: teste le coeur MSFA pour stabiliser Dexed
    [main.cpp]
2026-09-18 docs: definit l architecture multi-moteurs et le sampler
2026-09-18 docs: concevoir le flash des modules moteurs depuis AZ-2
2026-09-18 docs: lier le plan de flash des modules
2026-09-18 docs: préciser la paire UART candidate du slot moteur
2026-09-18 docs: concevoir le premier moteur ESP32 AZ-VA1
2026-09-18 docs: lier le moteur ESP32 AZ-VA1
2026-09-18 docs: definir la cible emulation GB GBC complete
2026-09-18 docs: concevoir la cartouche ESP8266 AZ-CHIP
2026-09-18 docs: lier la cartouche ESP8266 AZ-CHIP
2026-09-18 docs: ajouter le flash des cartouches ESP8266
2026-09-18 docs: réserver le flash de modules à AZ-3
2026-09-18 docs: figer AZ-2 et reporter les cartouches à AZ-3
2026-09-18 docs: limiter l’émulation AZ-2 au matériel existant
2026-09-18 merge+docs: fusionne 26 commits d'une autre session IA, hypothese MSFA testee et ecartee
    Fusion sans conflit (fast-forward) de 26 commits pousses sur main
    pendant l'absence de l'utilisateur : audit de progression, fix
    reproductibilite (lib MIDI morte), perf/cadence GB (rendu PSRAM +
    pacing microseconde), CI (ci.yml, reutilise pio test -e native),
    hypothese MSFA sur DEXED, et une exploration "AZ-3" auto-retractee en
    fin de parcours.
    Teste sur le vrai materiel au retour de l'utilisateur : basculer
    DEXED du coeur FM MKI (defaut du constructeur, jamais change) vers
    MSFA (coeur de reference historique) NE REGLE PAS le bruit -- toujours
    souffle/bruit blanc en isolation. Piste ecartee, documentee.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
2026-09-18 gb: annule le rendu 1-bloc (scintillement), monte l'UART a 921600
    - gbBlitLine() : annule le rendu "1 bloc PSRAM entier envoye a la fin
    de l'image" fusionne plus tot le meme jour (autre session IA, jamais
    teste sur le vrai materiel) -- causait un scintillement continu
    confirme par l'utilisateur. Revenu au rendu par bandes du
    2026-09-15 (1 draw16bitRGBBitmap() par ligne source), confirme
    "beaucoup mieux" sur le vrai materiel. Retire l'include
    esp_heap_caps.h devenu inutilise.
    - kControlBaud (AZ2_Protocol.h) : 230400 -> 921600, prerequis du
    "Palier A" (AZ2_EMULATION_JEUX.md) pour ameliorer la qualite audio
    du jeu. Teste et confirme sur le vrai materiel : round-trip complet
    sa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
    [main.cpp]
2026-09-18 audio: enveloppe partagee sur les 5 moteurs + hausse debit GB (921600/14000Hz)
    - trackAnalogEnv[] devient un gate ADSR partage par tous les moteurs
    (avant: reserve a ANALOG). N'a PAS resolu le bruit blanc sur
    DEXED/EPIANO/BRAIDS/KARPLUS mais garde comme amelioration en soi
    (gating propre au lieu d'un simple mute).
    - kControlBaud 230400->921600, kGbAudioSampleRate 8000->14000Hz
    (plafond ~15200Hz documente, lie au champ de longueur 1 octet du
    paquet audio GB -- protocole V2 necessaire pour aller plus haut).
    - docs/AZ2_ETAT_DES_LIEUX.md: journal honnete de l'investigation
    bruit blanc (MUTE/FILT, hypothese enveloppe partagee ecartee,
    piste scope-dump testee puis retiree -- bug de t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
    [main.cpp]
2026-09-18 protocole: corrige la desynchronisation des paquets binaires SCOPE/audio-GB
    Cause du bug de transmission SCOPE trouve et retire hier soir (dump
    chaotique meme pour un moteur confirme propre) : aucune verification de
    longueur/checksum dans le parseur binaire mele au flux texte -- un octet
    perdu decale la lecture 'longueur' sur un octet de charge utile
    quelconque, qui peut a son tour valoir par hasard l'octet magique et
    relancer un faux paquet -- desynchronisation qui s'auto-entretient.
    Aggrave par (1) drawPatchScope() appele SYNCHRONE depuis la boucle de
    lecture Serial1 (bloque la lecture, favorise la perte d'octets) et (2)
    tampon RX materiel laisse par defaut alors que le lien tourne a 92160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
    [main.cpp]
2026-09-18 audio: resout le bruit blanc des 5 moteurs -- filtre par defaut instable a 18kHz
    Cause reelle trouvee sur le vrai materiel (piste 0 isolee, meme note,
    5 moteurs testes un par un) : le defaut au boot ET le plafond de
    FILT: etaient a 18000Hz -- AudioFilterStateVariable (Chamberlin SVF,
    lib Audio Teensy) devient instable/auto-oscillant pres de cette
    frequence meme a resonance minimale. Reproductible identiquement sur
    DEXED/EPIANO/BRAIDS/KARPLUS/ANALOG (tous testes bruit blanc a 18kHz,
    tous confirmes propres a 8-15kHz). Ce n'etait donc PAS un bug par
    moteur -- aucune bibliotheque de synthese en cause -- mais un reglage
    de filtre partage, commun a toutes les pistes.
    Corrige : plafond handleFiltC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
    [main.cpp]
2026-09-18 test: outil SIMNAV/SIMBTN + fiabilisation du fix filtre + suite tracker/PATCH validee
    - SIMNAV:<dir>:<0|1> / SIMBTN:<lettre>:<0|1> sur le port USB du Teensy :
    injectent un evenement croix/bouton exactement comme un vrai appui
    physique (meme printNav()/printBtn() vers Serial1). Permet de piloter
    et tester le tracker par script, sans acces au clavier physique --
    garde en permanence, outil de test a cout nul.
    - Fix filtre (commit precedent, 18kHz->15kHz) reteste a resonance
    maximale (127/127) en plus de resonance minimale : toujours propre,
    confirme sur le vrai materiel.
    - Suite de test complete executee et REUSSIE sur le vrai materiel via
    SIMNAV/SIMBTN, verifiee en lisant les com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
    [main.cpp]
2026-09-18 docs: confirme les 5 moteurs propres avec leur patch par defaut sur le vrai materiel
    DEXED/EPIANO/BRAIDS/KARPLUS/ANALOG testes avec leur vrai patch (pas
    juste une onde brute), piste isolee, meme note -- tous confirmes
    propres par l'utilisateur. Objectif du 2026-09-18 ('on fait sonner
    proprement tout les moteur audio un par un') atteint.
    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
2026-09-18 diag: HEAPTEST -- infirme la fausse alerte 'tas critique', mesure CPU/memoire a 8 voix
    Charge reelle mesuree (8 pistes, 5 moteurs, simultanement) : CPU
    7.1% (pic 11.2%), memoire audio 125-139/200 blocs -- grosse marge sur
    les deux. Le 'tas a 1.6 Ko libres' note plus haut ce soir (avant de
    trouver la vraie cause du bruit, le filtre) est une fausse alerte :
    l'arene newlib grandit via _sbrk() jusqu'a _heap_end (~454 Ko de RAM2
    libres, voir le rapport du linker), ce n'est pas un plafond a 36 Ko.
    Verifie empiriquement avec la nouvelle commande HEAPTEST:<Ko> (gardee,
    outil de diagnostic a cout nul) : 300 Ko alloues/ecrits/relus/liberes
    sans probleme, arene montee a 347712 o puis redescendue a 3641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
    [main.cpp]
2026-09-18 protocole: DXR/EXP/BXP -- editeur de patch complet cote firmware (DEXED/EPIANO/BRAIDS)
    Demande : 'un editeur de patch complet et completement reglable ...
    sovegardable'. Inventaire des vrais parametres exposes par chaque
    bibliotheque (voir AZ2_ETAT_DES_LIEUX.md) :
    - DXR:<piste>:<octet brut 0-144>:<valeur> / DXR?<piste>:<octet> --
    acces direct a n'importe quel octet du buffer de voix DX7 deballe
    (Dexed::set/getVoiceDataElement(), voir dexed.h) : les 6 operateurs
    (21 octets chacun) + 19 parametres globaux, avec une table de bornes
    par index (dxpParamMax()) reprise des vraies plages DX7. DXP:
    (algo/feedback seuls) inchange, ne casse rien cote UI existante.
    Le nom (10 car. ASCII) re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
2026-09-18 ui: editeur de patch complet a defilement pour DEXED/EPIANO/BRAIDS (page PATCH)
    Cote ecran du chantier 'un editeur de patch complet et completement
    reglable ... sovegardable' (protocole DXR:/EXP:/BXP: deja commis cote
    firmware). La page PATCH etait deja pleine (8 lignes fixes, zero place
    libre) -- demande a l'utilisateur, choix : liste a defilement dans la
    MEME page plutot qu'un nouvel ecran.
    - patchExtraCount()/patchVolRow()/patchSlotRow()/patchTotalRows() :
    VOLUME/SLOT ne sont plus fixes aux lignes 6/7, decales dynamiquement
    apres les lignes extra du moteur affiche (0 pour KARPLUS/ANALOG,
    2 pour BRAIDS, 12 pour EPIANO, 17 pour DEXED).
    - Fenetre de 8 lignes visibles (meme disposition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
    [main.cpp]
2026-09-18 audio: 6e moteur SAMPLER -- premier son embarque (Kick/Snare), teste sur le vrai materiel
    Demande : 'on va mettre en route le sampleur ... recuperer un max de
    patch pour tout les moteur'.
    - az2::kEngineSampler (6e moteur, AZ2_Protocol.h) -- lecture PCM 16
    bits mono avec suivi de note (resampling lineaire, un coup, pas de
    bouclage). Nouvelle classe AudioPlaySampler
    (src_teensy/az2_audio/az2_sampler.h).
    - 2 patches de depart (Kick, Snare) -- deja vendores dans le repo avec
    MicroDexed-touch (addon/SD/CUSTOM/*.wav, meme licence GPLv3),
    convertis en tableaux PCM embarques en flash
    (az2_sampler_data.h) -- pas de chargement SD pour l'instant, voir
    docs/AZ2_SAMPLEUR.md pour le plan co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
2026-09-18 audio: DEXED passe de 8 a 255 vrais patches d'usine DX7 (ROM1-ROM4)
    Demande : 'recuperer un max de patch pour tout les moteur'. Trouvaille :
    banks.h (deja vendored avec Synth_Dexed) contient 320 vrais patches DX7,
    dont les 8 vraies banques ROM d'usine du Yamaha DX7 original (256
    patches, les presets les plus connus du DX7) -- jamais exploite avant
    ce soir, seuls 8 patches choisis a la main etaient utilises.
    - 255 des 256 patches ROM extraits (noms pris du sysex lui-meme) vers
    az2_dexed_bank_data.h. 255 et PAS 256 : 0xFF/255 est deja le sentinel
    'pas d'override de patch par pas' (stepPatch/seqStepPatch) -- un
    vrai patch DEXED 255 aurait ete indiscernable de ce sentinel, le
    dernier pa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
    [az2_dexed_bank_data.h, main.cpp]
2026-09-19 audio: BRAIDS 8->43 formes, ANALOG 4->11 formes d'onde (recuperer un max de patch)
    Suite de la demande 'recuperer un max de patch pour tout les moteur'
    (DEXED fait dans le commit precedent) :
    - BRAIDS : 43 des 43 algorithmes utilisables de Synth_Braids (pas 8
    choisis a la main) -- MacroOscillatorShape referencees par leur vrai
    nom d'enum (MACRO_OSC_SHAPE_*), pas une valeur numerique comptee a
    la main (l'enum a des trous du aux formes commentees dans la lib
    elle-meme).
    - ANALOG : 11 formes d'onde AudioSynthWaveform (pas 4) -- Pulse, Dent
    inversee, Sample & Hold, Triangle variable, + versions bandlimited
    (anti-repliement) de dent de scie/carre/pulse.
    - EPIANO verifie : seulement 5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
2026-09-19 ui: bouton MOTEUR dans le panneau lateral du tracker (raccourci vers la page MOTEURS)
    Demande : 'une fenetre de reglage pour chaque moteur pour les
    attribuer a une piste regler les patch effet'. Le panneau lateral du
    tracker avait deja AGRANDIR (-> page PATCH complete, filtre/ADSR/DXR/
    EXP/BXP). Ajoute MOTEUR (-> page MOTEURS, changement de moteur) juste
    au-dessus, meme piste presente dans le tracker directement -- avant ca
    il fallait quitter le tracker et passer par le menu. Les effets (SFX
    ARP/CUT/RET) restent dans la colonne FX du tracker lui-meme (effets
    PAR PAS, pas par piste -- pas de fenetre dediee pertinente pour eux).
    Limite honnete : bouton purement tactile, mon outil de test habi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
2026-09-19 ui+audio: corrige le bug du cadre efface dans le tracker, metronome, panneau lateral repense
    Bug reel trouve sur materiel reel ('les lignes disparaissent a mesure
    que j'edite ... ca efface le cadre') : drawDetailRow() effacait toute
    la largeur jusqu'a kSeqRightEdge (bord de l'ECRAN) au lieu du bord
    reel de la grille -- recouvrait le panneau lateral a chaque pas edite.
    Nouvelle constante kDetailGridRight (somme exacte des 7 colonnes),
    meme correctif applique a hitTestDetailRow(). Confirme corrige par
    l'utilisateur.
    Metronome : 6e canal mixFinal (libre jusqu'ici), clic sinus court
    declenche depuis advanceTick() a chaque debut de temps, accentue sur
    le premier temps du pattern. METRO:<0|1>. Te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
    [main.cpp]
2026-09-19 ui: reorganise la page MOTEURS -- liste moteurs + liste patches + mini-reglages
    Demande explicite : 'une liste de moteur a gauche et a chaque moteur
    selectionne ca met les patch a droite et en dessous la mini fenetre
    de reglage du patch si on clic dessus on arrive a la page de reglage
    de patch'.
    Remplace l'ancienne page (8 lignes par piste, moteur/patch cote a
    cote) par : selecteur de piste en haut, liste des 6 moteurs a gauche,
    liste defilante des patches du moteur assigne a droite (jusqu'a 255
    pour DEXED, meme principe de fenetre que la page PATCH), bandeau
    mini-reglages tactile en bas qui ouvre la page PATCH complete.
    Selectionner une ligne (croix ou tactile) assigne immediatement, meme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
2026-09-19 docs: link latest audit and refresh current capabilities
2026-09-19 docs: accurately describe sampler integration
2026-09-19 ui: navigation MOTEURS sans modificateur A, bouton retour deplace sur C (un seul etage)
    Suite au retour 'on est un peu dans le desordre de controle' :
    GAUCHE/DROITE bascule toujours le focus entre liste MOTEUR et liste
    PATCH (plus besoin de A) ; HAUT depuis le premier element d'une liste
    fait passer le focus sur la ligne PISTE (au lieu de boucler) ou
    GAUCHE/DROITE change alors la piste ; contour blanc indique la ligne
    au focus.
    Bouton retour deplace de B a C partout (sauf en pleine partie GB, deja
    C) -- confirme fonctionnel sur le vrai materiel. Nouvelle variable
    navPrevious (un seul ecran memorise, mise a jour dans goTo() a chaque
    changement de page) : le retour va desormais d'UN SEUL ETAG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
2026-09-19 fix: 3 defauts P1 de l'audit de code -- INST 0xFF, sauvegardes atomiques, autosave GB
    Suite de docs/AZ2_AUDIT_CODE_2026-09-19.md :
    - loadProject() sautait l'envoi de INST: quand vals[5]==0xFF (='pas
    d'override'), laissant un ancien override en place dans le Teensy si
    la memoire courante en avait deja un. Corrige : INST: est toujours
    envoye, y compris 255 (deja accepte cote Teensy).
    - Sauvegardes patch/projet/GB non atomiques (SD.remove() PUIS
    SD.open(FILE_WRITE) -- une coupure entre les deux detruisait la
    derniere sauvegarde valide). Nouvelle sequence tmp/bak/rename
    partout : atomicSaveFile() (main.cpp, template+lambda, patch/projet)
    et atomicSaveRaw() (gb_emulator.cpp, buffer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
    [gb_emulator.cpp, main.cpp]
2026-09-19 ui+audio: A ouvre PATCH depuis MOTEURS, surbrillance plus visible, bouton test note (TEST:)
    3 retours utilisateur :
    - Page MOTEURS : A ouvre la page PATCH complete quand le focus croix
    est sur la liste PATCH (meme action que le bandeau mini-reglages).
    - Surbrillance de la ligne au focus passee de 1px a 3px (rectangles
    imbriques) + nouveau cadre epais autour de TOUTE la liste (moteur ou
    patch) au focus, dessine par-dessus les lignes.
    - Page PATCH : barre TEENSY retiree (meme raisonnement que la page
    SEQUENCEUR) ; nouveau bouton B joue/coupe une note de test (MIDI 60)
    directement sur la piste affichee, hors sequenceur -- nouvelle
    commande Teensy TEST:<piste>:<note>:<0|1>, appelle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
2026-09-19 Page PATCH : navigation repensee pour "2 reglages par ligne"
    GAUCHE/DROITE parcourt desormais les reglages de la grille
    (patchStepLogical/patchStepVisual) au lieu de changer de piste --
    meme modele que la page MOTEURS (patchOnTrackRow miroir
    d'engOnTrackRow), la ligne PISTE a son propre focus atteint en
    montant depuis la 1ere ligne. Ligne SLOT : A+GAUCHE/DROITE reste
    SAVE/LOAD. Tactile simplifie a "tap = selectionne" (hitTestPatchParam
    remplace hitTestPatchRow, plus de +/- tactiles en demi-largeur).
    Bug latent trouve et corrige en reprenant ce chantier : les hitTest*()
    de la ligne SLOT visaient encore l'ancienne position figee (avant
    l'appariement 2-par-ligne), recalcule desormais via patch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
    [main.cpp]
2026-09-19 Page PATCH : A+GAUCHE/DROITE edite aussi la valeur (en plus de A+HAUT/BAS)
    Extrait la logique d'edition (VOLUME/SLOT/ligne fixe-ou-DXP/ligne
    EXTRA) dans patchApplyDelta(track, delta), reutilisee par A+HAUT/BAS
    ET A+GAUCHE/DROITE (DROITE/HAUT = +1). La ligne SLOT garde son cas
    particulier (A+GAUCHE/DROITE = SAVE/LOAD). GAUCHE/DROITE seul (sans A)
    continue de juste selectionner.
    Valide sur le vrai materiel via SIMNAV:/SIMBTN: (FILT: envoye et
    incremente/decremente correctement selon le sens de croix tenu avec A,
    aucune commande quand A n'est pas tenu).
    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
    [main.cpp]
2026-09-19 Effets dedies par piste (bitcrusher + delay courte), 12/16 pistes abandonne
    Reverb/delay COMPLETEMENT dediees par piste ne rentre pas en RAM1/DTCM
    (teste : 12x Freeverb seul depasse au link, 12x Delay seul passe a
    peine). Utilisateur confirme : garde 8 pistes, effets plus simples.
    Chaine par piste : trackFilter -> trackCrush (bitcrusher) -> {sec,
    trackDelay} -> trackFx (mixeur sec/mouille) -> mixeur de groupe.
    Nouvelles commandes CRUSH:<piste>:<bits> et DELAY:<piste>:<ms>:<mix>.
    Reverb reste globale (bus maitre, inchangee).
    Bug reel trouve+corrige : AudioMemory(200) beaucoup trop juste des
    qu'un delay est actif (197/200 avec UNE SEULE piste a 300ms) ->
    AudioMemory(700), reteste au pire cas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
    [main.cpp]
2026-09-19 docs: référencer l’audit émulation GB/GBC
2026-09-19 docs: fixer la cible émulation de référence
2026-09-19 feat: accélérer et fiabiliser l’émulation GB/GBC
    Active Walnut-CGB dualfetch, retire le frame-skip du mode normal, groupe le rendu écran, mesure la cadence native et fiabilise les sauvegardes. Ajoute l’étude comparative des cœurs et de l’APU.
    [gb_emulator.cpp, main.cpp]
2026-09-19 fix(gb): validate ROM paths and RAM; check save rename failures
    [gb_emulator.cpp]
2026-09-19 docs: redesign repository landing page and clarify dual-firmware status
2026-09-19 test: add shared firmware contract guard for GB audio and UART
2026-09-19 ci: verify GB UART contract before building both firmwares
2026-09-19 fix(gb): prevent unloading unsaved cartridge RAM on SD failure
    [gb_emulator.cpp]
2026-09-19 api(gb): expose unload failure to screen navigation
    [gb_emulator.h]
2026-09-19 fix(ui): block leaving Game Boy when SRAM save fails
    [main.cpp]
2026-09-19 ui(gb): show save failure and retry guidance without losing game
    [main.cpp]
2026-09-19 fix(gb): reject corrupt existing saves and stop truncating ROM filenames
    [gb_emulator.cpp]
2026-09-19 fix(gb): retain the only valid backup during SRAM recovery
    [gb_emulator.cpp]
2026-09-19 fix(gb): retain unambiguous ROM filenames up to safe SD path limit
    [gb_emulator.h]
2026-09-19 fix(audio): never overwrite samples when 999 WAV slots are occupied
    [main.cpp]
2026-09-19 fix(audio): detect short WAV writes and report incomplete captures
    [main.cpp]
2026-09-19 docs: track GB save recovery, ROM naming and safe WAV capture changes
2026-09-19 fix(audio): stop recording promptly on SD write failure
    [main.cpp]
2026-09-19 build(gb): guard ROM name and save-path capacities together
2026-09-19 feat(gb): add frame telemetry and verify SD temp writes with CRC
2026-09-19 fix(gb): stage ROM allocation and read before unloading active game
    [gb_emulator.cpp]
2026-09-19 docs: add contributor guide for coupled firmware development
2026-09-19 feat(audio): linear GB resampling and UART health counters
2026-09-19 docs(audio): update GB resampler and UART diagnostics status
2026-09-19 feat(gb): expand ROM browser capacity to 100 entries
2026-09-19 docs(gb): update ROM browser capacity and sorting status
2026-09-19 feat(proto): bounded GB audio V2 encoder and CRC-validating streaming decoder
2026-09-19 feat(gb): negotiated V2 PCM pilot encoder with automatic V1 fallback
2026-09-19 feat(gb): negotiate V2 only after Teensy READY and retain V1 default
2026-09-19 Page MIXER + encodeurs 1/2 contextuels + pistes 1-8 + SAUVER tracker
    - Nouvelle page MIXER : 8 barres de volume, GAUCHE/DROITE=piste,
    HAUT/BAS=volume, B=mute, D=solo.
    - Encodeurs 1/2 ne pilotent plus reverb/delay global en dur cote
    Teensy (seul l'encodeur 0/VOLUME garde un role fixe) -- l'ESP32
    decide desormais quoi en faire selon l'ecran affiche et renvoie la
    commande adaptee. Indicateur visuel (orange/cyan + libelle) cable
    sur MIXER et PATCH pour l'instant.
    - Bug reel trouve+corrige : mute MIXER etait sur A, qui venait de
    faire goTo(Mixer) dans le meme appui -> mutait la piste 0 par
    accident a l'entree. Deplace sur B.
    - Pistes affichees 1-8 partout (PATCH/MOTEURS/SEQUENCEUR/M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
    [main.cpp]
2026-09-19 Fusion travail GB + boutons MUTE/SOLO tactiles MIXER + audit navigation
    Fusionne origin/main (56 commits, autre session IA sur l'emulation GB,
    protocole audio V2) -- reverifie integralement apres fusion (compile
    propre x3, 14 tests natifs, reteste sur le vrai materiel).
    Ajoute 2 boutons tactiles MUTE/SOLO sur la page MIXER (factorise dans
    toggleMixerMuteSolo(), partage avec B/D physiques).
    Audit complet du systeme navPrevious/goTo() (demande "verifie toute
    les navigation qu'on saute pas des fenetres dans les retours") : un
    seul point de mutation de currentScreen, aucun appel double a goTo()
    dans le meme evenement -- rien de casse trouve.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
2026-09-19 Nouveau manuel d'utilisation (docs/AZ2_MANUEL_UTILISATEUR.md)
    30+ fichiers dans docs/, mais tous orientes ingenierie ou journal de
    session -- aucun ne couvre "comment jouer avec la machine". Nouveau
    guide langage musicien : conventions de controle, les 3 encodeurs,
    chaque page en detail, les 6 moteurs, sauvegarde patch/projet, premier
    beat pas-a-pas. Lie depuis le README (doc-table + navigation du haut).
    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
2026-09-19 feat(sampler): reserve dynamic GB Capture patch in shared protocol
2026-09-19 feat(sampler): support source sample rates for captured audio
2026-09-19 feat(sampler): load latest GB recording into PSRAM playable patch
2026-09-19 test(sampler): cover dynamic GB Capture patch contract
2026-09-19 docs(gb): record RTC, stereo V2 transport and GB Capture sampler progress
2026-09-19 docs(sampler): document playable GB Capture PSRAM slot
2026-09-19 docs: link FR EN ES guides from GitHub landing and correct feature status
2026-09-19 feat(ui): render Matrix, tracker note rain, eight-track rain and live tracker dashboard
2026-09-19 feat(ui): persist screensaver style and idle timeout in ESP32 NVS
2026-09-19 fix(saver): align eight lanes with track order and erase trail cells
    [main.cpp]
2026-09-19 Sampleur pad dedie (kit de batterie) + pads jouent l'instrument de la piste
    - Pads (page AUDIO) : nouveau track= optionnel sur PAD:, route vers
    trackNoteOn()/trackNoteOff() (vrai moteur/patch) au lieu de la voix
    live Dexed fixe -- actif quand ouvert depuis le bouton CLAVIER du
    tracker. Poser une note en mode padEditsStep fait maintenant aussi
    entendre le son (avant : silencieux).
    - Nouveau sampleur DEDIE aux 16 pads : 16x AudioPlaySampler + 16
    buffers PSRAM (2s/48kHz max, ~3 Mo sur les 16 Mo detectes), mixage a
    etages jusqu'a mixFinal (deja plein a 4/4). PADSAMPLE:<pad>:<chemin>
    assigne un WAV, priorite absolue sur un pad des qu'un echantillon y
    est charge.
    - 2 bugs reels tro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
    [main.cpp]
2026-09-20 feat: patch différé ISR, refactoring séquenceur, instrumentation charge et commande ISRLOAD?
